MatthiasOPage/Wavemaker/Media/Manual Media/20201031_114511.jpg

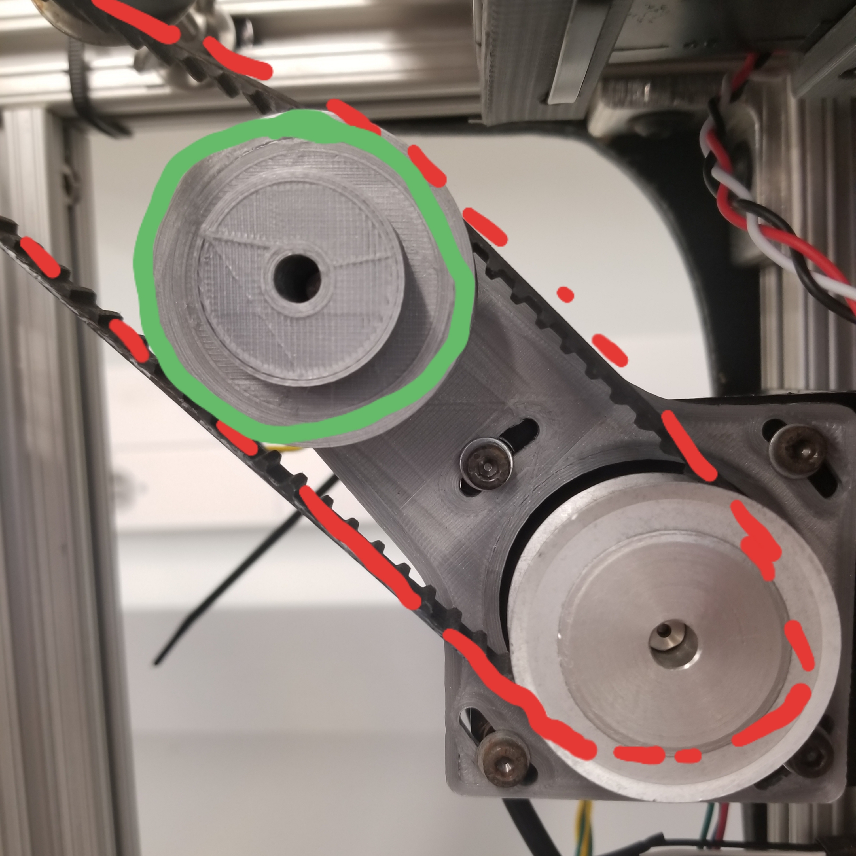
Media/Manual Media/20201031_114511.jpg
