MatthiasOPage/Wavemaker/Media/Manual Media/20201031_110601.jpg

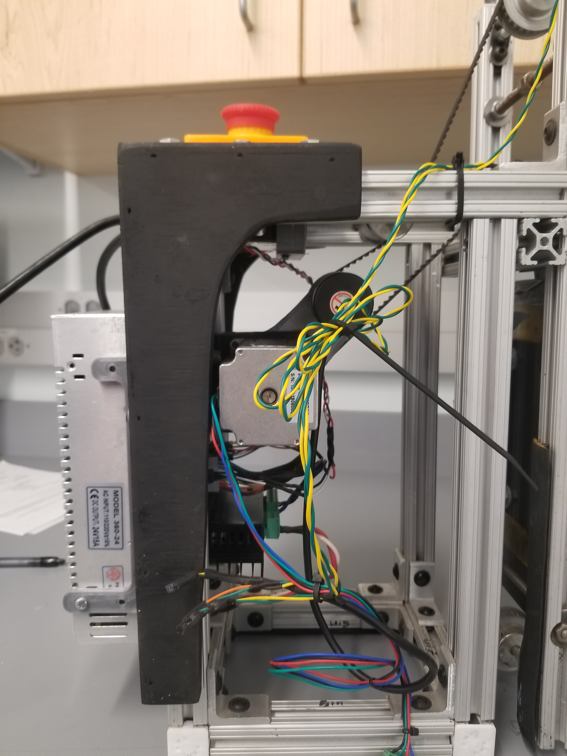
Media/Manual Media/20201031_110601.jpg
