MatthiasOPage/Wavemaker/README.txt

Folder home to all files used within the Wavemaker project.

Please direct questions and comments to: MatthiasOPage@gmail.com
