MatthiasOPage/Wavemaker/Media/Camera Gantry with Squash.png

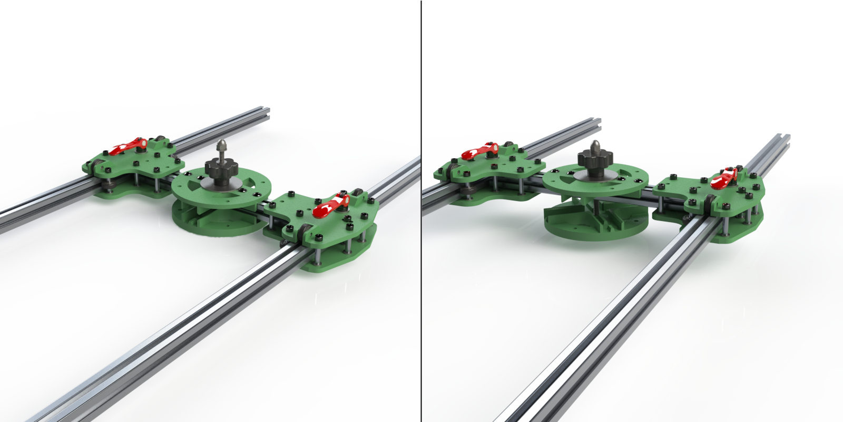
Media/Camera Gantry with Squash.png
