MatthiasOPage/Wavemaker/Media/Camera Gimbal/Camera_Gimbal_On_Frame.png

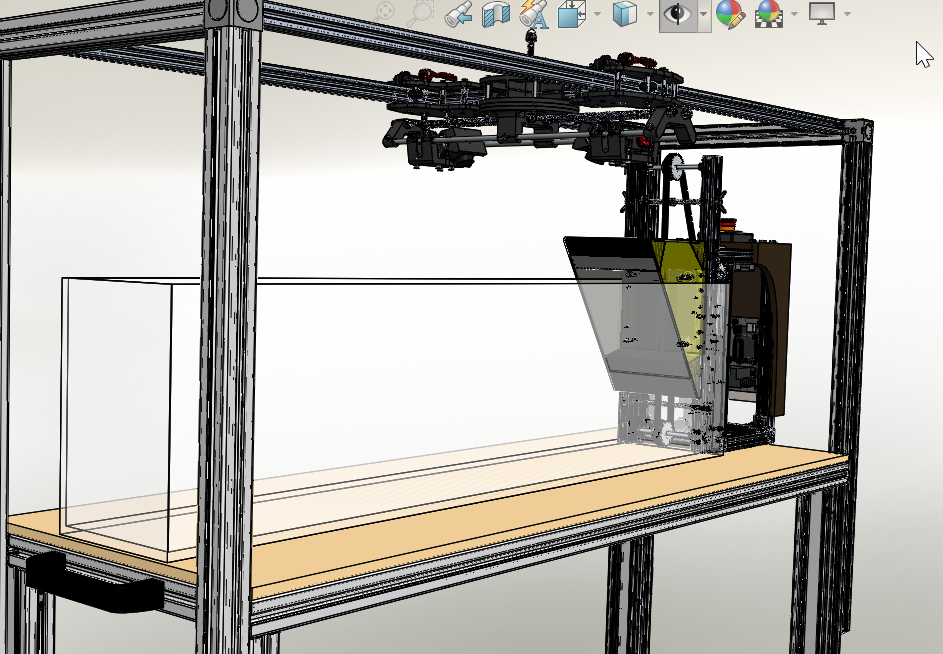
Media/Camera Gimbal/Camera_Gimbal_On_Frame.png
