MatthiasOPage/Wavemaker/Media/Camera Gimbal/Gimbal_Plain_M5.png

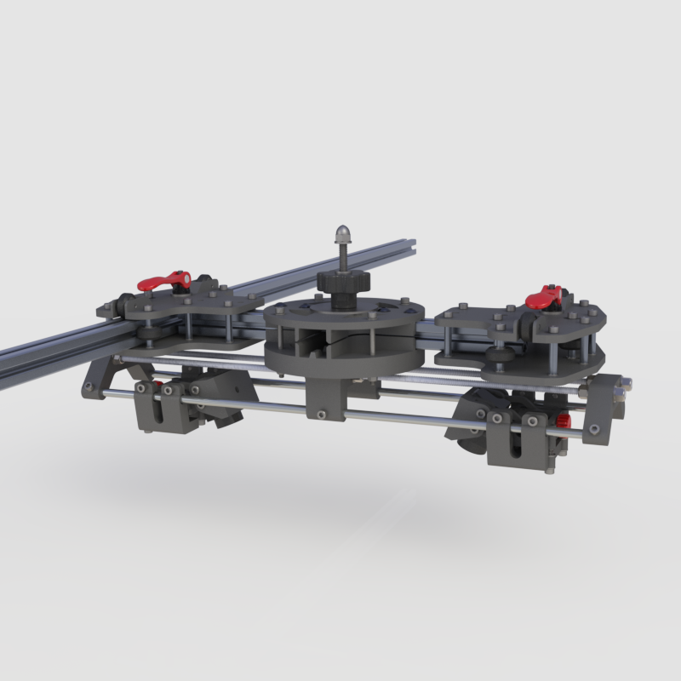
Media/Camera Gimbal/Gimbal_Plain_M5.png
