MatthiasOPage/Wavemaker/Media/Camera Gimbal/Z-Carriage_Preview1.png

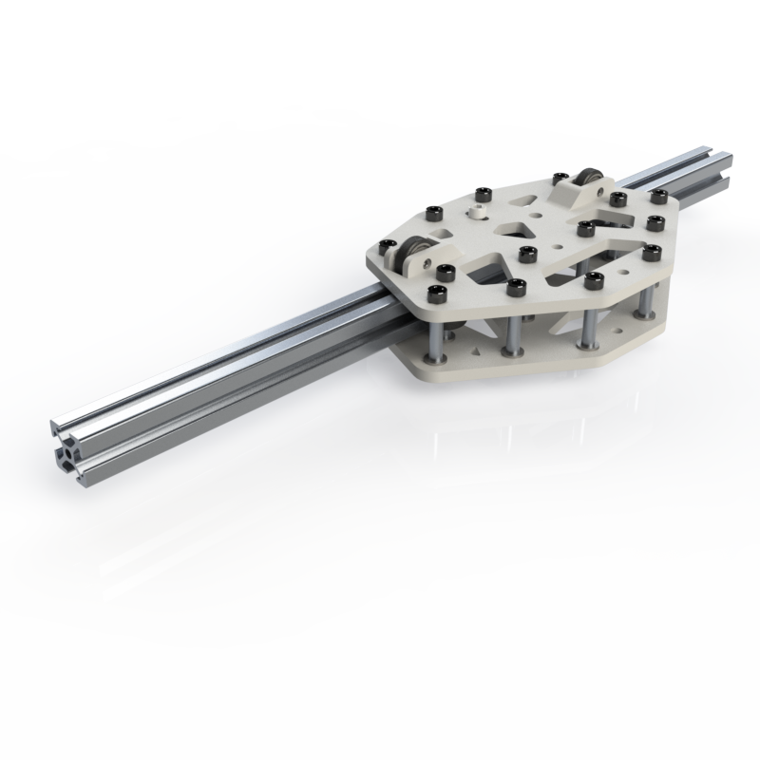
Media/Camera Gimbal/Z-Carriage_Preview1.png
