MatthiasOPage/Wavemaker/Media/Camera Gimbal/Z-Carriage_Preview3.png

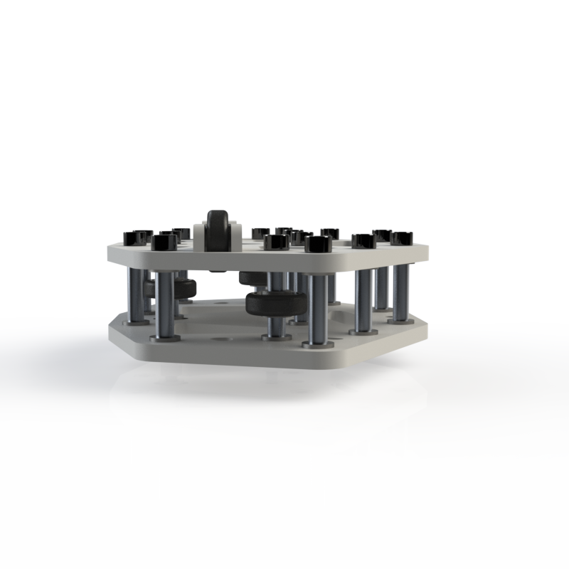
Media/Camera Gimbal/Z-Carriage_Preview3.png
