MatthiasOPage/Wavemaker/Media/Camera Gimbal/Z-Carriage_Preview4.png

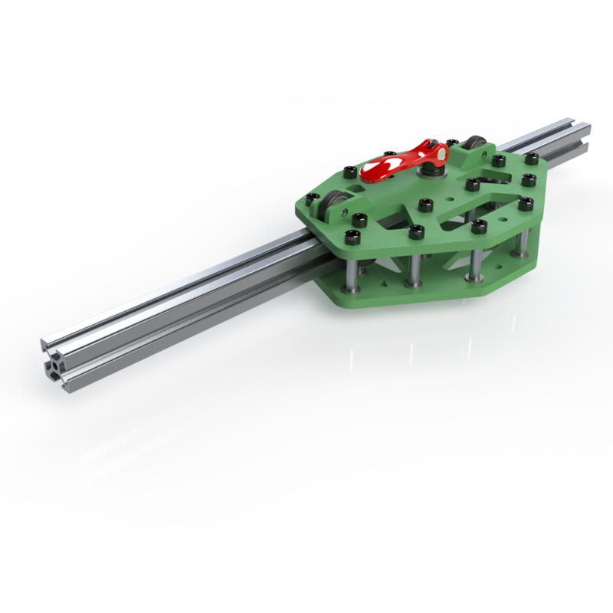
Media/Camera Gimbal/Z-Carriage_Preview4.png
