MatthiasOPage/Wavemaker/Media/Camera Gimbal/Z-Carriage_Preview5.png

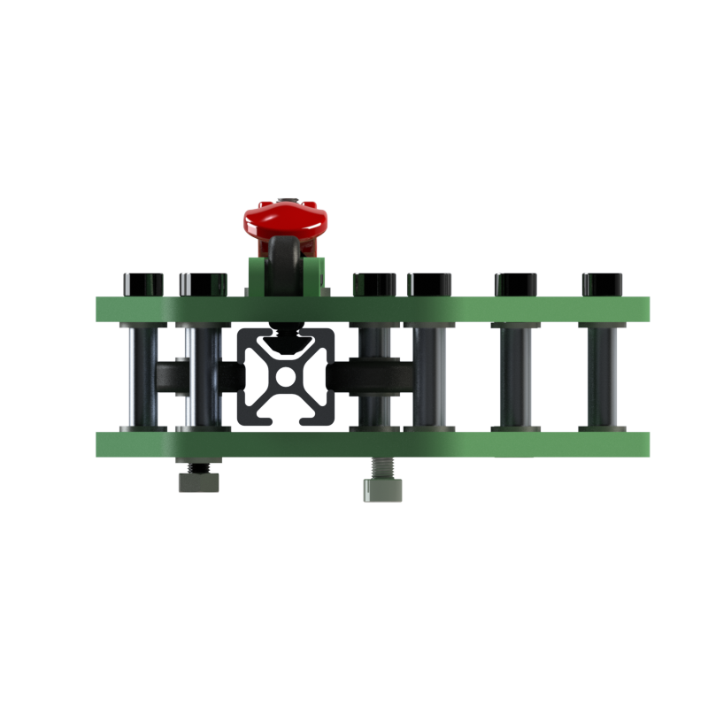
Media/Camera Gimbal/Z-Carriage_Preview5.png
