MatthiasOPage/Wavemaker/Media/Camera Gimbal/Z-Carriage_Preview6.png

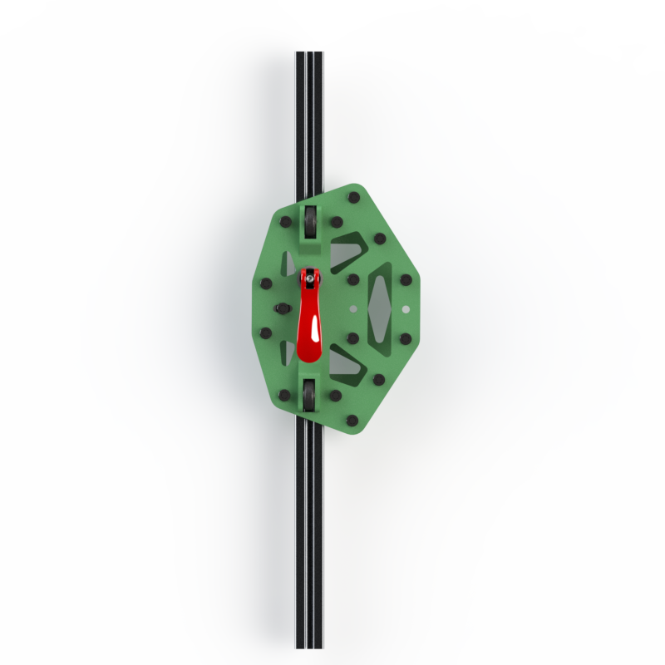
Media/Camera Gimbal/Z-Carriage_Preview6.png
