MatthiasOPage/Wavemaker/Media/Camera Gimbal/Z-Carriage_Preview7.png

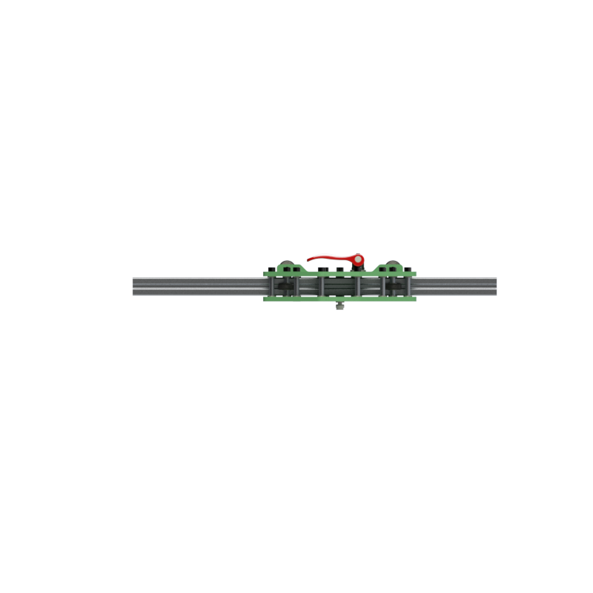
Media/Camera Gimbal/Z-Carriage_Preview7.png
