MatthiasOPage/Wavemaker/Media/Camera Gimbal/Z-Carriage_Preview_B.png

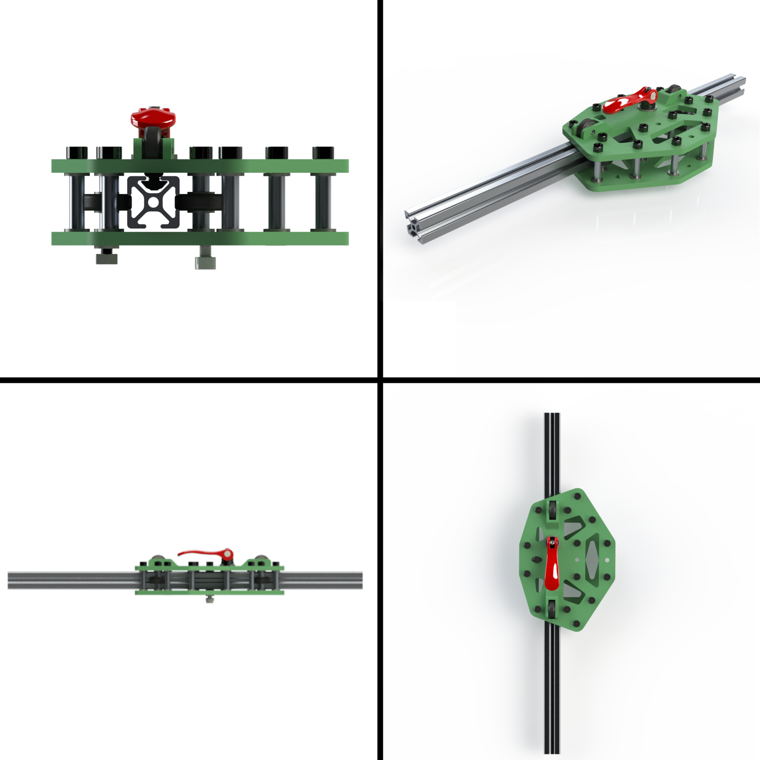
Media/Camera Gimbal/Z-Carriage_Preview_B.png
