MatthiasOPage/Wavemaker/Media/Camera Gimbal/Z-Carriage_PreviewA.png

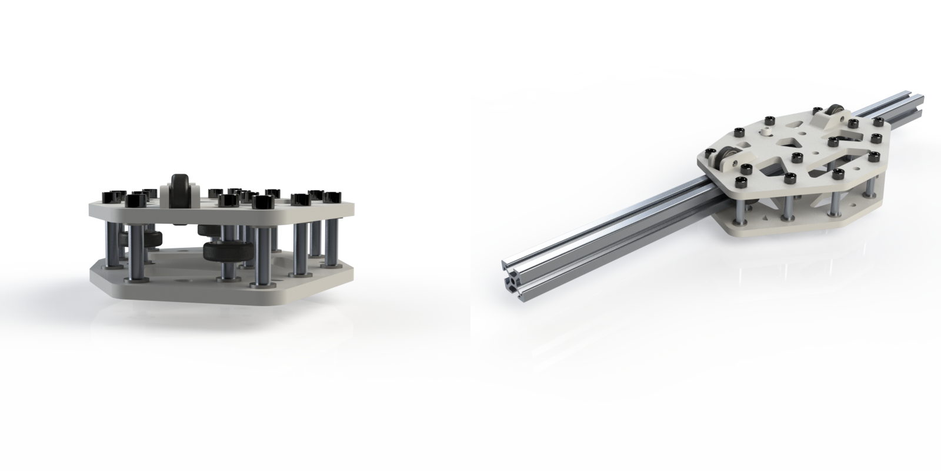
Media/Camera Gimbal/Z-Carriage_PreviewA.png
