MatthiasOPage/Wavemaker/Media/Camera_Bracket/Camera_Bracket_Back.png

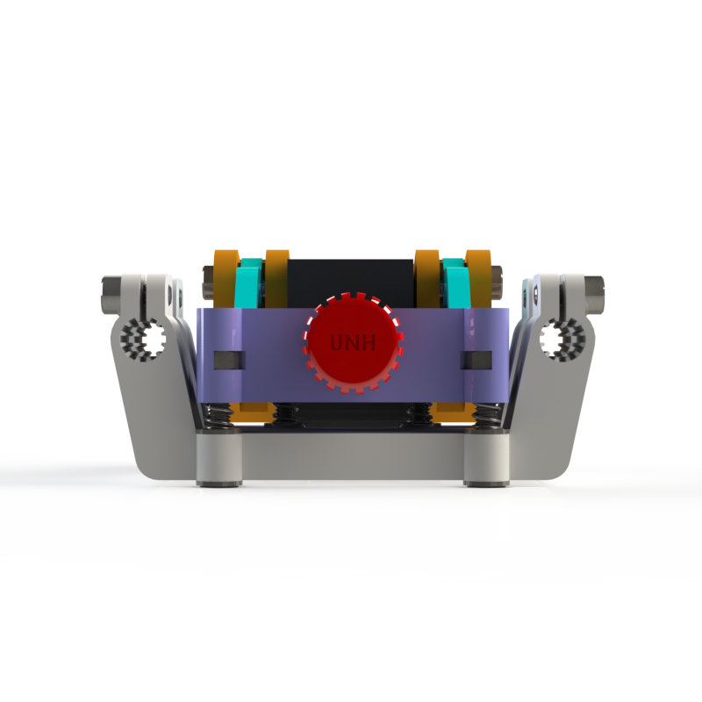
Media/Camera_Bracket/Camera_Bracket_Back.png
