MatthiasOPage/Wavemaker/Media/Camera_Bracket/Camera_Bracket_Back_Iso.png

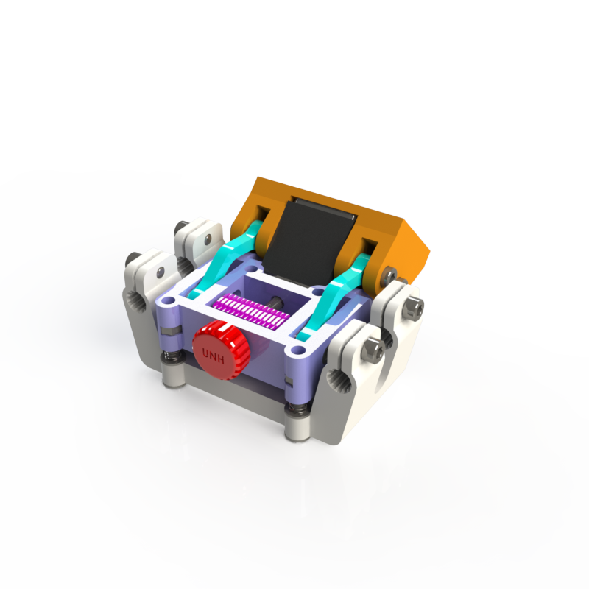
Media/Camera_Bracket/Camera_Bracket_Back_Iso.png
