MatthiasOPage/Wavemaker/Media/Camera_Bracket/Camera_Bracket_Front_Iso.png

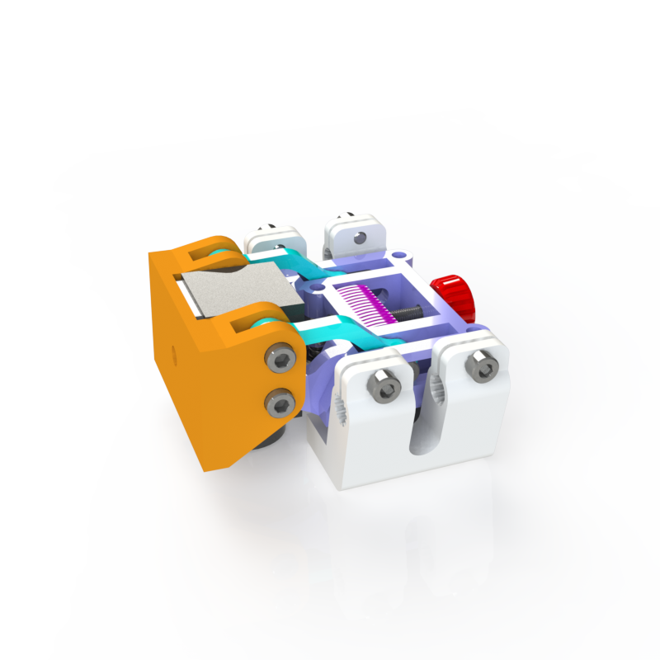
Media/Camera_Bracket/Camera_Bracket_Front_Iso.png
