MatthiasOPage/Wavemaker/Media/Camera_Bracket/Camera_Bracket_Side_A.png

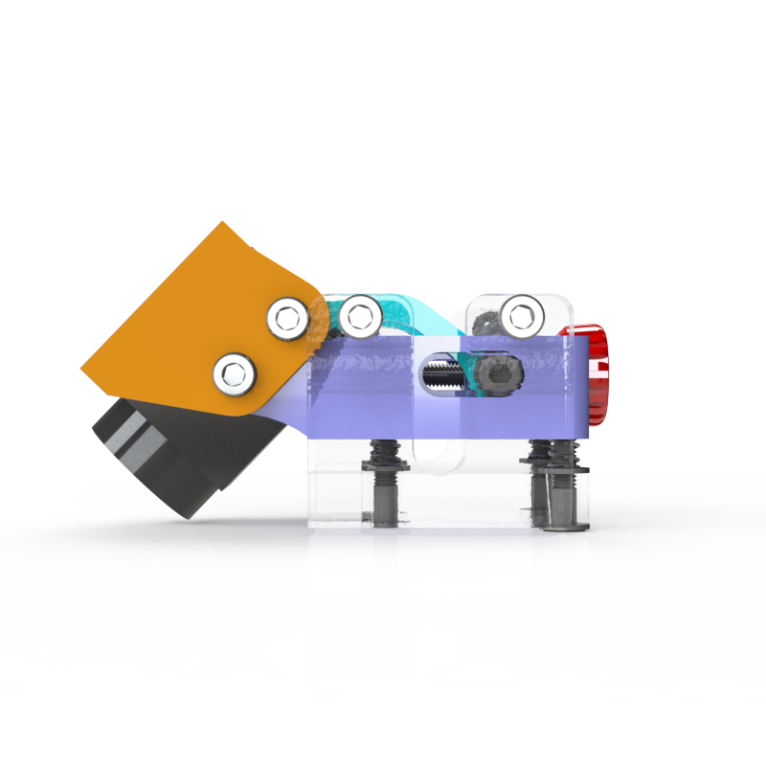
Media/Camera_Bracket/Camera_Bracket_Side_A.png
