MatthiasOPage/Wavemaker/Media/Camera_Bracket/Camera_Bracket_Side_B.png

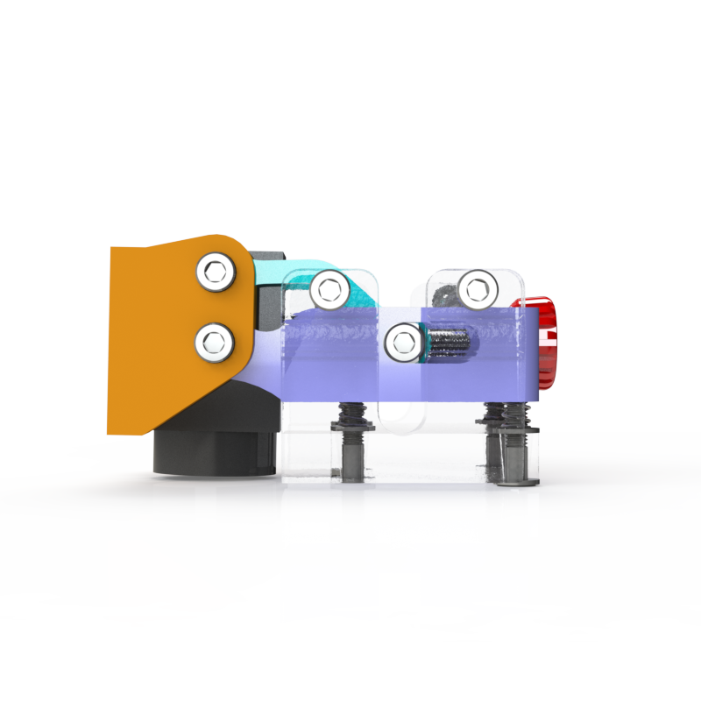
Media/Camera_Bracket/Camera_Bracket_Side_B.png
