MatthiasOPage/Wavemaker/Media/Camera_Bracket/Camera_Bracket_Top.png

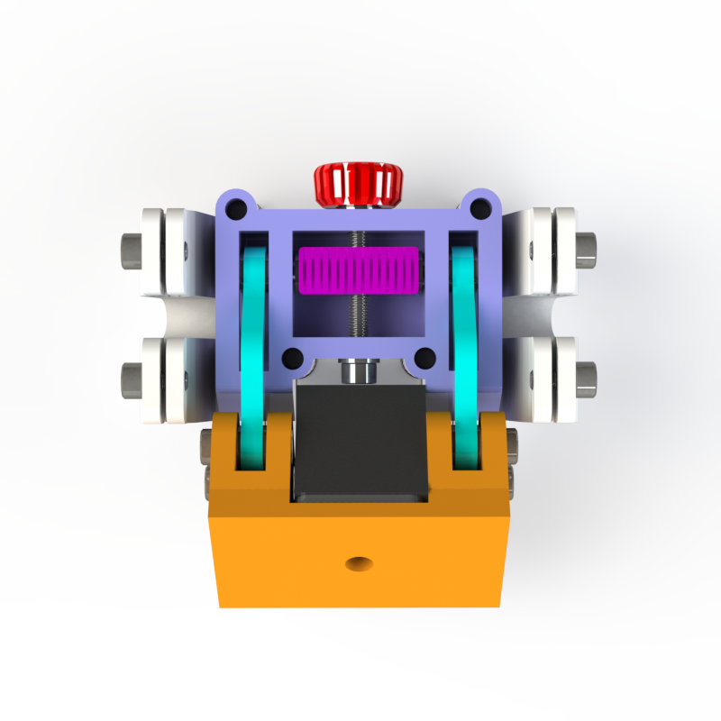
Media/Camera_Bracket/Camera_Bracket_Top.png
