MatthiasOPage/Wavemaker/Media/Development/20200703_145715.jpg

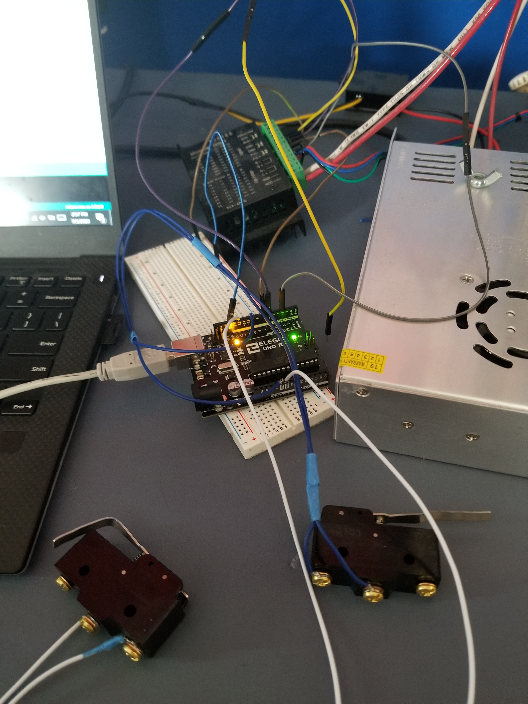
Media/Development/20200703_145715.jpg
