MatthiasOPage/Wavemaker/Media/Development/20200703_145717.jpg

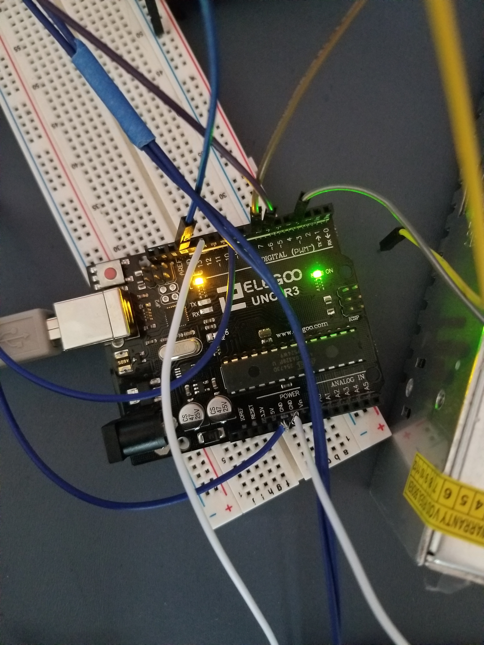
Media/Development/20200703_145717.jpg
