MatthiasOPage/Wavemaker/Media/Development/20200807_121605.jpg

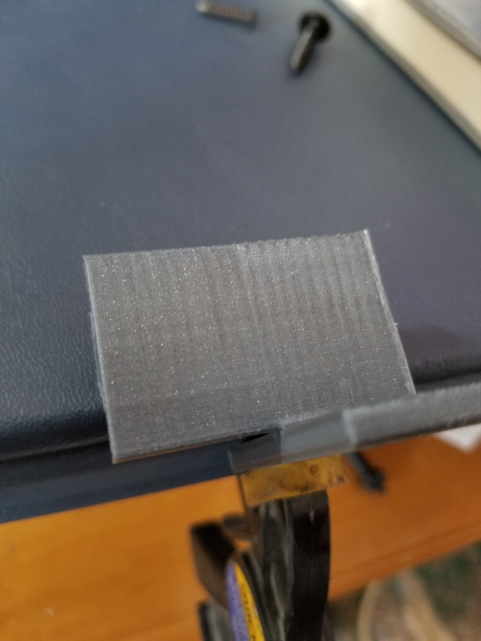
Media/Development/20200807_121605.jpg
