MatthiasOPage/Wavemaker/Media/Development/20200807_125614.jpg

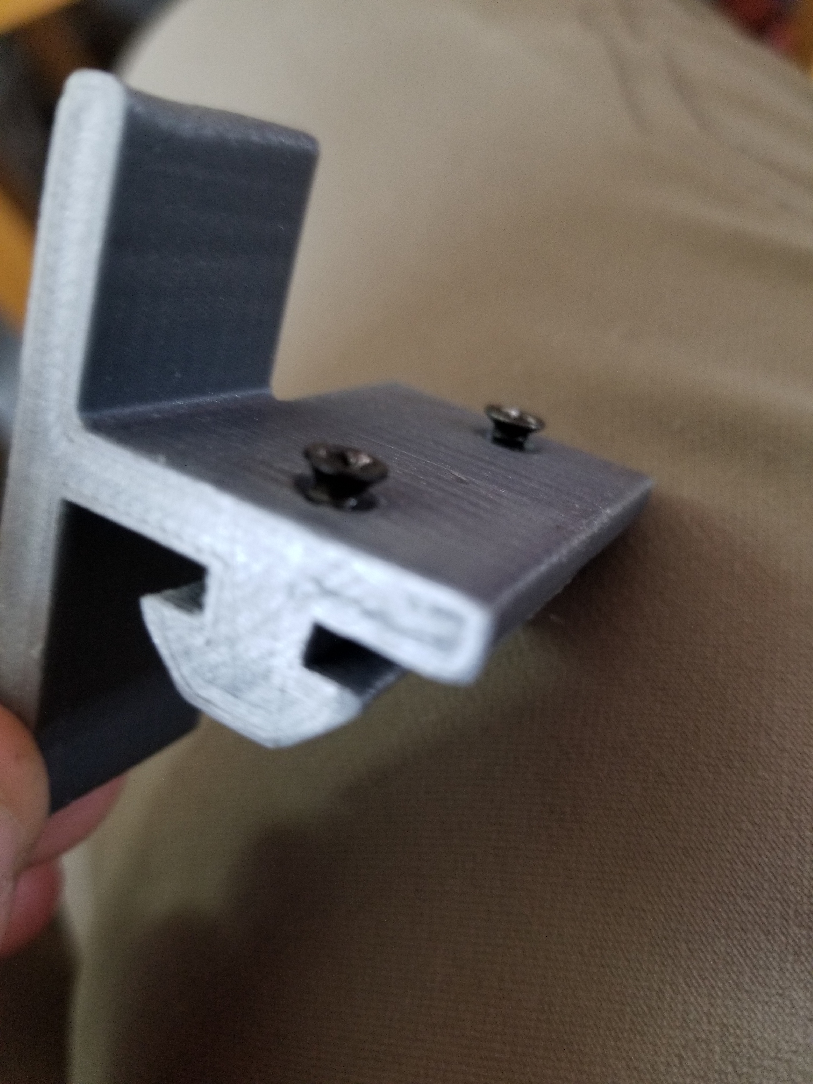
Media/Development/20200807_125614.jpg
