MatthiasOPage/Wavemaker/Media/Development/20200807_125619.jpg

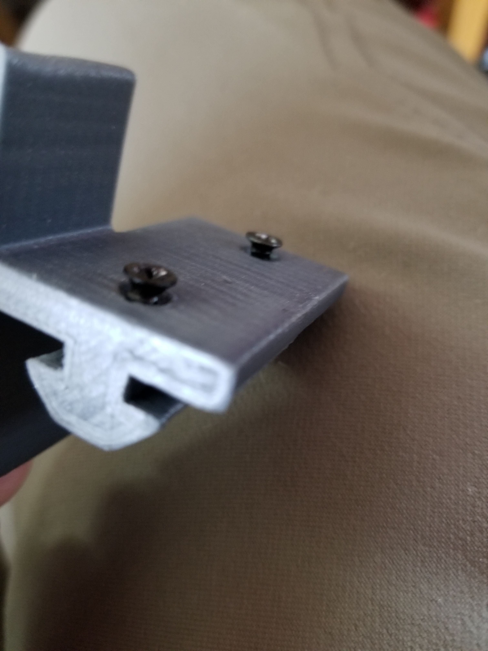
Media/Development/20200807_125619.jpg
