MatthiasOPage/Wavemaker/Media/Development/20200807_130931.jpg

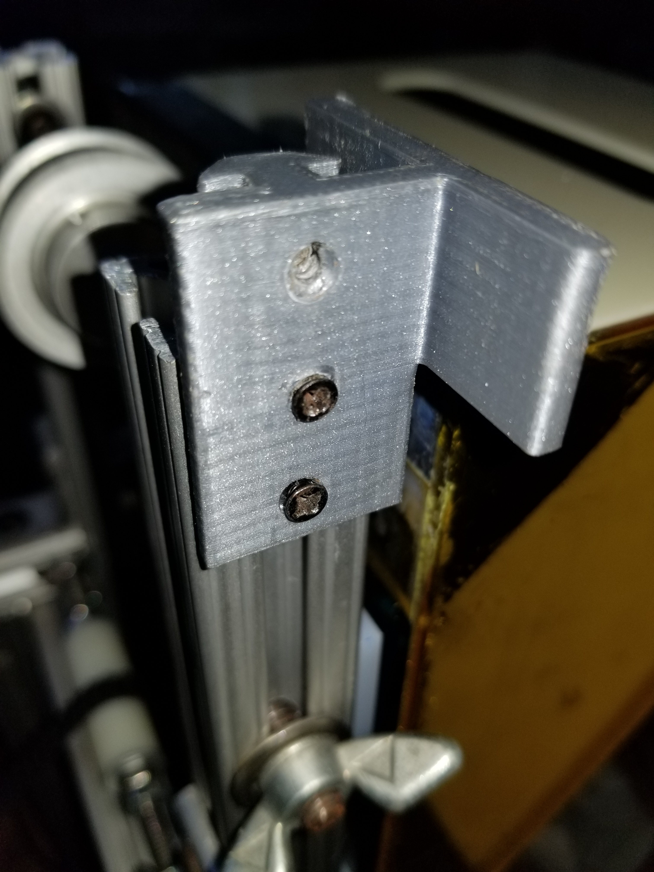
Media/Development/20200807_130931.jpg
