MatthiasOPage/Wavemaker/Media/Development/20200905_172817.jpg

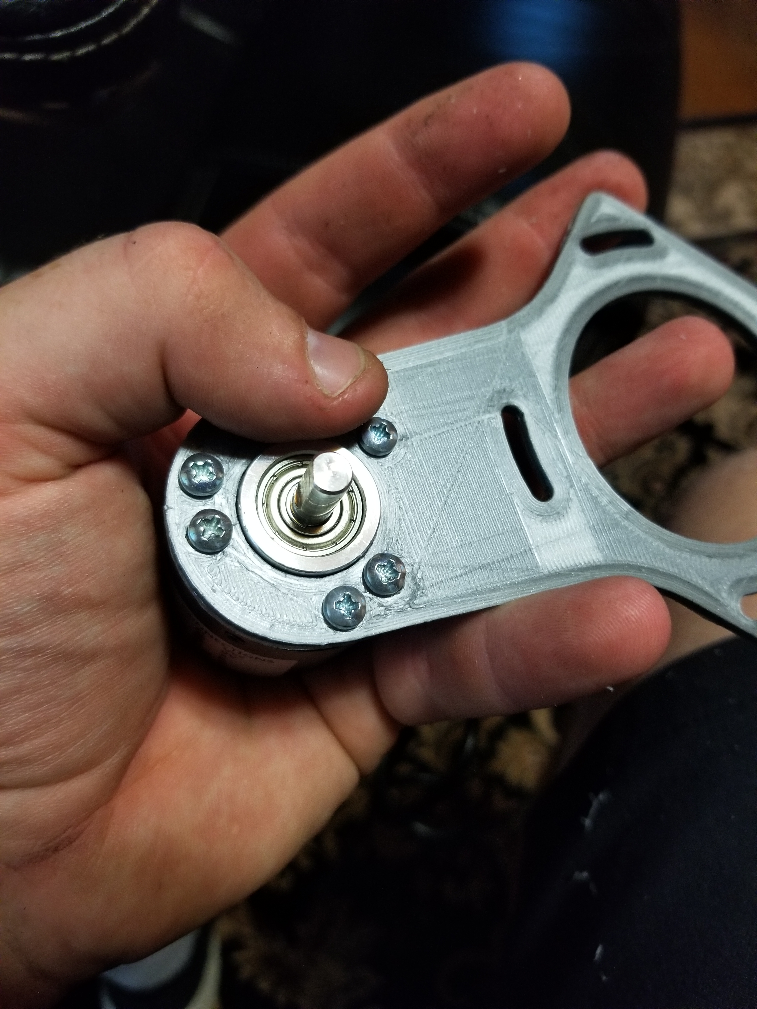
Media/Development/20200905_172817.jpg
