MatthiasOPage/Wavemaker/Media/Development/20200905_180055.jpg

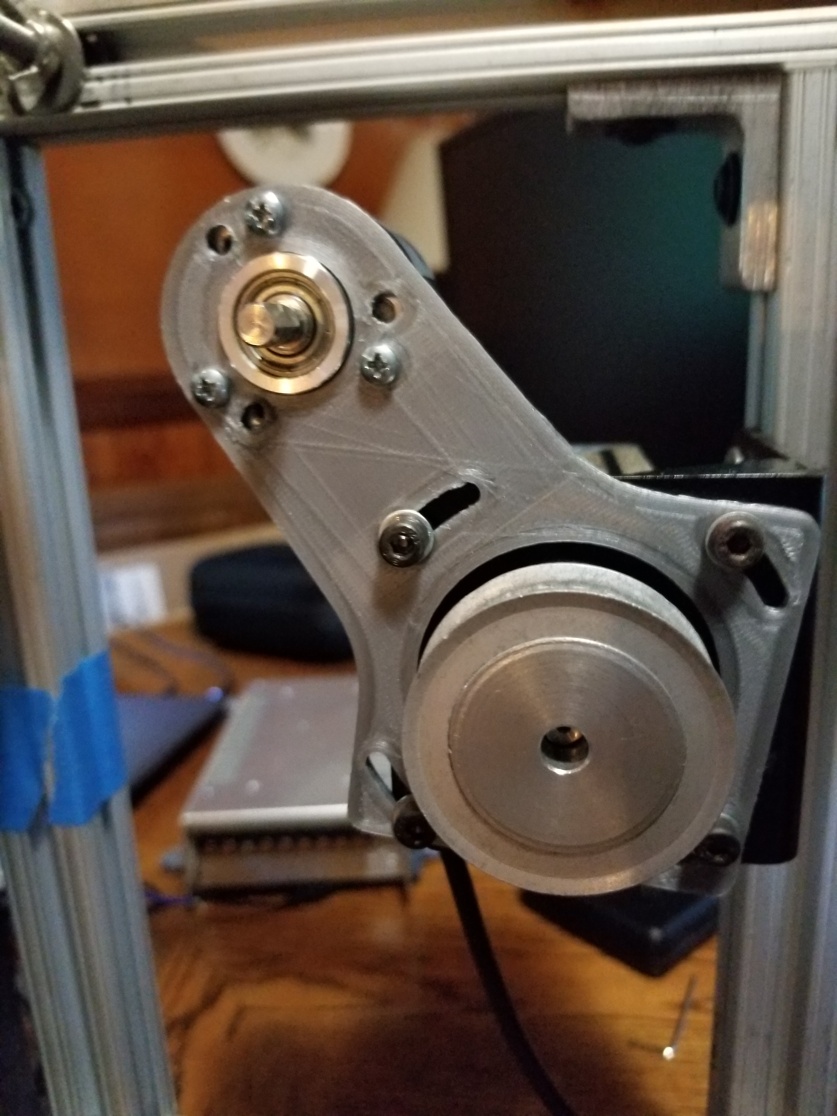
Media/Development/20200905_180055.jpg
