MatthiasOPage/Wavemaker/Media/Development/20200905_182638.jpg

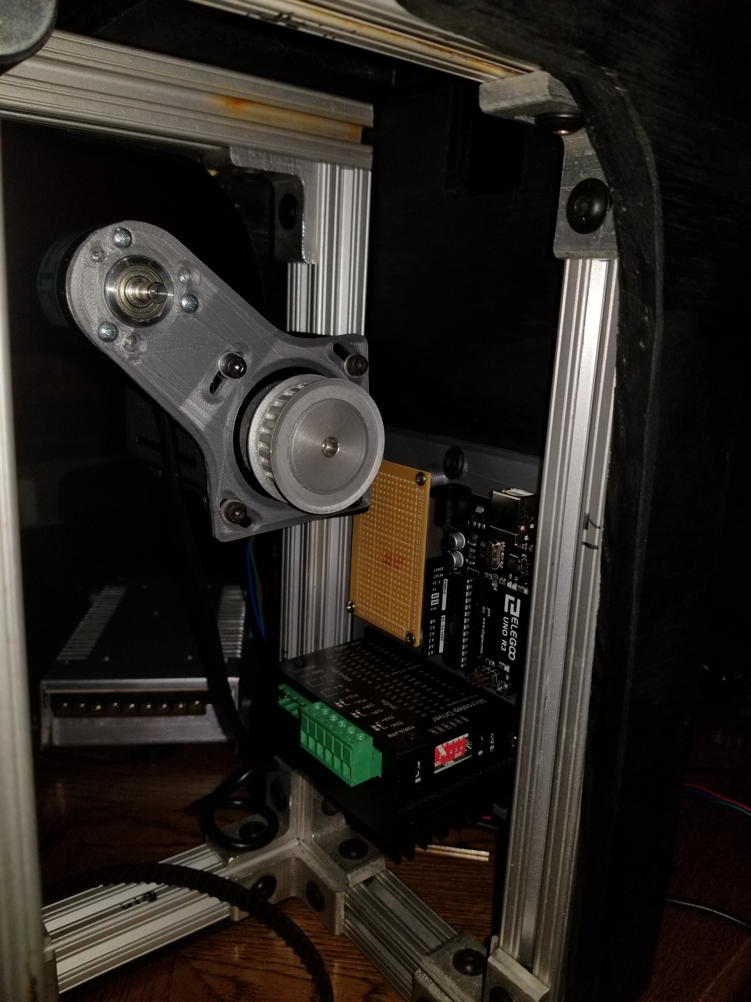
Media/Development/20200905_182638.jpg
