MatthiasOPage/Wavemaker/Media/Development/20200909_110924.jpg

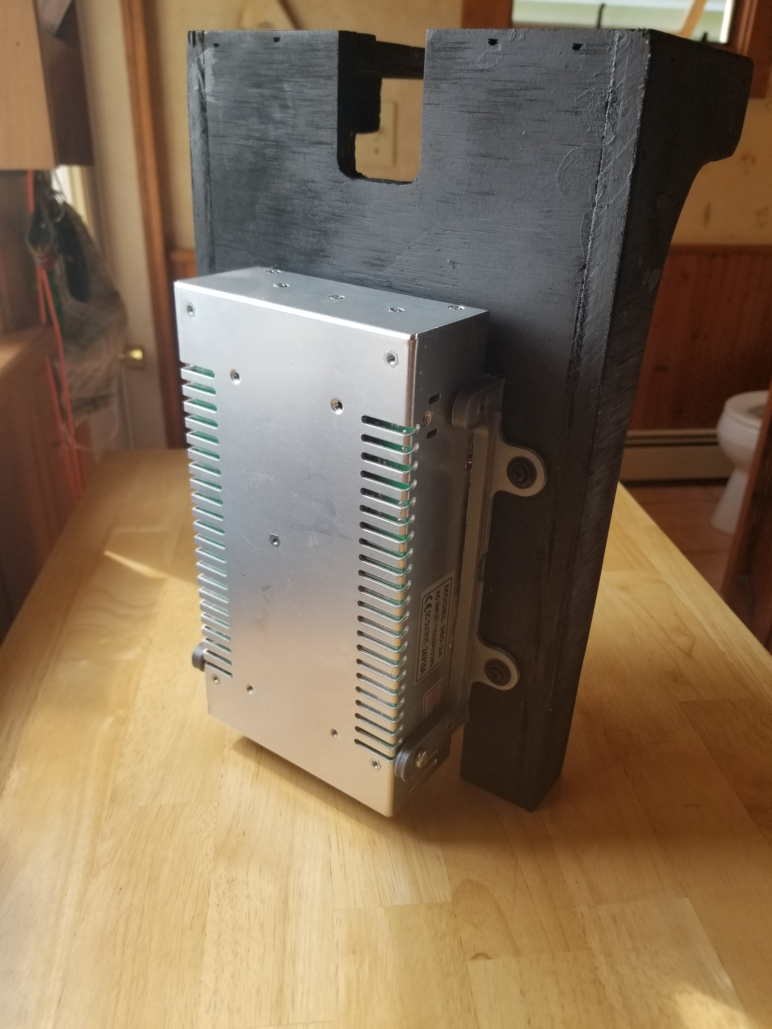
Media/Development/20200909_110924.jpg
