MatthiasOPage/Wavemaker/Media/Development/20200909_110945.jpg

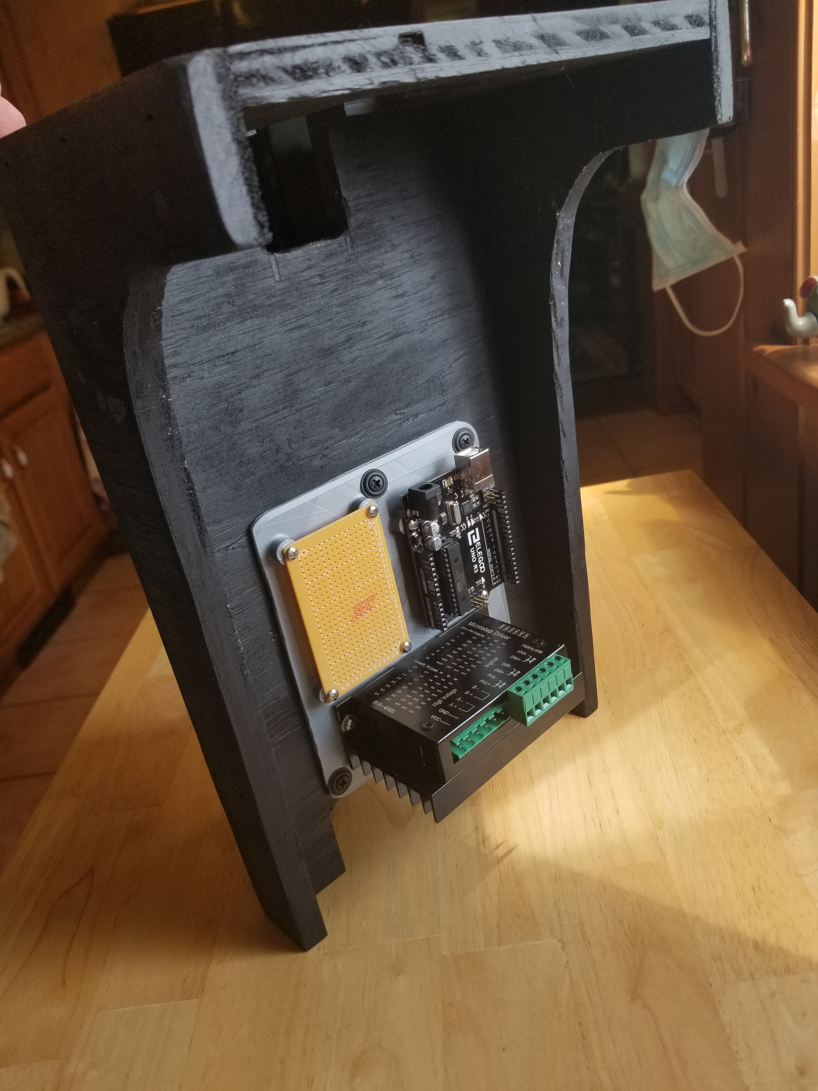
Media/Development/20200909_110945.jpg
