MatthiasOPage/Wavemaker/Media/Development/20200909_111014.jpg

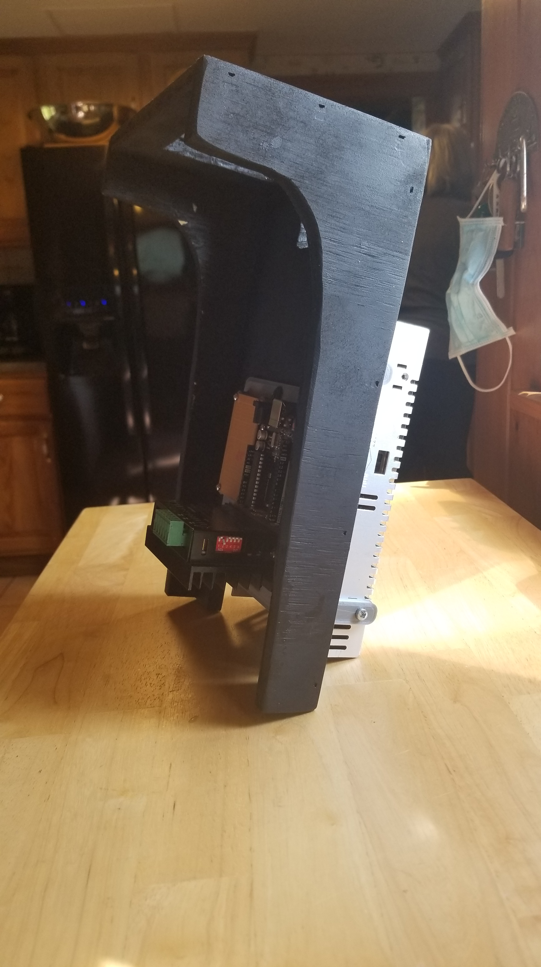
Media/Development/20200909_111014.jpg
