MatthiasOPage/Wavemaker/Media/Development/20200918_115831.jpg

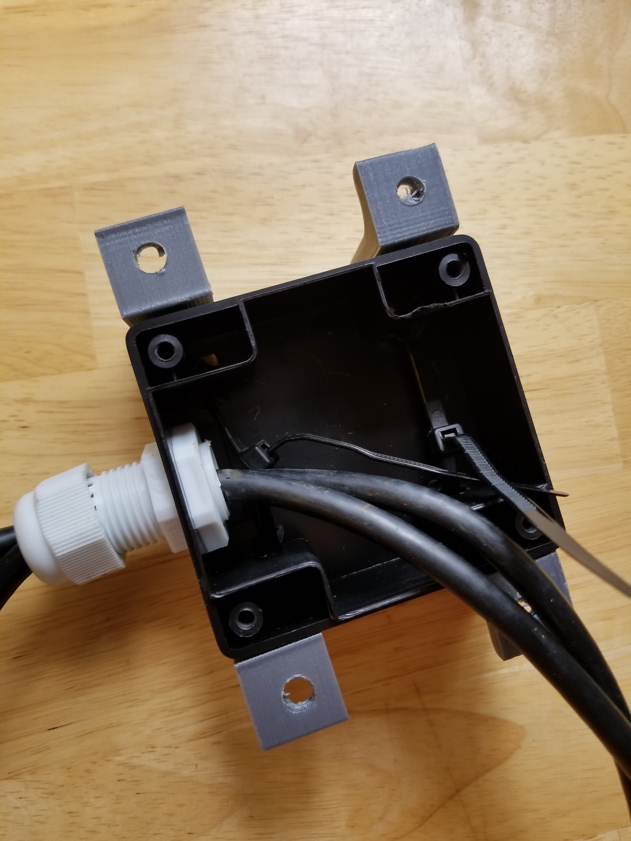
Media/Development/20200918_115831.jpg
