MatthiasOPage/Wavemaker/Media/Development/20200918_115837.jpg

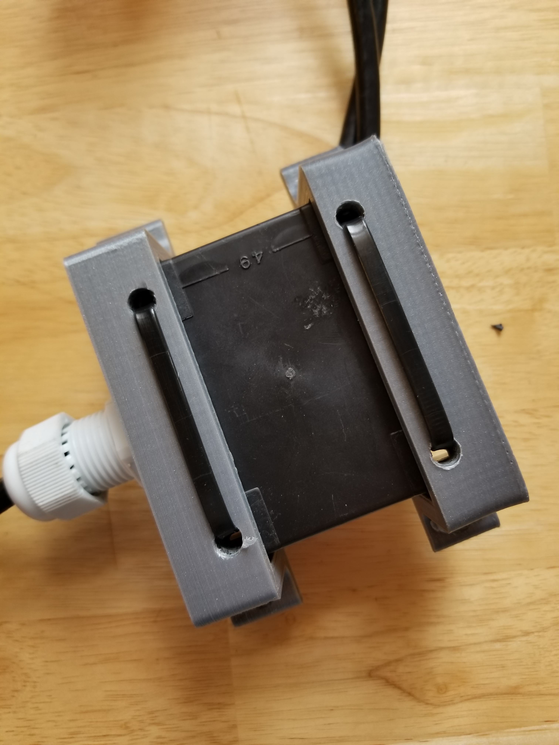
Media/Development/20200918_115837.jpg
