MatthiasOPage/Wavemaker/Media/Development/20200918_115838(0).jpg

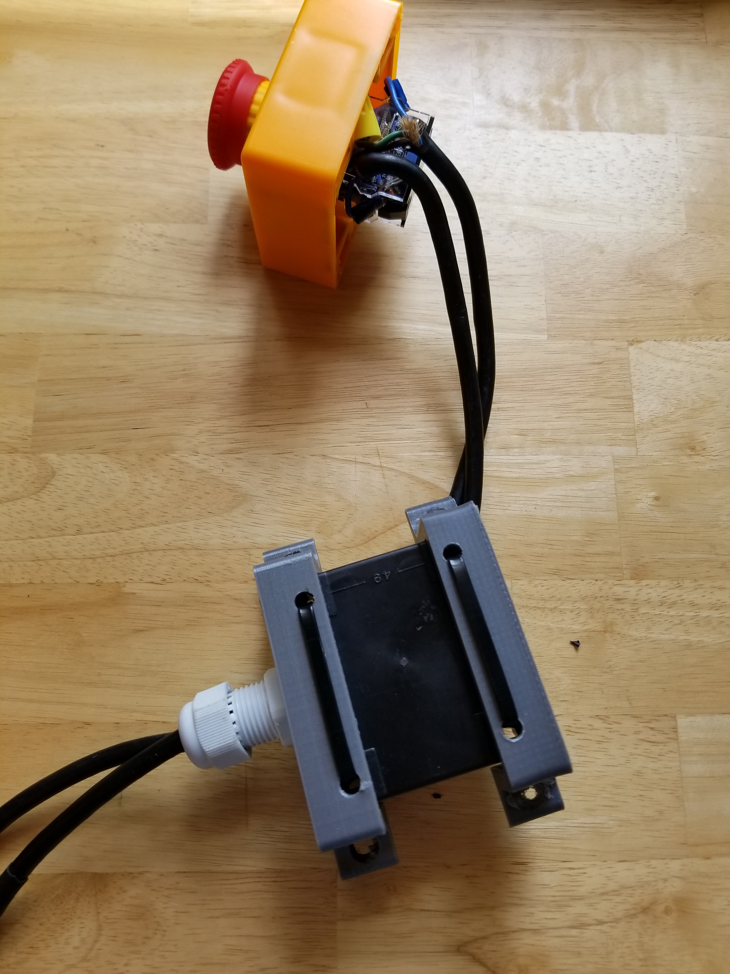
Media/Development/20200918_115838(0).jpg
