MatthiasOPage/Wavemaker/Media/Development/20200918_115840.jpg

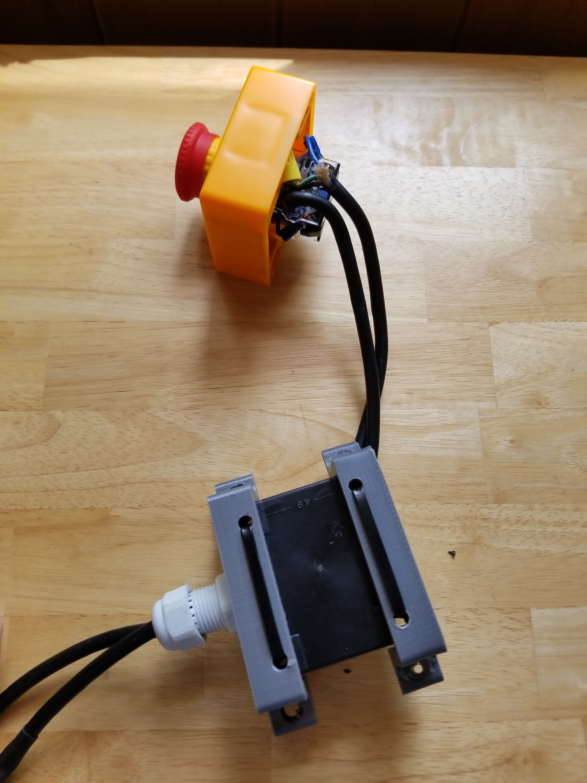
Media/Development/20200918_115840.jpg
