MatthiasOPage/Wavemaker/Media/Development/20200918_161601.jpg

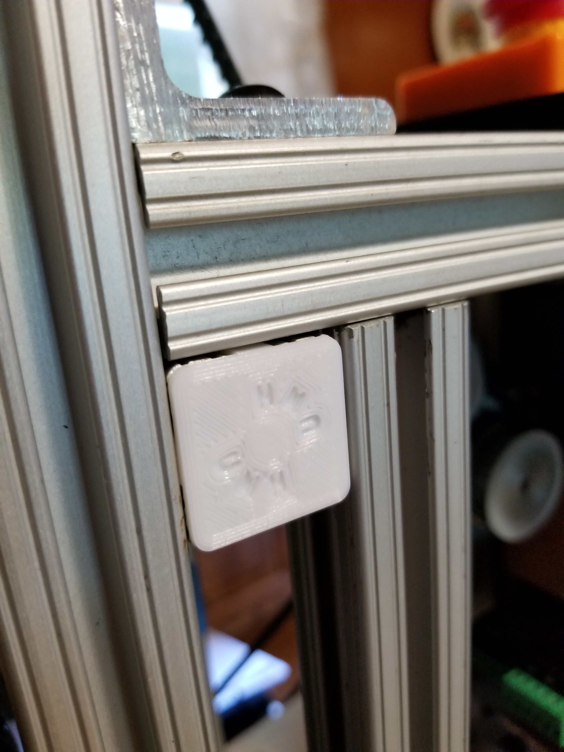
Media/Development/20200918_161601.jpg
