MatthiasOPage/Wavemaker/Media/Development/20200918_204128.jpg

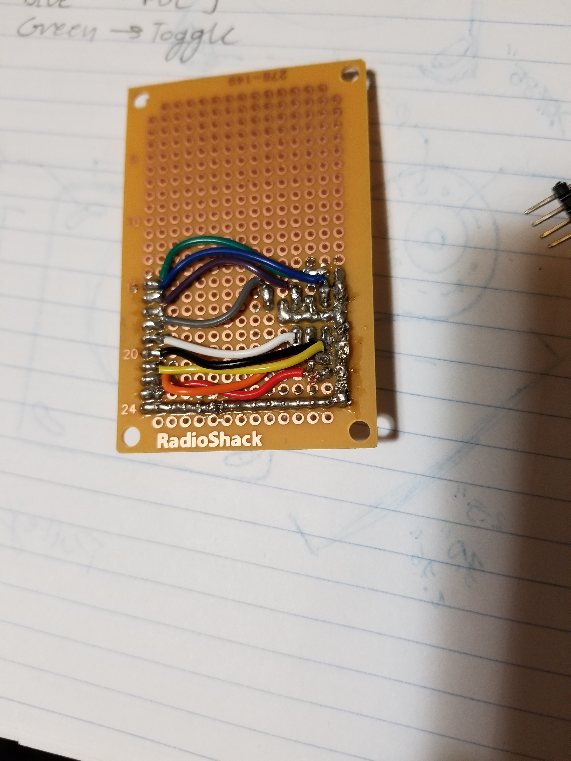
Media/Development/20200918_204128.jpg
