MatthiasOPage/Wavemaker/Media/Development/20200918_204133.jpg

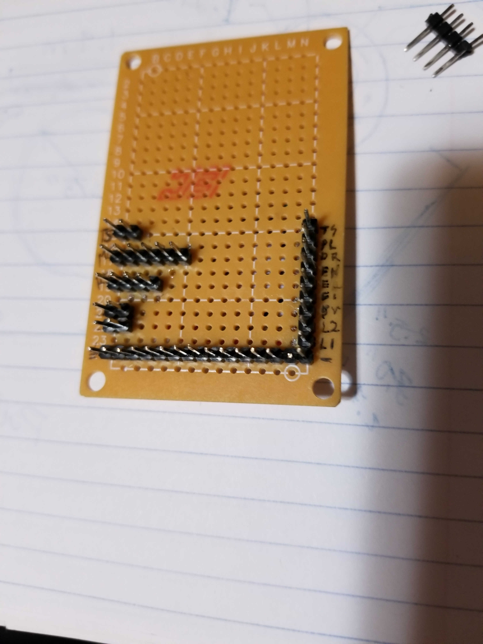
Media/Development/20200918_204133.jpg
