MatthiasOPage/Wavemaker/Media/Development/20200919_113521.jpg

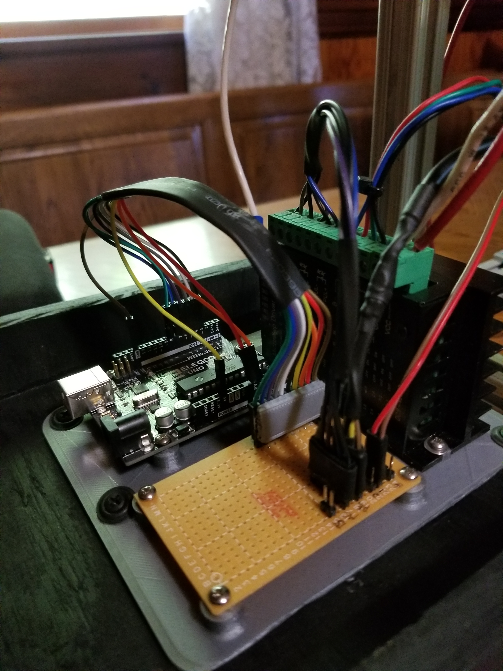
Media/Development/20200919_113521.jpg
