MatthiasOPage/Wavemaker/Media/Development/20200919_120030.jpg

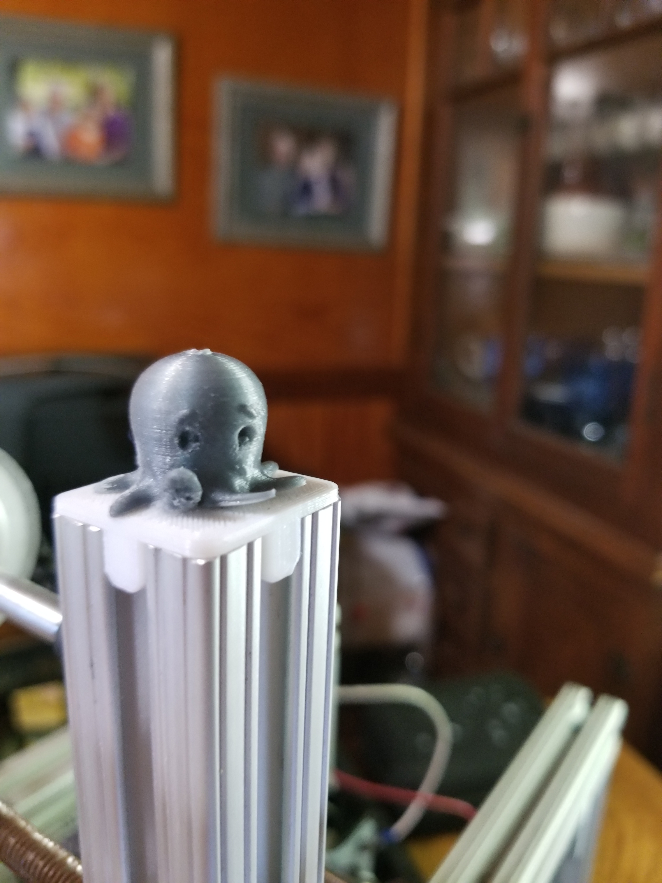
Media/Development/20200919_120030.jpg
