MatthiasOPage/Wavemaker/Media/Development/20200923_112845.jpg

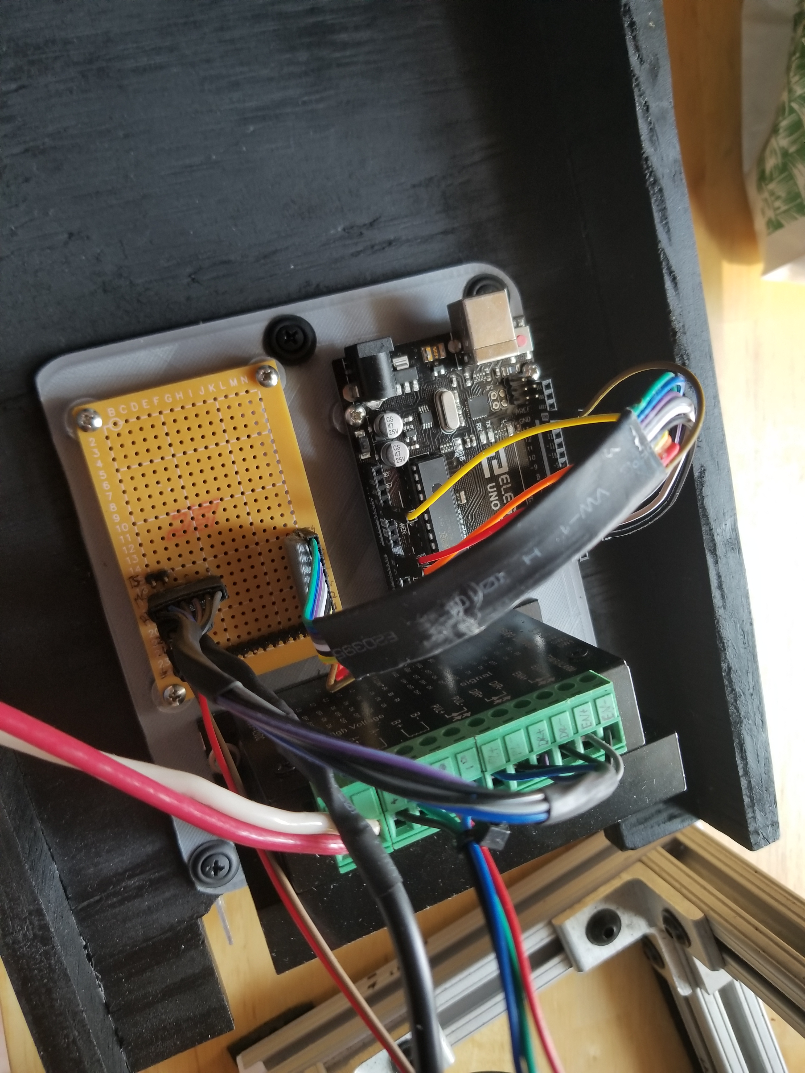
Media/Development/20200923_112845.jpg
