MatthiasOPage/Wavemaker/Media/Development/20200923_112853.jpg

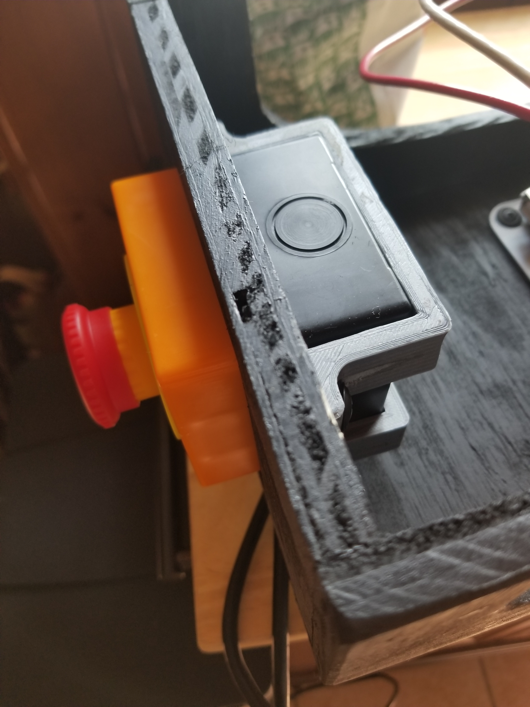
Media/Development/20200923_112853.jpg
