MatthiasOPage/Wavemaker/Media/Development/20200923_112856.jpg

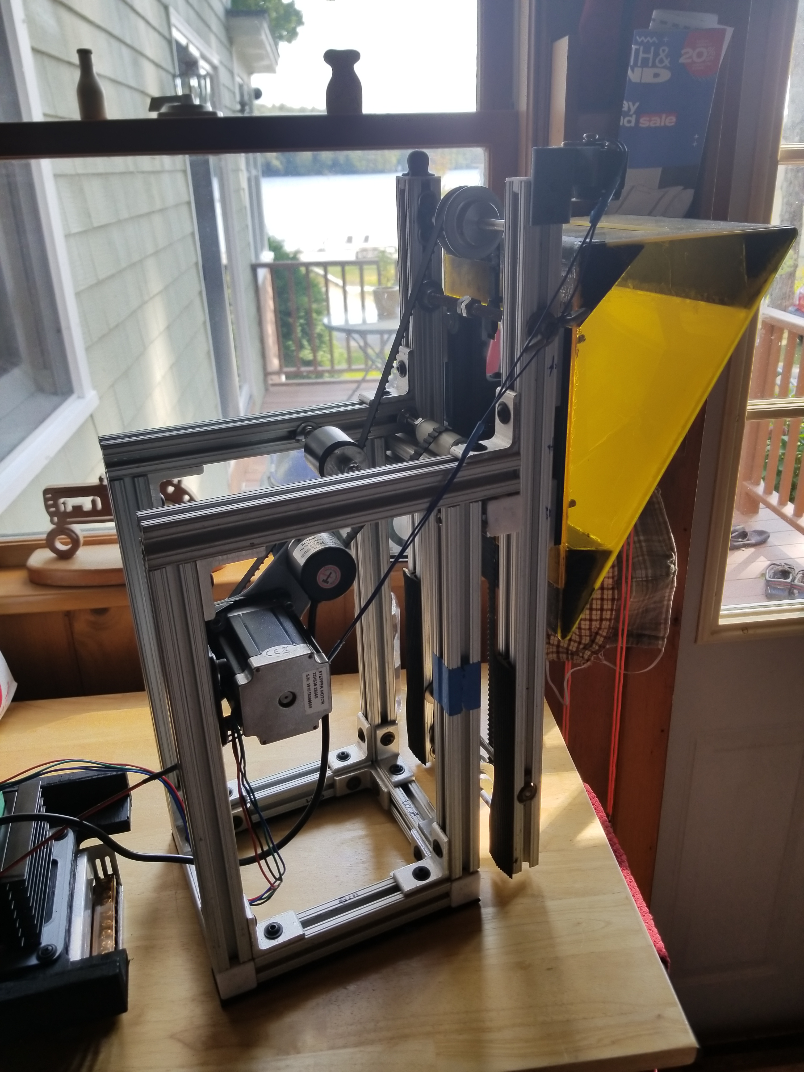
Media/Development/20200923_112856.jpg
