MatthiasOPage/Wavemaker/Media/Development/20200923_112901.jpg

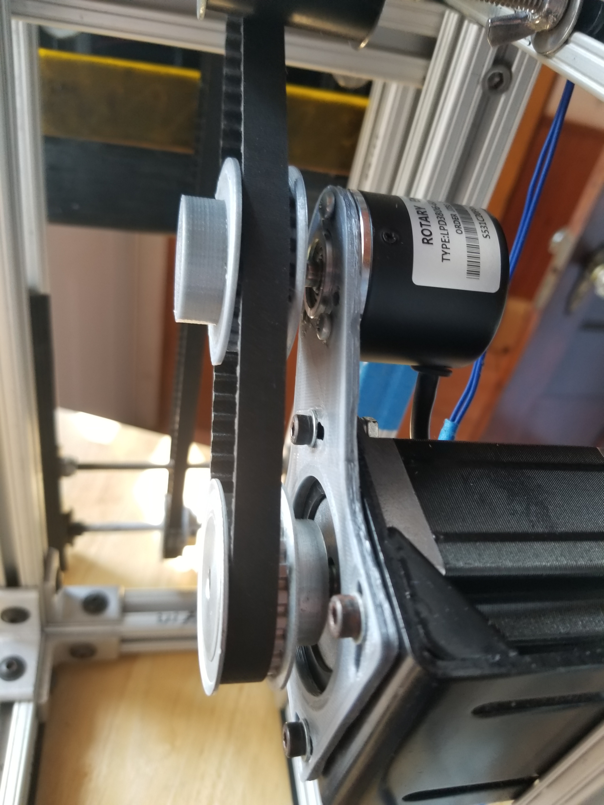
Media/Development/20200923_112901.jpg
