MatthiasOPage/Wavemaker/Media/Development/20200923_112918.jpg

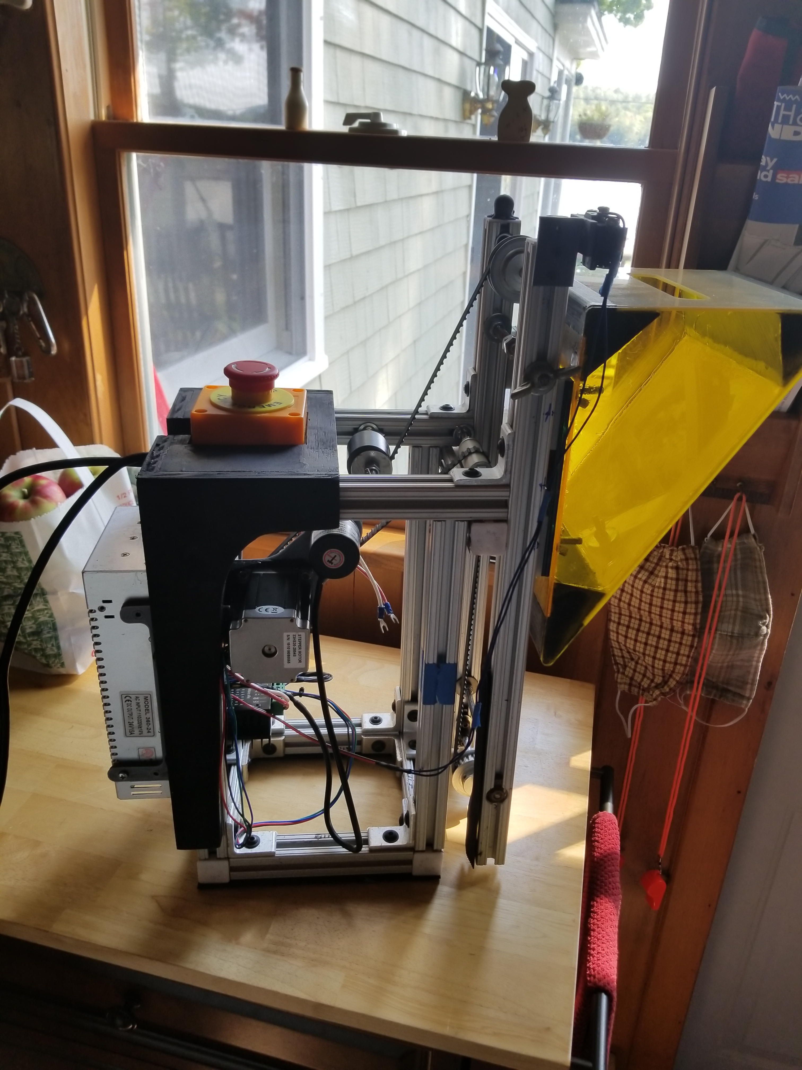
Media/Development/20200923_112918.jpg
