MatthiasOPage/Wavemaker/Media/Development/20200923_112924.jpg

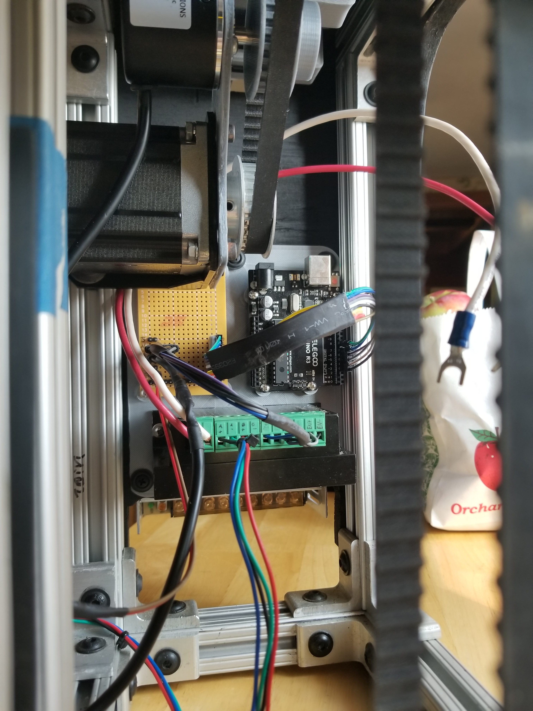
Media/Development/20200923_112924.jpg
