MatthiasOPage/Wavemaker/Media/Development/20201006_203101.jpg

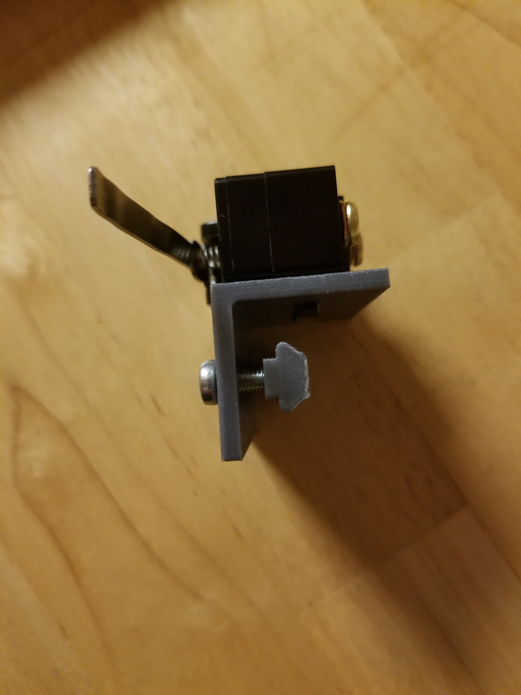
Media/Development/20201006_203101.jpg
