MatthiasOPage/Wavemaker/Media/Development/20201006_203108.jpg

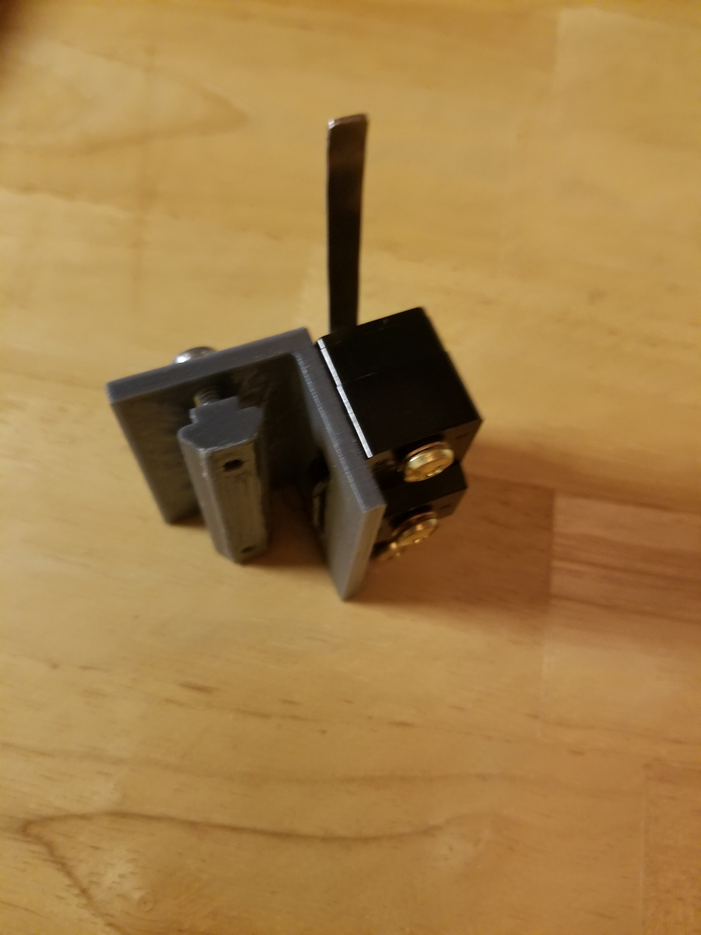
Media/Development/20201006_203108.jpg
