MatthiasOPage/Wavemaker/Media/Development/20201007_132911.jpg

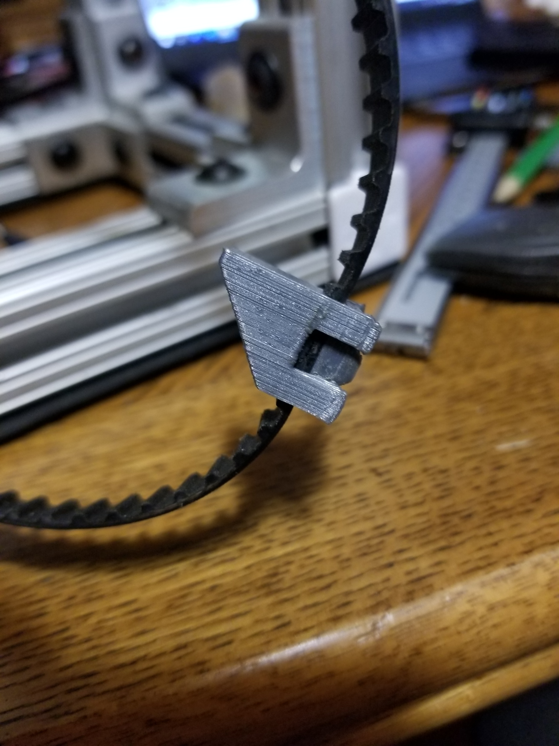
Media/Development/20201007_132911.jpg
