MatthiasOPage/Wavemaker/Media/Development/20201007_132921.jpg

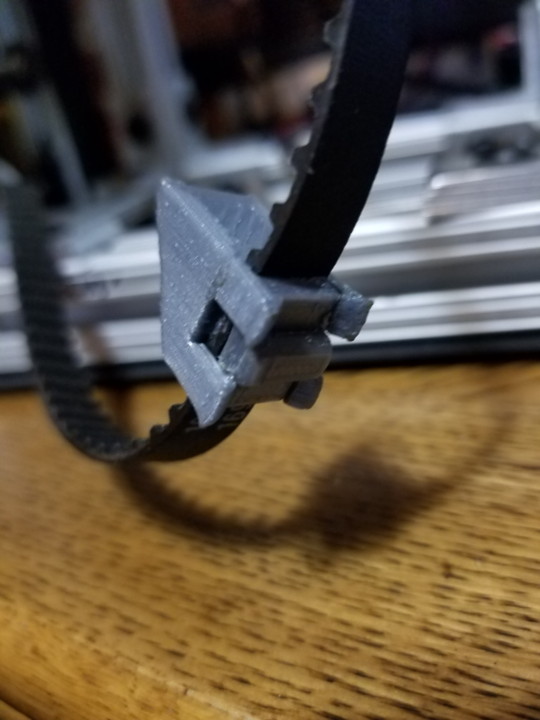
Media/Development/20201007_132921.jpg
