MatthiasOPage/Wavemaker/Media/Development/20201007_133751.jpg

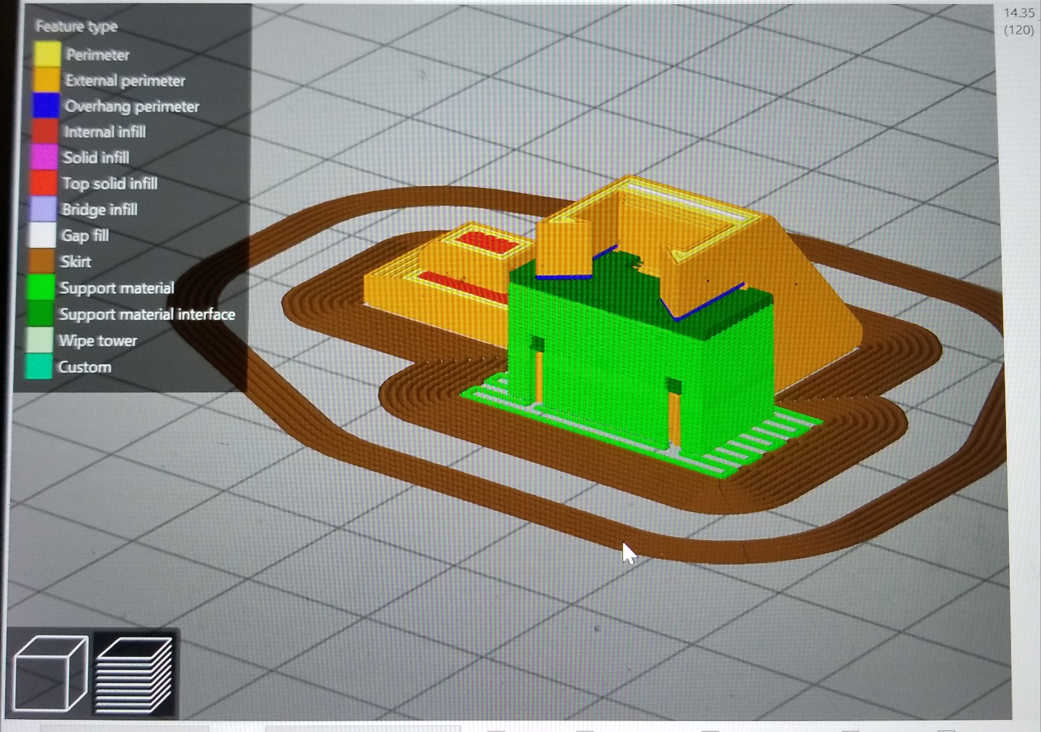
Media/Development/20201007_133751.jpg
