MatthiasOPage/Wavemaker/Media/Development/20201007_144818.jpg

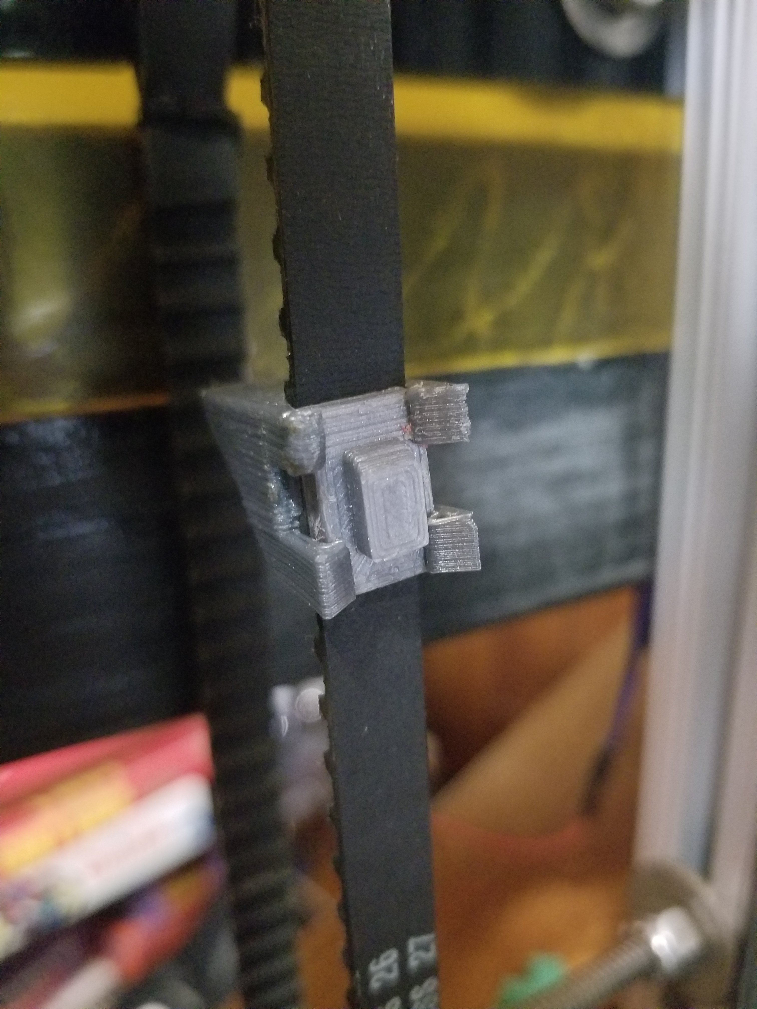
Media/Development/20201007_144818.jpg
