MatthiasOPage/Wavemaker/Media/Development/20201007_144825.jpg

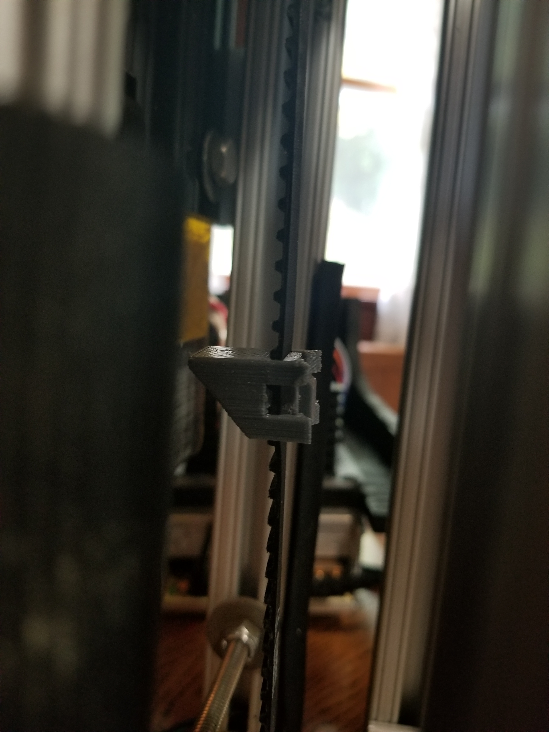
Media/Development/20201007_144825.jpg
