MatthiasOPage/Wavemaker/Media/Development/20201007_144840.jpg

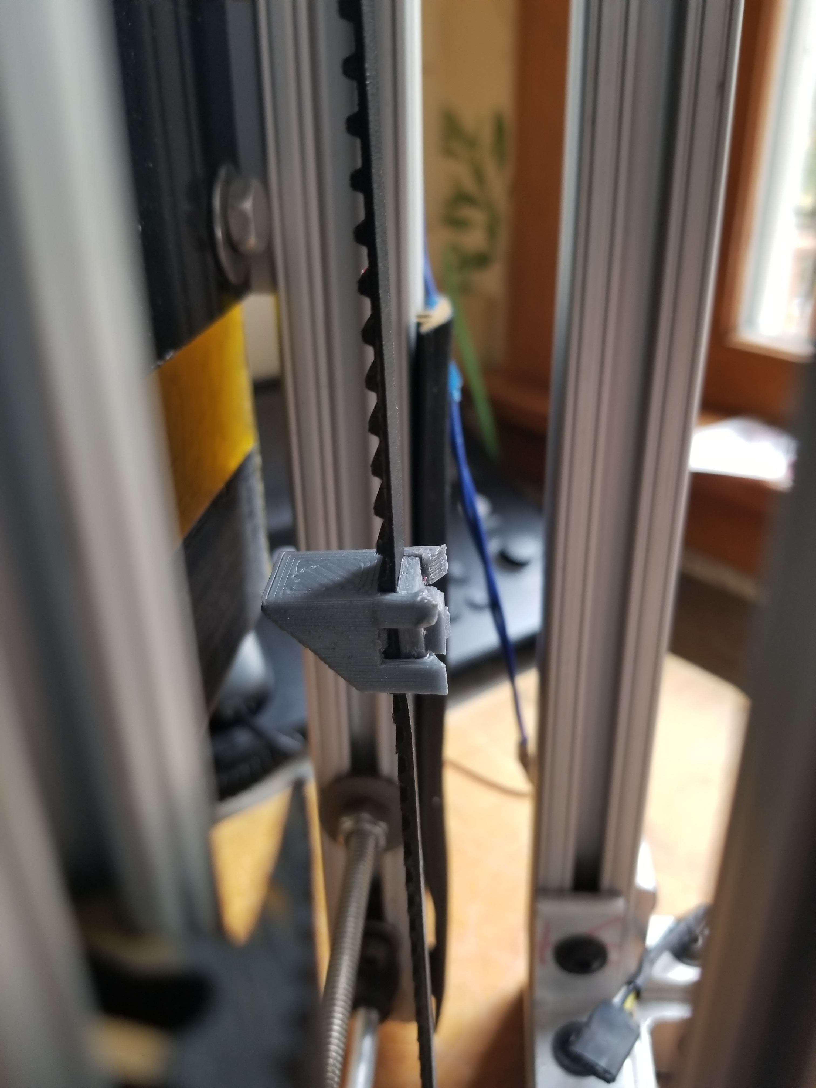
Media/Development/20201007_144840.jpg
