MatthiasOPage/Wavemaker/Media/Development/20201007_144859.jpg

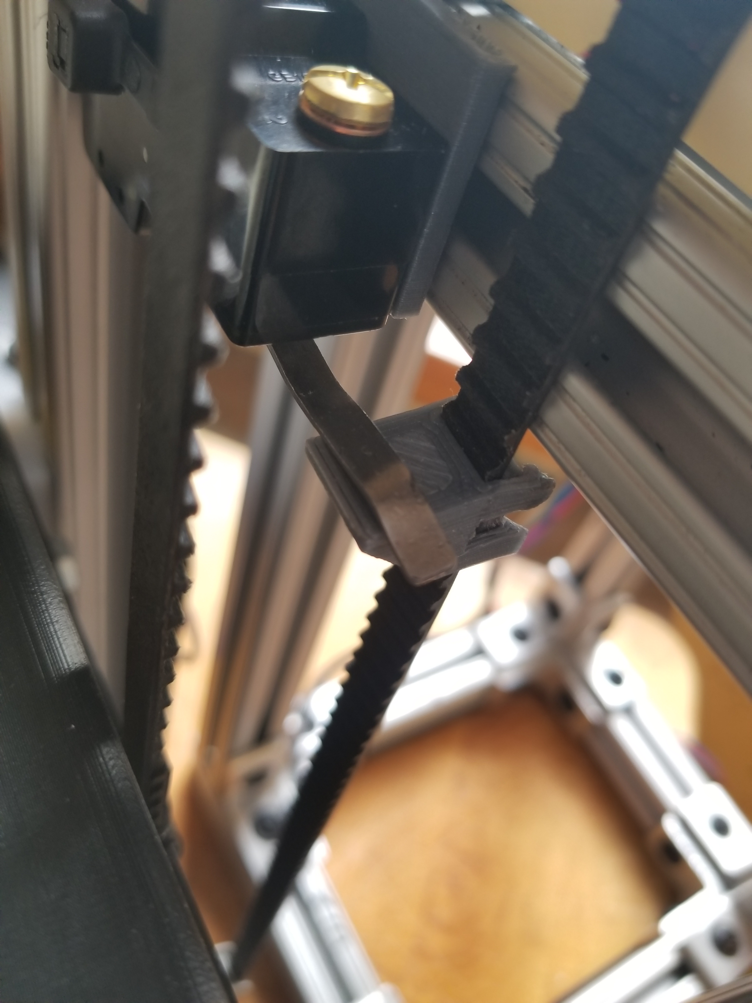
Media/Development/20201007_144859.jpg
