MatthiasOPage/Wavemaker/Media/Development/20201016_115341.jpg

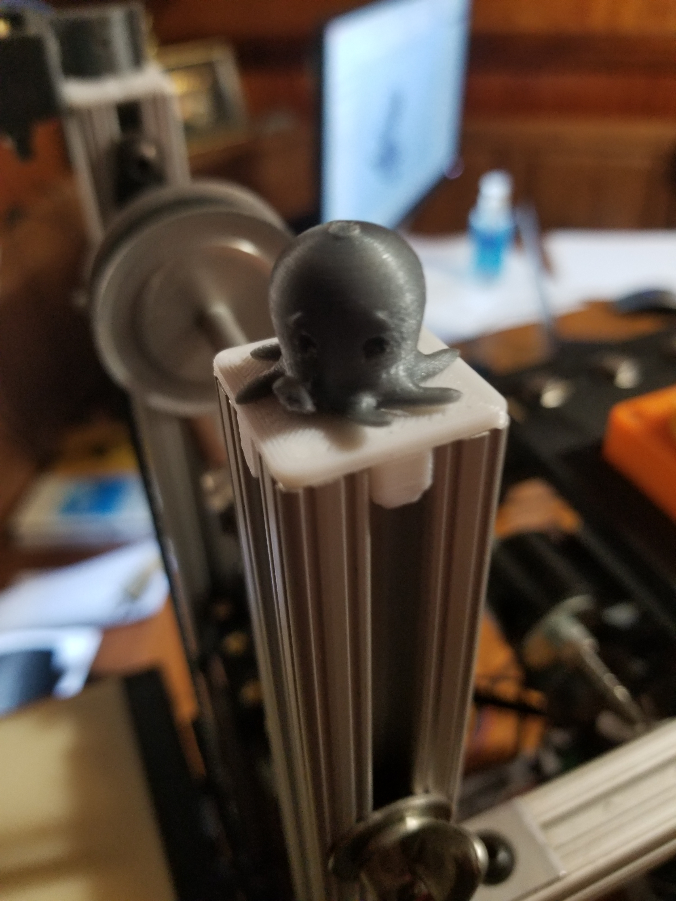
Media/Development/20201016_115341.jpg
