MatthiasOPage/Wavemaker/Media/Development/20201017_135746.jpg

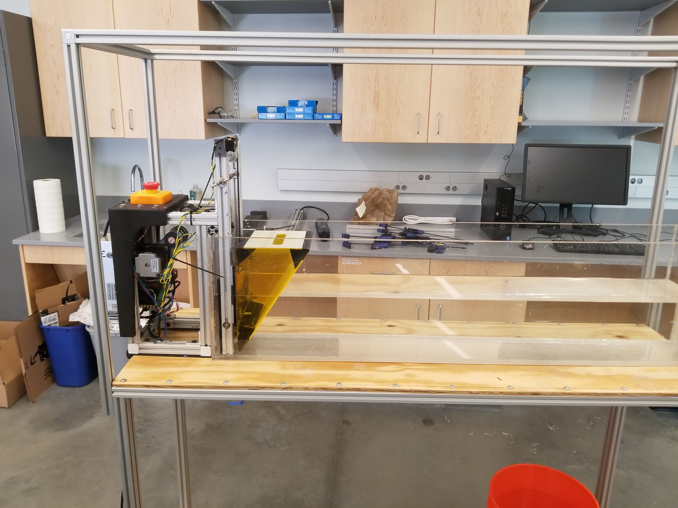
Media/Development/20201017_135746.jpg
