MatthiasOPage/Wavemaker/Media/Development/20201017_135751.jpg

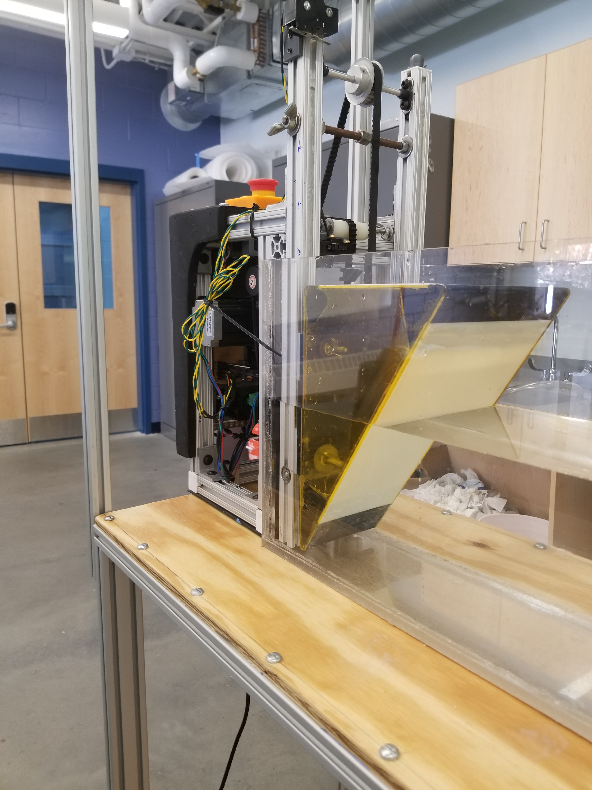
Media/Development/20201017_135751.jpg
