MatthiasOPage/Wavemaker/Media/Development/20201017_135754.jpg

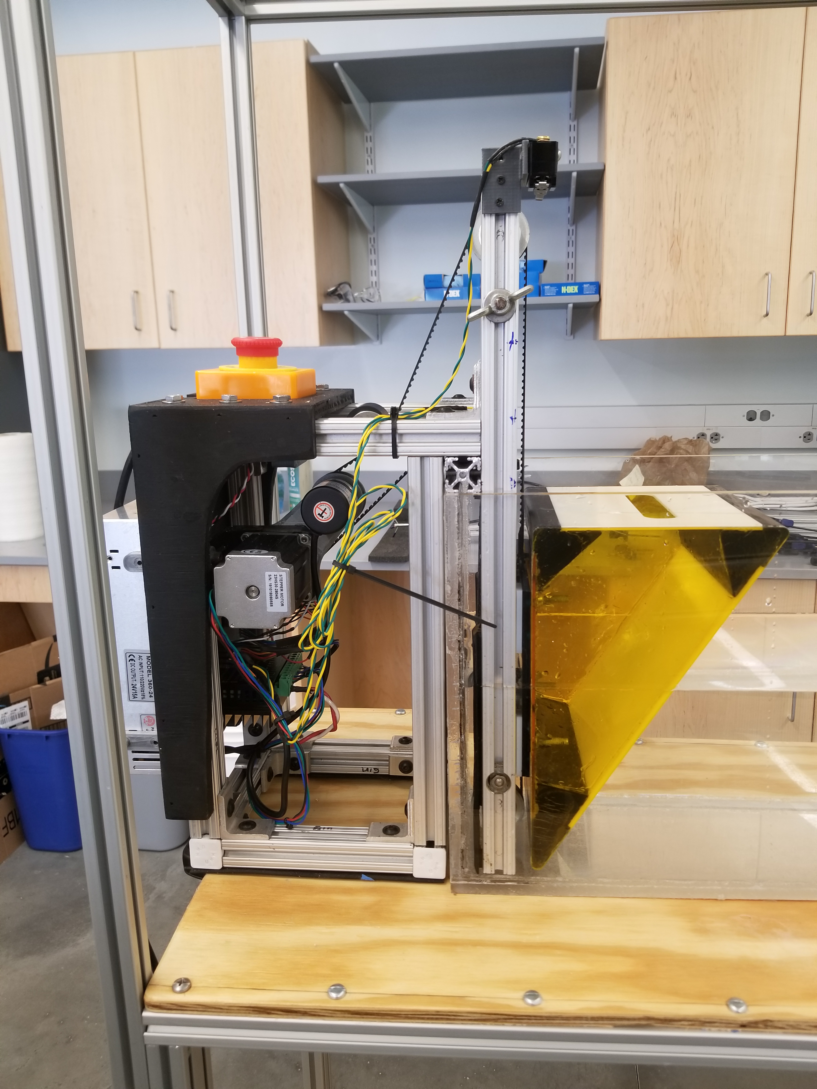
Media/Development/20201017_135754.jpg
