MatthiasOPage/Wavemaker/Media/Development/20201017_135758.jpg

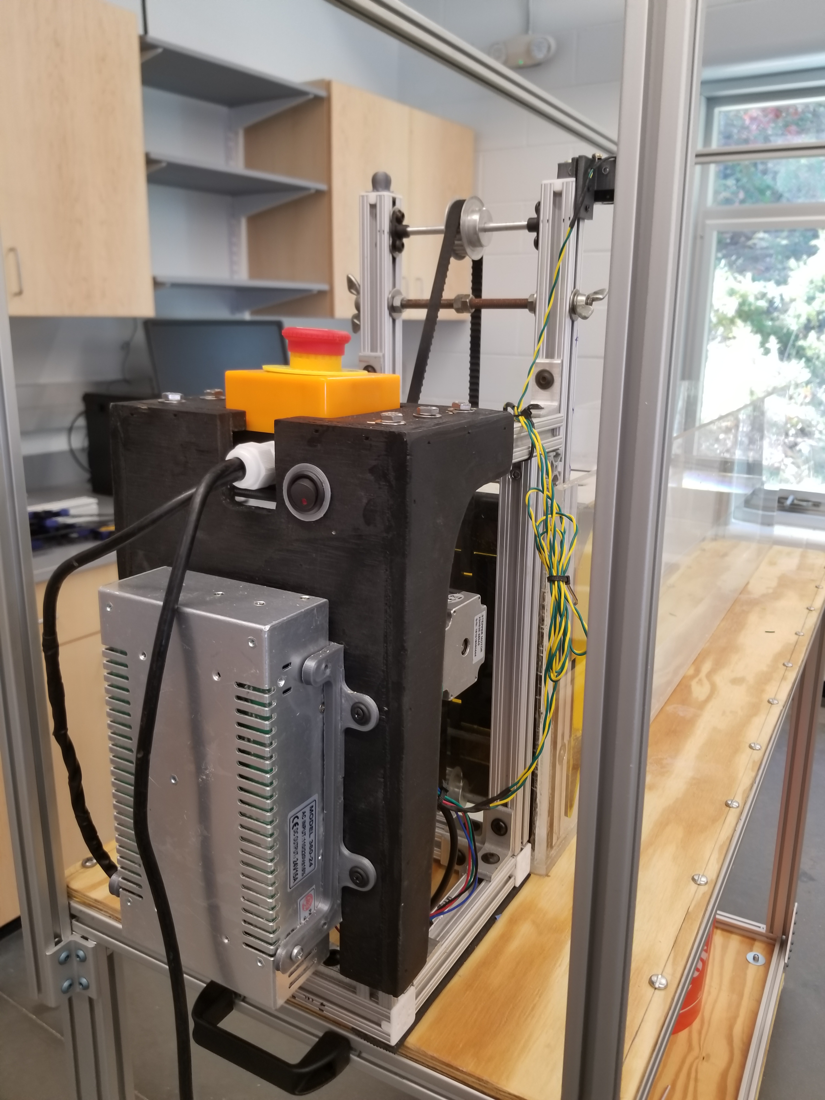
Media/Development/20201017_135758.jpg
