MatthiasOPage/Wavemaker/Media/Development/20201017_135759.jpg

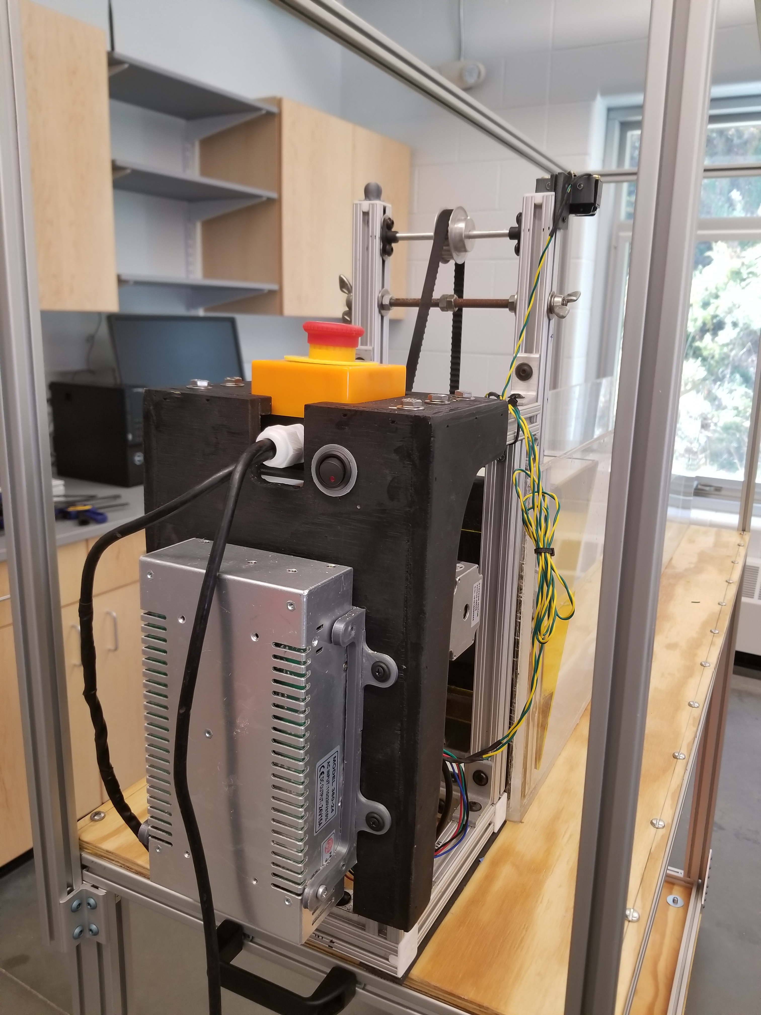
Media/Development/20201017_135759.jpg
