MatthiasOPage/Wavemaker/Media/Development/20201017_135801.jpg

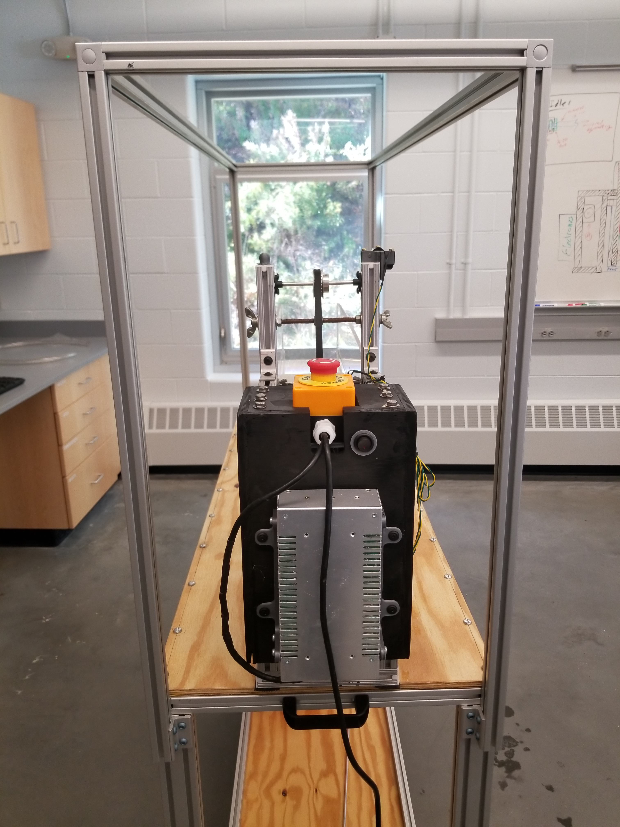
Media/Development/20201017_135801.jpg
