MatthiasOPage/Wavemaker/Media/Development/20201017_135806.jpg

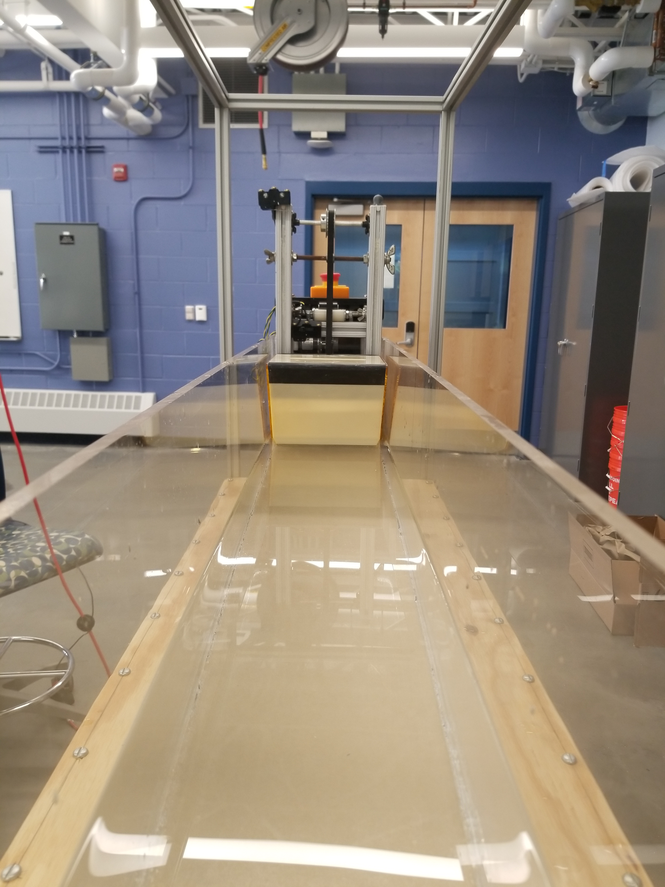
Media/Development/20201017_135806.jpg
