MatthiasOPage/Wavemaker/Media/Development/20201017_135812.jpg

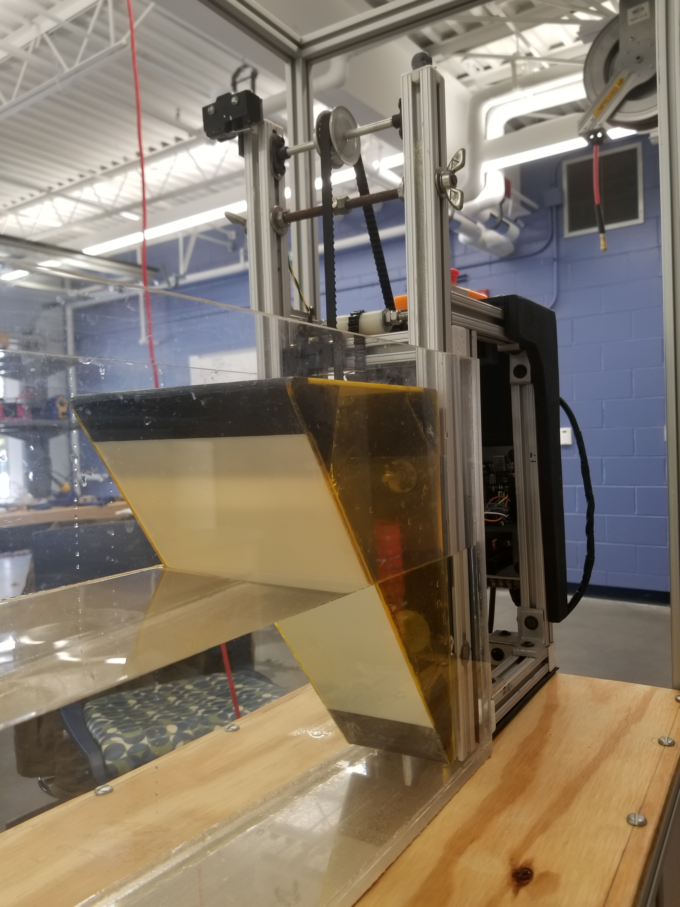
Media/Development/20201017_135812.jpg
