MatthiasOPage/Wavemaker/Media/Development/20201017_144446.jpg

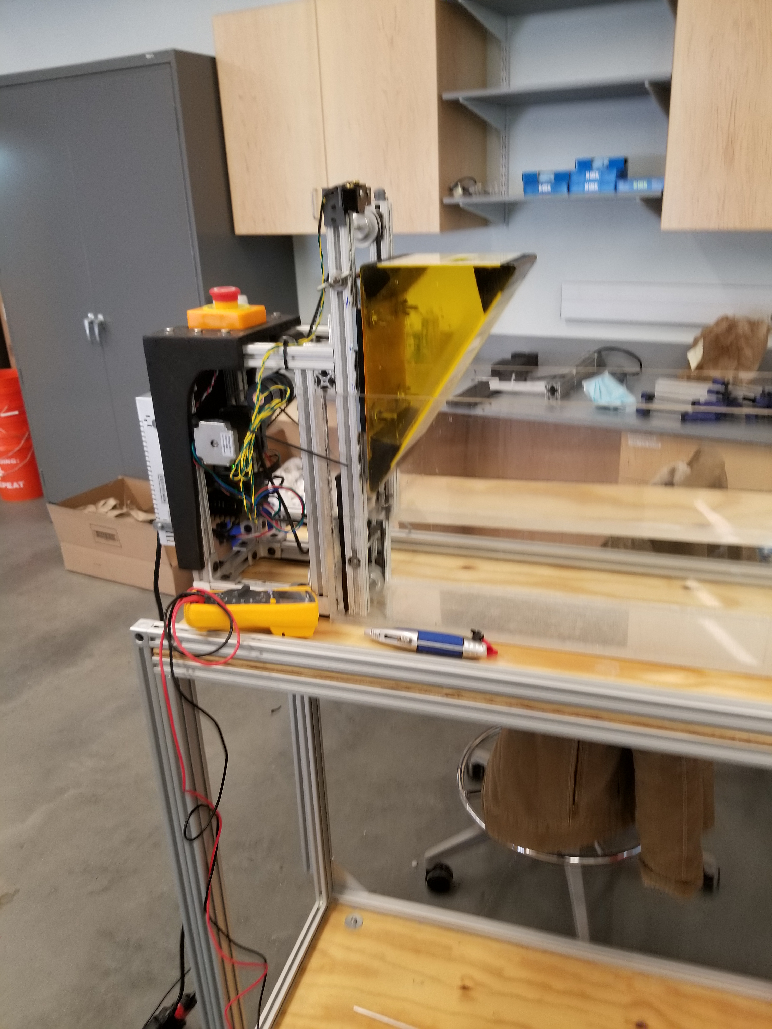
Media/Development/20201017_144446.jpg
