MatthiasOPage/Wavemaker/Media/Development/received_217639759285470.jpeg

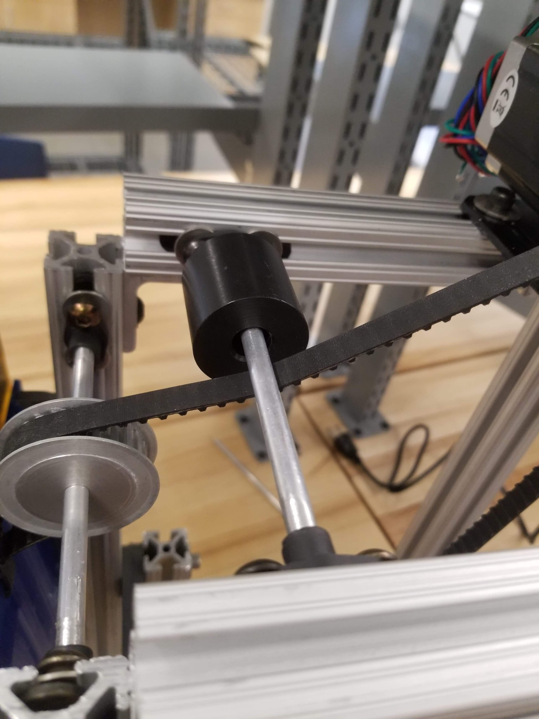
Media/Development/received_217639759285470.jpeg
