MatthiasOPage/Wavemaker/Media/Development/received_294011008490880.jpeg

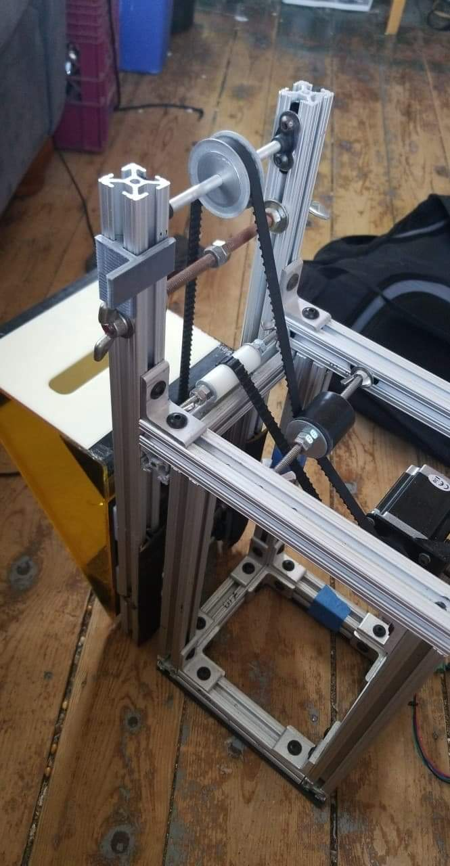
Media/Development/received_294011008490880.jpeg
