MatthiasOPage/Wavemaker/Media/Development/received_484540782494801.jpeg

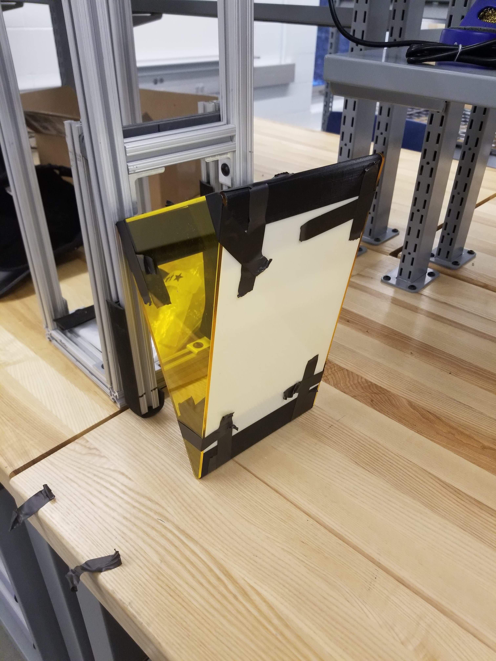
Media/Development/received_484540782494801.jpeg
