MatthiasOPage/Wavemaker/Media/Development/received_588617365197829.jpeg

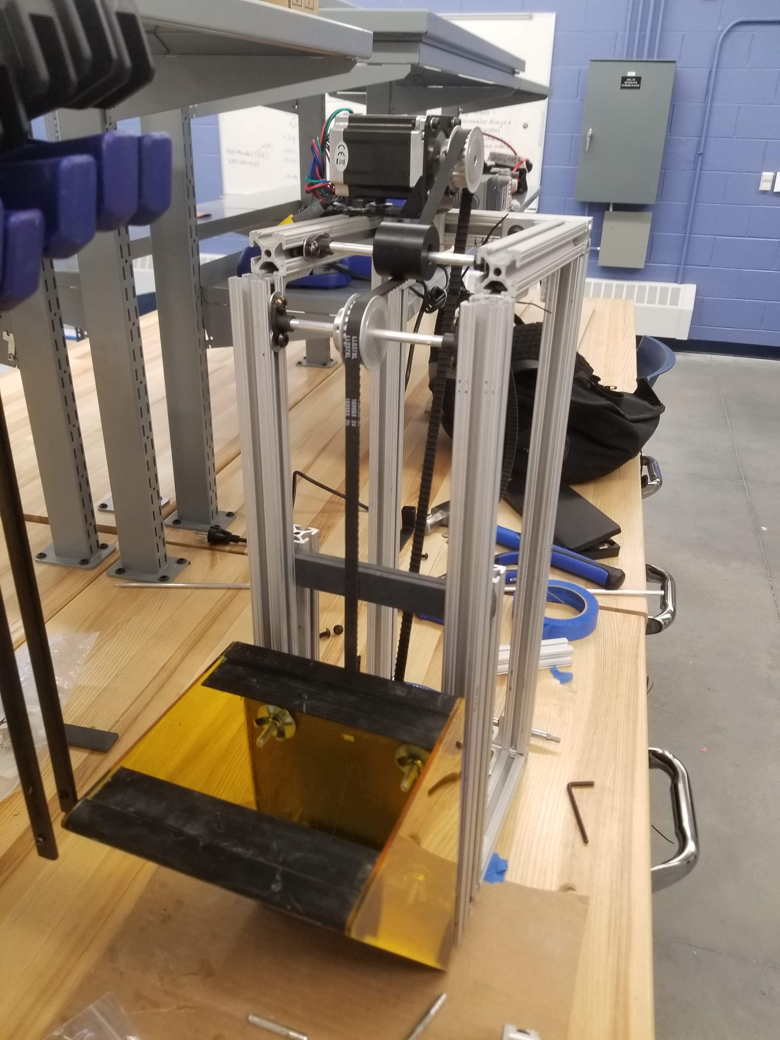
Media/Development/received_588617365197829.jpeg
