MatthiasOPage/Wavemaker/Media/Development/received_662215964584493.jpeg

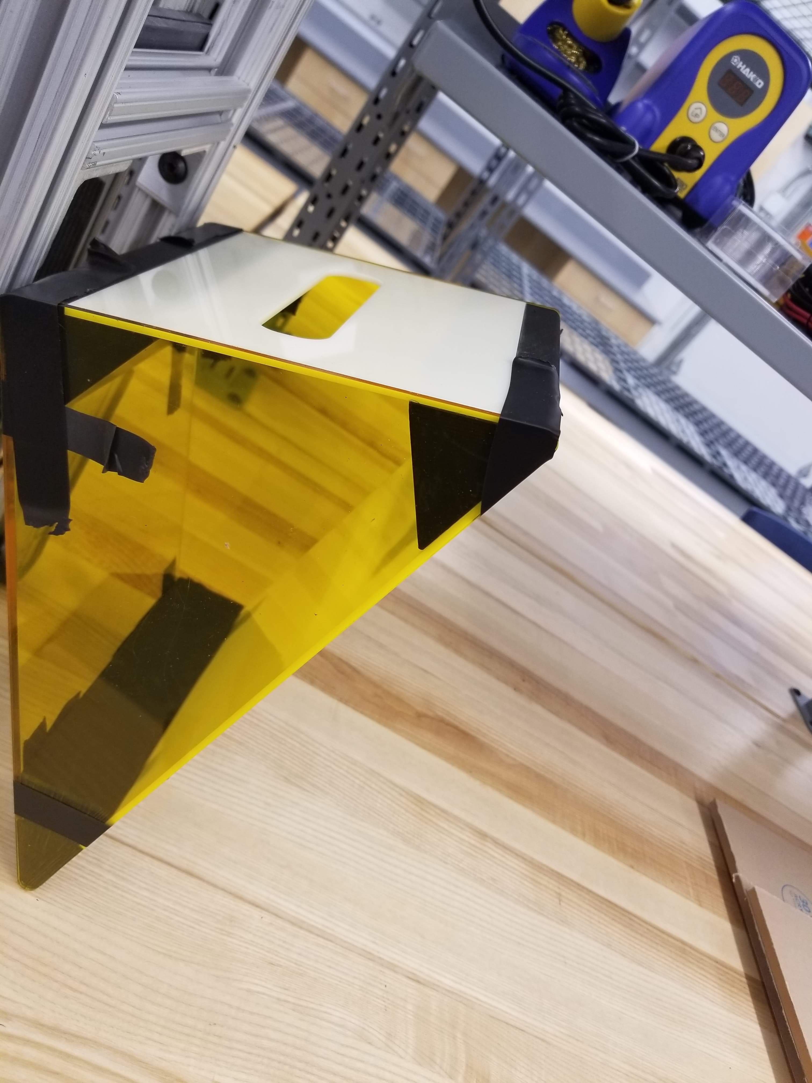
Media/Development/received_662215964584493.jpeg
