MatthiasOPage/Wavemaker/Media/Development/received_776219526270396.jpeg

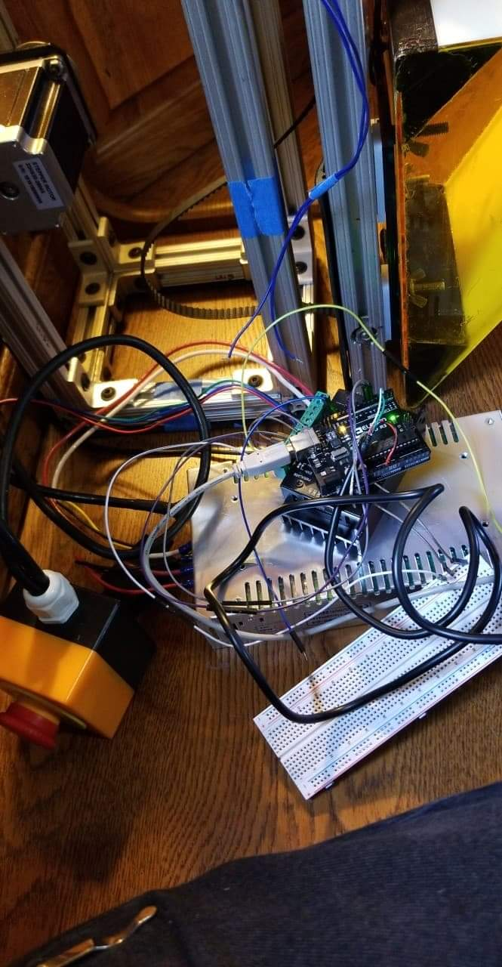
Media/Development/received_776219526270396.jpeg
