MatthiasOPage/Wavemaker/Media/Development/received_842277496269335.jpeg

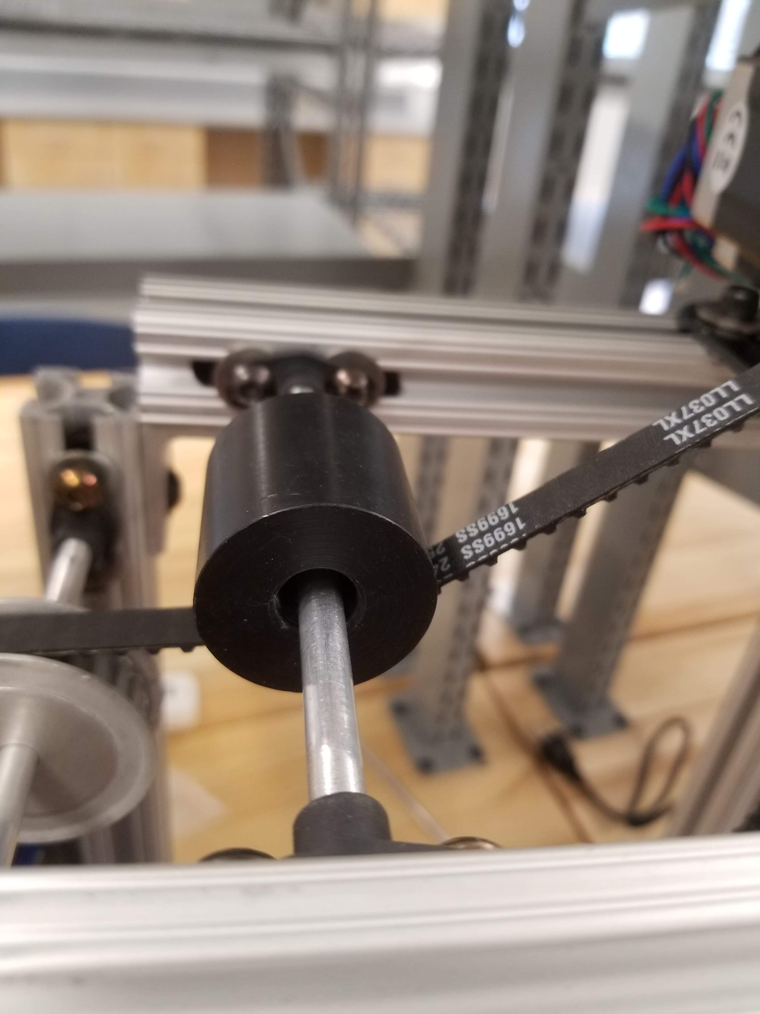
Media/Development/received_842277496269335.jpeg
