MatthiasOPage/Wavemaker/Media/Development/received_1140525292800417.jpeg

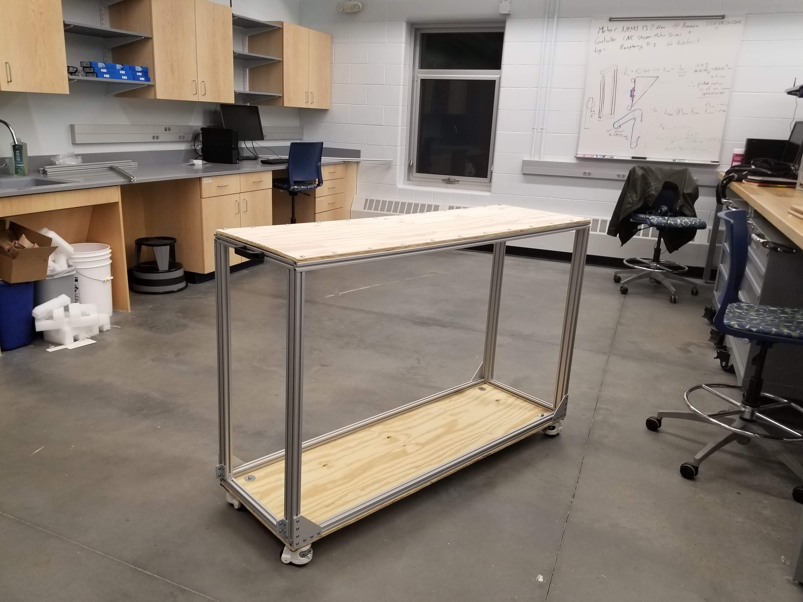
Media/Development/received_1140525292800417.jpeg
