MatthiasOPage/Wavemaker/Media/Development/received_1264698127060614.jpeg

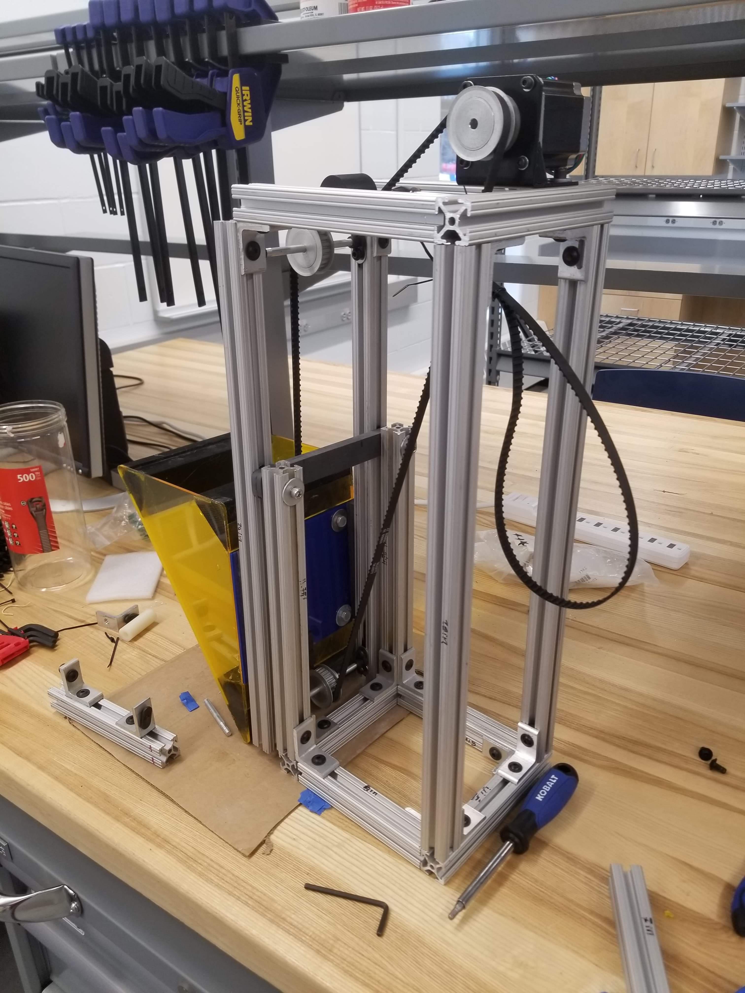
Media/Development/received_1264698127060614.jpeg
