MatthiasOPage/Wavemaker/Media/Development/received_2008963689250507.jpeg

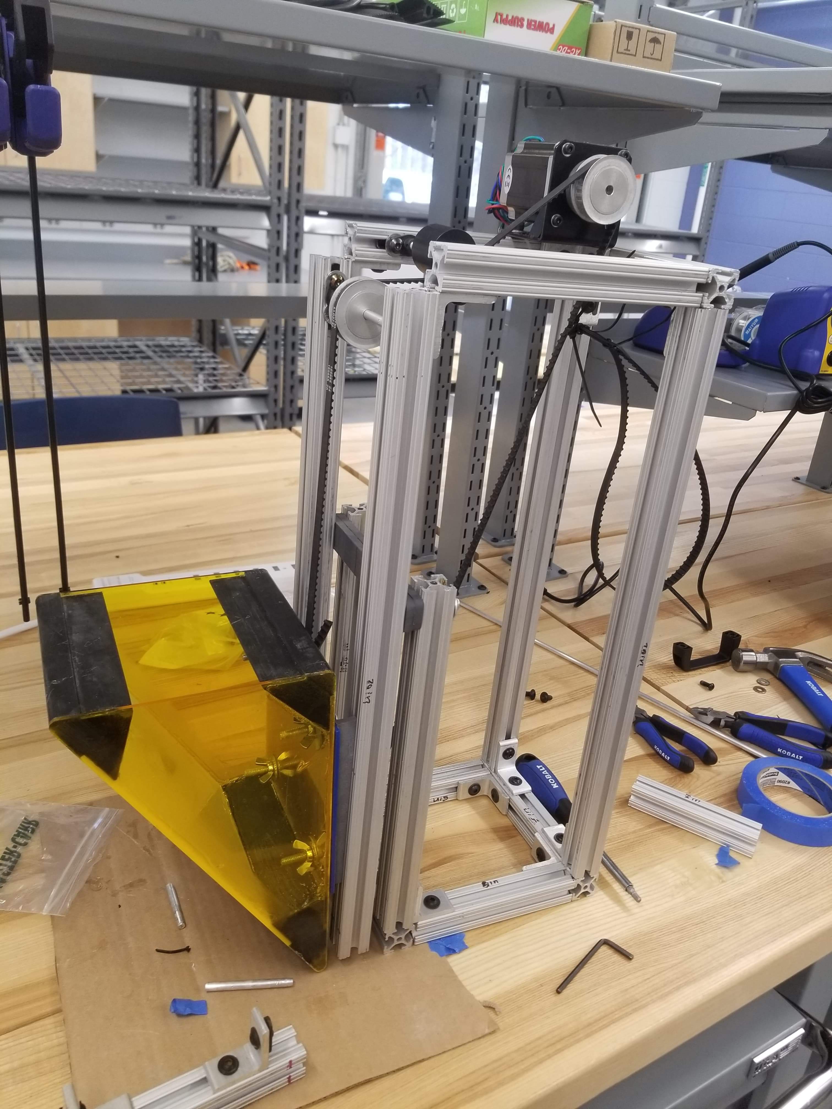
Media/Development/received_2008963689250507.jpeg
