MatthiasOPage/Wavemaker/Media/Development/received_2722095444551968.jpeg

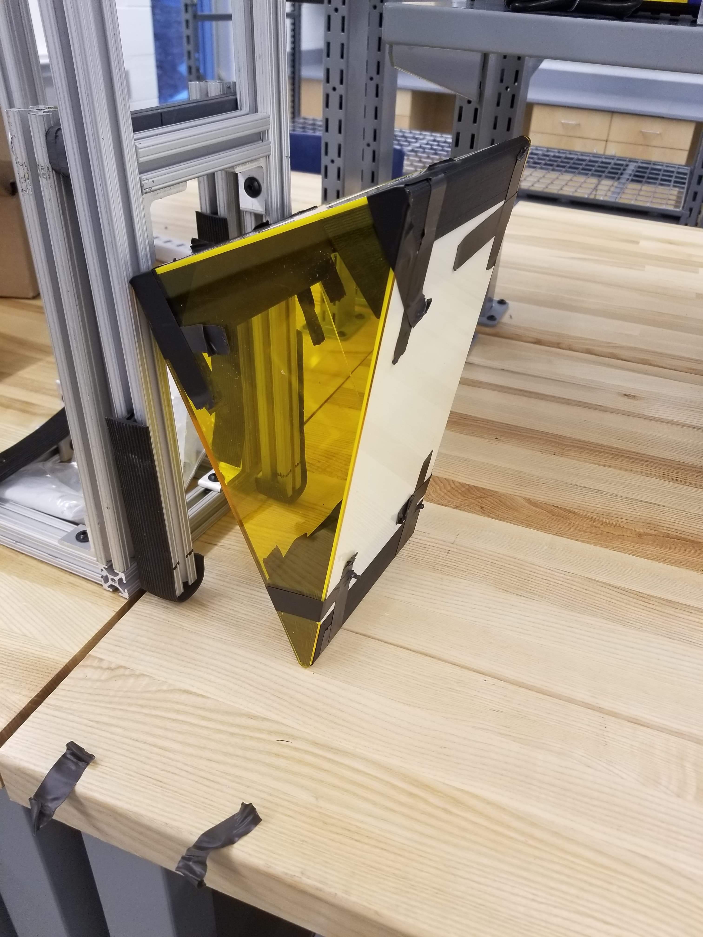
Media/Development/received_2722095444551968.jpeg
