MatthiasOPage/Wavemaker/Media/Development/received_2726672107409839.jpeg

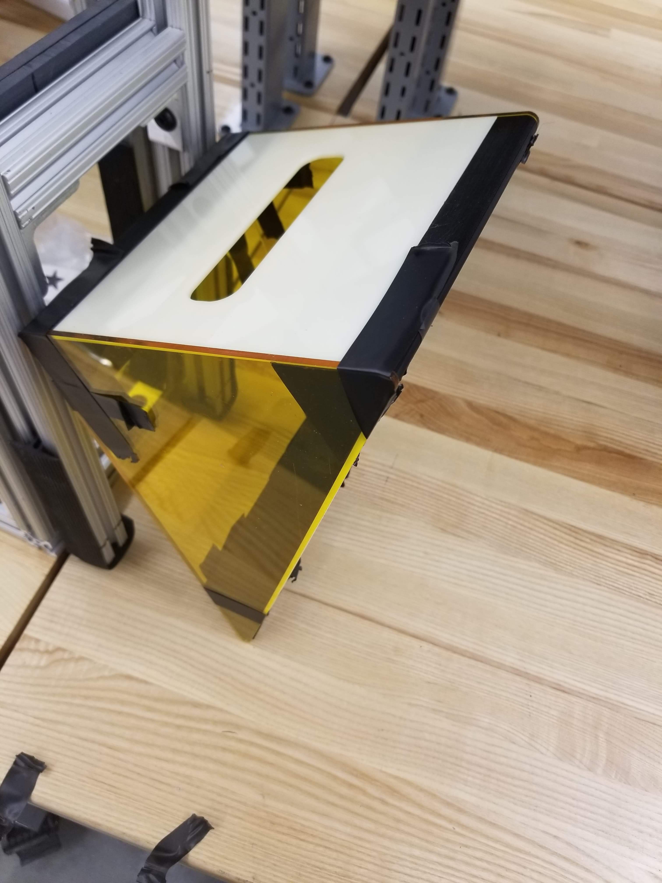
Media/Development/received_2726672107409839.jpeg
