MatthiasOPage/Wavemaker/Media/Development/SolidWorks_Wavemaker_WIP_11-11-2020.png

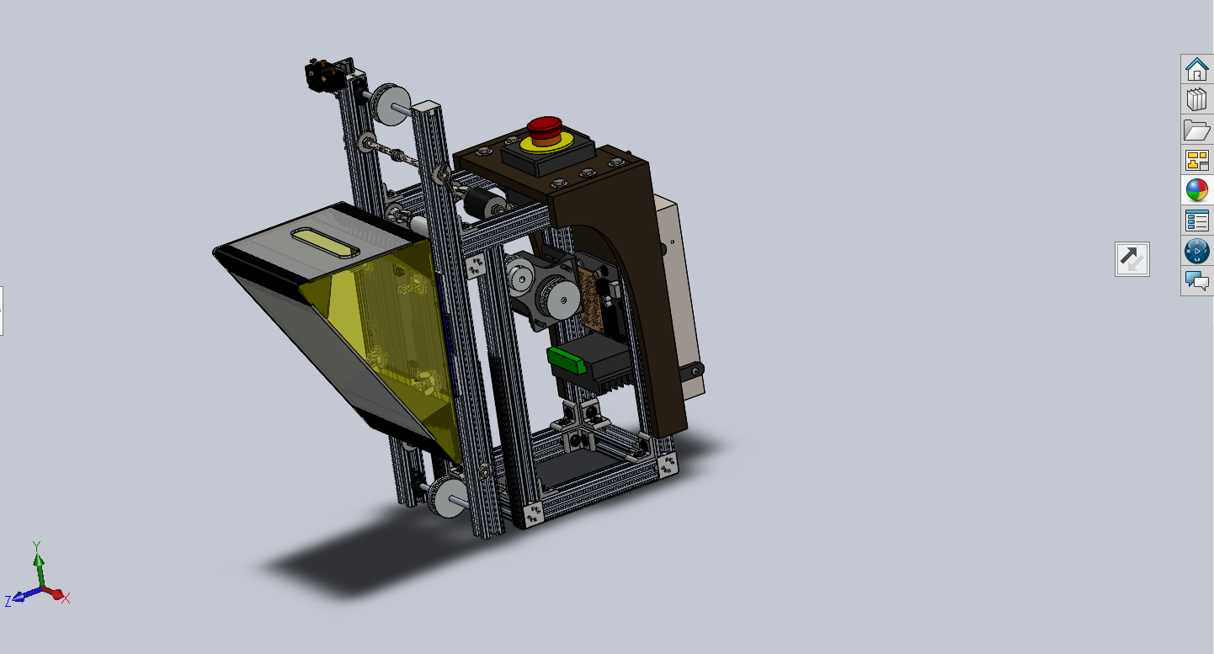
Media/Development/SolidWorks_Wavemaker_WIP_11-11-2020.png
