MatthiasOPage/Wavemaker/Media/Development/WedgePic.png

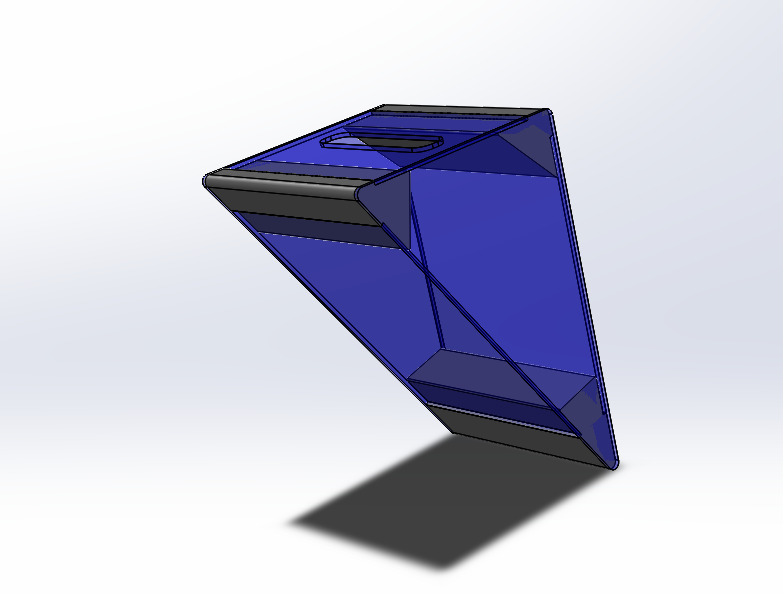
Media/Development/WedgePic.png
