MatthiasOPage/Wavemaker/Media/Gimbal_With_Squash2.png

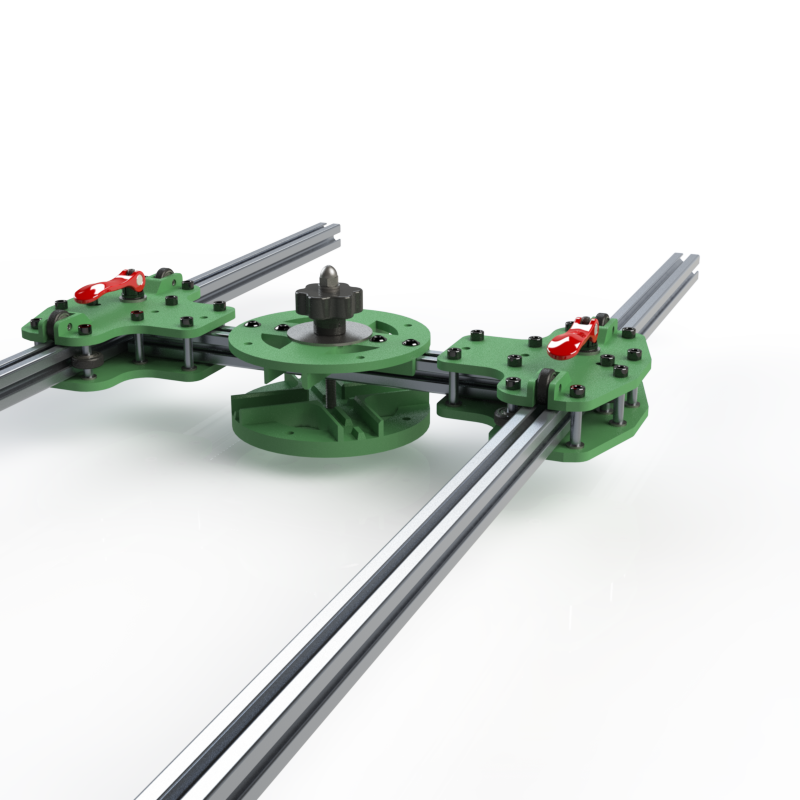
Media/Gimbal_With_Squash2.png
