MatthiasOPage/Wavemaker/Media/Gimbal_With_Squash.png

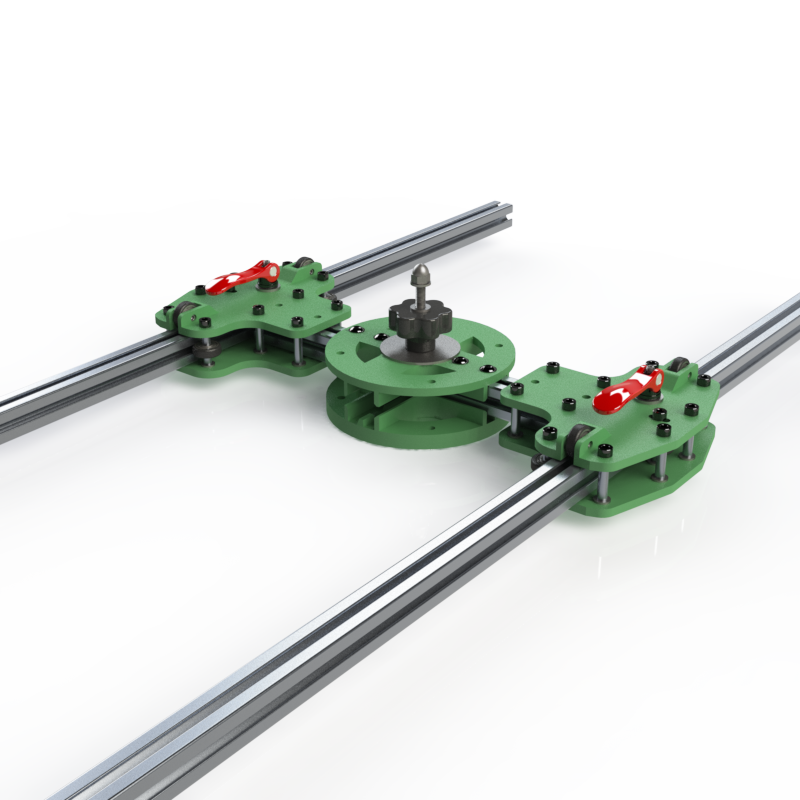
Media/Gimbal_With_Squash.png
