MatthiasOPage/Wavemaker/Media/Wavemaker_and_Cart_11-25-2020-A.png

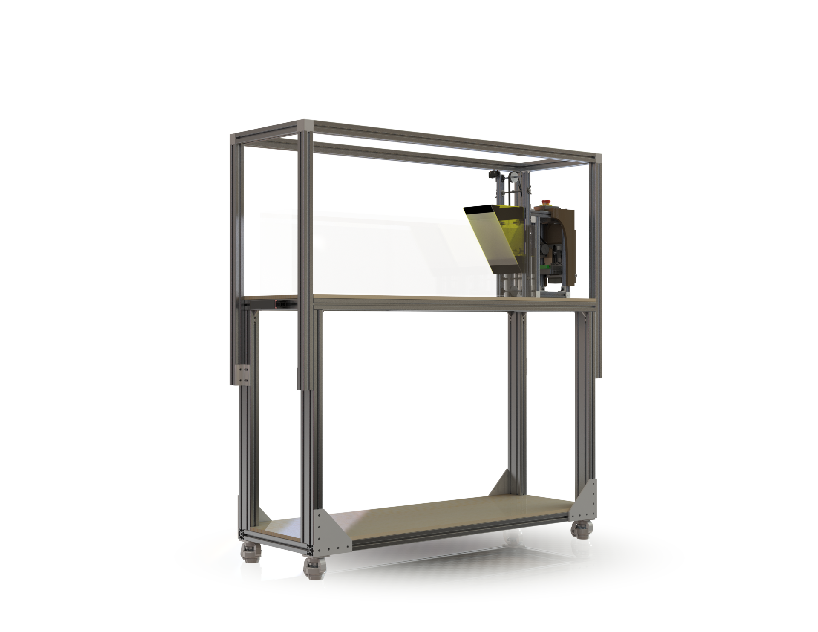
Media/Wavemaker_and_Cart_11-25-2020-A.png
