MatthiasOPage/Wavemaker/Media/Wavemaker_and_Cart_11-25-2020-B.png

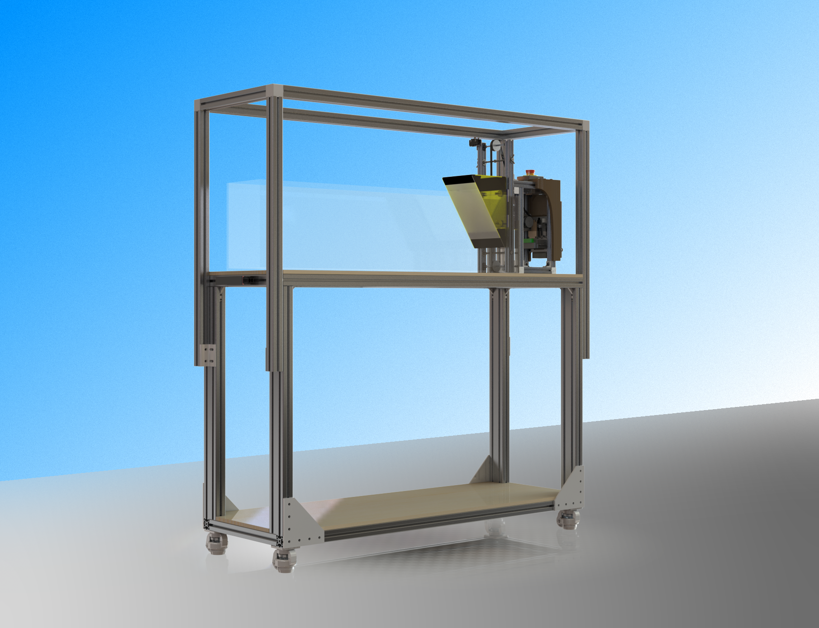
Media/Wavemaker_and_Cart_11-25-2020-B.png
