MatthiasOPage/Wavemaker/Media/Wavemaker_Render_11-25-2020-A.png

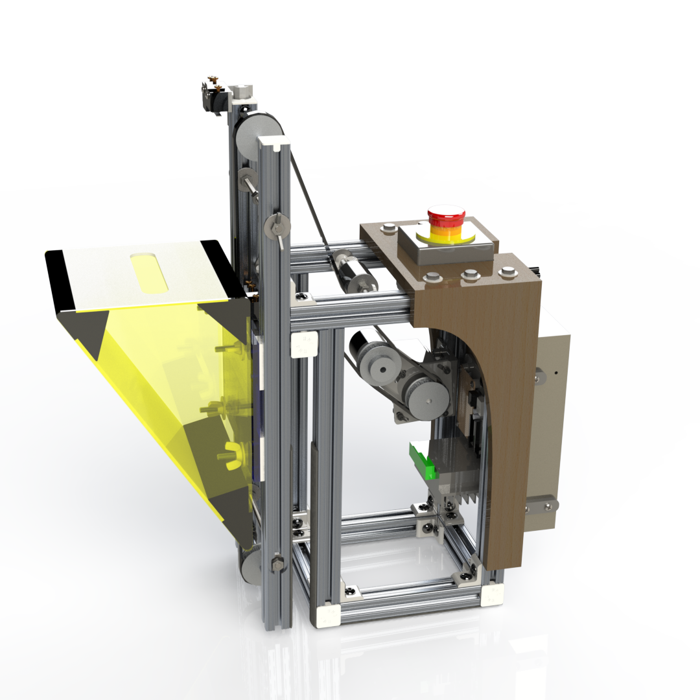
Media/Wavemaker_Render_11-25-2020-A.png
