MatthiasOPage/Wavemaker/Wavemaker 3D Models/Camera Gimbal/GimbalBOMV1.xlsx

Part: | Quantity: | $/pc.: | Total: | Link:
M5x0.8 Bolts
10mm | 16
16mm | 8
20mm | 4
30mm | 8
40mm | 20
45mm [Fully Threaded] | 2
50mm | 2
60mm | 4
M5x0.8 Set Bolts
5mm | 2
10mm | 2
18mm | 4
40mm | 2
M5 Washers
10mm | 106
22mm | 2
M5 Nuts
8x5mm | 48
8x5mm Nylock | 4
M8x1.25 Hardware
110mm Bolt | 1
Washers | 2
Cap Nut | 1
2in Washer | 1
24mm Washer | 1
Knob | 1
Bushings [594mm/24in]
4mm | 4
5mm | 12
6mm | 4
6.5mm | 12
26mm | 16
1/4-20 Hardware
530mm Threaded Rod | 2
14.27OD Washers | 12
Nylocks | 12
Hardware
Roller Bearings | 10
Lever Lock | 2
Spring | 8
500x8mm Linear Rods | 2
3D Printed Parts
Z-Carriage Top Plates | 2
Z-Carriage Bottom Plates | 2
Lever Lock Nuts | 2
Squash Plate Top | 1
Squash Plate Mid | 1
Squash Plate Bottom | 1
X-Rail Endcaps | 2
X-Rail Center Support | 1
Camera Adapter Swing | 2
Bent Linkage Arms | 4
Camera Angle Base | 2
Slider Block | 2
Camera Rail Mount | 2
Adjuster Knob | 2
