MatthiasOPage/Wavemaker/Wavemaker 3D Models/Camera Gimbal/GimbalBOMV1_Fastenal.xlsx

Part: | Quantity: | Extra: | $/pc.: | Total: | Link:
M5x0.8 Bolts
10mm | 16 | 4 | 0.1861 | $3.72 | https://www.fastenal.com/product/fasteners/sockets/socket-cap-screws/600040?categoryId=600040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
16mm | 8 | 2 | 0.2306 | $2.31 | https://www.fastenal.com/product/fasteners/sockets/socket-cap-screws/600040?categoryId=600040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
20mm | 4 | 2 | 0.1894 | $1.14 | https://www.fastenal.com/product/fasteners/sockets/socket-cap-screws/600040?categoryId=600040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
30mm | 8 | 2 | 0.214 | $2.14 | https://www.fastenal.com/product/fasteners/sockets/socket-cap-screws/600040?categoryId=600040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
40mm | 20 | 8 | 0.1784 | $5.00 | https://www.fastenal.com/product/fasteners/sockets/socket-cap-screws/600040?categoryId=600040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
45mm [Fully Threaded] | 2 | 2 | 1.15 | $4.60 | https://www.fastenal.com/product/fasteners/sockets/button-socket-cap-screws/600043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
50mm | 2 | 2 | 0.2048 | $0.82 | https://www.fastenal.com/product/fasteners/sockets/socket-cap-screws/600040?categoryId=600040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
60mm | 4 | 2 | 0.4399 | $2.64 | https://www.fastenal.com/product/fasteners/sockets/socket-cap-screws/600040?categoryId=600040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
M5x0.8 Set Bolts
5mm | 2 | 2 | 0.1278 | $0.51 | https://www.fastenal.com/product/fasteners/set-screws/socket-set-screws/600049?query=set%2520screws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
10mm | 2 | 2 | 0.0726 | $0.29 | https://www.fastenal.com/product/fasteners/set-screws/socket-set-screws/600049?query=set%2520screws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
20mm | 4 | 2 | 0.77 | $4.62 | https://www.fastenal.com/product/fasteners/set-screws/socket-set-screws/600049?query=set%2520screws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
40mm | 2 | 2 | 1.02 | $4.08 | https://www.fastenal.com/product/fasteners/set-screws/socket-set-screws/600049?query=set%2520screws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
M5 Washers
10mm | 106 | 94 | 0.0165 | $3.30 | https://www.fastenal.com/product/fasteners/washers/flat-washers/600097?categoryId=600097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
22mm | 2 | 2 | 0.1099 | $0.44 | https://www.fastenal.com/product/fasteners/washers/flat-washers/600097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
M5 Nuts
8x5mm | 48 | 52 | 0.0523 | $5.23 | https://www.fastenal.com/product/fasteners/nuts/hex-nuts/608621?categoryId=608621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
8x5mm Nylock | 4 | 4 | 0.166 | $1.33 | https://www.fastenal.com/product/fasteners/nuts/lock-nuts/600081?categoryId=600081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
M8x1.25 Hardware
110mm Bolt | 1 | 1 | 1.09 | $2.18 | https://www.fastenal.com/product/fasteners/bolts/hex-cap-screws-and-hex-bolts/600003?categoryId=600003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
Washers | 2 | 2 | 0.085 | $0.34 | https://www.fastenal.com/product/fasteners/washers/flat-washers/600097?categoryId=600097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
Fender Washer | 3 | 1 | 0.2333 | $0.93 | https://www.fastenal.com/product/fasteners/washers/flat-washers/600097?categoryId=600097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
Cap Nut | 1 | 1 | 0.812 | $1.62 | https://www.fastenal.com/product/fasteners/nuts/acorn-nuts/602448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
Knob | 1 | 0 | 6.25 | $6.25 | https://www.mcmaster.com/4273T84/?SrchEntryWebPart_InpBox=bearing
Bushings [594mm/24in]
4mm | 4 |  |  | $0.00
5mm | 12 |  |  | $0.00
6mm | 4 |  |  | $0.00
6.5mm | 12 |  |  | $0.00
26mm | 16 |  |  | $0.00
3ft Stock | 1 | 0 | 16.23 | $16.23 | https://www.mcmaster.com/89965K341/
1/4-20 Hardware
530mm Threaded Rod | 2 | 0 | 2.405 | $4.81 | https://www.fastenal.com/product/fasteners/rods-and-studs/threaded-rods/600173?query=threaded%2520rod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
Washers | 12 | 3 | 0.0587 | $0.88 | https://www.fastenal.com/product/fasteners/washers/flat-washers/600097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
Nylocks | 12 | 3 | 0.0484 | $0.73 | https://www.fastenal.com/product/fasteners/nuts/lock-nuts/600081?categoryId=600081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
Hardware
Roller Bearings | 10 |  |  | $0.00 | On hand
Lever Lock | 2 | 0 | 10.92 | $21.84 | https://www.mcmaster.com/2030N19/
Spring | 8 | 4 |  | $11.16 | https://www.mcmaster.com/9657K272/
500x8mm Linear Rods | 2 |  |  | $19.89 | https://nam12.safelinks.protection.outlook.com/?reserved=0
3D Printed Parts
Z-Carriage Top Plates | 2 |  |  | $0.00 | On hand
Z-Carriage Bottom Plates | 2 |  |  | $0.00 | On hand
Lever Lock Nuts | 2 |  |  | $0.00 | On hand
Squash Plate Top | 1 |  |  | $0.00 | On hand
Squash Plate Mid | 1 |  |  | $0.00 | On hand
Squash Plate Bottom | 1 |  |  | $0.00 | On hand
X-Rail Endcaps | 2 |  |  | $0.00 | On hand
X-Rail Center Support | 1 |  |  | $0.00 | On hand
Camera Adapter Swing | 2 |  |  | $0.00 | On hand
Bent Linkage Arms | 4 |  |  | $0.00 | On hand
Camera Angle Base | 2 |  |  | $0.00 | On hand
Slider Block | 2 |  |  | $0.00 | On hand
Camera Rail Mount | 2 |  |  | $0.00 | On hand
Adjuster Knob | 2 |  |  | $0.00 | On hand
Filament | 1 |  |  | $22.99 | https://nam12.safelinks.protection.outlook.com/?reserved=0
80/20
350mm 2525 Tslot | 1 | 0 |  | $5.53 | https://8020.net/25-2525-black.html
Nuts | 12 | 3 | 0.21 | $3.15 | https://8020.net/25-3382.html
Bolts | 12 | 3 | 0.3 | $4.50 | https://8020.net/3342.html
General
WD-40 | 1 |  |  | $0.00
Pipe Cutter | 1 |  |  | $12.67 | https://www.amazon.com/RIDGID-32975-Quarters-Tubing-Cutter/dp/B000LDGNCU
Total: |  |  |  | $152.01
