MatthiasOPage/Wavemaker/Wavemaker 3D Models/Cart_Tank_Frame_Assembly.SLDASM

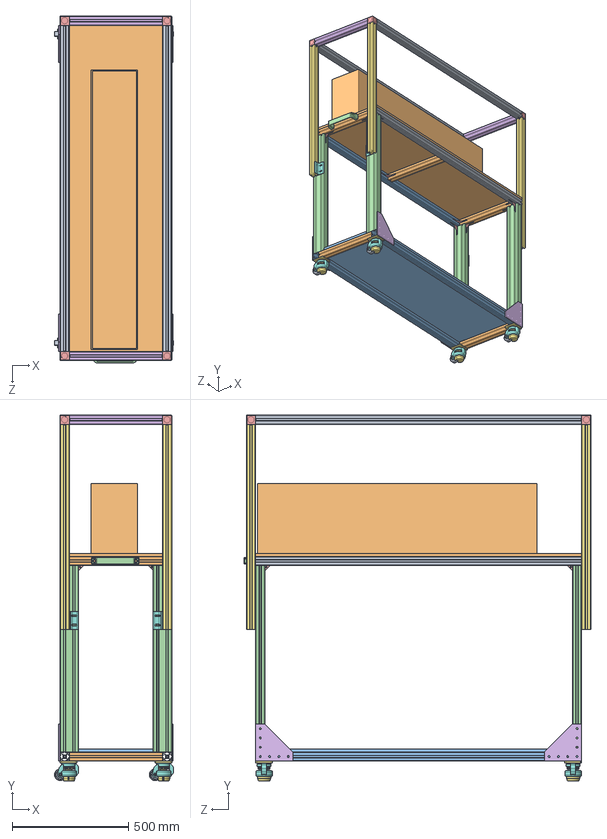
[picture p104: CAD file, 2020-11-25]
Wavemaker 3D Models/Cart_Tank_Frame_Assembly.SLDASM
511.0 x 1571.4 x 1490.0 mm
40S-120cm
40S-40cm x 5
40S-140cm x 3
4080S-80cm x 4
_65_2714_plate_2 x 4
_65_2714_body_4 x 4
_65_2714_wheel_6 x 4
CartTop
CartBase
40S-48cm x 2
40S-88cm x 4
40S-140cmSuper x 2
TestTank
