MatthiasOPage/Wavemaker/Wavemaker 3D Models/Electronics Shelf/Electronics_Frame_Assembly.SLDASM

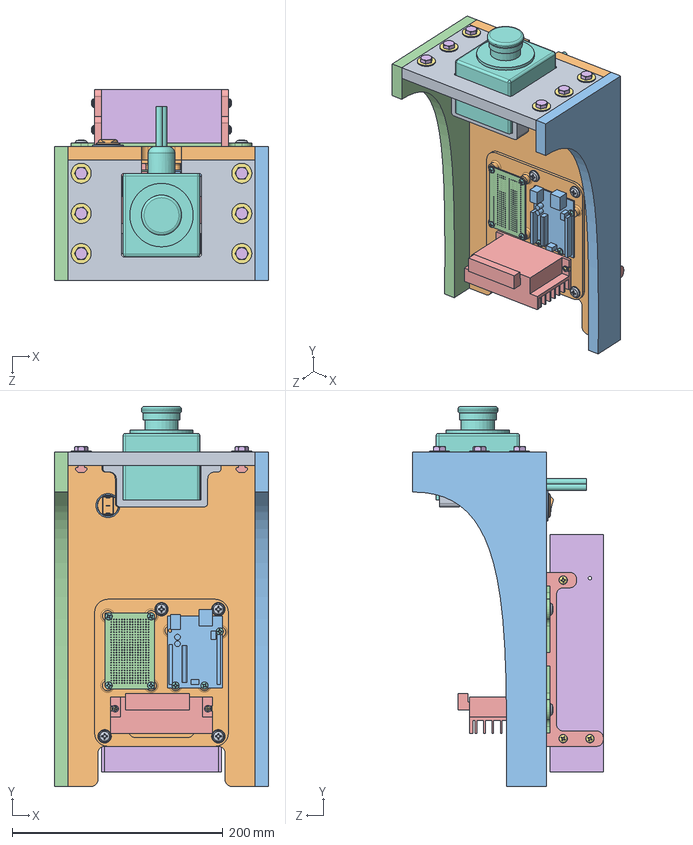
[picture p105: CAD file, 2020-11-25]
Wavemaker 3D Models/Electronics Shelf/Electronics_Frame_Assembly.SLDASM
203.2 x 360.7 x 181.0 mm
Electronics_Bracket_Top_Plate
Electronics_Bracket_Front_Plate
Electronics_Bracket_Side_Brackets_Left
Electronics_Bracket_Side_Brackets_Right
Backpack_Rail_Nuts x 2
Shelf_Bolt x 6
Shelf_Washer_0.75 x 6
Button_Basic_Model
Button_Bracket_Narrow x 2
Electronics_Mounting_Bracket
Arduino_Basic_Model
PCB_Basic
Controller_Basic_Model
MC_Washer x 2
MC_Screw x 2
Board_Screw x 7
Bracket_to_Wood_Screws x 8
Toggle
Button_Spacer
PSU_Mounting_Plate_Revised
PSU_Bracket_Sides x 2
PSU_Basic_Model
PSU_Bolt x 6
