MatthiasOPage/Wavemaker/Wavemaker 3D Models/Electronics Shelf/Shelf Hardware/Rail_Assembly.SLDASM

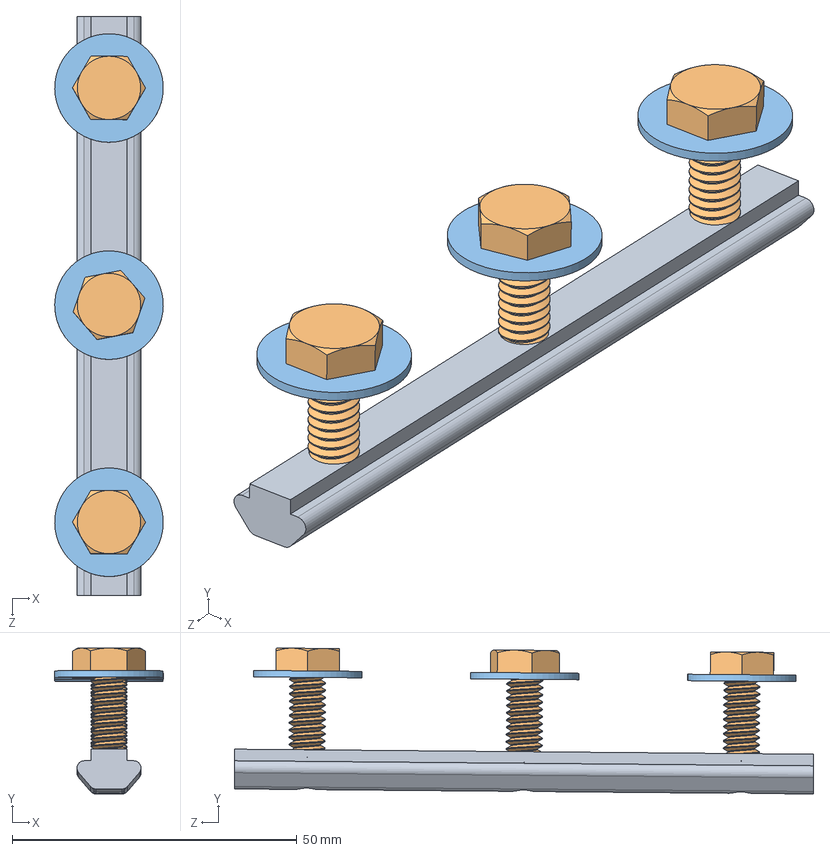
[picture p106: CAD file, 2020-11-25]
Wavemaker 3D Models/Electronics Shelf/Shelf Hardware/Rail_Assembly.SLDASM
19.0 x 25.6 x 101.7 mm
Backpack_Rail_Nuts
Shelf_Bolt x 3
Shelf_Washer_0.75 x 3
