MatthiasOPage/Wavemaker/Wavemaker 3D Models/Electronics/Limits/Top_Limit_Assembly.SLDASM

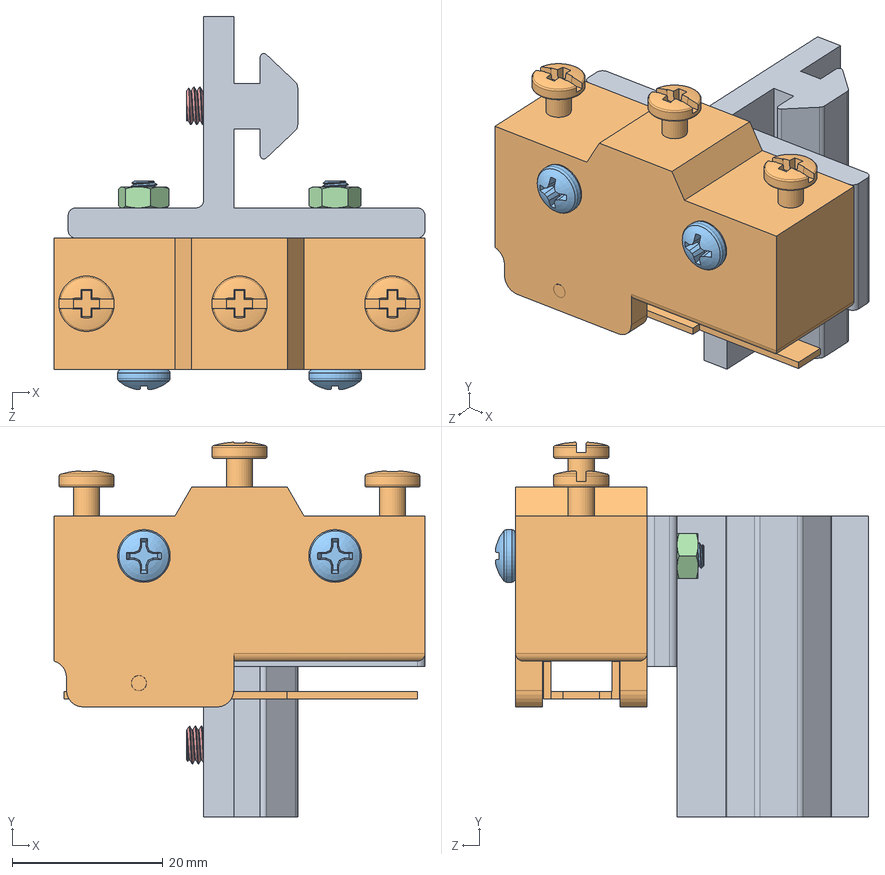
[picture p107: CAD file, 2020-11-25]
Wavemaker 3D Models/Electronics/Limits/Top_Limit_Assembly.SLDASM
49.3 x 49.8 x 49.6 mm
Limit_Bracket_Basic
Limit_Switch_Top
Top_Limit_Bolt x 2
Top_Limit_Nut x 2
Top_Grub_Screw x 2
