MatthiasOPage/Wavemaker/Wavemaker 3D Models/Electronics/PSU/PSU_Assembly.SLDASM

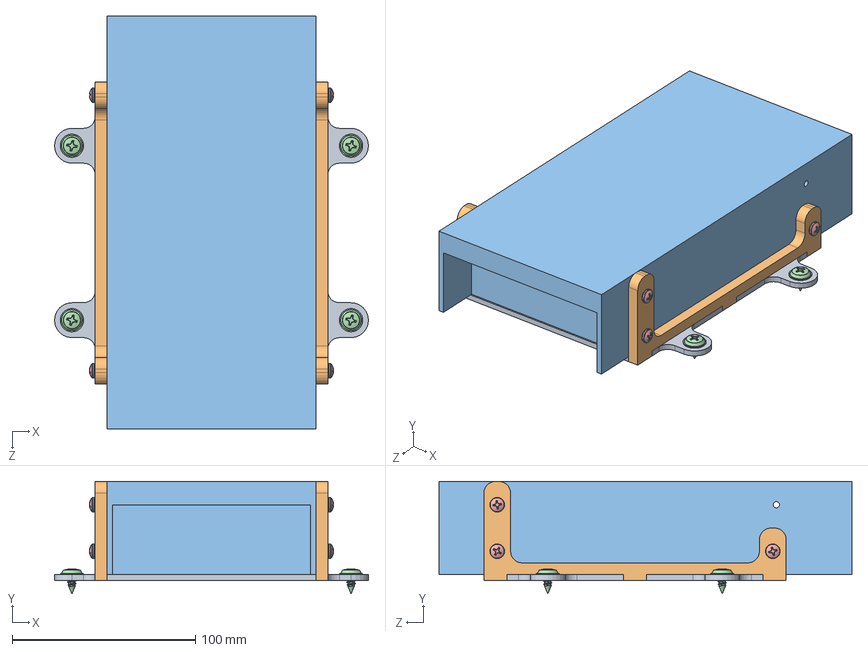
[picture p108: CAD file, 2020-11-25]
Wavemaker 3D Models/Electronics/PSU/PSU_Assembly.SLDASM
171.4 x 61.2 x 225.4 mm
PSU_Mounting_Plate_Revised
PSU_Bracket_Sides x 2
PSU_Basic_Model
Bracket_to_Wood_Screws x 4
PSU_Bolt x 6
