MatthiasOPage/Wavemaker/Wavemaker 3D Models/Electronics/Shelf Brackets/Button_Assembly.SLDASM

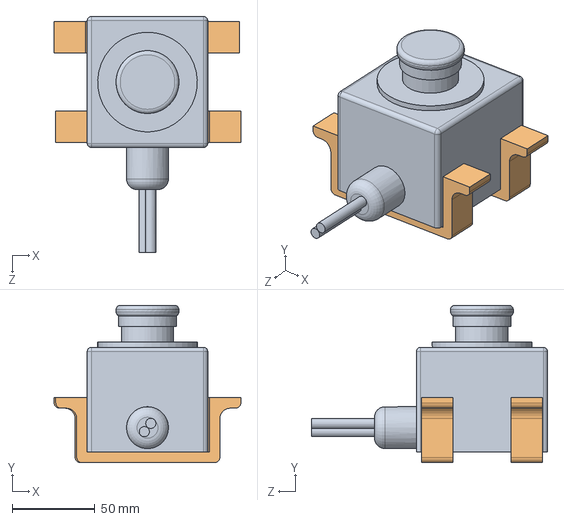
[picture p109: CAD file, 2020-11-25]
Wavemaker 3D Models/Electronics/Shelf Brackets/Button_Assembly.SLDASM
113.1 x 95.2 x 142.9 mm
Button_Basic_Model
Button_Bracket_Narrow x 2
