MatthiasOPage/Wavemaker/Wavemaker 3D Models/Electronics/Toggle/Button_and_Sleeve.SLDASM

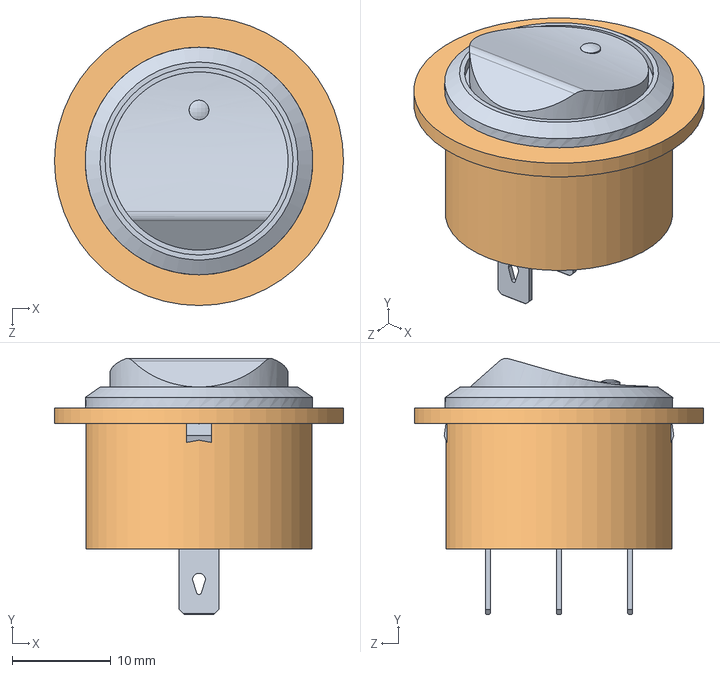
[picture p110: CAD file, 2020-11-25]
Wavemaker 3D Models/Electronics/Toggle/Button_and_Sleeve.SLDASM
29.2 x 25.9 x 29.2 mm
Toggle
Button_Spacer
