MatthiasOPage/Wavemaker/Wavemaker 3D Models/Frame Extrusions/Frame_Extrusions_Assembly.SLDASM

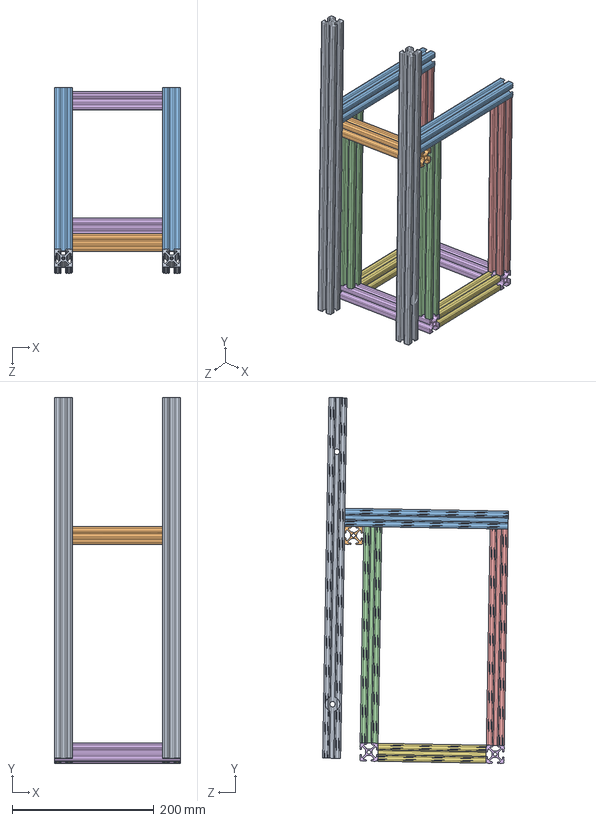
[picture p111: CAD file, 2020-11-25]
Wavemaker 3D Models/Frame Extrusions/Frame_Extrusions_Assembly.SLDASM
177.8 x 515.5 x 261.7 mm
20in x 2
7in_Drilled
9.0625in x 2
12in_Drilled x 2
12in x 2
7in x 2
6in x 2
