MatthiasOPage/Wavemaker/Wavemaker 3D Models/Frame Hardware/Idlers/Front_Idler_Assembly.SLDASM

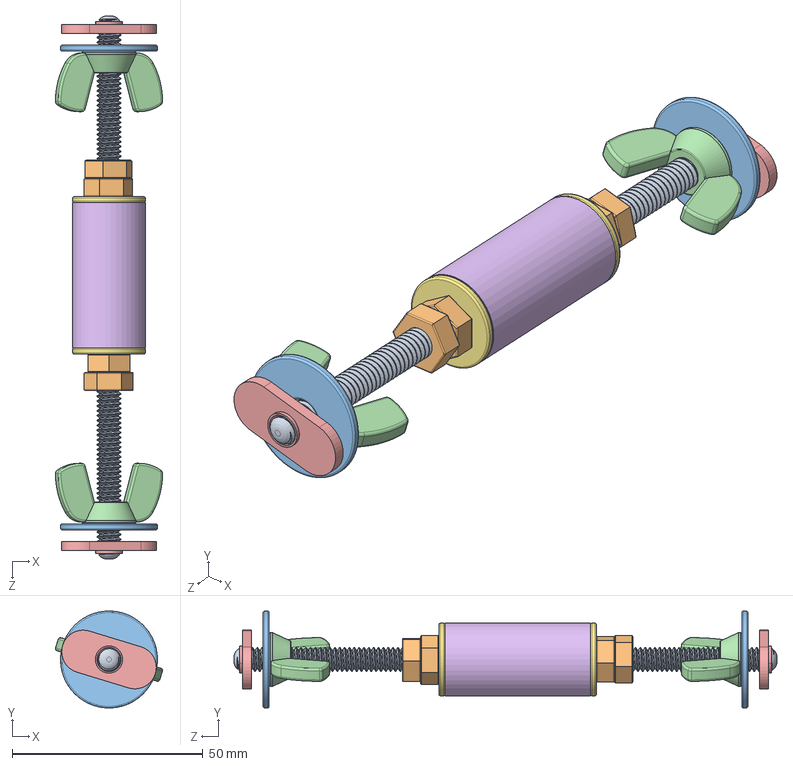
[picture p112: CAD file, 2020-11-25]
Wavemaker 3D Models/Frame Hardware/Idlers/Front_Idler_Assembly.SLDASM
28.1 x 25.4 x 142.2 mm
Idler_Threaded_Rod
7_16-1_4-20_Nut x 4
1in_Washer x 2
Plate_Wingnut x 2
1_4-20T_Nut x 2
Front_Idler_Delrin
.75in_Washer x 2
