MatthiasOPage/Wavemaker/Wavemaker 3D Models/Frame Hardware/Pulley Assmebly/Pulley_Assembly.SLDASM

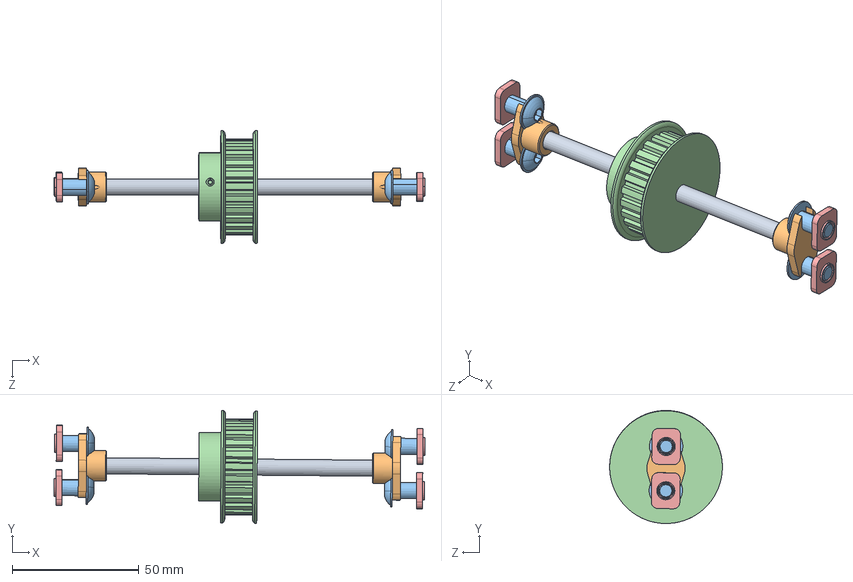
[picture p113: CAD file, 2020-11-25]
Wavemaker 3D Models/Frame Hardware/Pulley Assmebly/Pulley_Assembly.SLDASM
146.3 x 44.6 x 44.4 mm
Pulley_Shaft
Babbit_Bearing x 2
1_4-20x.5_Flange x 4
Timing_Pulley
1_4-20T_Nut_Truncated x 4
