MatthiasOPage/Wavemaker/Wavemaker 3D Models/Mounting Plate/Mounting_Plate_Assembly.SLDASM

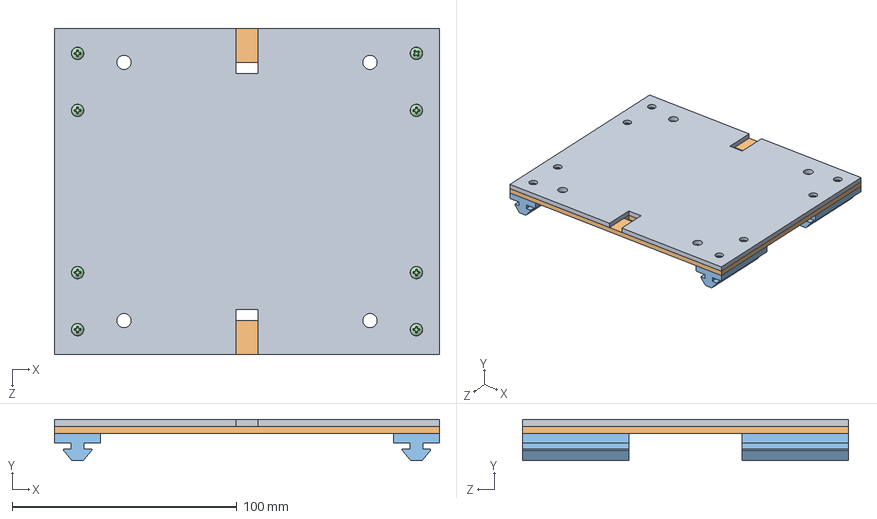
[picture p114: CAD file, 2020-11-25]
Wavemaker 3D Models/Mounting Plate/Mounting_Plate_Assembly.SLDASM
171.4 x 18.3 x 145.0 mm
Mounting_Plate_Front
Mounting_Plate_Back_V2
Plate_Slide_Bearing x 4
Slide_Bolts x 8
