MatthiasOPage/Wavemaker/Wavemaker 3D Models/Wedge/Wedge.SLDASM

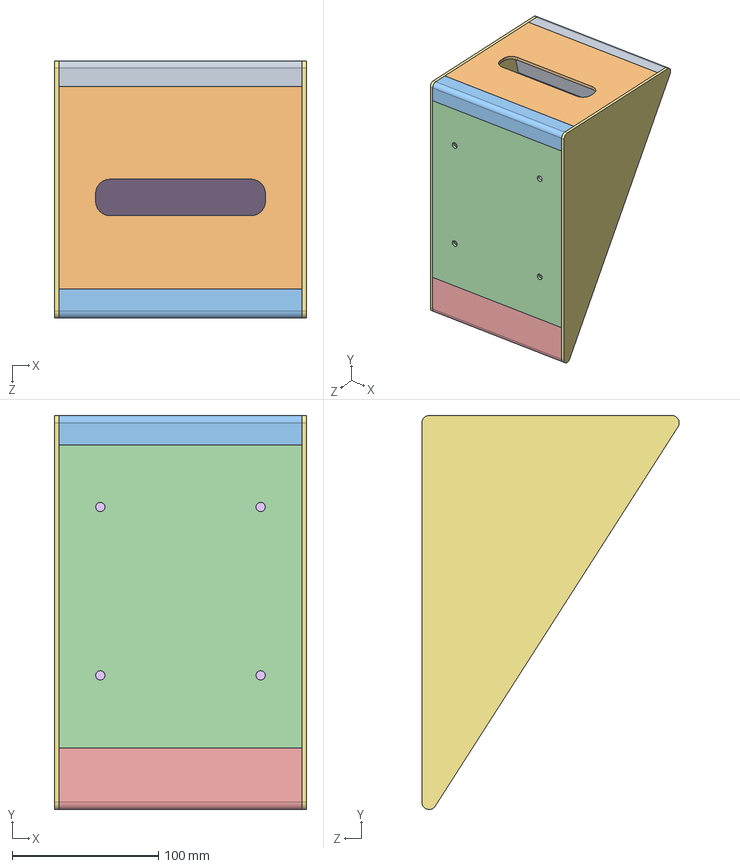
[picture p115: CAD file, 2020-11-19]
Wavemaker 3D Models/Wedge/Wedge.SLDASM
172.5 x 269.2 x 175.8 mm
Wedge_Top_Angle
Wedge_Top
Wedge_Top_90
Wedge_Back
Wedge_Bottom_Angle
Wedge_Front
Wedge_Side x 2
