MatthiasOPage/Wavemaker/Wavemaker 3D Models/Electronics/Boards/Mounted_Electronics_Assembly.SLDASM

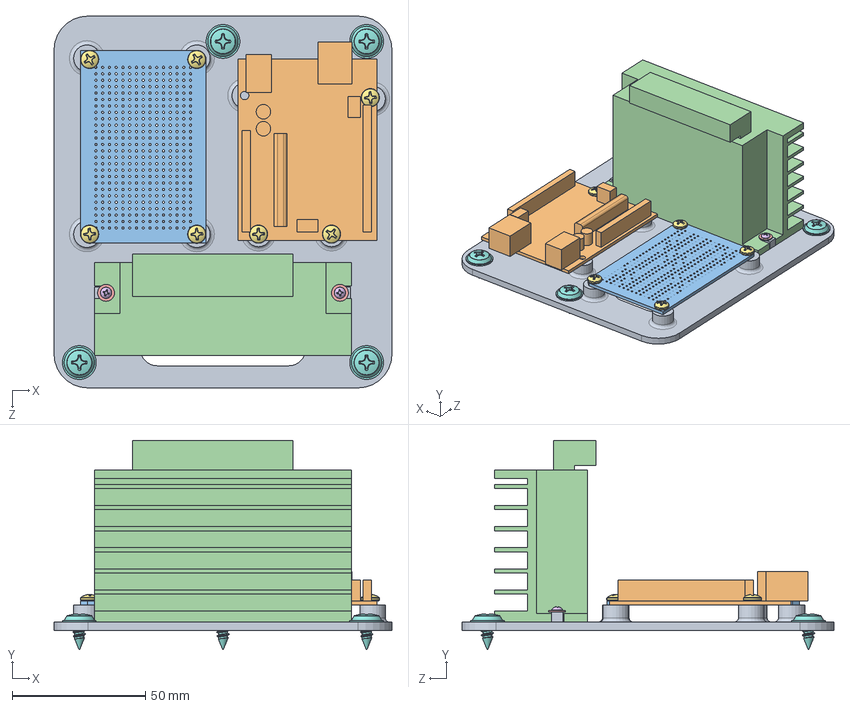
[picture p116: CAD file, 2020-11-25]
Wavemaker 3D Models/Electronics/Boards/Mounted_Electronics_Assembly.SLDASM
127.0 x 78.6 x 139.7 mm
Electronics_Mounting_Bracket
Arduino_Basic_Model
PCB_Basic
Controller_Basic_Model
MC_Washer x 2
MC_Screw x 2
Board_Screw x 7
Bracket_to_Wood_Screws x 4
