MatthiasOPage/Wavemaker/Wavemaker 3D Models/Electronics/Limits/Bottom_Limit_Assembly.SLDASM

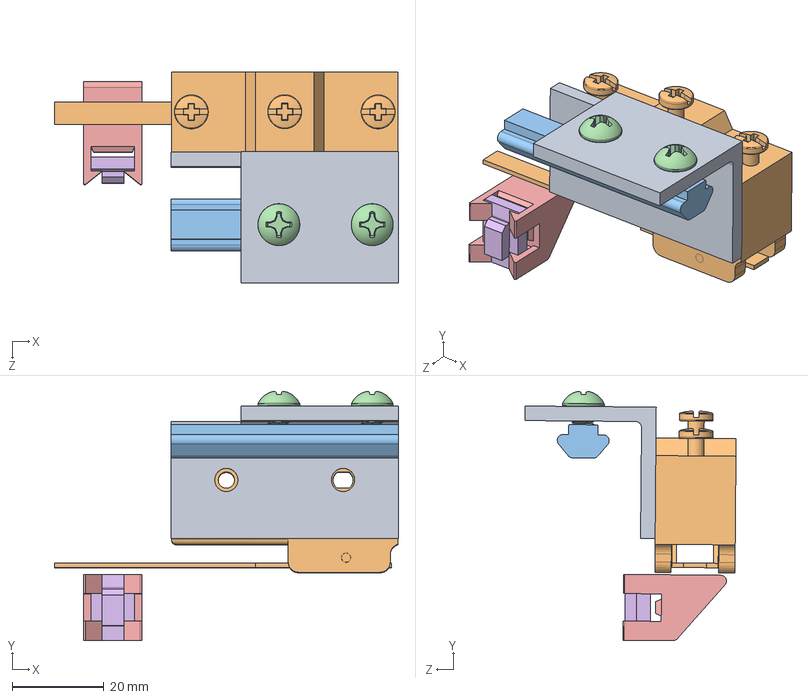
[picture p117: CAD file, 2020-11-25]
Wavemaker 3D Models/Electronics/Limits/Bottom_Limit_Assembly.SLDASM
74.9 x 54.3 x 46.0 mm
Bottom_Limit_Bracket
Limit_Switch_Bottom
Bottom_Limit_8020_Nut
Bottom_Limit_Bolt x 2
Limit_Clip_Outer
Limit_Clip_Inner
