MatthiasOPage/Wavemaker/Wavemaker 3D Models/Electronics/Shelf Brackets/PSU_Bracket_Assembly.SLDASM

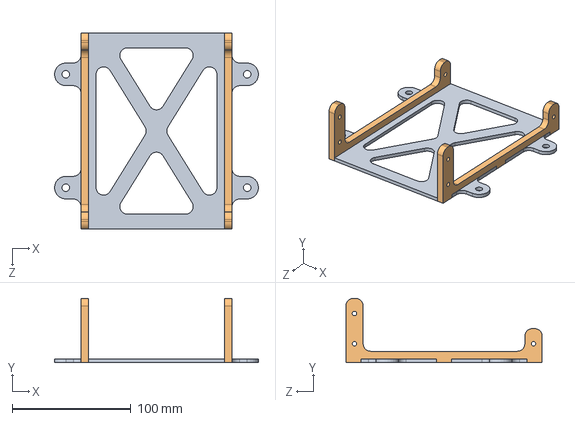
[picture p118: CAD file, 2020-11-25]
Wavemaker 3D Models/Electronics/Shelf Brackets/PSU_Bracket_Assembly.SLDASM
171.4 x 54.0 x 165.1 mm
PSU_Mounting_Plate_Revised
PSU_Bracket_Sides x 2
