MatthiasOPage/Wavemaker/Wavemaker 3D Models/Frame Hardware/Idlers/Back_Idler_Assembly.SLDASM

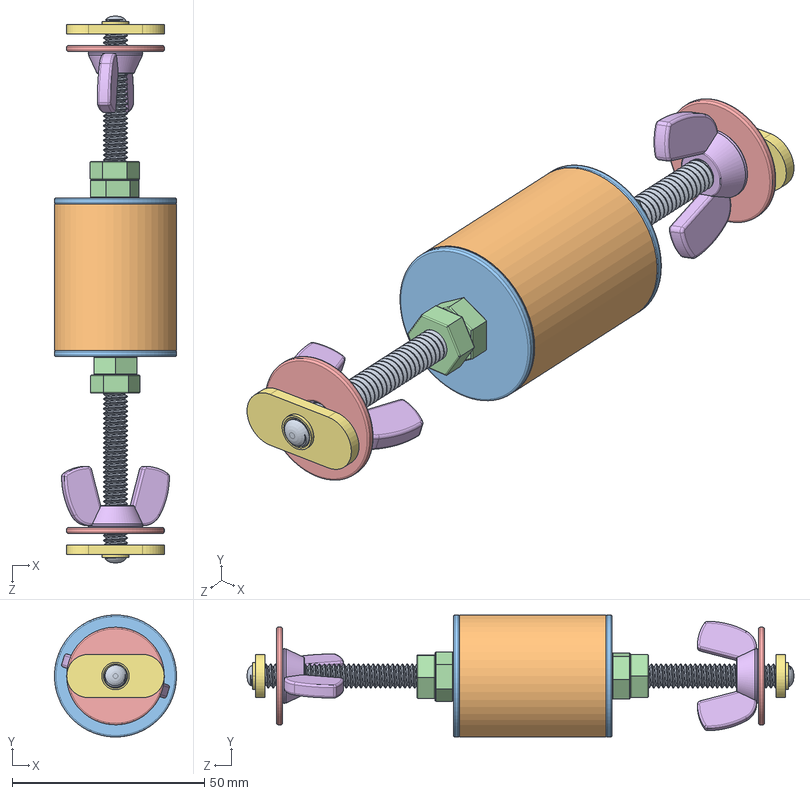
[picture p119: CAD file, 2020-11-25]
Wavemaker 3D Models/Frame Hardware/Idlers/Back_Idler_Assembly.SLDASM
31.7 x 31.7 x 142.2 mm
Idler_Threaded_Rod
Back_Idler_Delrin
1.25in_Washer x 2
7_16-1_4-20_Nut x 4
1in_Washer x 2
Plate_Wingnut x 2
1_4-20T_Nut x 2
