MatthiasOPage/Wavemaker/Wavemaker 3D Models/Frame Hardware/Top_Brace_Assembly.SLDASM

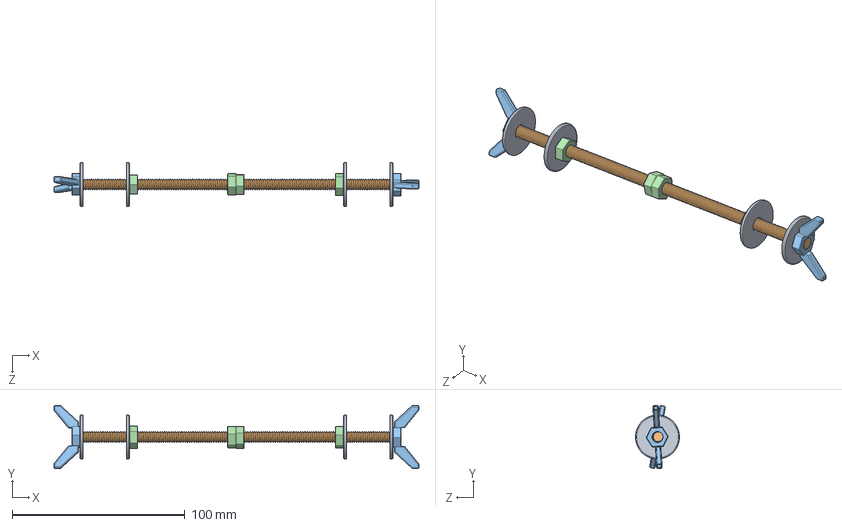
[picture p120: CAD file, 2020-11-25]
Wavemaker 3D Models/Frame Hardware/Top_Brace_Assembly.SLDASM
211.1 x 36.6 x 25.4 mm
1in_0.25_FenderWasher x 4
Top_Brace_Rod
7_16-1_4-20_WingNut x 2
7_16-1_4-20_Nut x 4
