MatthiasOPage/Wavemaker/Wavemaker 3D Models/Camera Gimbal/Z-Carriage/Z-Carriage_Left.SLDASM

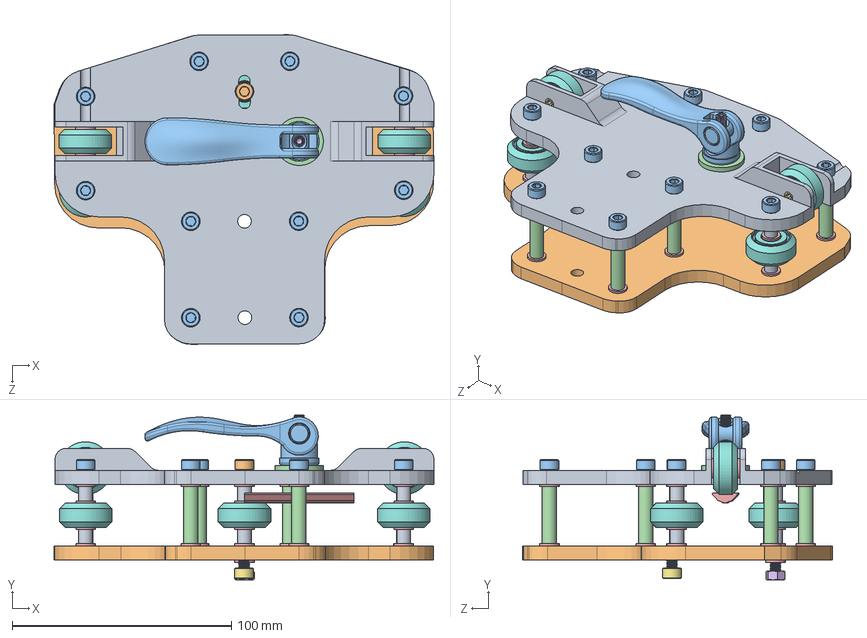
[picture p121: CAD file, 2021-02-03]
Wavemaker 3D Models/Camera Gimbal/Z-Carriage/Z-Carriage_Left.SLDASM
173.4 x 75.2 x 141.3 mm
Z_Carriage_Roller_Plate_Top_5mmHoles
Z_Carriage_Roller_Plate_Bottom_5mm
40mm_M5x0-8_Bolt x 10
Z-Carriage_Standoff x 8
M5_1mm_Washer x 33
8mm_M5x0-8_Nut x 12
18mm_M5x0-8_Setscrew x 2
Roller_Bearing_Actual x 5
Z-Carriage_Standoff_Bearing x 6
50mm_M5x0-8_Bolt
Cam_Lock_M5
M6_Fender_Washer
Cam_Lock_Nut
40mm_M5x0-8_Cam_Lock_Bolt
10mm_M5x0-8_Bolt
