MatthiasOPage/Wavemaker/Wavemaker 3D Models/Frame Hardware/Bottom_Brace_Assembly.SLDASM

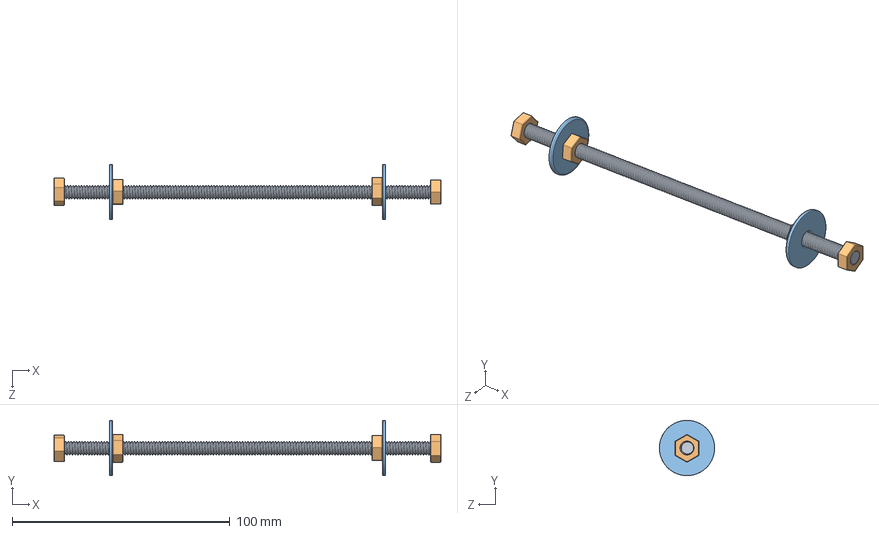
[picture p122: CAD file, 2020-11-25]
Wavemaker 3D Models/Frame Hardware/Bottom_Brace_Assembly.SLDASM
177.8 x 25.4 x 25.4 mm
Bottom_Brace_Rod
7_16-1_4-20_Nut x 4
1in_0.25_FenderWasher x 2
