MatthiasOPage/Wavemaker/Wavemaker 3D Models/Basic Models/Electronics_Shelf_Assembly.SLDASM

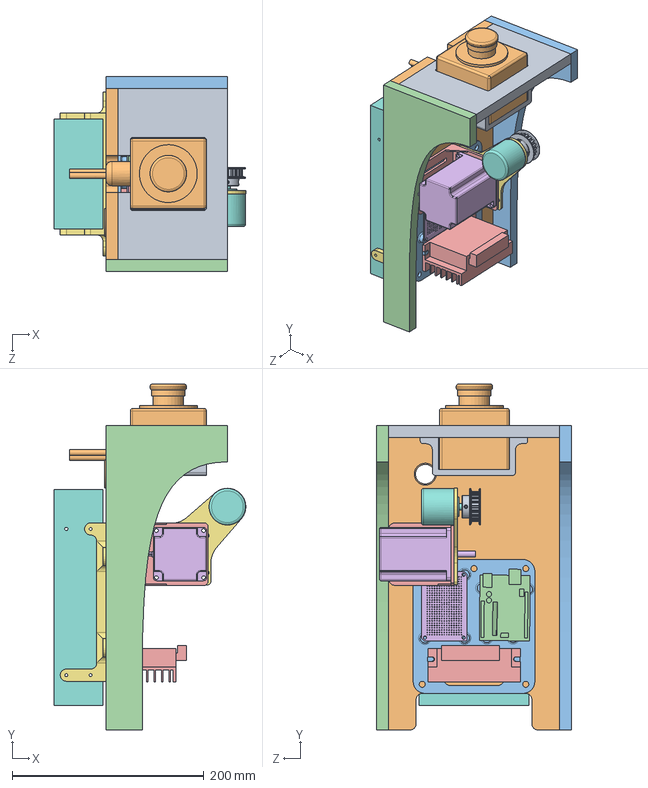
[picture p123: CAD file, 2020-11-19]
Wavemaker 3D Models/Basic Models/Electronics_Shelf_Assembly.SLDASM
199.9 x 360.7 x 203.2 mm
Electronics_Bracket_Top_Plate
Electronics_Bracket_Front_Plate
Electronics_Bracket_Side_Brackets_Left
Electronics_Bracket_Side_Brackets_Right
Motor_Bracket_Basic
Motor_Basic
PSU_Mounting_Plate
PSU_Basic_Model
Button_Bracket
Button_Basic_Model
Electronics_Mounting_Bracket
Arduino_Basic_Model
Controller_Basic_Model
PCB_Basic
Rotary_Encoder_Bracket
Rotary_Encoder_Basic
Rotary_Encoder_Timing_Pulley
Button_Spacer
