MatthiasOPage/Wavemaker/Wavemaker 3D Models/Camera Gimbal/Z-Carriage/Side_Bearing_Assembly.SLDASM

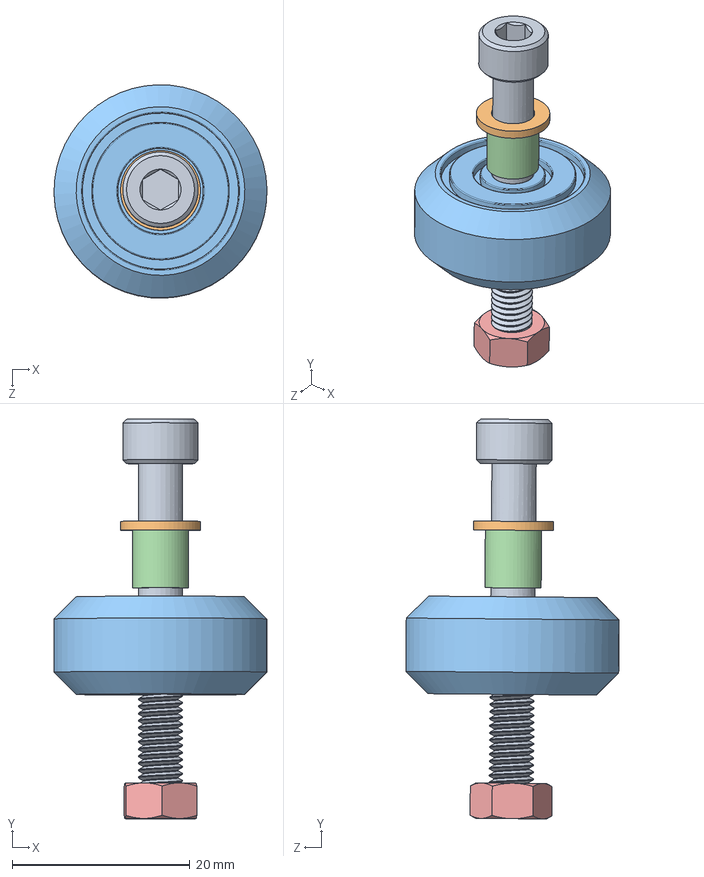
[picture p124: CAD file, 2021-02-03]
Wavemaker 3D Models/Camera Gimbal/Z-Carriage/Side_Bearing_Assembly.SLDASM
24.0 x 45.1 x 24.0 mm
40mm_M5x0-8_Bolt
M5_1mm_Washer
Roller_Bearing_Actual
Z-Carriage_Standoff_Bearing
8mm_M5x0-8_Nut
