MatthiasOPage/Wavemaker/Wavemaker 3D Models/Camera Gimbal/Y-Rotation/Squash_Plate_Assembly.SLDASM

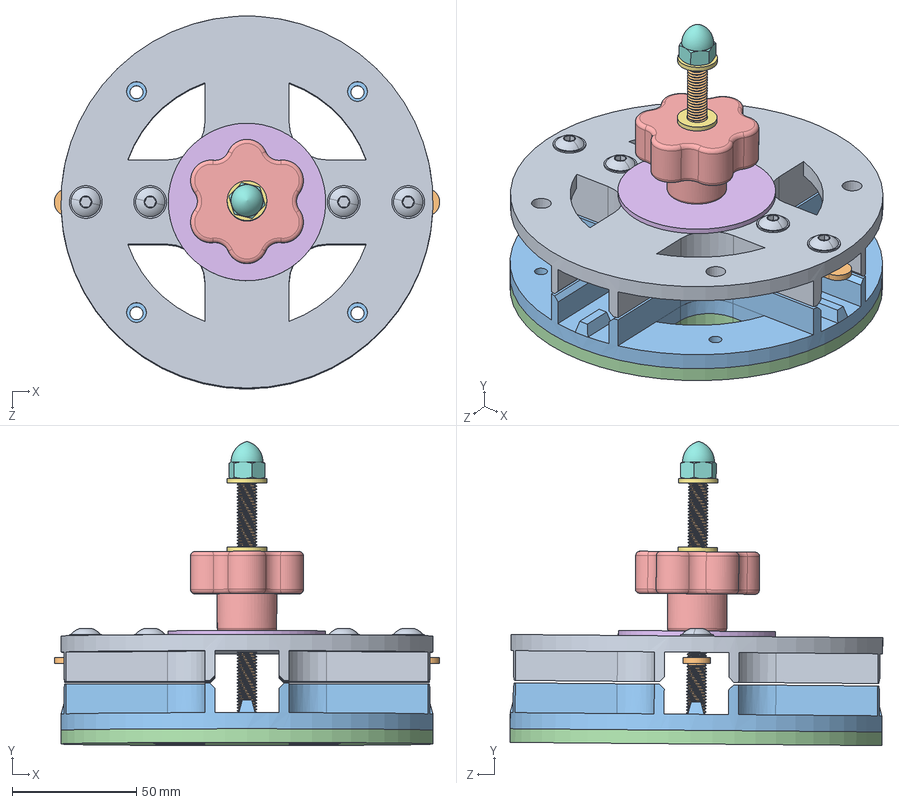
[picture p125: CAD file, 2021-02-03]
Wavemaker 3D Models/Camera Gimbal/Y-Rotation/Squash_Plate_Assembly.SLDASM
155.4 x 122.6 x 150.4 mm
Top_Disk
M8_Pivot_Bolt
Bottom_Disk
Bottom_Disk_Bolt_Sink
M8_Knob
2in_Washer
M8_Washer x 2
M8_Cap_Nut
1_4-20x.5_Flange x 4
1_4-20T_Nut x 4
M8_Fender_Washer-24mmOD
