MatthiasOPage/Wavemaker/Wavemaker 3D Models/Tank Cart/CartSuperAssembly.SLDASM

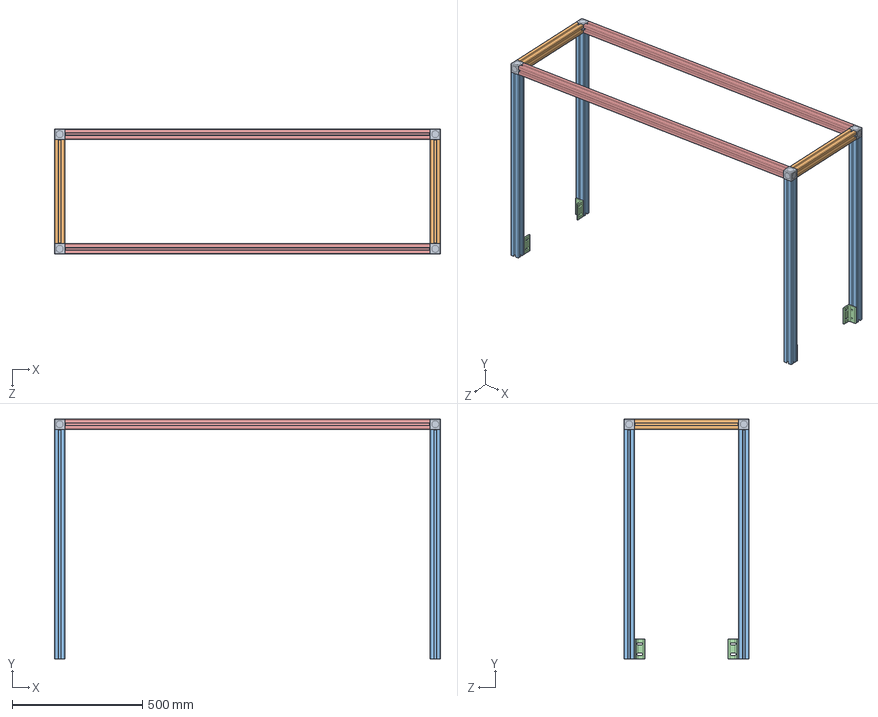
[picture p126: CAD file, 2020-11-25]
Wavemaker 3D Models/Tank Cart/CartSuperAssembly.SLDASM
1480.0 x 920.0 x 480.0 mm
40S-48cm x 2
40S-88cm x 4
40S-140cmSuper x 2
