MatthiasOPage/Wavemaker/Wavemaker 3D Models/Mounting Plate/Plate Hardware/Plate_Hardware_Assembly.SLDASM

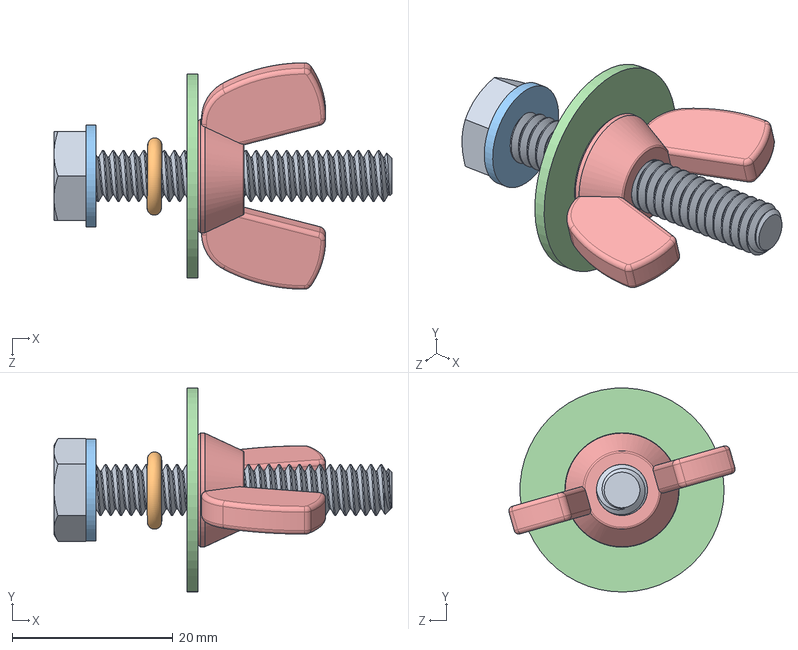
[picture p127: CAD file, 2020-11-19]
Wavemaker 3D Models/Mounting Plate/Plate Hardware/Plate_Hardware_Assembly.SLDASM
42.1 x 25.4 x 28.2 mm
Plate_Bolt
O-ring
Plate_Side_Washer
Wedge_Side_Washer
Plate_Wingnut
