MatthiasOPage/Wavemaker/Wavemaker 3D Models/Basic Models/Electronics_Assembly.SLDASM

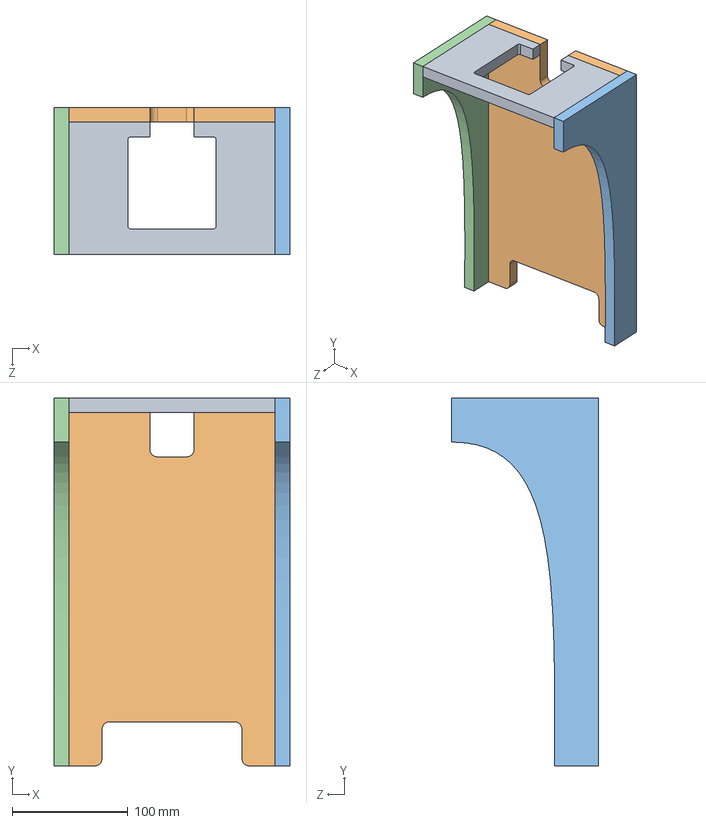
[picture p128: CAD file, 2020-11-19]
Wavemaker 3D Models/Basic Models/Electronics_Assembly.SLDASM
203.2 x 317.5 x 127.0 mm
Electronics_Bracket_Top_Plate
Electronics_Bracket_Front_Plate
Electronics_Bracket_Side_Brackets_Left
Electronics_Bracket_Side_Brackets_Right
