MatthiasOPage/Wavemaker/Wavemaker 3D Models/Camera Gimbal/Z-Rotation/Hardware_M5/Pivot_Joints.SLDASM

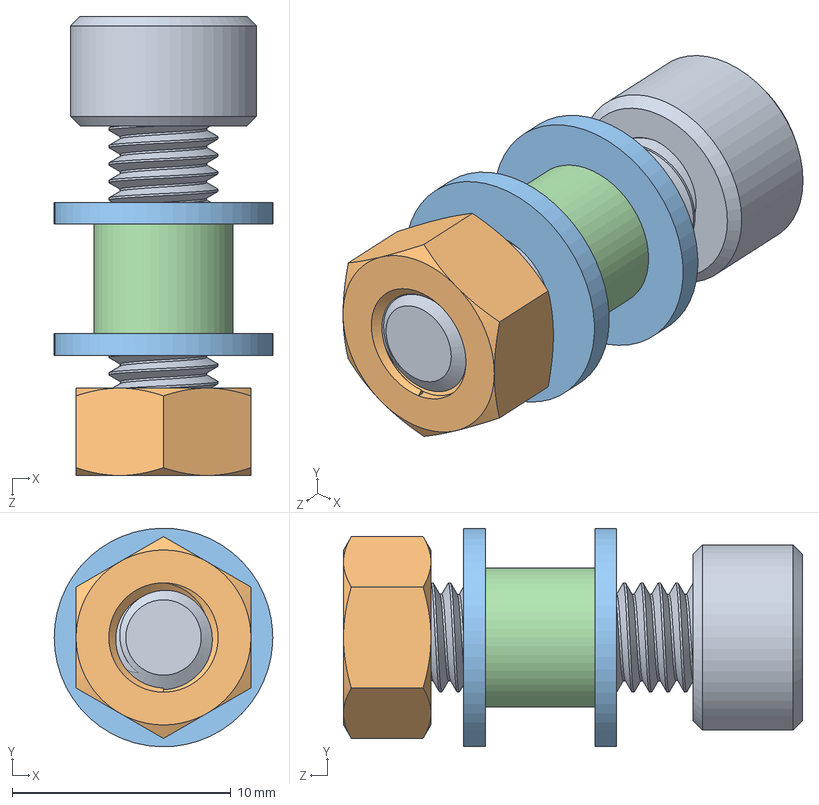
[picture p129: CAD file, 2021-02-03]
Wavemaker 3D Models/Camera Gimbal/Z-Rotation/Hardware_M5/Pivot_Joints.SLDASM
10.0 x 10.00 x 21.0 mm
16mm_M5x0-8
8mm_M5x0-8_Nut
5-3_IDx10mm_OD_Washer x 2
5mm_Bushing
