MatthiasOPage/Wavemaker/Wavemaker 3D Models/Motor/Motor_Assembly.SLDASM

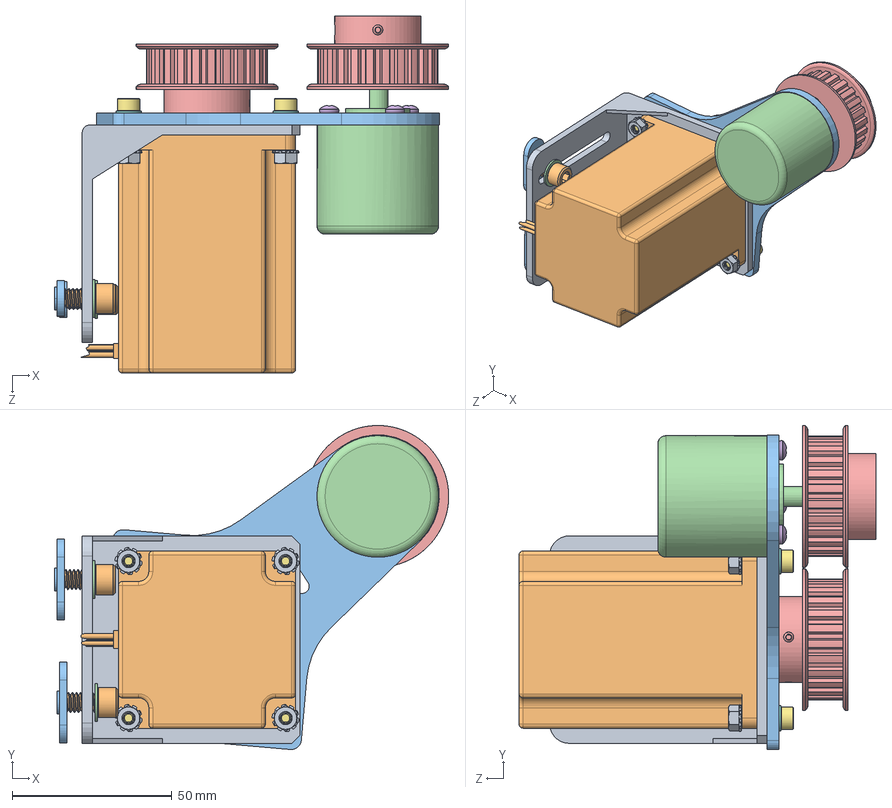
[picture p130: CAD file, 2020-11-25]
Wavemaker 3D Models/Motor/Motor_Assembly.SLDASM
123.6 x 101.6 x 111.9 mm
Motor_Bracket_Basic
Motor_Basic
Rotary_Encoder_Bracket
Rotary_Encoder_Basic
Timing_Pulley x 2
Rotary_Encoder_Bolts_M3x8 x 3
Plate_Bolts_M4x15mm x 4
Plate_Washers_8x4.3mm x 4
Plate_Nut_M4x0.7 x 4
Frame_Bolt_0.25-20x0.5 x 2
1_4-20T_Nut x 2
Frame_Washer_0.255x0.468 x 2
