MatthiasOPage/Wavemaker/Wavemaker 3D Models/Camera Gimbal/Z-Carriage/Cam_Lock_Assembly.SLDASM

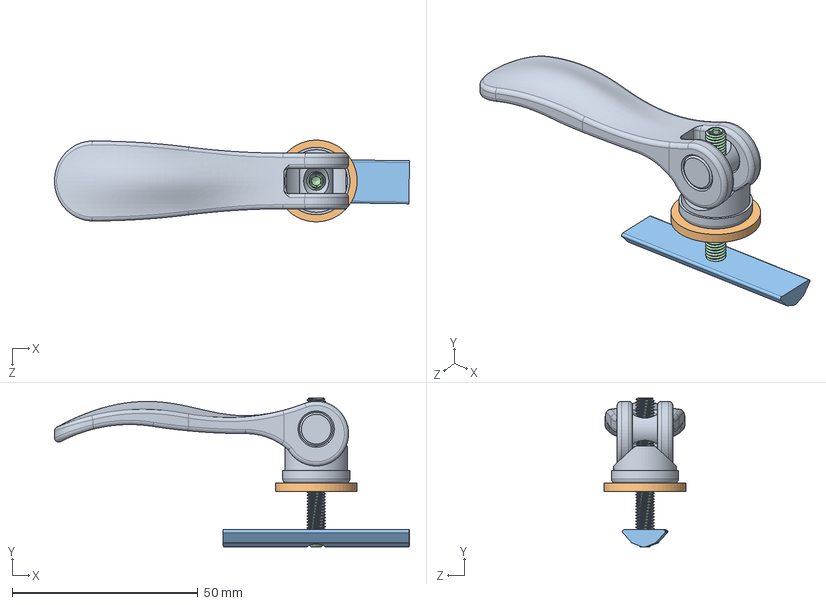
[picture p131: CAD file, 2021-02-03]
Wavemaker 3D Models/Camera Gimbal/Z-Carriage/Cam_Lock_Assembly.SLDASM
95.5 x 40.1 x 22.0 mm
Cam_Lock_M5
M6_Fender_Washer
Cam_Lock_Nut
40mm_M5x0-8_Cam_Lock_Bolt
