MatthiasOPage/Wavemaker/Wavemaker 3D Models/Basic Models/Frame_Assembly.SLDASM

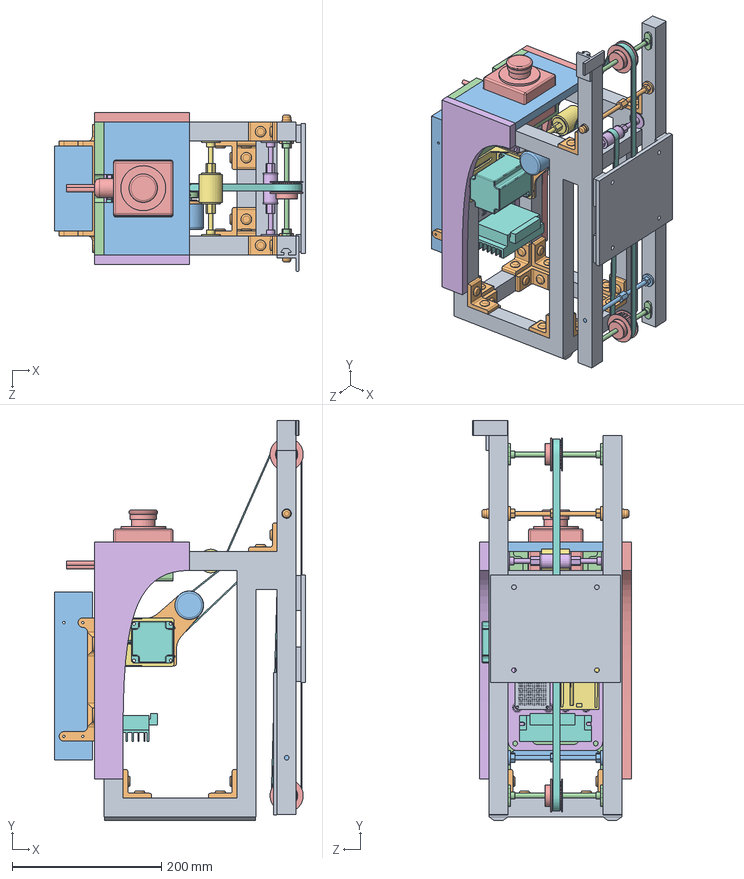
[picture p132: CAD file, 2020-11-19]
Wavemaker 3D Models/Basic Models/Frame_Assembly.SLDASM
336.5 x 535.9 x 212.5 mm
Frame_Basic_Model
Frame_Brackets_Basic x 16
Electronics_Bracket_Top_Plate
Electronics_Bracket_Front_Plate
Electronics_Bracket_Side_Brackets_Left
Electronics_Bracket_Side_Brackets_Right
Motor_Bracket_Basic
Motor_Basic
Limit_Bracket_Basic
Frame_Brace_Top
Frame_Brace_Bottom
Idler_Shafts_Basic x 2
Belt_Pulley_Basic x 3
Idler_Basic
Front_Idler_Basic
Belt_Basic
PSU_Mounting_Plate
PSU_Basic_Model
Button_Bracket
Button_Basic_Model
Electronics_Mounting_Bracket
Arduino_Basic_Model
Controller_Basic_Model
PCB_Basic
Rotary_Encoder_Bracket
Rotary_Encoder_Basic
Rotary_Encoder_Timing_Pulley
