MatthiasOPage/Wavemaker/Wavemaker 3D Models/Camera Gimbal/Z-Rotation/Pre-M5/Joint_Fastner_Assem.SLDASM

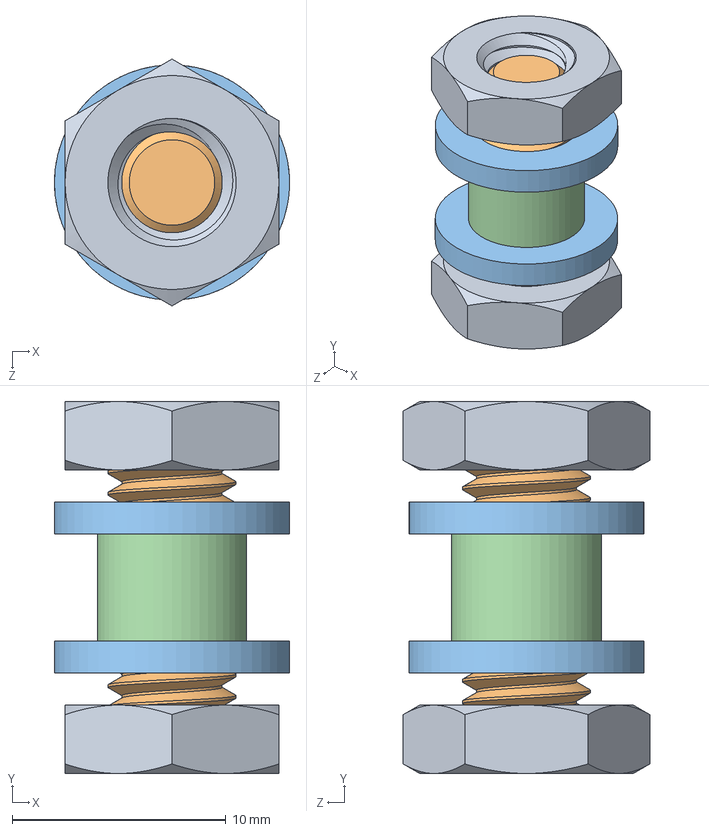
[picture p133: CAD file, 2021-02-03]
Wavemaker 3D Models/Camera Gimbal/Z-Rotation/Pre-M5/Joint_Fastner_Assem.SLDASM
11.0 x 17.4 x 11.5 mm
M6_Shallow_Nuts x 2
Pivot_Bolts
Pivot_Washers x 2
Joint_Bushing
