MatthiasOPage/Wavemaker/Wavemaker 3D Models/Tank Cart/CartSubAssemblySupported.SLDASM

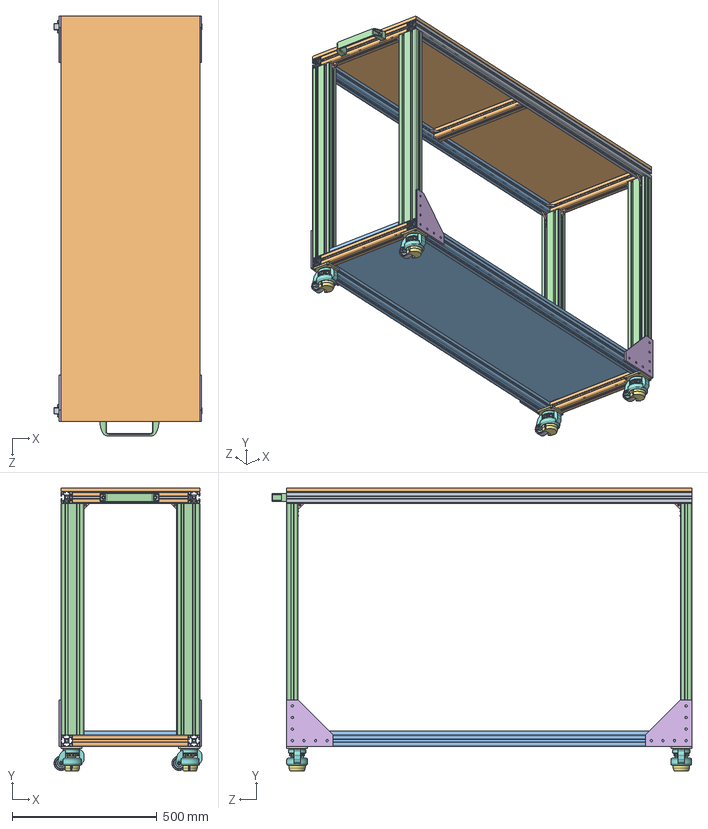
[picture p134: CAD file, 2020-11-25]
Wavemaker 3D Models/Tank Cart/CartSubAssemblySupported.SLDASM
511.0 x 977.5 x 1450.0 mm
40S-120cm
40S-40cm x 5
40S-140cm x 3
4080S-80cm x 4
_65_2714_plate_2 x 4
_65_2714_body_4 x 4
_65_2714_wheel_6 x 4
CartTop
CartBase
