MatthiasOPage/Wavemaker/Wavemaker 3D Models/Tank Cart/CartSubAssembly.SLDASM

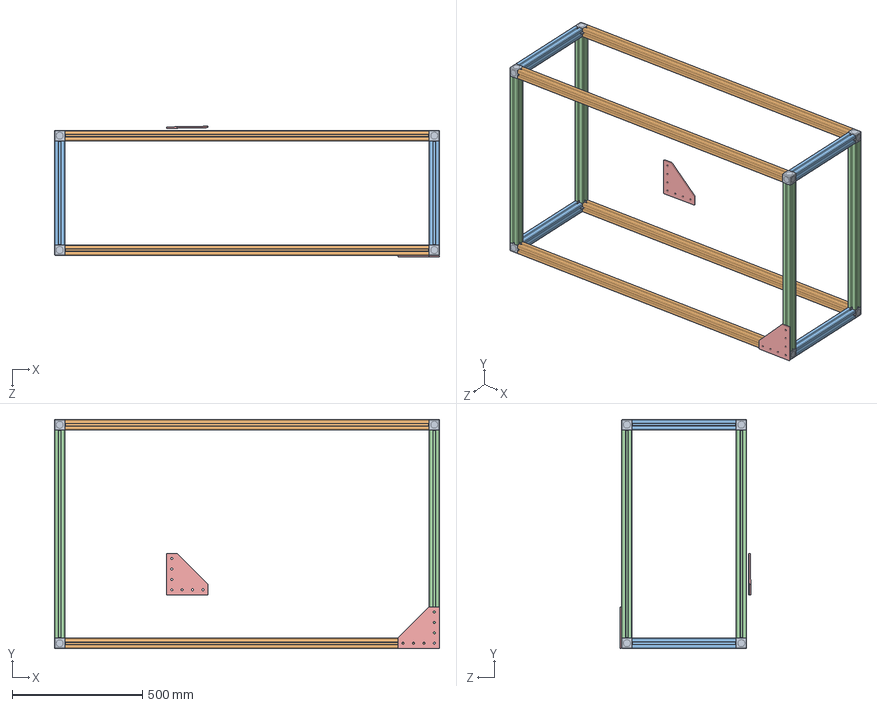
[picture p135: CAD file, 2020-11-25]
Wavemaker 3D Models/Tank Cart/CartSubAssembly.SLDASM
1480.0 x 880.4 x 502.3 mm
40S-140cm x 4
40S-40cm x 4
40S-80cm x 4
