MatthiasOPage/Wavemaker/Wavemaker 3D Models/Frame Hardware/Corner_Brackets_Assembly.SLDASM

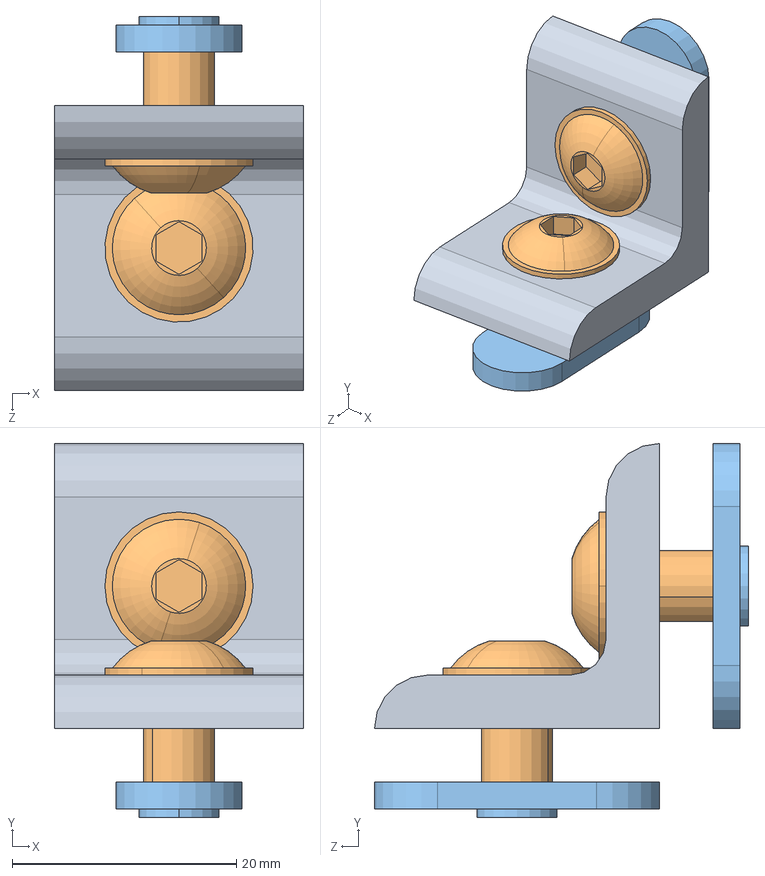
[picture p136: CAD file, 2020-11-19]
Wavemaker 3D Models/Frame Hardware/Corner_Brackets_Assembly.SLDASM
22.2 x 33.3 x 33.3 mm
2_Hole_Corner_Bracket
1_4-20x.5_Flange x 2
1_4-20T_Nut x 2
