MatthiasOPage/Wavemaker/Wavemaker 3D Models/Camera Gimbal/Z-Carriage/Top_Bearing_Assembly.SLDASM

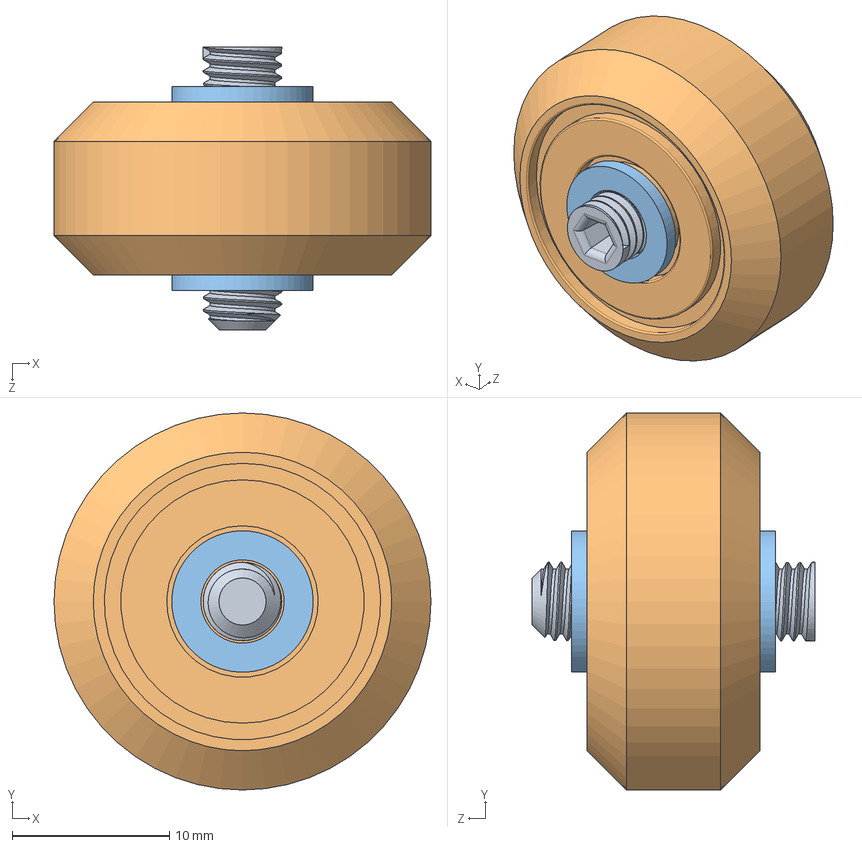
[picture p137: CAD file, 2021-02-03]
Wavemaker 3D Models/Camera Gimbal/Z-Carriage/Top_Bearing_Assembly.SLDASM
24.0 x 24.0 x 18.0 mm
18mm_M5x0-8_Setscrew
Roller_Bearing_Actual
M5_1mm_Washer x 2
