MatthiasOPage/Wavemaker/Wavemaker 3D Models/Camera Gimbal/Z-Carriage/Idler_Bearing_Assembly.SLDASM

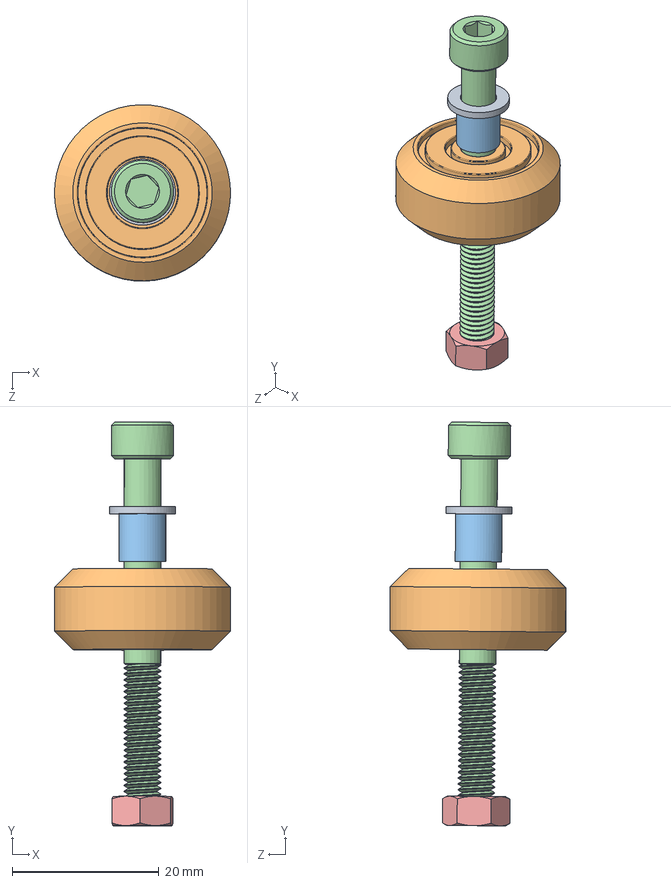
[picture p138: CAD file, 2021-02-03]
Wavemaker 3D Models/Camera Gimbal/Z-Carriage/Idler_Bearing_Assembly.SLDASM
24.0 x 55.1 x 24.0 mm
M5_1mm_Washer
Roller_Bearing_Actual
Z-Carriage_Standoff_Bearing
50mm_M5x0-8_Bolt
8mm_M5x0-8_Nut
