MatthiasOPage/Wavemaker/Wavemaker 3D Models/3D Printer Files/Electronics_Mounting_Bracket.STL

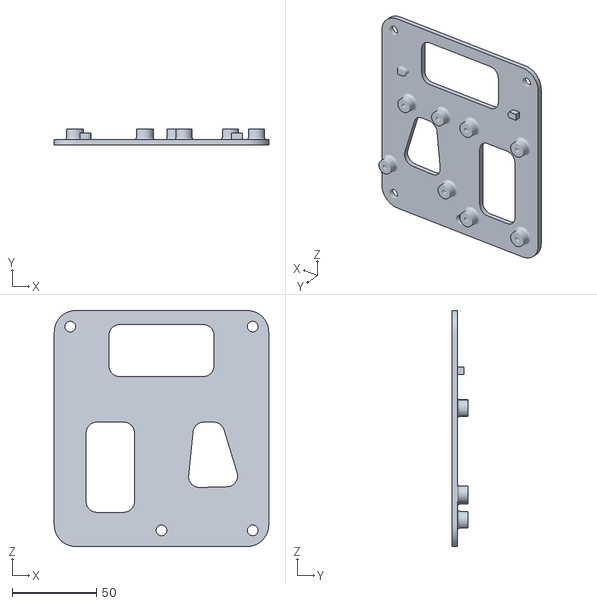
[picture p139: CAD file, 2020-11-19]
Wavemaker 3D Models/3D Printer Files/Electronics_Mounting_Bracket.STL
127.0 x 9.53 x 139.7
