MatthiasOPage/Wavemaker/Wavemaker 3D Models/3D_Printer_Files/Wedge_Top_Angle.STL

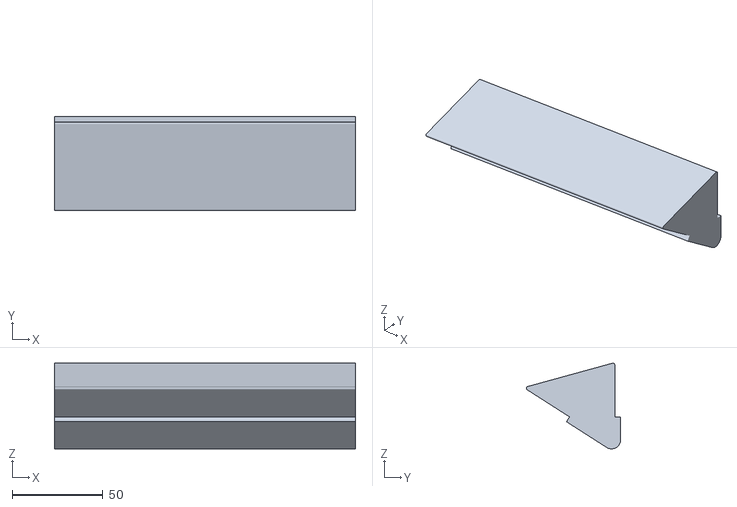
[picture p140: CAD file, 2020-11-19]
Wavemaker 3D Models/3D_Printer_Files/Wedge_Top_Angle.STL
166.1 x 52.0 x 47.3
