MatthiasOPage/Wavemaker/Wavemaker 3D Models/Basic Models/Frame_Basic_Model.SLDPRT

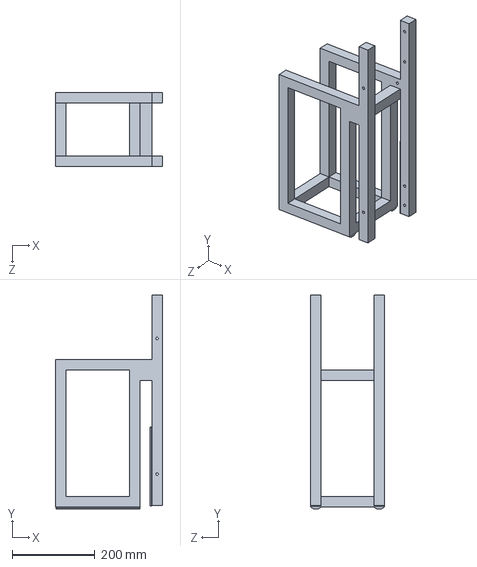
[picture p141: CAD file, 2020-11-19]
Wavemaker 3D Models/Basic Models/Frame_Basic_Model.SLDPRT
257.2 x 515.9 x 177.8 mm
