MatthiasOPage/Wavemaker/Wavemaker 3D Models/Camera Gimbal/3D Printer Files/Z_Carriage_Roller_Plate_Bottom_5mm.STL

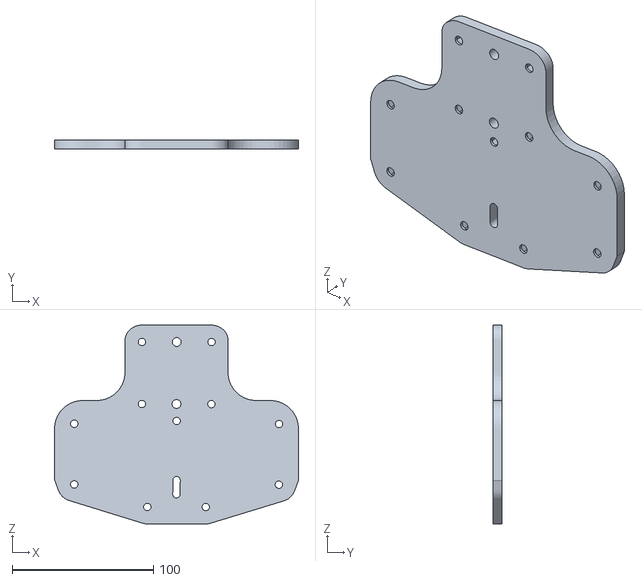
[picture p142: CAD file, 2021-02-03]
Wavemaker 3D Models/Camera Gimbal/3D Printer Files/Z_Carriage_Roller_Plate_Bottom_5mm.STL
173.0 x 6.50 x 141.1
