MatthiasOPage/Wavemaker/Wavemaker 3D Models/Camera Gimbal/X-Translation/Center_Brace_Mount.SLDPRT

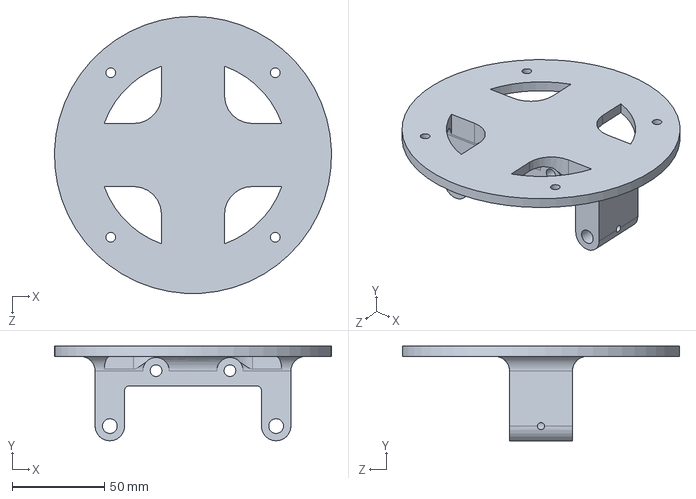
[picture p143: CAD file, 2021-02-03]
Wavemaker 3D Models/Camera Gimbal/X-Translation/Center_Brace_Mount.SLDPRT
149.9 x 51.3 x 150.0 mm
