MatthiasOPage/Wavemaker/Wavemaker 3D Models/Camera Gimbal/Z-Rotation/Hardware_M5/Spring.SLDPRT

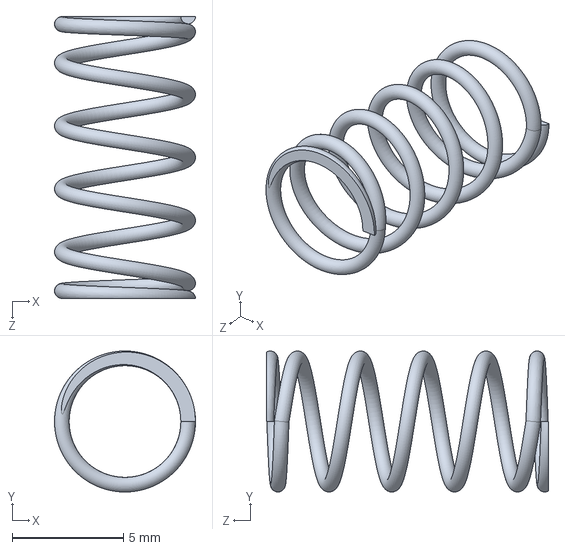
[picture p144: CAD file, 2021-02-03]
Wavemaker 3D Models/Camera Gimbal/Z-Rotation/Hardware_M5/Spring.SLDPRT
6.35 x 6.35 x 12.7 mm
