MatthiasOPage/Wavemaker/Wavemaker 3D Models/Electronics Shelf/Shelf Frame/Electronics_Bracket_Side_Brackets_Right.SLDPRT

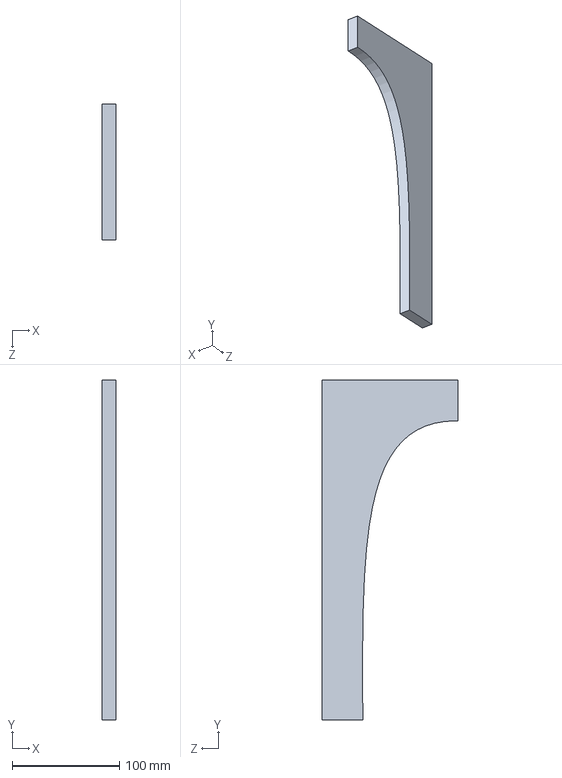
[picture p145: CAD file, 2020-11-19]
Wavemaker 3D Models/Electronics Shelf/Shelf Frame/Electronics_Bracket_Side_Brackets_Right.SLDPRT
12.7 x 317.5 x 127.0 mm
