MatthiasOPage/Wavemaker/Wavemaker 3D Models/Electronics/Boards/Controller_Basic_Model.SLDPRT

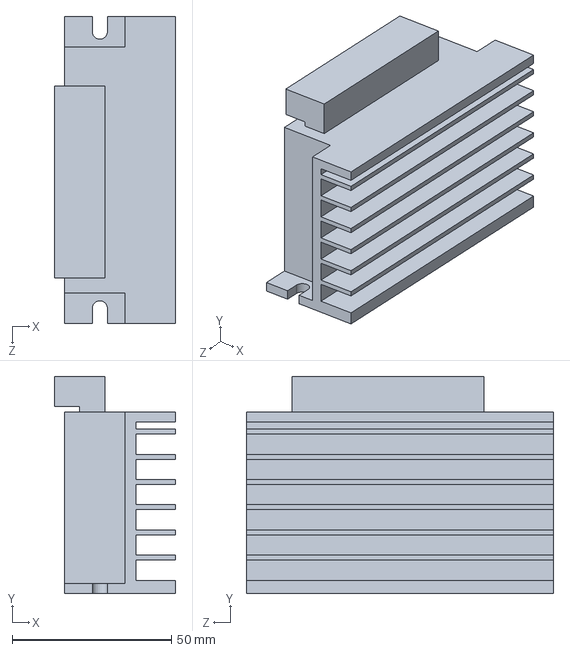
[picture p146: CAD file, 2020-11-25]
Wavemaker 3D Models/Electronics/Boards/Controller_Basic_Model.SLDPRT
38.1 x 68.3 x 96.5 mm
