MatthiasOPage/Wavemaker/Wavemaker 3D Models/Electronics/Button/Button_Basic_Model.SLDPRT

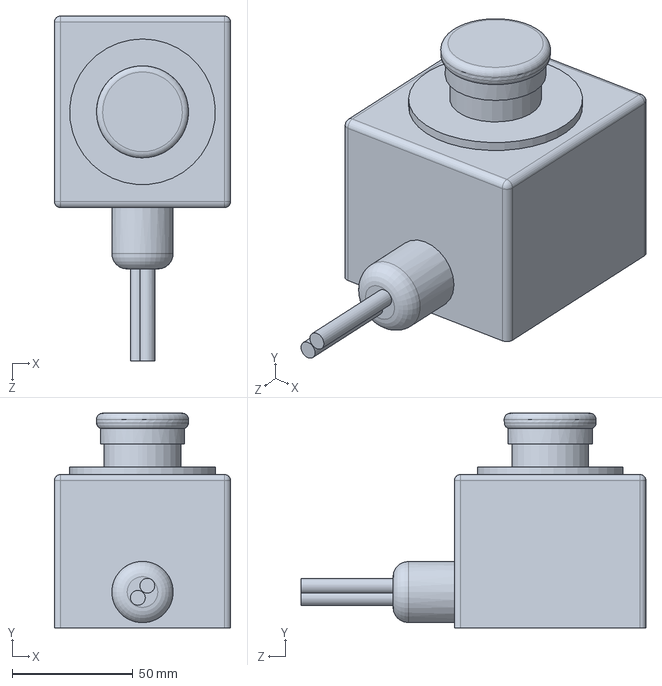
[picture p147: CAD file, 2020-11-19]
Wavemaker 3D Models/Electronics/Button/Button_Basic_Model.SLDPRT
73.0 x 88.9 x 142.9 mm
