MatthiasOPage/Wavemaker/Wavemaker 3D Models/Frame Hardware/Pulley_Belt_Basic.SLDPRT

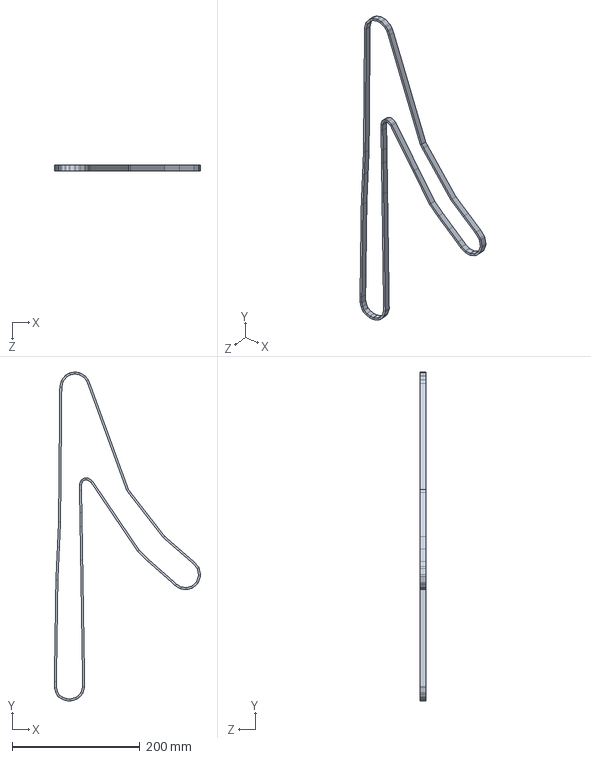
[picture p148: CAD file, 2020-11-25]
Wavemaker 3D Models/Frame Hardware/Pulley_Belt_Basic.SLDPRT
228.9 x 514.9 x 9.52 mm
