MatthiasOPage/Wavemaker/Wavemaker 3D Models/Laser_Cutter_Templates/Wedge_Template_2.DXF

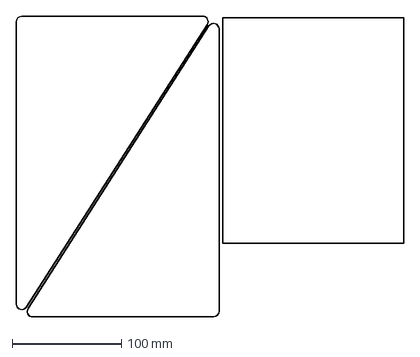
[picture p149: CAD file, 2020-11-19]
Wavemaker 3D Models/Laser_Cutter_Templates/Wedge_Template_2.DXF
355.3 x 275.7 mm
