MatthiasOPage/Wavemaker/Wavemaker 3D Models/Mounting Plate/Plate Hardware/Plate_Wingnut.SLDPRT

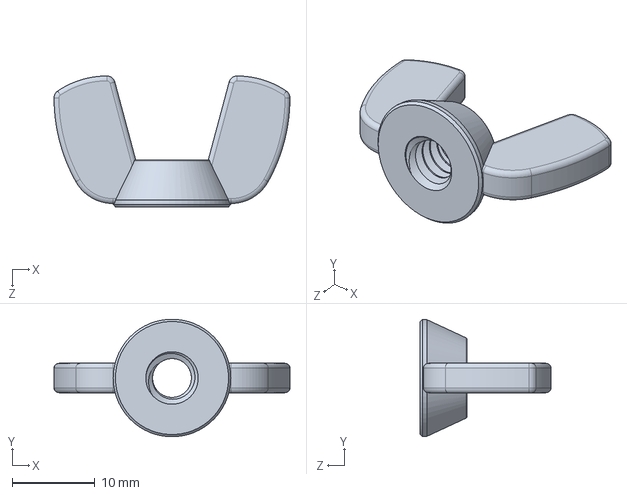
[picture p150: CAD file, 2020-11-19]
Wavemaker 3D Models/Mounting Plate/Plate Hardware/Plate_Wingnut.SLDPRT
28.6 x 14.2 x 15.9 mm
