MatthiasOPage/Wavemaker/Wavemaker 3D Models/Tank Cart/40S-80cm.SLDPRT

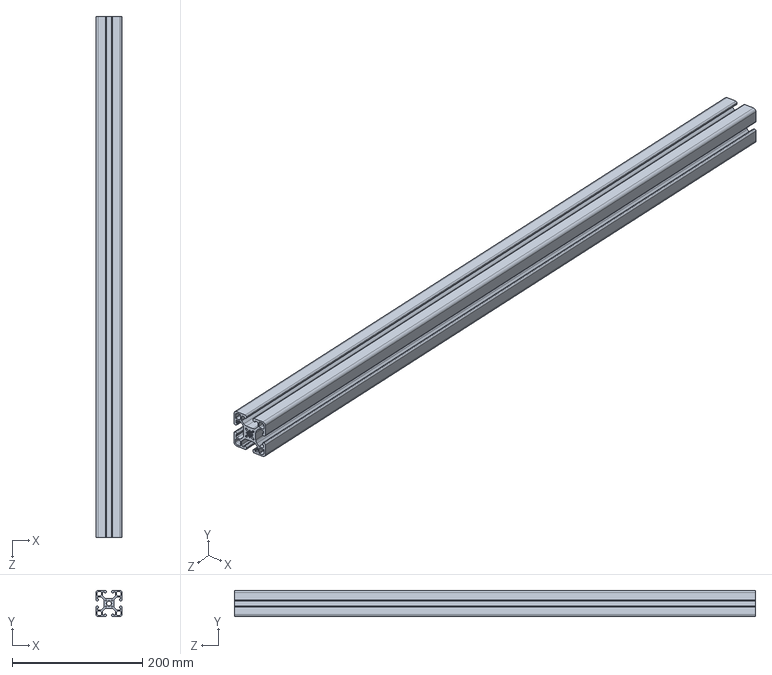
[picture p151: CAD file, 2020-11-25]
Wavemaker 3D Models/Tank Cart/40S-80cm.SLDPRT
40.0 x 40.0 x 800.0 mm
