MatthiasOPage/Wavemaker/Wavemaker 3D Models/Tank Cart/SLDPRT_40_Series/40_Series/40-4003-BLACK-FB.sldprt

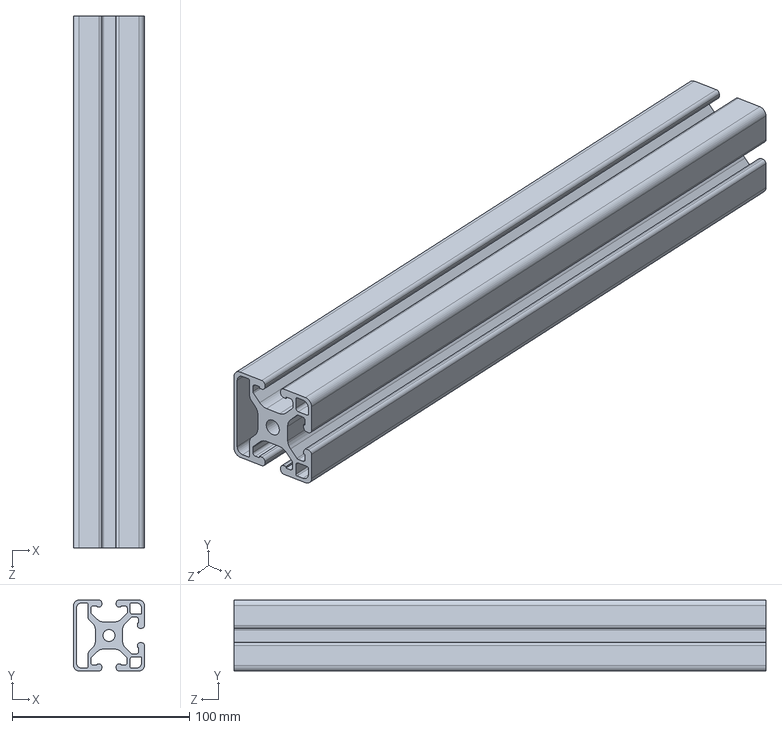
[picture p152: CAD file, 2020-11-25]
Wavemaker 3D Models/Tank Cart/SLDPRT_40_Series/40_Series/40-4003-BLACK-FB.sldprt
40.0 x 40.0 x 300.0 mm
