MatthiasOPage/Wavemaker/Wavemaker 3D Models/3D Printer Files/Rotary_Encoder_Bracket.STL

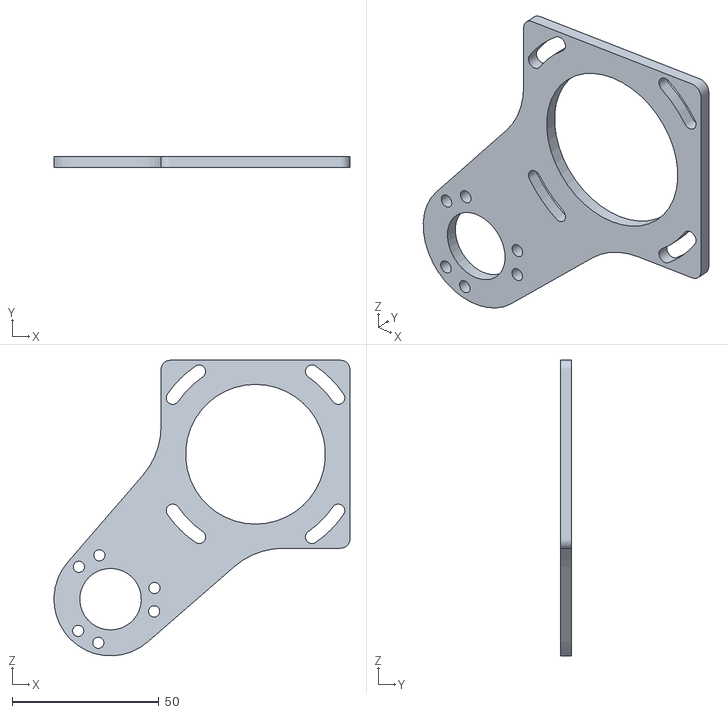
[picture p153: CAD file, 2020-11-19]
Wavemaker 3D Models/3D Printer Files/Rotary_Encoder_Bracket.STL
100.9 x 3.68 x 100.7
