MatthiasOPage/Wavemaker/Wavemaker 3D Models/3D_Printer_Files/Wedge_Bottom_Angle.STL

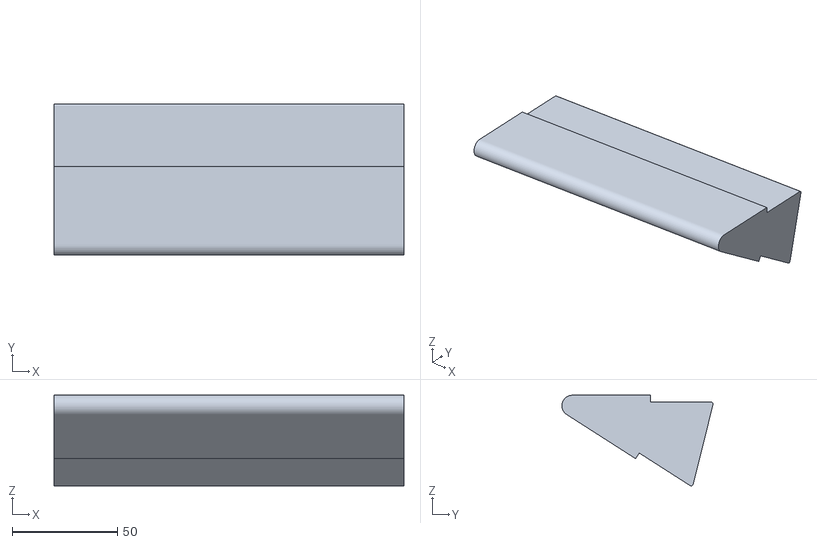
[picture p154: CAD file, 2020-11-19]
Wavemaker 3D Models/3D_Printer_Files/Wedge_Bottom_Angle.STL
166.1 x 71.8 x 43.0
