MatthiasOPage/Wavemaker/Wavemaker 3D Models/Basic Models/Frame_Brace_Bottom.SLDPRT

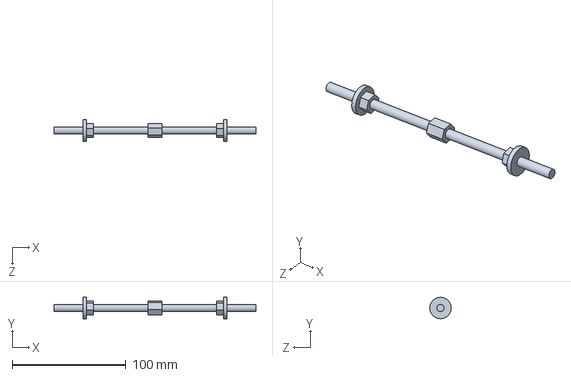
[picture p155: CAD file, 2020-11-19]
Wavemaker 3D Models/Basic Models/Frame_Brace_Bottom.SLDPRT
177.8 x 19.1 x 19.1 mm
