MatthiasOPage/Wavemaker/Wavemaker 3D Models/Camera Gimbal/3D Printer Files/Z_Carriage_Roller_Plate_Top_5mmHoles.STL

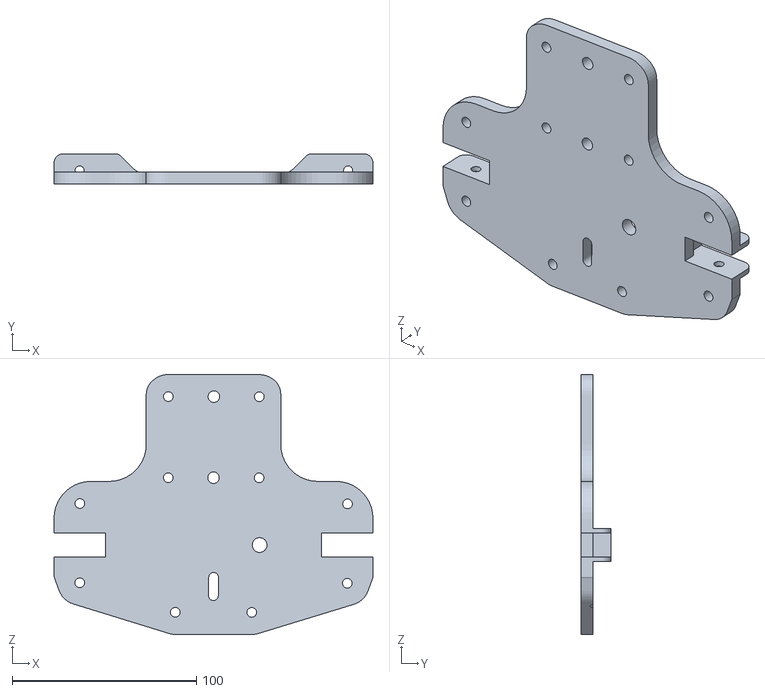
[picture p156: CAD file, 2021-02-03]
Wavemaker 3D Models/Camera Gimbal/3D Printer Files/Z_Carriage_Roller_Plate_Top_5mmHoles.STL
173.0 x 16.5 x 141.1
