MatthiasOPage/Wavemaker/Wavemaker 3D Models/Camera Gimbal/X-Translation/Rod_Endcaps.SLDPRT

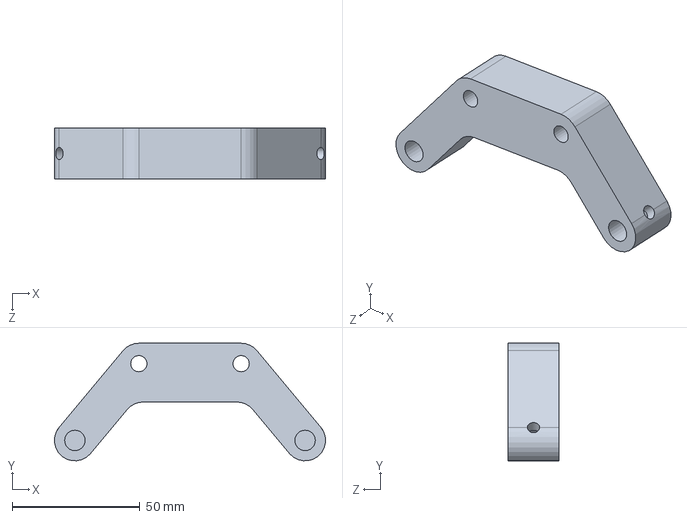
[picture p157: CAD file, 2021-02-03]
Wavemaker 3D Models/Camera Gimbal/X-Translation/Rod_Endcaps.SLDPRT
105.9 x 46.0 x 20.0 mm
