MatthiasOPage/Wavemaker/Wavemaker 3D Models/Camera Gimbal/Z-Rotation/Camera_Appr.SLDPRT

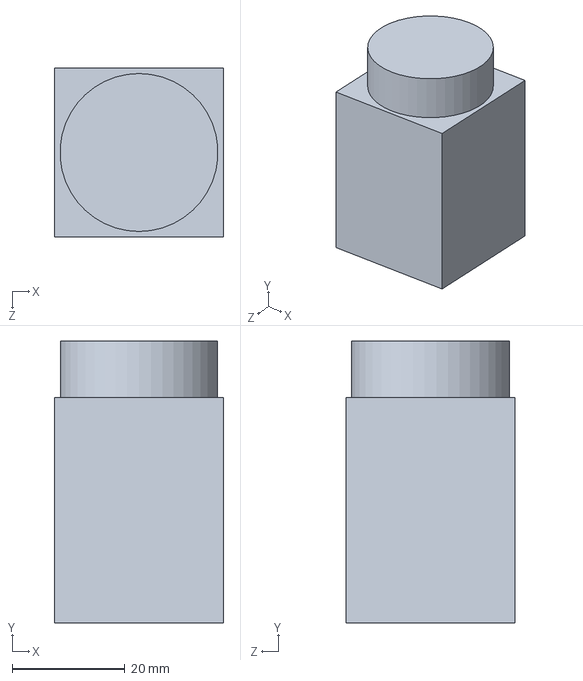
[picture p158: CAD file, 2021-02-03]
Wavemaker 3D Models/Camera Gimbal/Z-Rotation/Camera_Appr.SLDPRT
30.0 x 50.0 x 30.0 mm
