MatthiasOPage/Wavemaker/Wavemaker 3D Models/Electronics Shelf/Shelf Hardware/Electronics_Bracket_Side_Brackets.SLDPRT

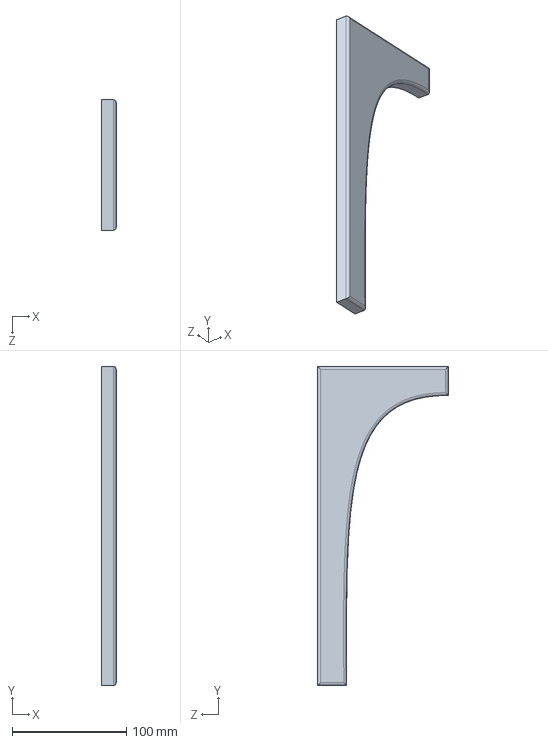
[picture p160: CAD file, 2020-11-19]
Wavemaker 3D Models/Electronics Shelf/Shelf Hardware/Electronics_Bracket_Side_Brackets.SLDPRT
12.7 x 279.4 x 114.3 mm
