MatthiasOPage/Wavemaker/Wavemaker 3D Models/Electronics/Button/Button_Bracket.SLDPRT

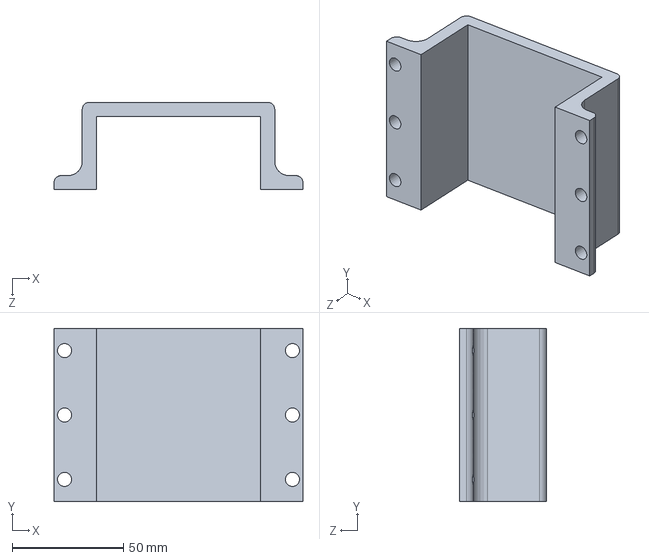
[picture p161: CAD file, 2020-11-19]
Wavemaker 3D Models/Electronics/Button/Button_Bracket.SLDPRT
112.1 x 78.0 x 39.4 mm
