MatthiasOPage/Wavemaker/Wavemaker 3D Models/Electronics/PSU/PSU_Basic_Model.SLDPRT

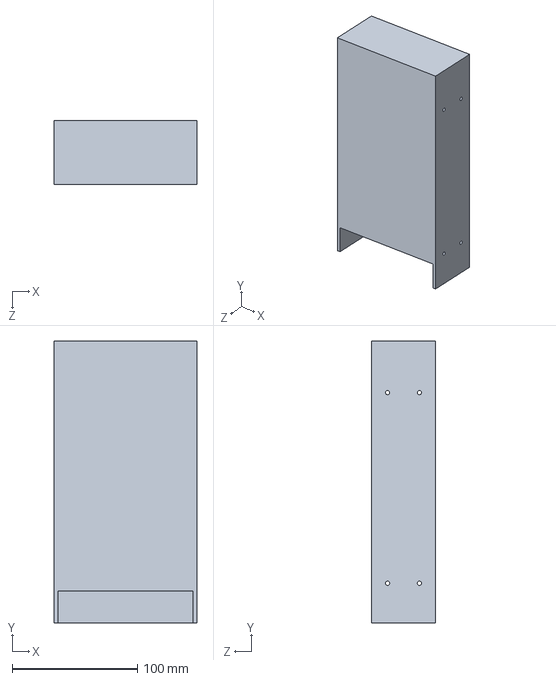
[picture p162: CAD file, 2020-11-19]
Wavemaker 3D Models/Electronics/PSU/PSU_Basic_Model.SLDPRT
114.3 x 225.4 x 50.8 mm
