MatthiasOPage/Wavemaker/Wavemaker 3D Models/Electronics/Toggle/Toggle.SLDPRT

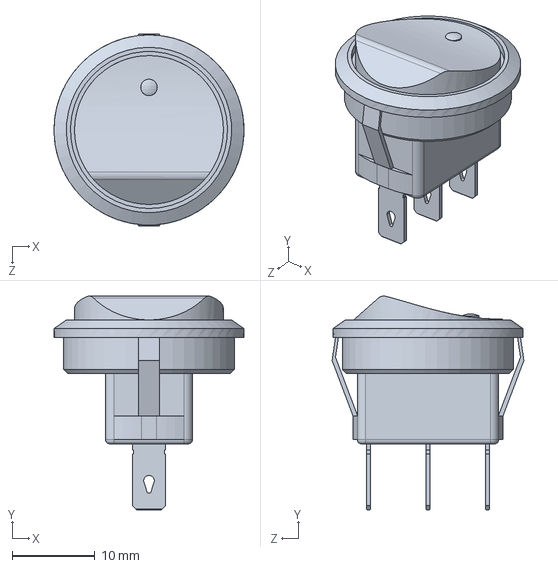
[picture p163: CAD file, 2020-11-19]
Wavemaker 3D Models/Electronics/Toggle/Toggle.SLDPRT
23.0 x 25.9 x 23.2 mm
