MatthiasOPage/Wavemaker/Wavemaker 3D Models/Frame Extrusions/12in.SLDPRT

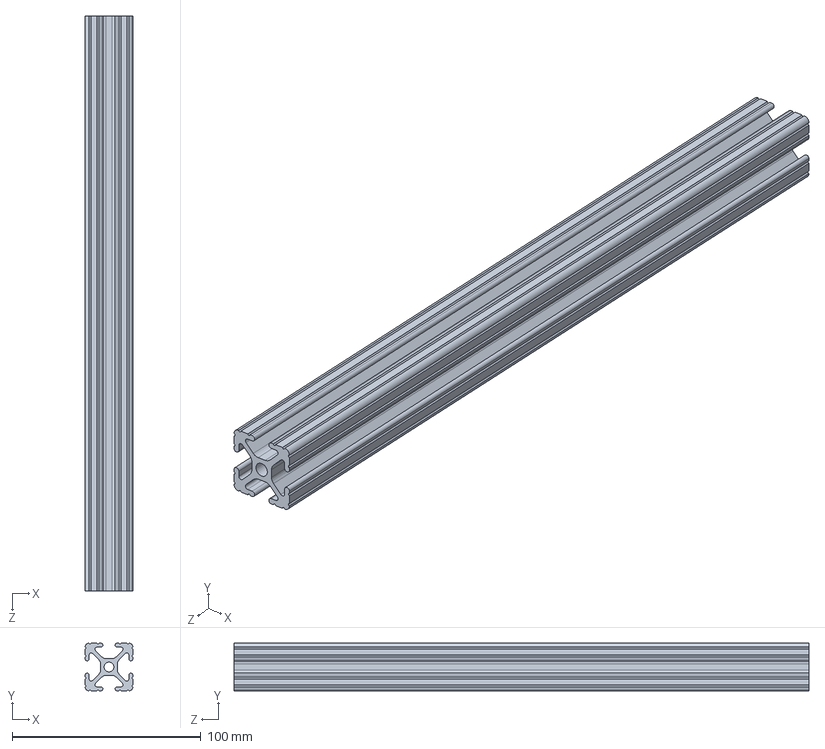
[picture p164: CAD file, 2020-11-19]
Wavemaker 3D Models/Frame Extrusions/12in.SLDPRT
25.4 x 25.4 x 304.8 mm
