MatthiasOPage/Wavemaker/Wavemaker 3D Models/Frame Hardware/Pulley Assmebly/Babbit_Bearing.SLDPRT

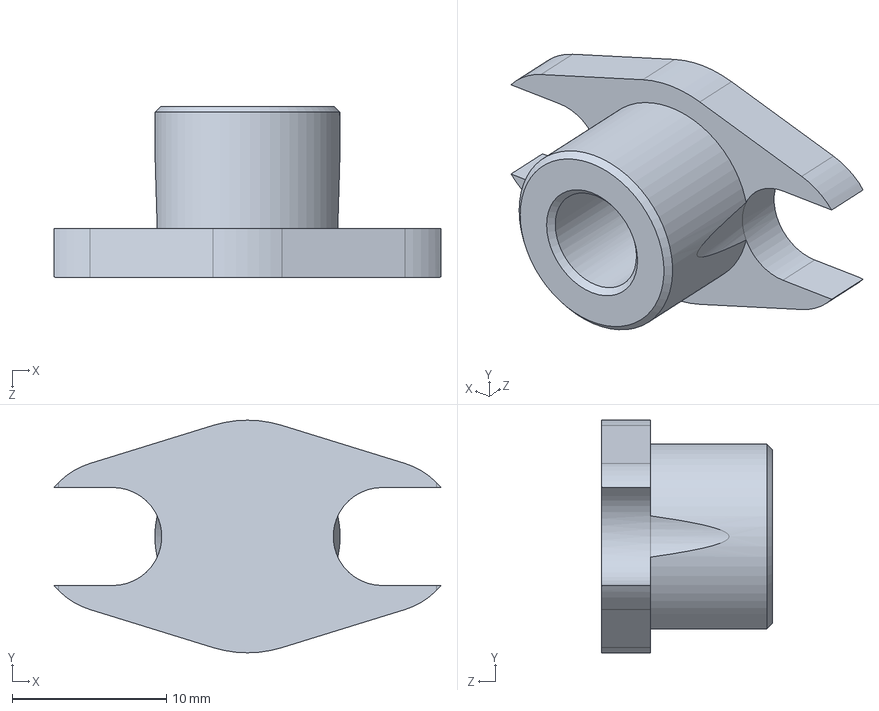
[picture p165: CAD file, 2020-11-19]
Wavemaker 3D Models/Frame Hardware/Pulley Assmebly/Babbit_Bearing.SLDPRT
25.1 x 15.1 x 11.1 mm
