MatthiasOPage/Wavemaker/Wavemaker 3D Models/Laser_Cutter_Templates/Wedge_Template_1.DXF

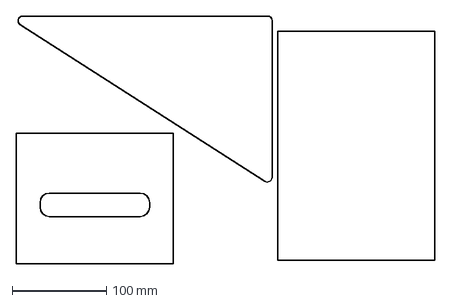
[picture p166: CAD file, 2020-11-19]
Wavemaker 3D Models/Laser_Cutter_Templates/Wedge_Template_1.DXF
443.1 x 262.6 mm
