MatthiasOPage/Wavemaker/Wavemaker 3D Models/Tank Cart/40S-120cm.SLDPRT

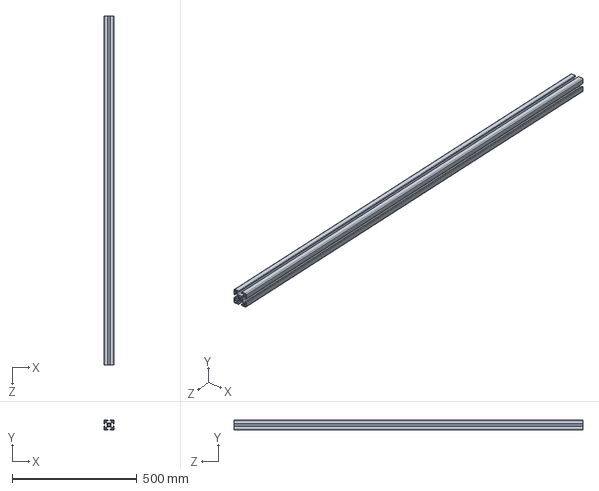
[picture p168: CAD file, 2020-11-25]
Wavemaker 3D Models/Tank Cart/40S-120cm.SLDPRT
40.0 x 40.0 x 1400.0 mm
