MatthiasOPage/Wavemaker/Wavemaker 3D Models/Tank Cart/SLDPRT_40_Series/40_Series/40-8016.sldprt

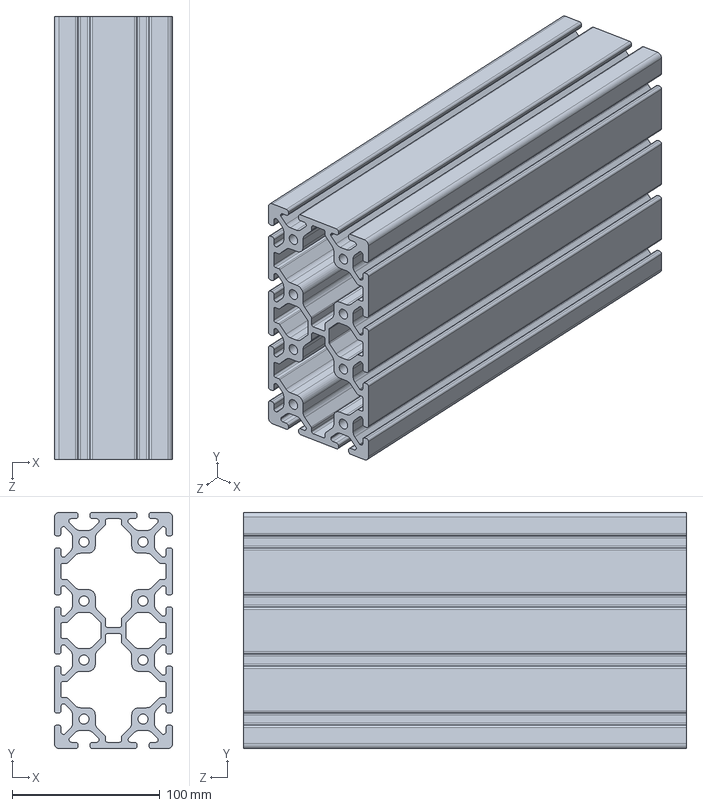
[picture p169: CAD file, 2020-11-25]
Wavemaker 3D Models/Tank Cart/SLDPRT_40_Series/40_Series/40-8016.sldprt
80.0 x 160.0 x 300.0 mm
