MatthiasOPage/Wavemaker/Wavemaker 3D Models/Wedge/Wedge_Side.SLDPRT

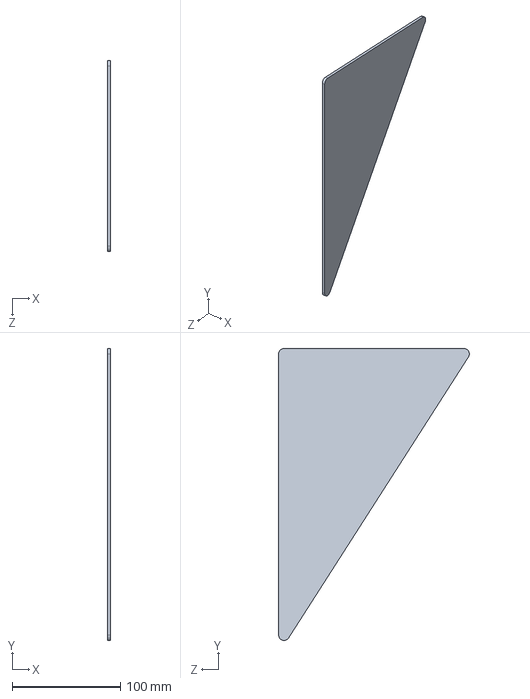
[picture p170: CAD file, 2020-11-19]
Wavemaker 3D Models/Wedge/Wedge_Side.SLDPRT
3.17 x 269.2 x 175.8 mm
