MatthiasOPage/Wavemaker/Wavemaker 3D Models/3D Printer Files/Pulley_Guide.STL

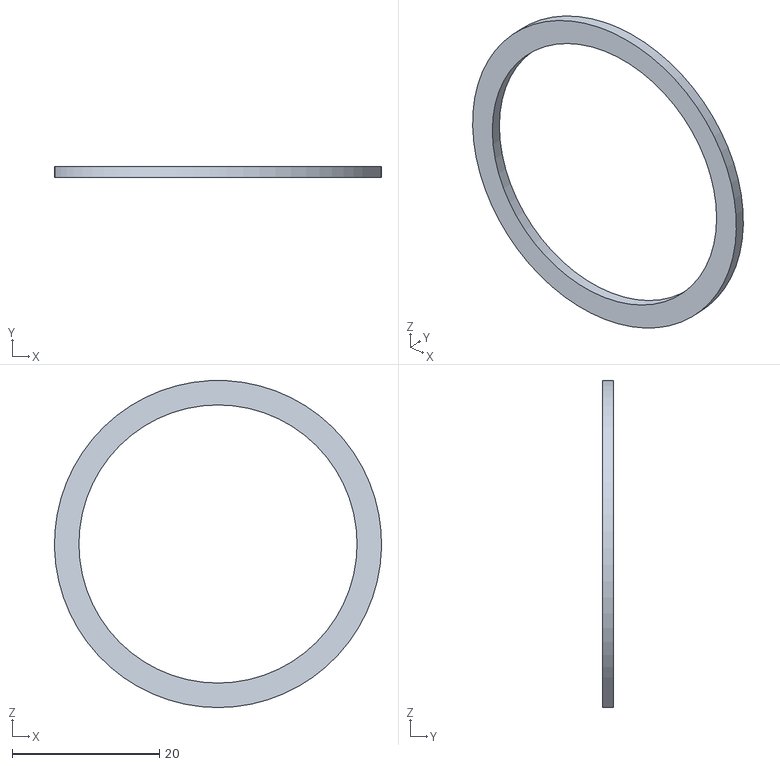
[picture p171: CAD file, 2020-11-19]
Wavemaker 3D Models/3D Printer Files/Pulley_Guide.STL
44.4 x 1.52 x 44.5
