MatthiasOPage/Wavemaker/Wavemaker 3D Models/3D_Printer_Files/Wedge_Top_90.STL

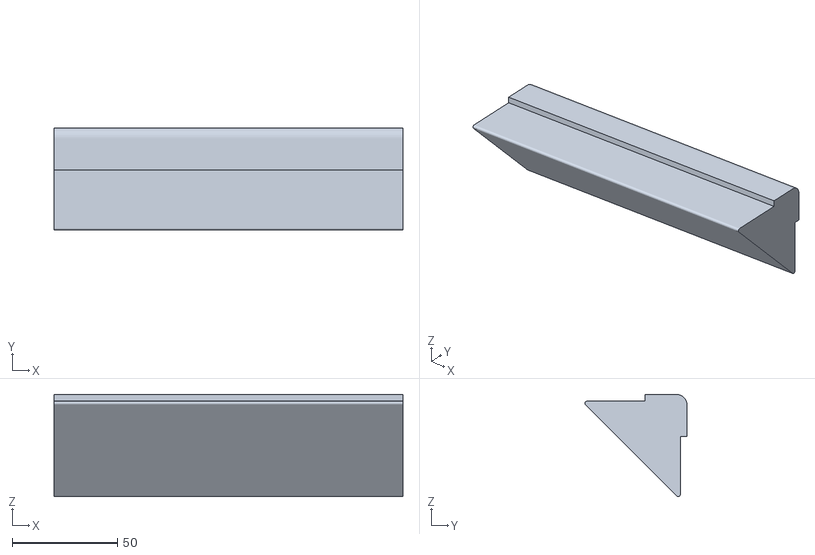
[picture p172: CAD file, 2020-11-19]
Wavemaker 3D Models/3D_Printer_Files/Wedge_Top_90.STL
166.1 x 48.6 x 48.6
