MatthiasOPage/Wavemaker/Wavemaker 3D Models/Basic Models/Front_Idler_Basic.SLDPRT

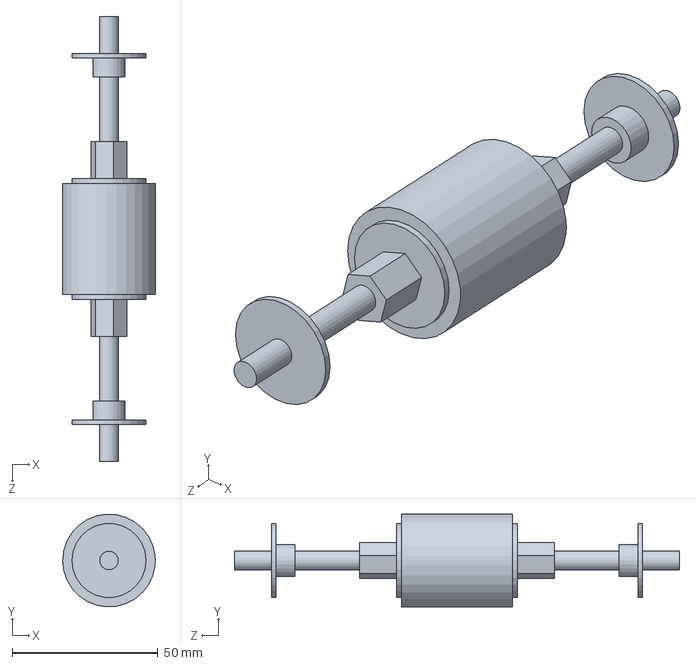
[picture p173: CAD file, 2020-11-19]
Wavemaker 3D Models/Basic Models/Front_Idler_Basic.SLDPRT
31.8 x 31.7 x 152.4 mm
