MatthiasOPage/Wavemaker/Wavemaker 3D Models/Camera Gimbal/Full Assembly Hardware/M5_Nylock.SLDPRT

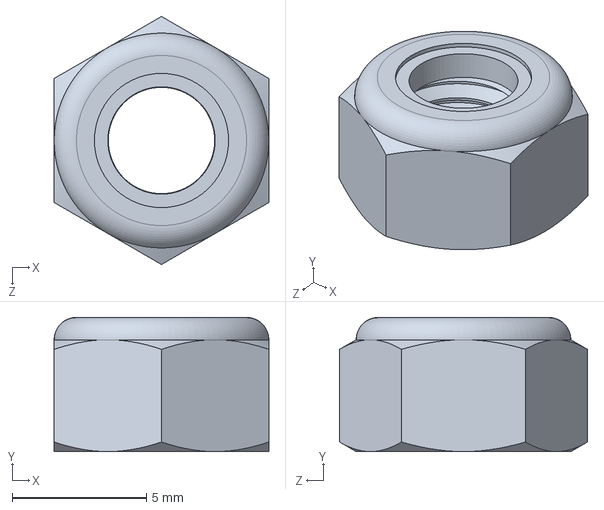
[picture p174: CAD file, 2021-02-03]
Wavemaker 3D Models/Camera Gimbal/Full Assembly Hardware/M5_Nylock.SLDPRT
8.00 x 5.00 x 9.24 mm
