MatthiasOPage/Wavemaker/Wavemaker 3D Models/Camera Gimbal/Y-Rotation/Bottom_Disk.SLDPRT

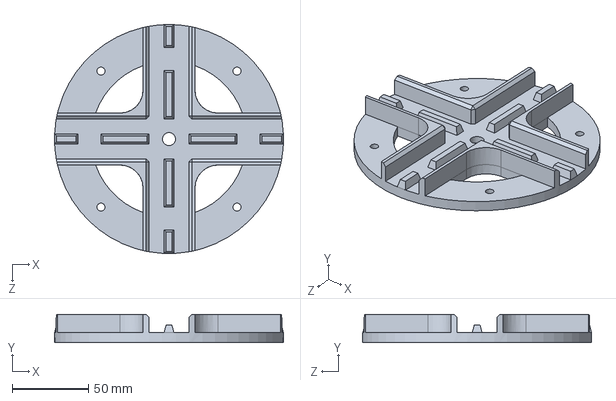
[picture p175: CAD file, 2021-02-03]
Wavemaker 3D Models/Camera Gimbal/Y-Rotation/Bottom_Disk.SLDPRT
150.0 x 18.5 x 150.1 mm
