MatthiasOPage/Wavemaker/Wavemaker 3D Models/Camera Gimbal/Z-Rotation/Body_Bracket_M5.SLDPRT

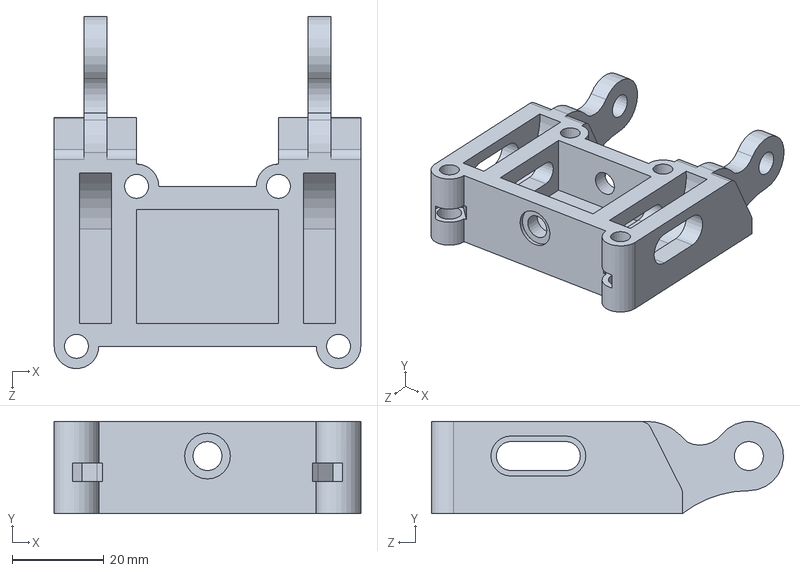
[picture p176: CAD file, 2021-02-03]
Wavemaker 3D Models/Camera Gimbal/Z-Rotation/Body_Bracket_M5.SLDPRT
67.0 x 20.1 x 76.9 mm
