MatthiasOPage/Wavemaker/Wavemaker 3D Models/Camera Gimbal/Z-Rotation/Pre-M5/M6_Shallow_Nuts.SLDPRT

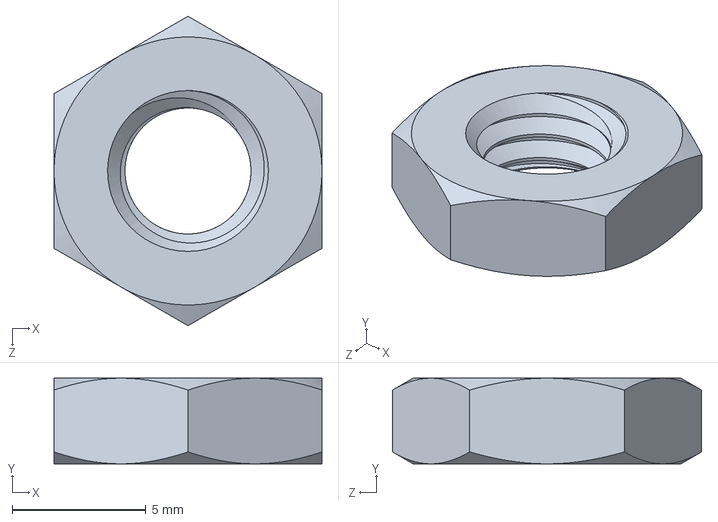
[picture p177: CAD file, 2021-02-03]
Wavemaker 3D Models/Camera Gimbal/Z-Rotation/Pre-M5/M6_Shallow_Nuts.SLDPRT
10.0 x 3.20 x 11.5 mm
