MatthiasOPage/Wavemaker/Wavemaker 3D Models/Electronics Shelf/Shelf Frame/Electronics_Bracket_Top_Plate.SLDPRT

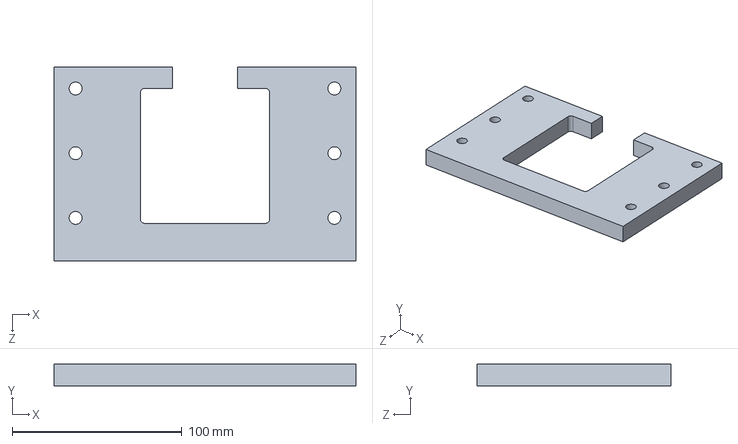
[picture p178: CAD file, 2020-11-19]
Wavemaker 3D Models/Electronics Shelf/Shelf Frame/Electronics_Bracket_Top_Plate.SLDPRT
177.8 x 12.7 x 114.3 mm
