MatthiasOPage/Wavemaker/Wavemaker 3D Models/Electronics/Boards/Electronics mounting bracket.SLDPRT

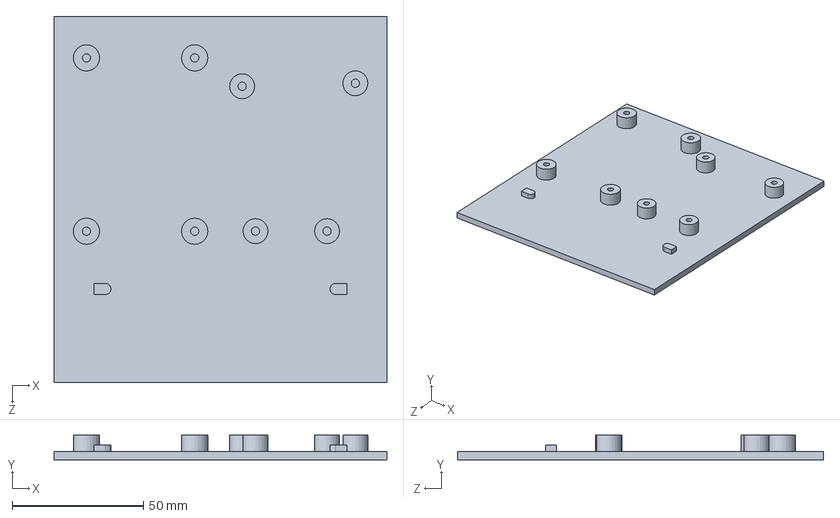
[picture p179: CAD file, 2020-11-19]
Wavemaker 3D Models/Electronics/Boards/Electronics mounting bracket.SLDPRT
127.0 x 9.53 x 139.7 mm
