MatthiasOPage/Wavemaker/Wavemaker 3D Models/Electronics/Limits/Bottom_Limit_Bracket.SLDPRT

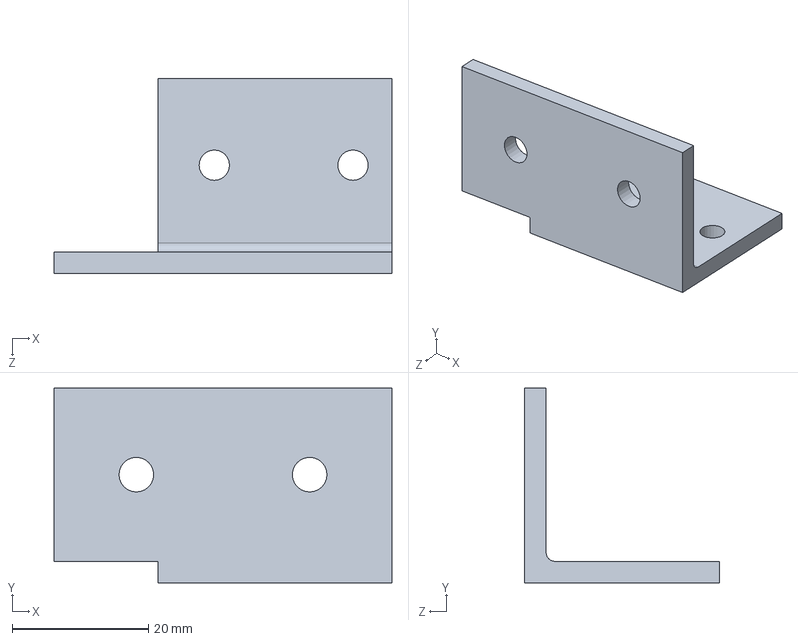
[picture p180: CAD file, 2020-11-19]
Wavemaker 3D Models/Electronics/Limits/Bottom_Limit_Bracket.SLDPRT
49.5 x 28.6 x 28.6 mm
