MatthiasOPage/Wavemaker/Wavemaker 3D Models/Electronics/Shelf Brackets/Button_Bracket_Narrow.SLDPRT

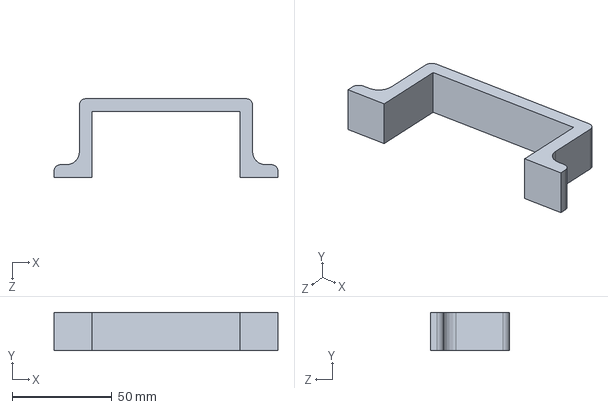
[picture p181: CAD file, 2020-11-19]
Wavemaker 3D Models/Electronics/Shelf Brackets/Button_Bracket_Narrow.SLDPRT
112.1 x 19.1 x 39.4 mm
