MatthiasOPage/Wavemaker/Wavemaker 3D Models/Electronics/Toggle/Button_Spacer.SLDPRT

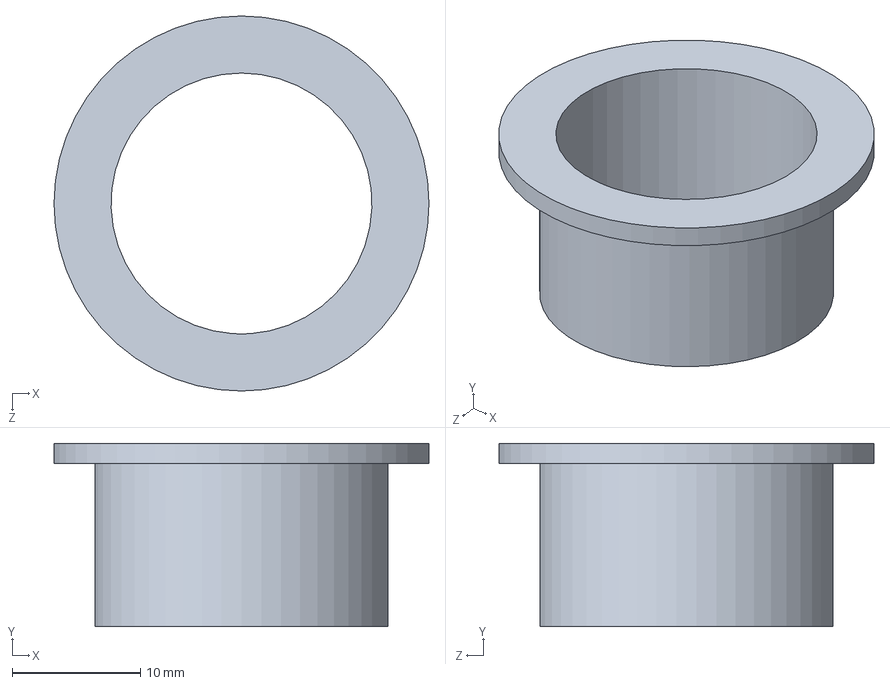
[picture p182: CAD file, 2020-11-19]
Wavemaker 3D Models/Electronics/Toggle/Button_Spacer.SLDPRT
29.2 x 14.3 x 29.2 mm
