MatthiasOPage/Wavemaker/Wavemaker 3D Models/Frame Extrusions/7in_Drilled.SLDPRT

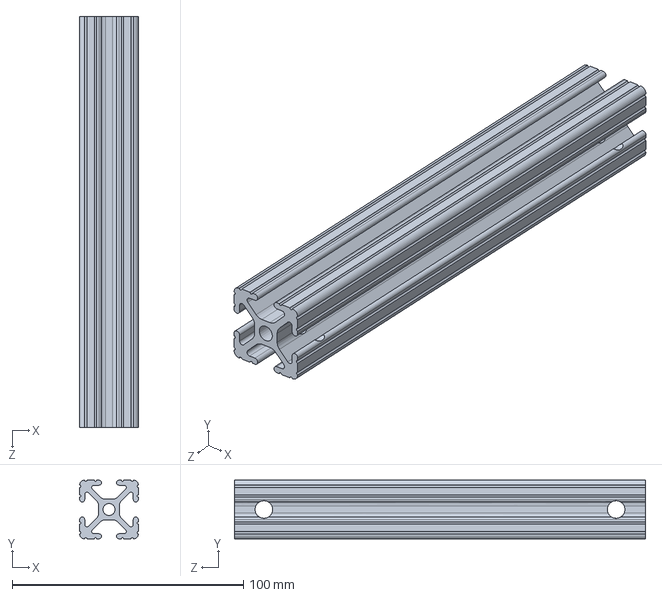
[picture p183: CAD file, 2020-11-19]
Wavemaker 3D Models/Frame Extrusions/7in_Drilled.SLDPRT
25.4 x 25.4 x 177.8 mm
