MatthiasOPage/Wavemaker/Wavemaker 3D Models/Frame Hardware/Idlers/Front_Idler_Delrin.SLDPRT

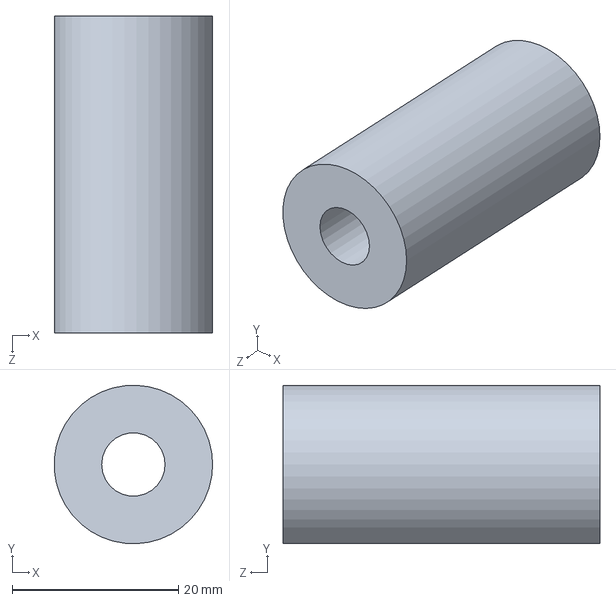
[picture p184: CAD file, 2020-11-19]
Wavemaker 3D Models/Frame Hardware/Idlers/Front_Idler_Delrin.SLDPRT
19.0 x 19.0 x 38.1 mm
