MatthiasOPage/Wavemaker/Wavemaker 3D Models/Frame Hardware/Pulley Assmebly/Pulley_Shaft.SLDPRT

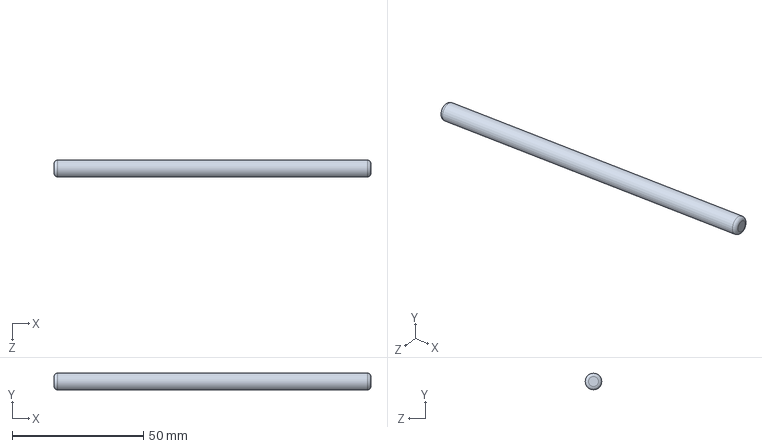
[picture p185: CAD file, 2020-11-19]
Wavemaker 3D Models/Frame Hardware/Pulley Assmebly/Pulley_Shaft.SLDPRT
120.7 x 6.35 x 6.35 mm
