MatthiasOPage/Wavemaker/Wavemaker 3D Models/Mounting Plate/Plate_Slide_Bearing.sldprt

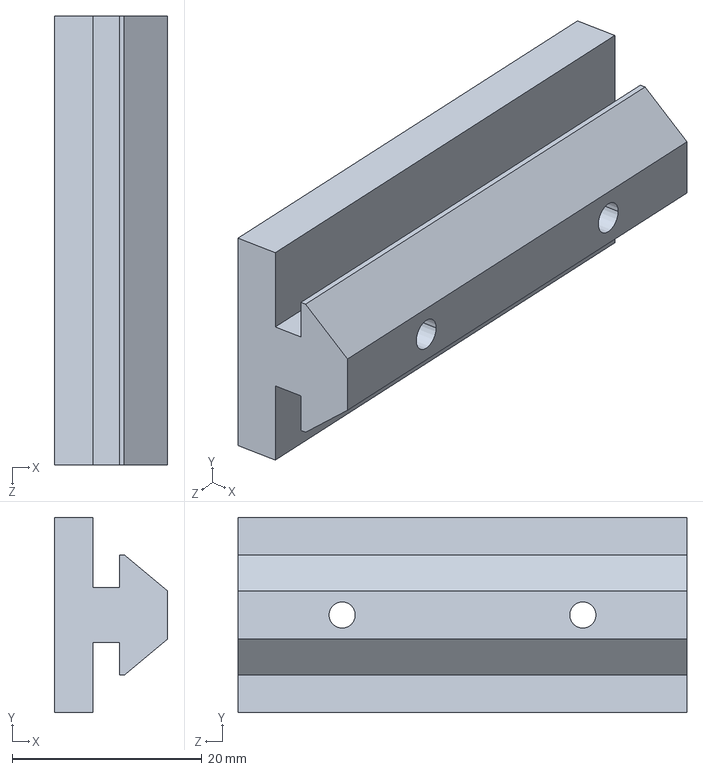
[picture p186: CAD file, 2020-11-19]
Wavemaker 3D Models/Mounting Plate/Plate_Slide_Bearing.sldprt
11.9 x 20.6 x 47.4 mm
