MatthiasOPage/Wavemaker/Wavemaker 3D Models/Tank Cart/40S-40cm.SLDPRT

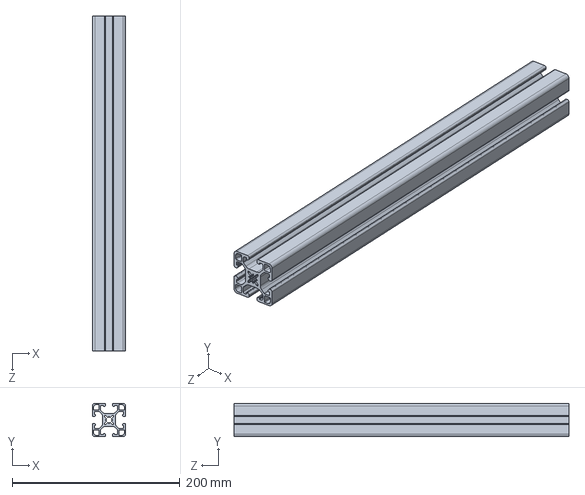
[picture p187: CAD file, 2020-11-25]
Wavemaker 3D Models/Tank Cart/40S-40cm.SLDPRT
40.0 x 40.0 x 400.0 mm
