MatthiasOPage/Wavemaker/Wavemaker 3D Models/Tank Cart/SLDPRT_40_Series/40_Series/40-4083-LITE.sldprt

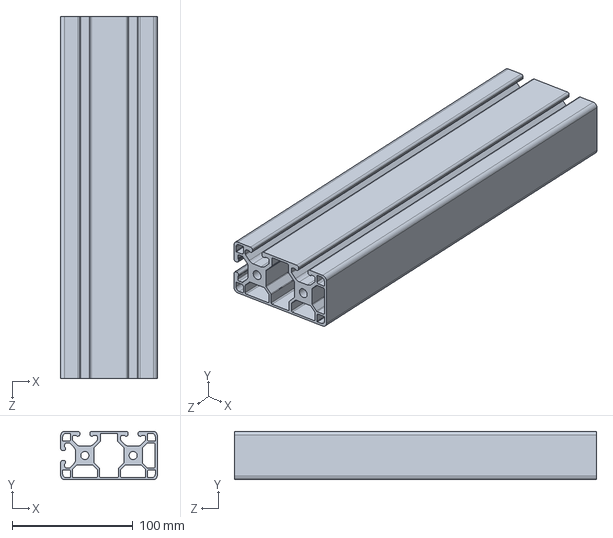
[picture p188: CAD file, 2020-11-25]
Wavemaker 3D Models/Tank Cart/SLDPRT_40_Series/40_Series/40-4083-LITE.sldprt
80.0 x 40.0 x 300.0 mm
