MatthiasOPage/Wavemaker/Wavemaker 3D Models/Wedge/Test_Tank_Actual.SLDPRT

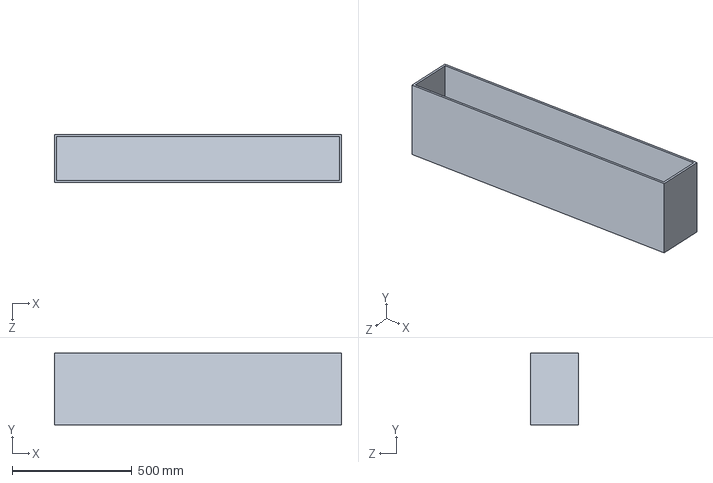
[picture p189: CAD file, 2020-11-19]
Wavemaker 3D Models/Wedge/Test_Tank_Actual.SLDPRT
1200.0 x 300.0 x 200.0 mm
