MatthiasOPage/Wavemaker/Wavemaker 3D Models/3D Printer Files/Backpack_Rail_Nuts.STL

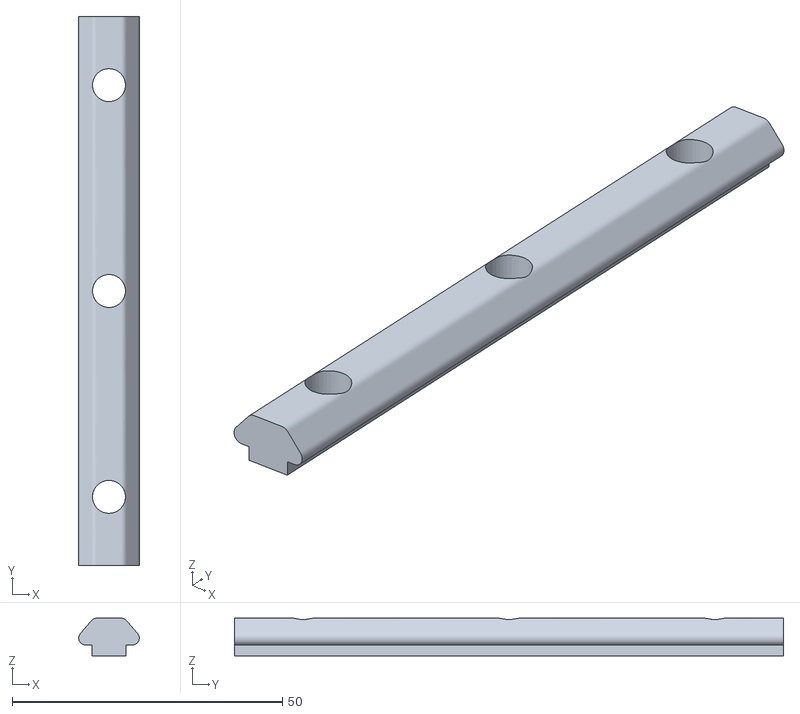
[picture p190: CAD file, 2020-11-19]
Wavemaker 3D Models/3D Printer Files/Backpack_Rail_Nuts.STL
11.2 x 101.6 x 6.98
