MatthiasOPage/Wavemaker/Wavemaker 3D Models/Camera Gimbal/X-Translation/X_Rails.SLDPRT

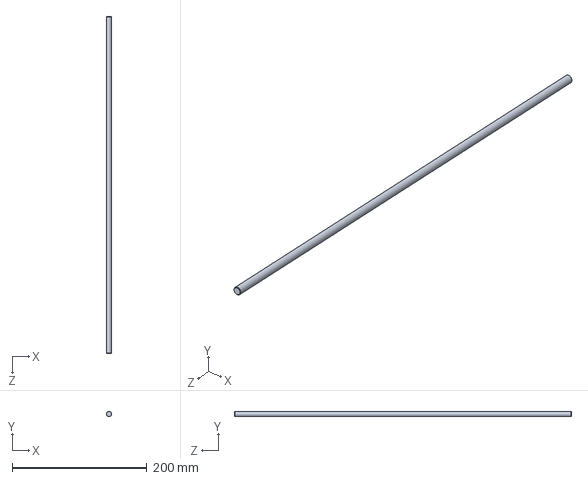
[picture p191: CAD file, 2021-02-03]
Wavemaker 3D Models/Camera Gimbal/X-Translation/X_Rails.SLDPRT
8.00 x 8.00 x 500.0 mm
