MatthiasOPage/Wavemaker/Wavemaker 3D Models/Camera Gimbal/Z-Rotation/Camera_Swing_Bracket_M5.SLDPRT

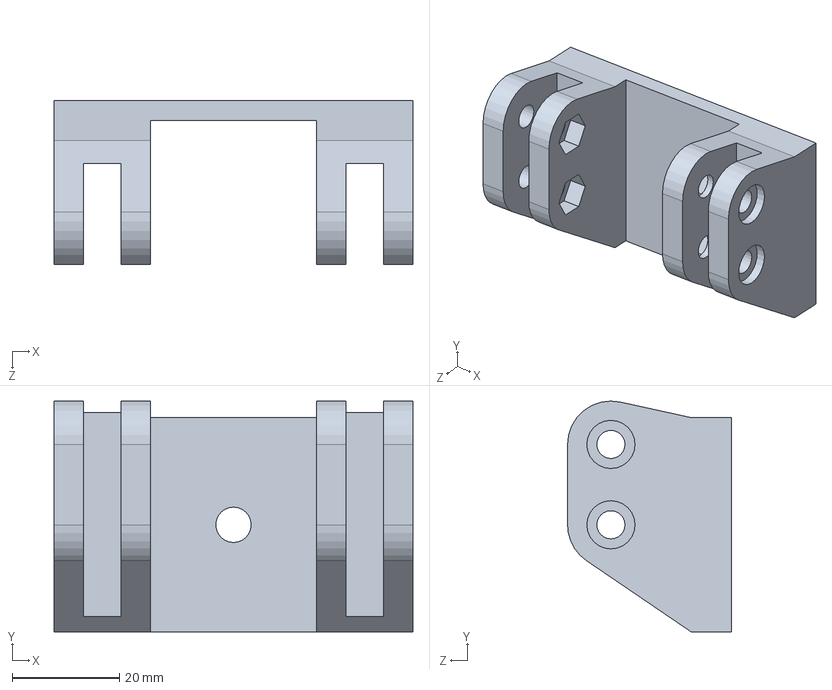
[picture p192: CAD file, 2021-02-03]
Wavemaker 3D Models/Camera Gimbal/Z-Rotation/Camera_Swing_Bracket_M5.SLDPRT
67.0 x 43.1 x 30.6 mm
