MatthiasOPage/Wavemaker/Wavemaker 3D Models/Electronics Shelf/Shelf Frame/Electronics_Bracket_Front_Plate.SLDPRT

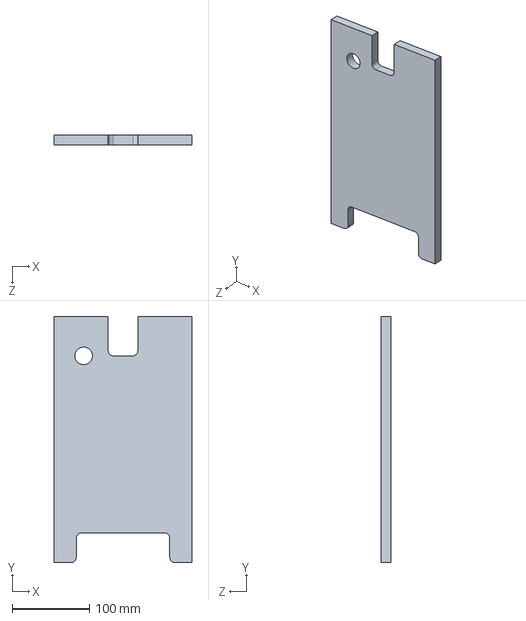
[picture p193: CAD file, 2020-11-19]
Wavemaker 3D Models/Electronics Shelf/Shelf Frame/Electronics_Bracket_Front_Plate.SLDPRT
177.8 x 317.5 x 12.7 mm
