MatthiasOPage/Wavemaker/Wavemaker 3D Models/Electronics/Boards/Arduino_Basic_Model.SLDPRT

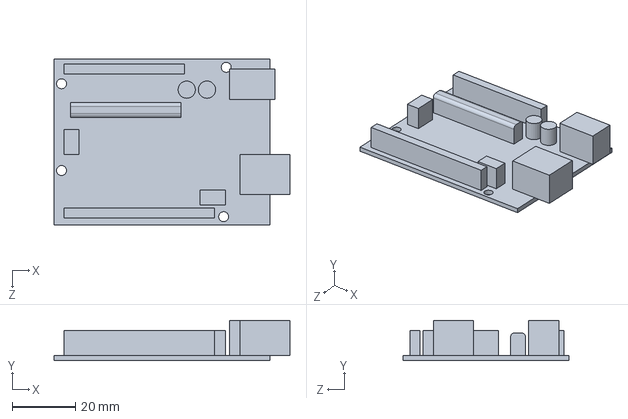
[picture p194: CAD file, 2020-11-19]
Wavemaker 3D Models/Electronics/Boards/Arduino_Basic_Model.SLDPRT
74.6 x 12.7 x 52.4 mm
