MatthiasOPage/Wavemaker/Wavemaker 3D Models/Electronics/Shelf Brackets/PSU_Bracket_Sides.SLDPRT

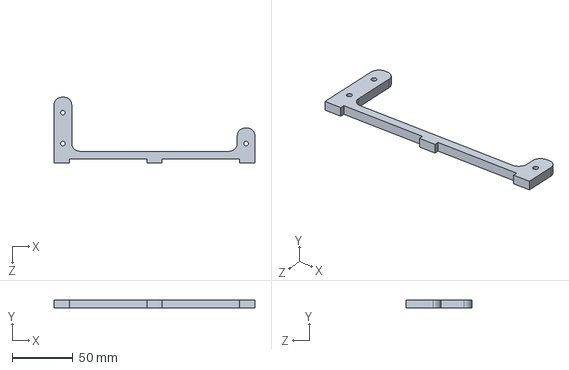
[picture p195: CAD file, 2020-11-19]
Wavemaker 3D Models/Electronics/Shelf Brackets/PSU_Bracket_Sides.SLDPRT
165.1 x 6.35 x 54.0 mm
