MatthiasOPage/Wavemaker/Wavemaker 3D Models/Frame Extrusions/6in.SLDPRT

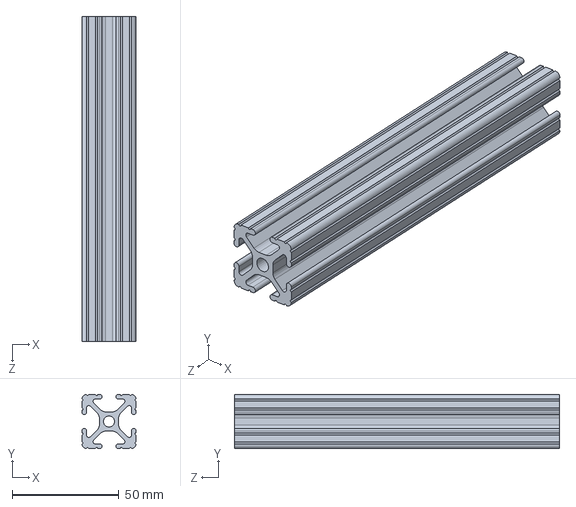
[picture p196: CAD file, 2020-11-19]
Wavemaker 3D Models/Frame Extrusions/6in.SLDPRT
25.4 x 25.4 x 152.4 mm
