MatthiasOPage/Wavemaker/Wavemaker 3D Models/Frame Hardware/8020_Encaps.SLDPRT

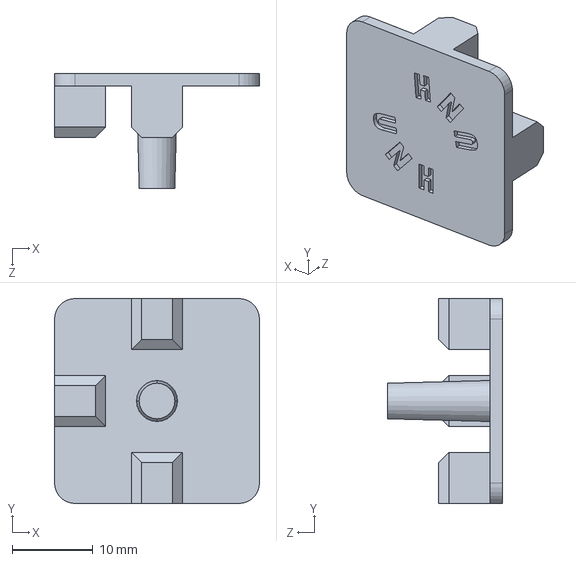
[picture p197: CAD file, 2020-11-19]
Wavemaker 3D Models/Frame Hardware/8020_Encaps.SLDPRT
25.4 x 25.4 x 14.3 mm
