MatthiasOPage/Wavemaker/Wavemaker 3D Models/Frame Hardware/Pulley Assmebly/Timing_Pulley.SLDPRT

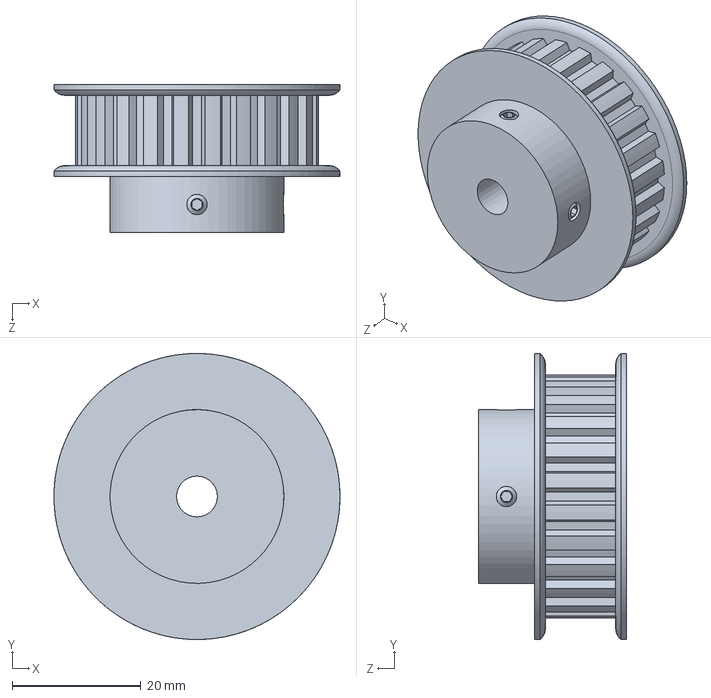
[picture p198: CAD file, 2020-11-19]
Wavemaker 3D Models/Frame Hardware/Pulley Assmebly/Timing_Pulley.SLDPRT
44.4 x 44.4 x 23.0 mm
