MatthiasOPage/Wavemaker/Wavemaker 3D Models/Tank Cart/CartBase.SLDPRT

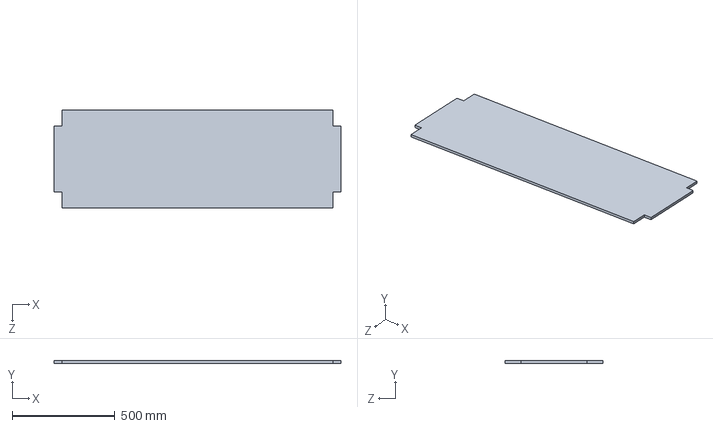
[picture p199: CAD file, 2020-11-25]
Wavemaker 3D Models/Tank Cart/CartBase.SLDPRT
1400.0 x 12.7 x 480.0 mm
