MatthiasOPage/Wavemaker/Wavemaker 3D Models/3D Printer Files/Pulley_Rotary_Encoder.STL

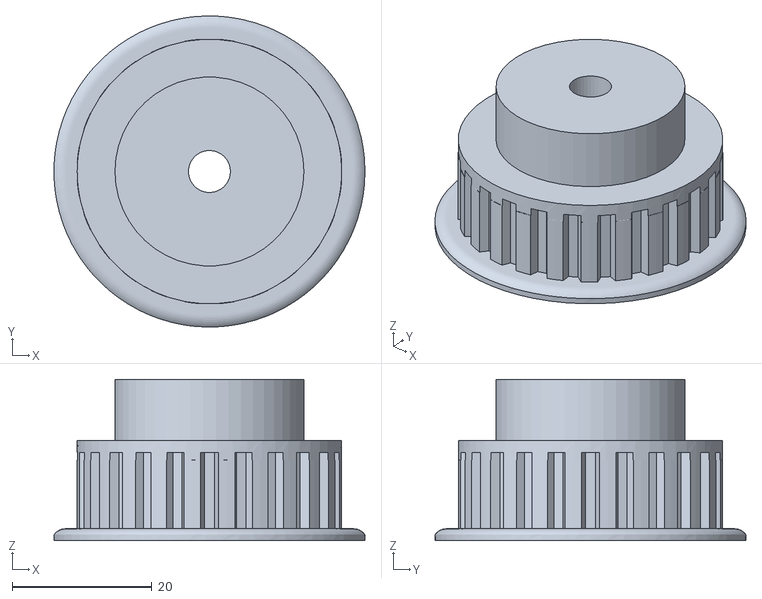
[picture p200: CAD file, 2020-11-19]
Wavemaker 3D Models/3D Printer Files/Pulley_Rotary_Encoder.STL
44.4 x 44.4 x 23.0
