MatthiasOPage/Wavemaker/Wavemaker 3D Models/Basic Models/Idler_Shafts_Basic.SLDPRT

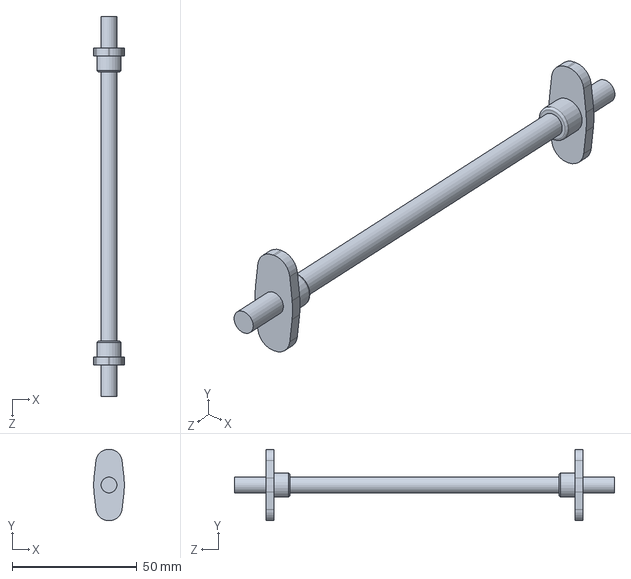
[picture p201: CAD file, 2020-11-19]
Wavemaker 3D Models/Basic Models/Idler_Shafts_Basic.SLDPRT
12.4 x 28.6 x 152.4 mm
