MatthiasOPage/Wavemaker/Wavemaker 3D Models/Camera Gimbal/Z-Rotation/Hardware_M5/10mmOD_Lock_Knob.SLDPRT

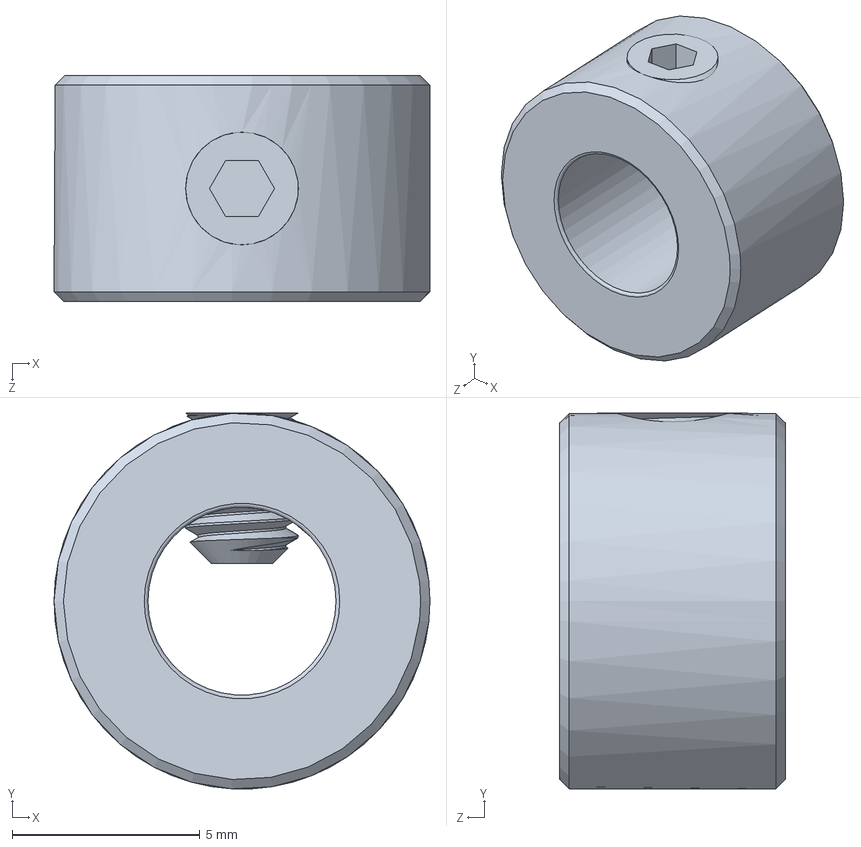
[picture p202: CAD file, 2021-02-03]
Wavemaker 3D Models/Camera Gimbal/Z-Rotation/Hardware_M5/10mmOD_Lock_Knob.SLDPRT
10.0 x 9.99 x 6.00 mm
