MatthiasOPage/Wavemaker/Wavemaker 3D Models/Camera Gimbal/Z-Rotation/Sled_Block_M5.SLDPRT

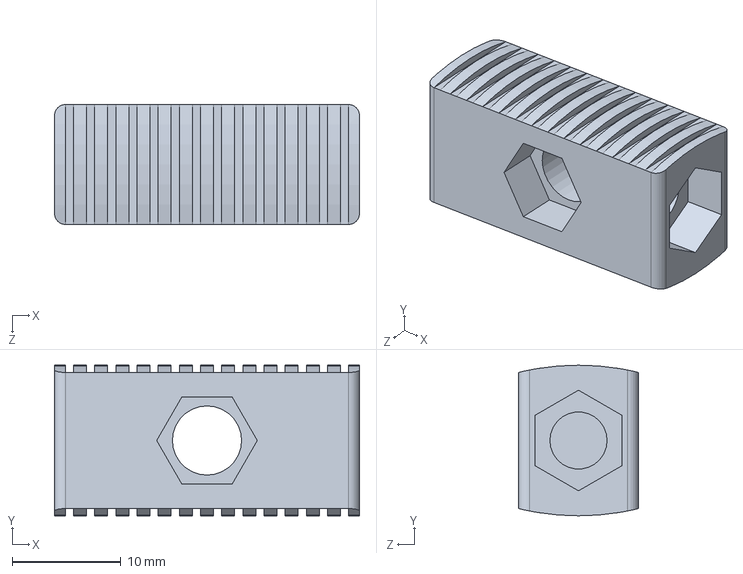
[picture p203: CAD file, 2021-02-03]
Wavemaker 3D Models/Camera Gimbal/Z-Rotation/Sled_Block_M5.SLDPRT
28.0 x 13.8 x 11.0 mm
