MatthiasOPage/Wavemaker/Wavemaker 3D Models/Electronics/Limits/Limit_Clip_Inner.SLDPRT

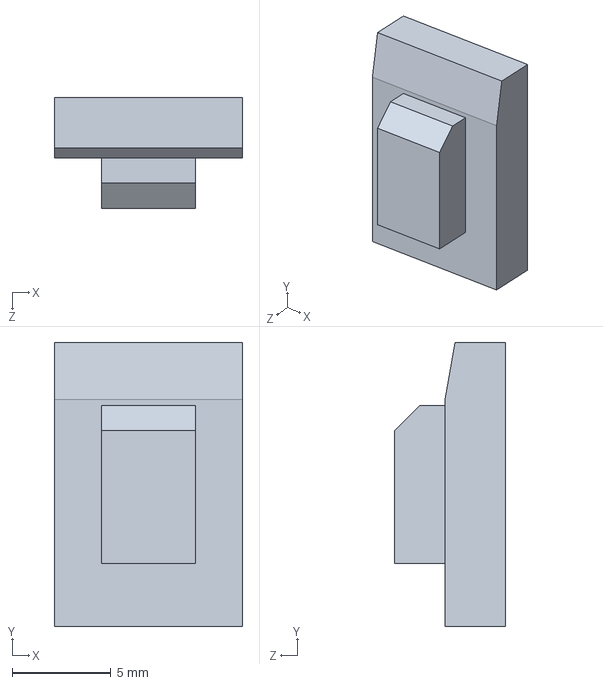
[picture p204: CAD file, 2020-11-19]
Wavemaker 3D Models/Electronics/Limits/Limit_Clip_Inner.SLDPRT
9.53 x 14.4 x 5.59 mm
