MatthiasOPage/Wavemaker/Wavemaker 3D Models/Frame Hardware/8020_Encaps_Flat.SLDPRT

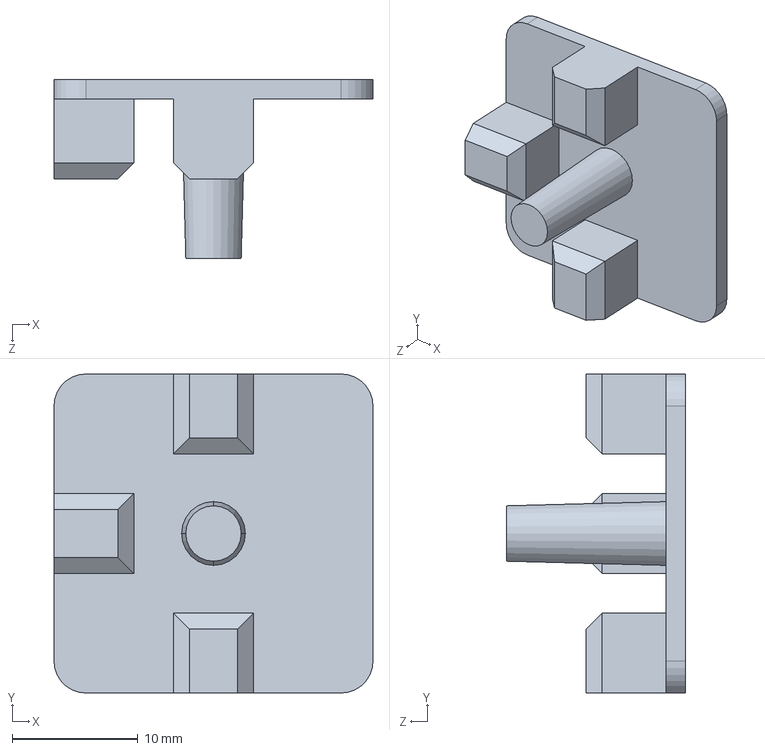
[picture p205: CAD file, 2020-11-19]
Wavemaker 3D Models/Frame Hardware/8020_Encaps_Flat.SLDPRT
25.4 x 25.4 x 14.3 mm
