MatthiasOPage/Wavemaker/Wavemaker 3D Models/Frame Hardware/Idlers/Back_Idler_Delrin.SLDPRT

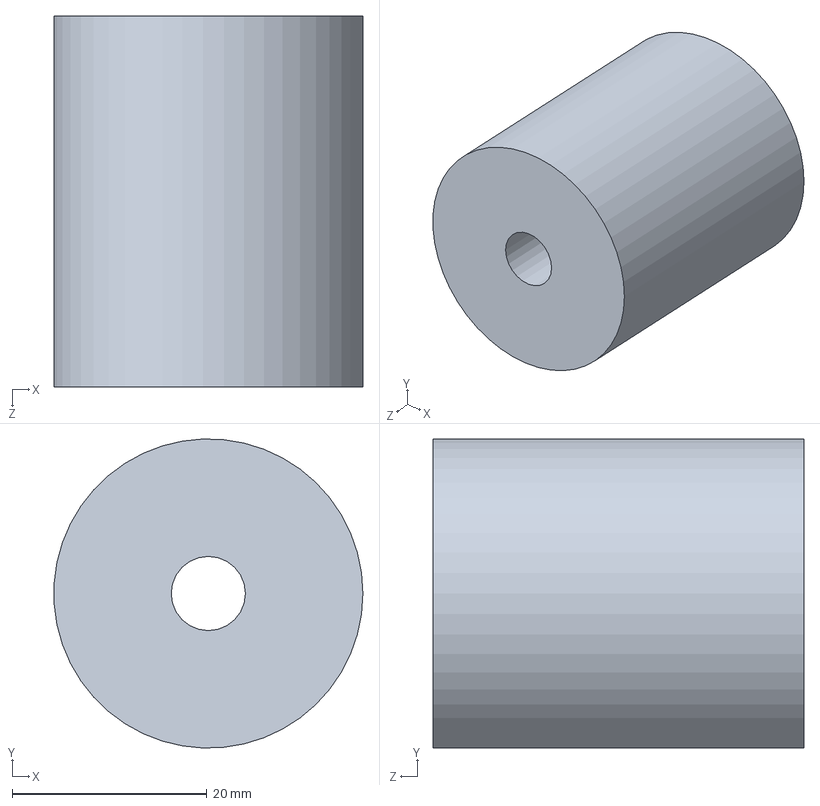
[picture p206: CAD file, 2020-11-19]
Wavemaker 3D Models/Frame Hardware/Idlers/Back_Idler_Delrin.SLDPRT
31.7 x 31.7 x 38.1 mm
