MatthiasOPage/Wavemaker/Wavemaker 3D Models/Mounting Plate/Mounting_Plate_Front.SLDPRT

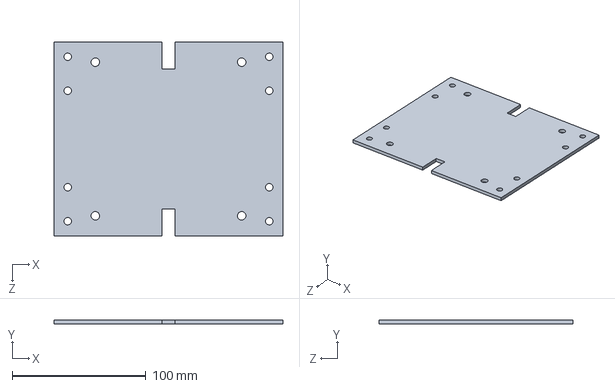
[picture p207: CAD file, 2020-11-19]
Wavemaker 3D Models/Mounting Plate/Mounting_Plate_Front.SLDPRT
171.4 x 3.17 x 145.0 mm
