MatthiasOPage/Wavemaker/Wavemaker 3D Models/Mounting Plate/Plate Hardware/O-ring.SLDPRT

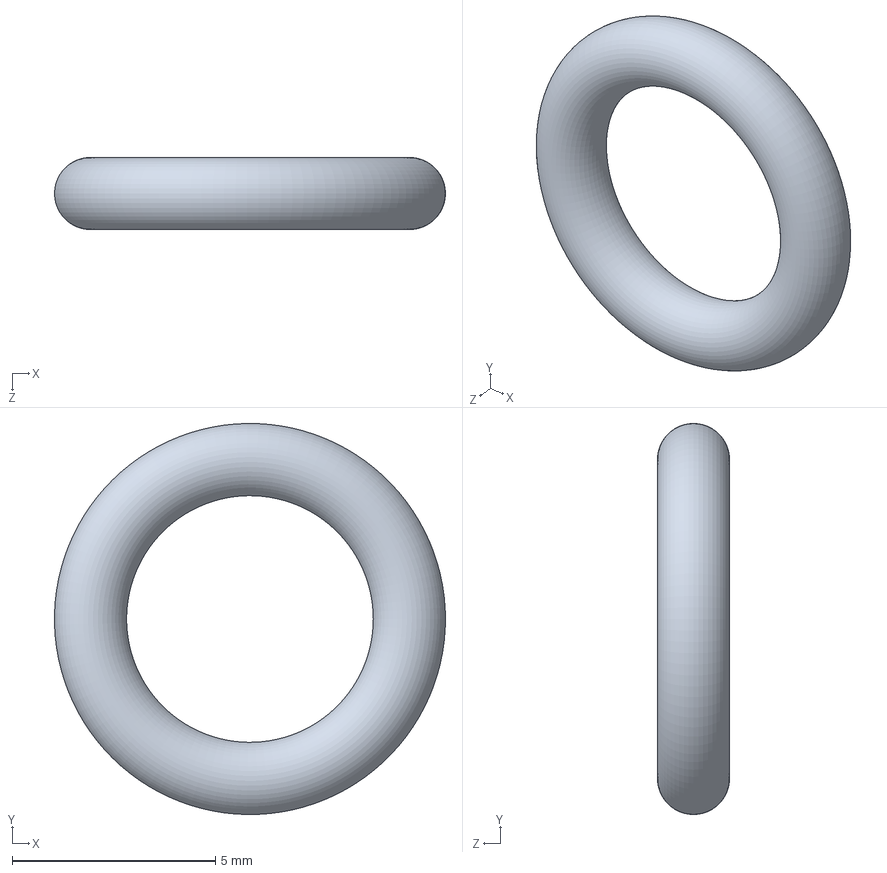
[picture p208: CAD file, 2020-11-19]
Wavemaker 3D Models/Mounting Plate/Plate Hardware/O-ring.SLDPRT
9.62 x 9.63 x 1.77 mm
