MatthiasOPage/Wavemaker/Wavemaker 3D Models/Wedge/Wedge_Back.SLDPRT

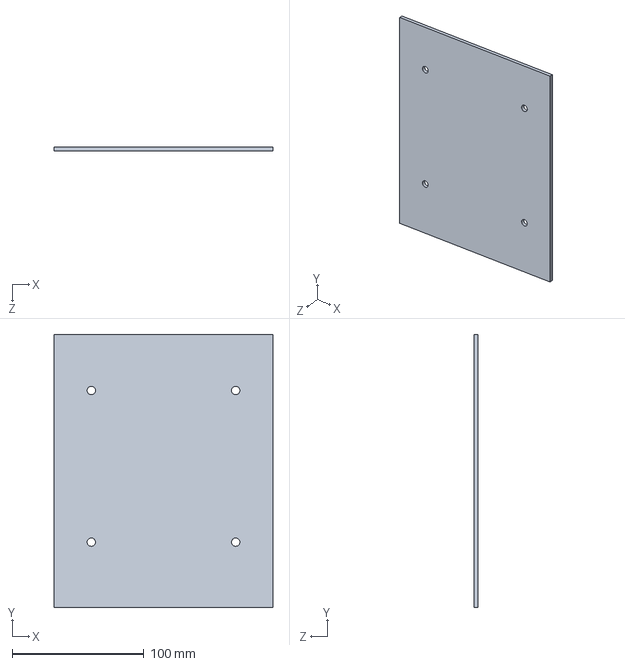
[picture p209: CAD file, 2020-11-19]
Wavemaker 3D Models/Wedge/Wedge_Back.SLDPRT
166.1 x 207.1 x 3.17 mm
