MatthiasOPage/Wavemaker/Wavemaker 3D Models/3D Printer Files/8020_Encaps_Limit_Side.STL

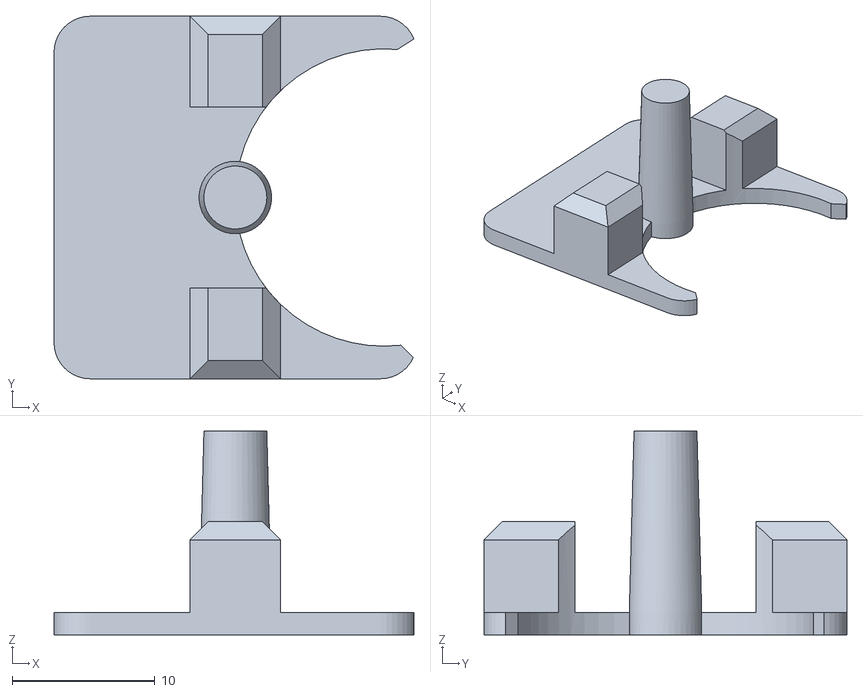
[picture p210: CAD file, 2020-11-19]
Wavemaker 3D Models/3D Printer Files/8020_Encaps_Limit_Side.STL
25.2 x 25.4 x 14.3
