MatthiasOPage/Wavemaker/Wavemaker 3D Models/Basic Models/Frame_Brace_Top.SLDPRT

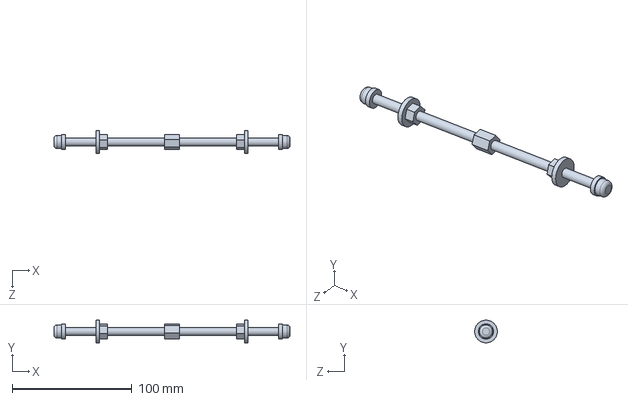
[picture p211: CAD file, 2020-11-19]
Wavemaker 3D Models/Basic Models/Frame_Brace_Top.SLDPRT
196.9 x 19.1 x 19.1 mm
