MatthiasOPage/Wavemaker/Wavemaker 3D Models/Camera Gimbal/Z-Carriage/Z-Carriage_Standoff_Bearing.SLDPRT

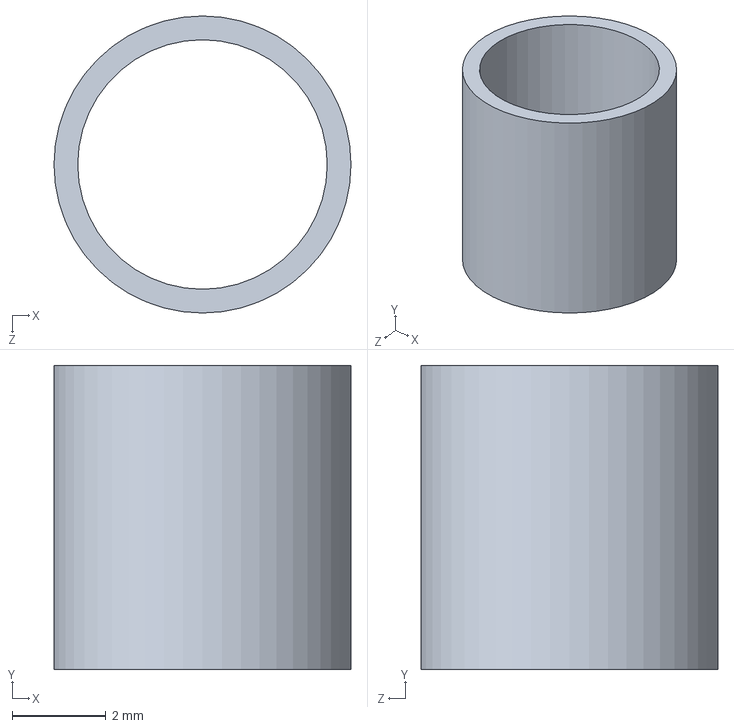
[picture p212: CAD file, 2021-02-03]
Wavemaker 3D Models/Camera Gimbal/Z-Carriage/Z-Carriage_Standoff_Bearing.SLDPRT
6.35 x 6.50 x 6.35 mm
