MatthiasOPage/Wavemaker/Wavemaker 3D Models/Camera Gimbal/Z-Rotation/Hardware_M5/5mm_Bushing.SLDPRT

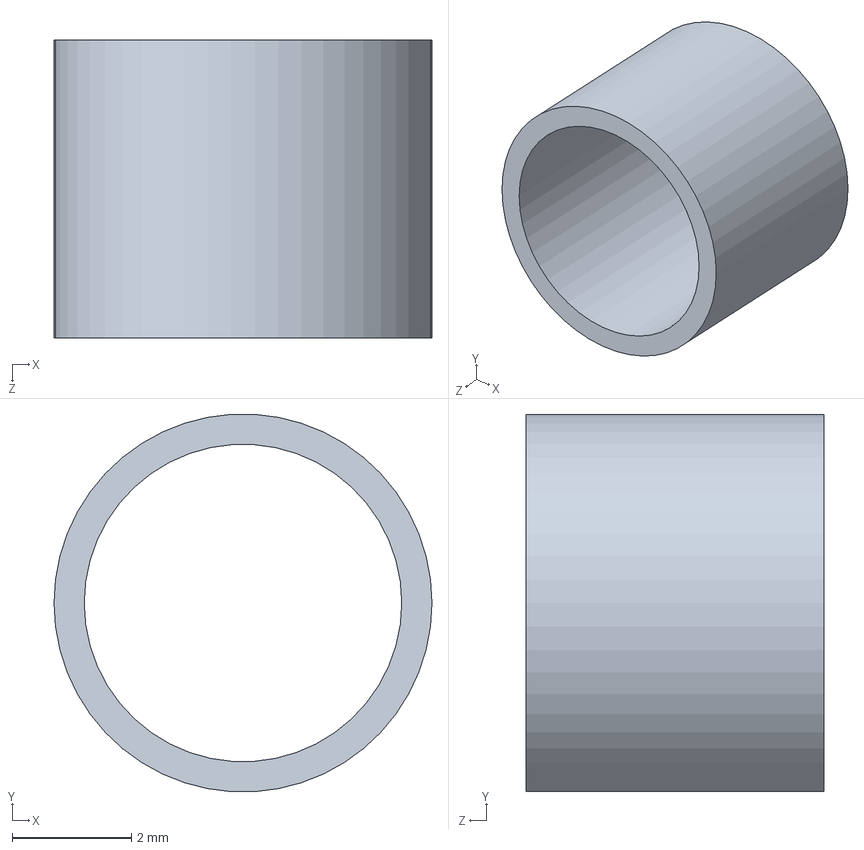
[picture p213: CAD file, 2021-02-03]
Wavemaker 3D Models/Camera Gimbal/Z-Rotation/Hardware_M5/5mm_Bushing.SLDPRT
6.35 x 6.34 x 5.00 mm
