MatthiasOPage/Wavemaker/Wavemaker 3D Models/Electronics/Boards/PCB_Basic.SLDPRT

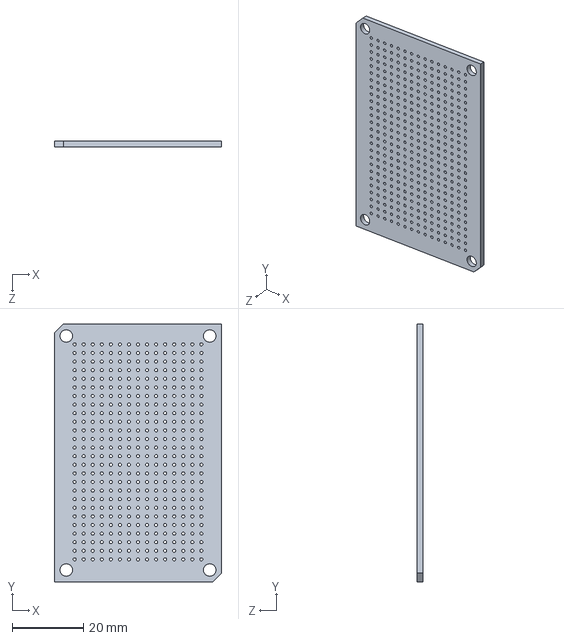
[picture p214: CAD file, 2020-11-19]
Wavemaker 3D Models/Electronics/Boards/PCB_Basic.SLDPRT
47.0 x 72.4 x 1.56 mm
