MatthiasOPage/Wavemaker/Wavemaker 3D Models/Electronics/Limits/Limit_Switch.SLDPRT

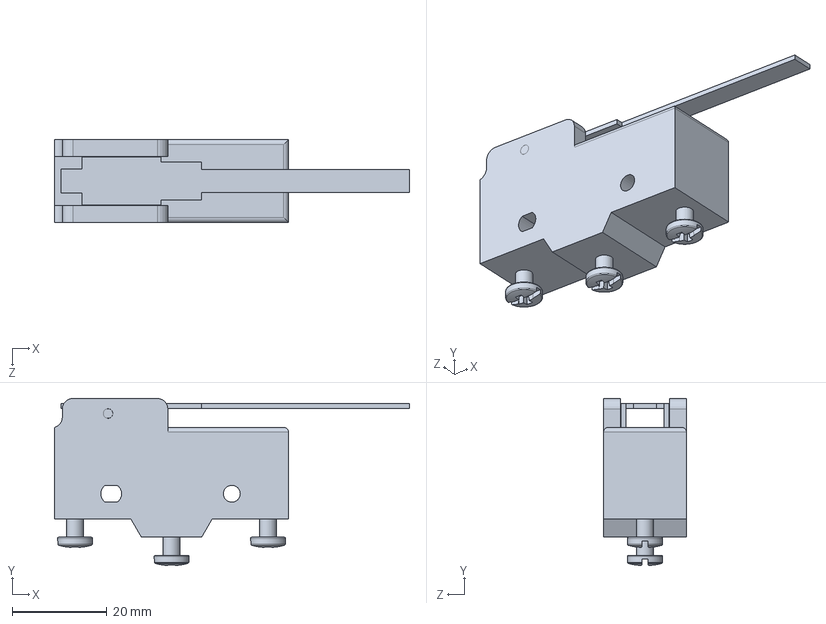
[picture p215: CAD file, 2020-11-19]
Wavemaker 3D Models/Electronics/Limits/Limit_Switch.SLDPRT
74.7 x 35.2 x 17.4 mm
