MatthiasOPage/Wavemaker/Wavemaker 3D Models/Electronics/Shelf Brackets/PSU_Mounting_Plate_Revised.SLDPRT

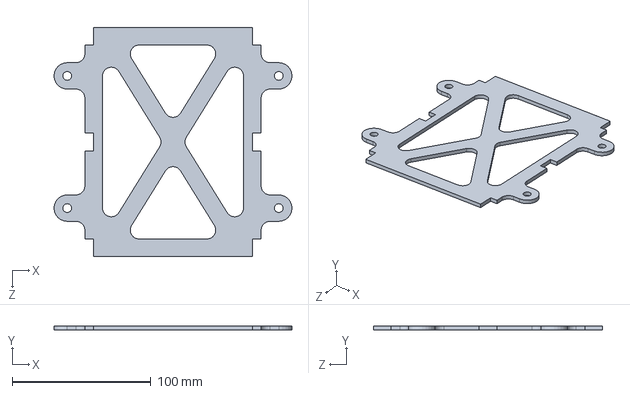
[picture p216: CAD file, 2020-11-19]
Wavemaker 3D Models/Electronics/Shelf Brackets/PSU_Mounting_Plate_Revised.SLDPRT
171.4 x 3.17 x 165.1 mm
