MatthiasOPage/Wavemaker/Wavemaker 3D Models/Frame Extrusions/Tread_8in.SLDPRT

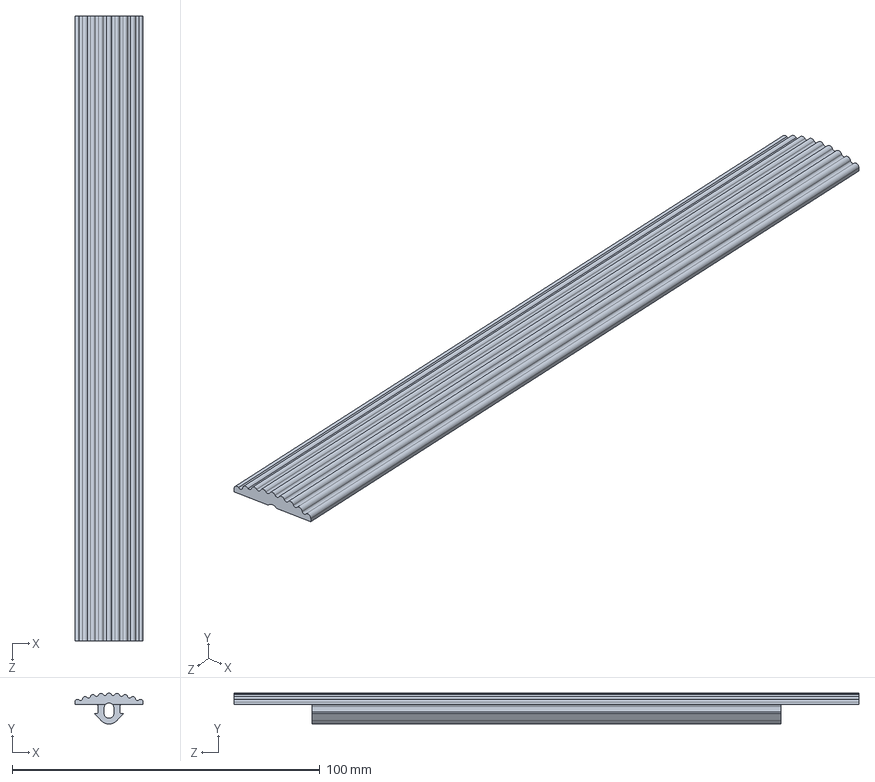
[picture p217: CAD file, 2020-11-19]
Wavemaker 3D Models/Frame Extrusions/Tread_8in.SLDPRT
22.2 x 10.1 x 203.2 mm
