MatthiasOPage/Wavemaker/Wavemaker 3D Models/Frame Hardware/Top_Brace_Rod.SLDPRT

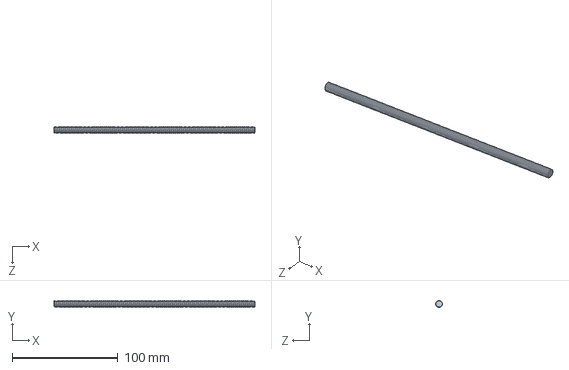
[picture p218: CAD file, 2020-11-19]
Wavemaker 3D Models/Frame Hardware/Top_Brace_Rod.SLDPRT
190.5 x 6.35 x 6.35 mm
