MatthiasOPage/Wavemaker/Wavemaker 3D Models/Tank Cart/SLDPRT_40_Series/40_Series/40-4012-BLACK-FB.sldprt

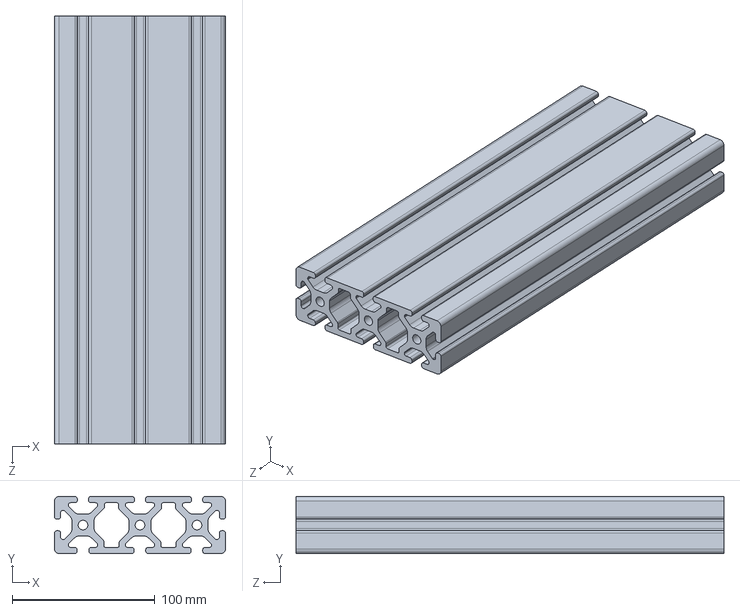
[picture p219: CAD file, 2020-11-25]
Wavemaker 3D Models/Tank Cart/SLDPRT_40_Series/40_Series/40-4012-BLACK-FB.sldprt
120.0 x 40.1 x 300.0 mm
