MatthiasOPage/Wavemaker/Wavemaker 3D Models/Wedge/Wedge_Front.SLDPRT

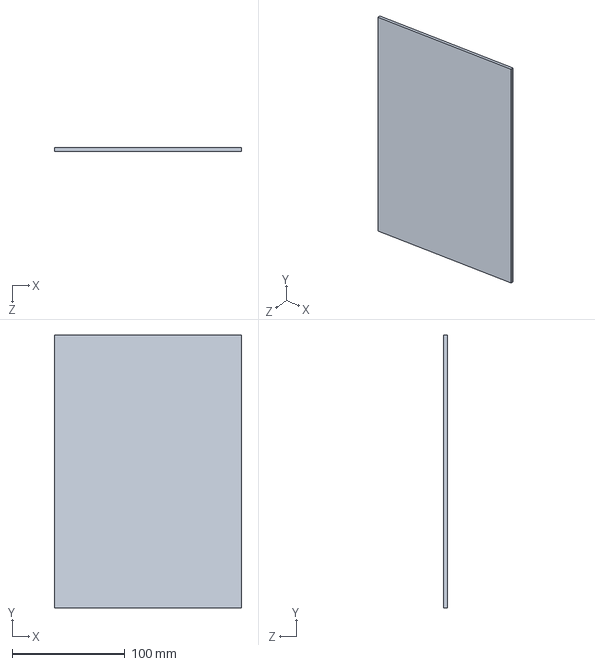
[picture p220: CAD file, 2020-11-19]
Wavemaker 3D Models/Wedge/Wedge_Front.SLDPRT
166.1 x 242.5 x 3.17 mm
