MatthiasOPage/Wavemaker/Wavemaker 3D Models/Camera Gimbal/X-Translation/Threaded_Rod_Nuts.SLDPRT

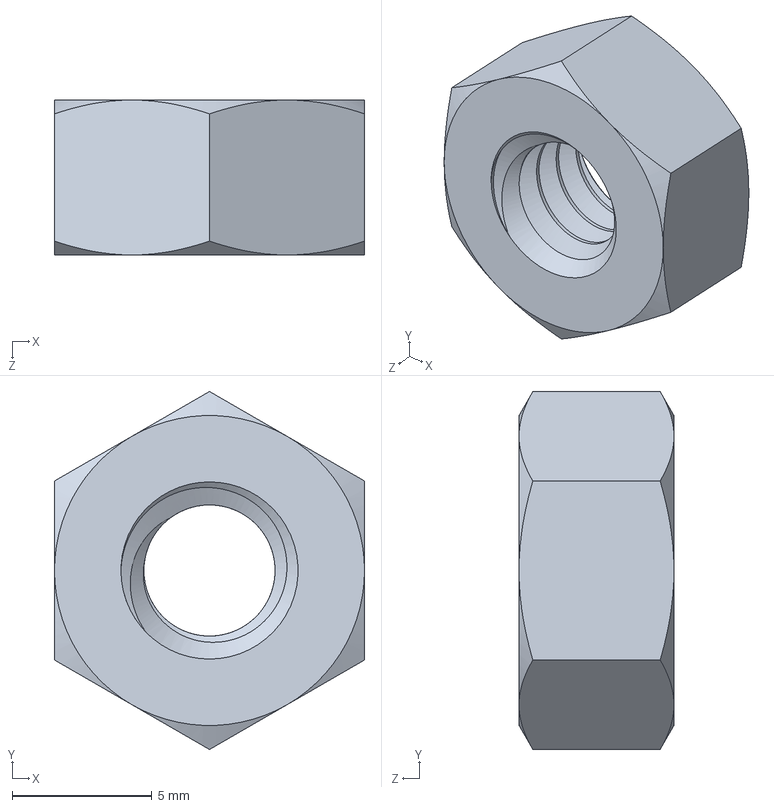
[picture p221: CAD file, 2021-02-03]
Wavemaker 3D Models/Camera Gimbal/X-Translation/Threaded_Rod_Nuts.SLDPRT
11.1 x 12.8 x 5.56 mm
