MatthiasOPage/Wavemaker/Wavemaker 3D Models/Camera Gimbal/Y-Rotation/Top_Disk.SLDPRT

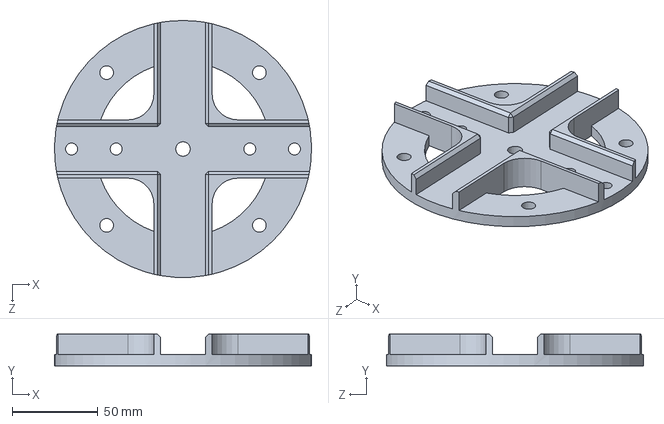
[picture p222: CAD file, 2021-02-03]
Wavemaker 3D Models/Camera Gimbal/Y-Rotation/Top_Disk.SLDPRT
149.9 x 18.5 x 150.0 mm
