MatthiasOPage/Wavemaker/Wavemaker 3D Models/Camera Gimbal/Z-Rotation/42-72mm_Linkage_bent_angle_M5.SLDPRT

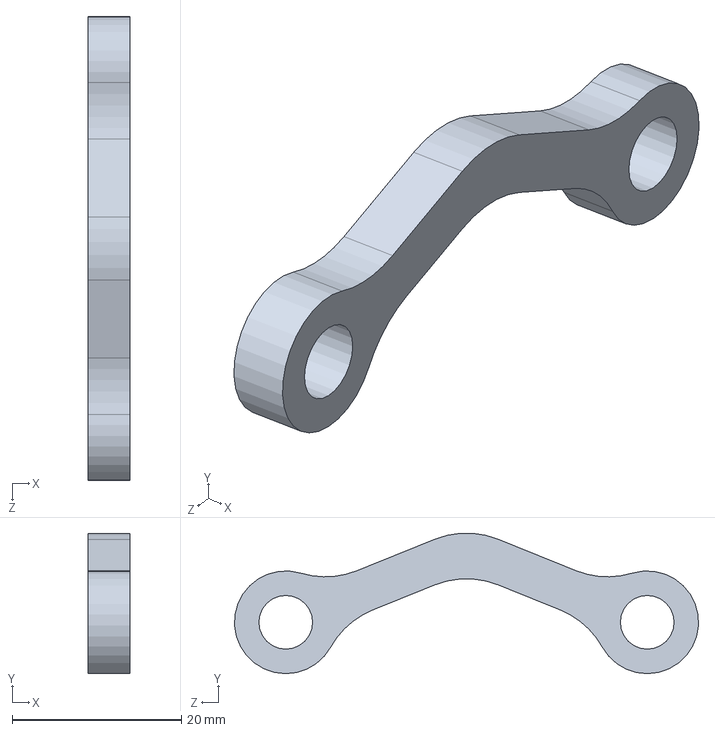
[picture p223: CAD file, 2021-02-03]
Wavemaker 3D Models/Camera Gimbal/Z-Rotation/42-72mm_Linkage_bent_angle_M5.SLDPRT
5.00 x 16.6 x 54.8 mm
