MatthiasOPage/Wavemaker/Wavemaker 3D Models/Electronics/Limits/Limit_Switch_Top.SLDPRT

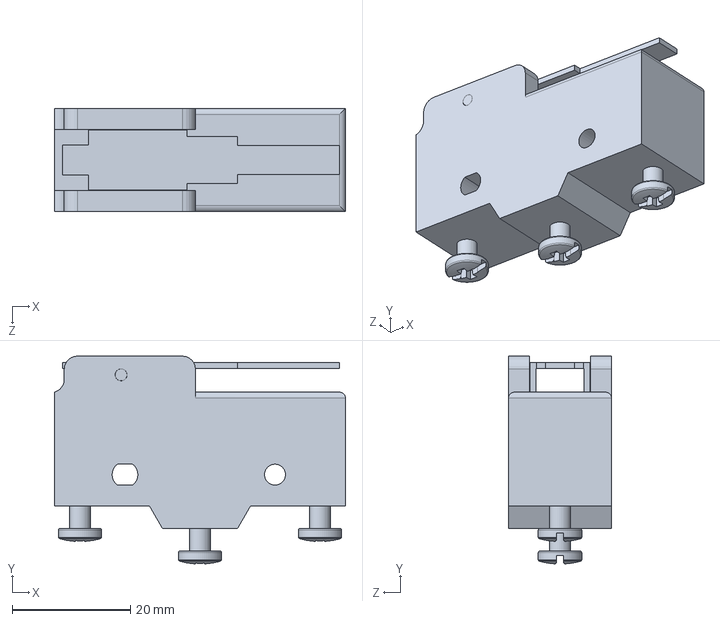
[picture p224: CAD file, 2020-11-19]
Wavemaker 3D Models/Electronics/Limits/Limit_Switch_Top.SLDPRT
49.3 x 35.2 x 17.4 mm
