MatthiasOPage/Wavemaker/Wavemaker 3D Models/Electronics/Shelf Brackets/PSU_Mounting_Plate.SLDPRT

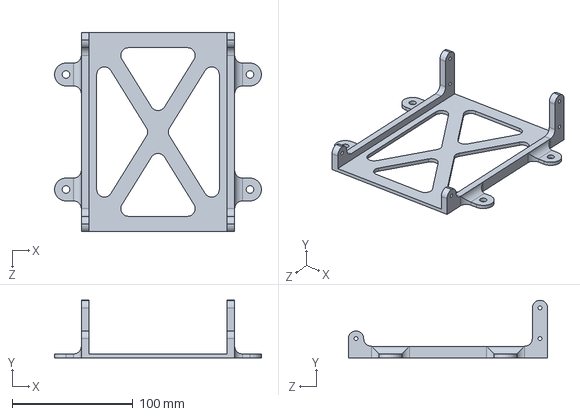
[picture p225: CAD file, 2020-11-19]
Wavemaker 3D Models/Electronics/Shelf Brackets/PSU_Mounting_Plate.SLDPRT
171.4 x 47.6 x 165.1 mm
