MatthiasOPage/Wavemaker/Wavemaker 3D Models/Frame Extrusions/20in.SLDPRT

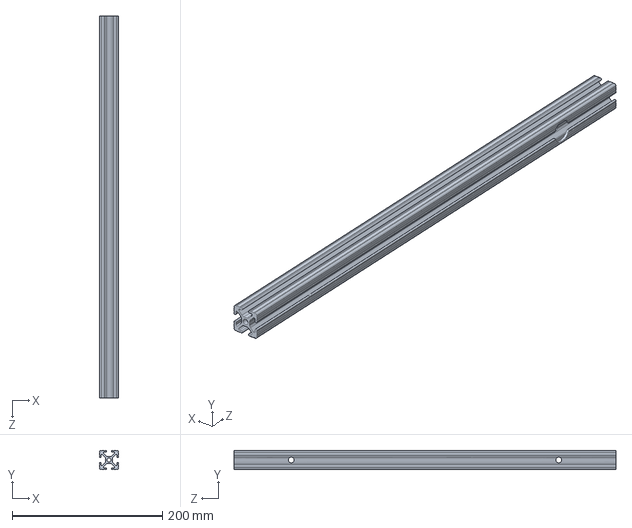
[picture p226: CAD file, 2020-11-19]
Wavemaker 3D Models/Frame Extrusions/20in.SLDPRT
25.4 x 25.4 x 508.0 mm
