MatthiasOPage/Wavemaker/Wavemaker 3D Models/Frame Hardware/Idlers/Idler_Threaded_Rod.SLDPRT

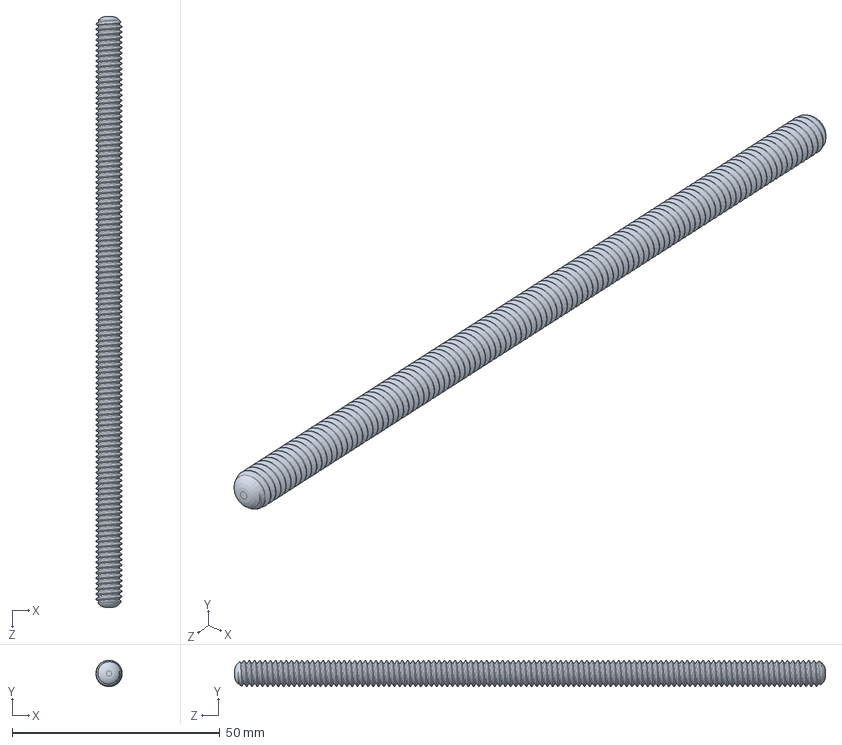
[picture p227: CAD file, 2020-11-19]
Wavemaker 3D Models/Frame Hardware/Idlers/Idler_Threaded_Rod.SLDPRT
6.35 x 6.34 x 142.2 mm
