MatthiasOPage/Wavemaker/Wavemaker 3D Models/Wedge/Wedge_Top.SLDPRT

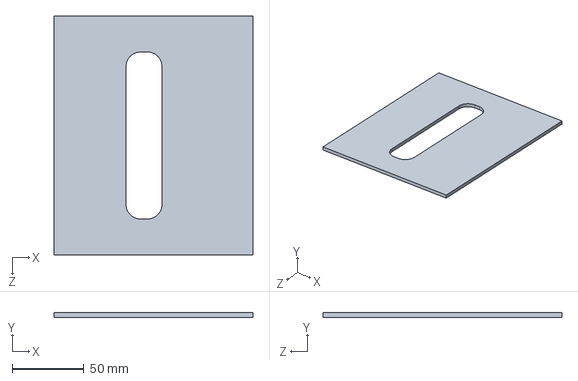
[picture p228: CAD file, 2020-11-19]
Wavemaker 3D Models/Wedge/Wedge_Top.SLDPRT
138.2 x 3.17 x 166.1 mm
