MatthiasOPage/Wavemaker/Wavemaker 3D Models/Basic Models/Frame_Brackets_Basic.SLDPRT

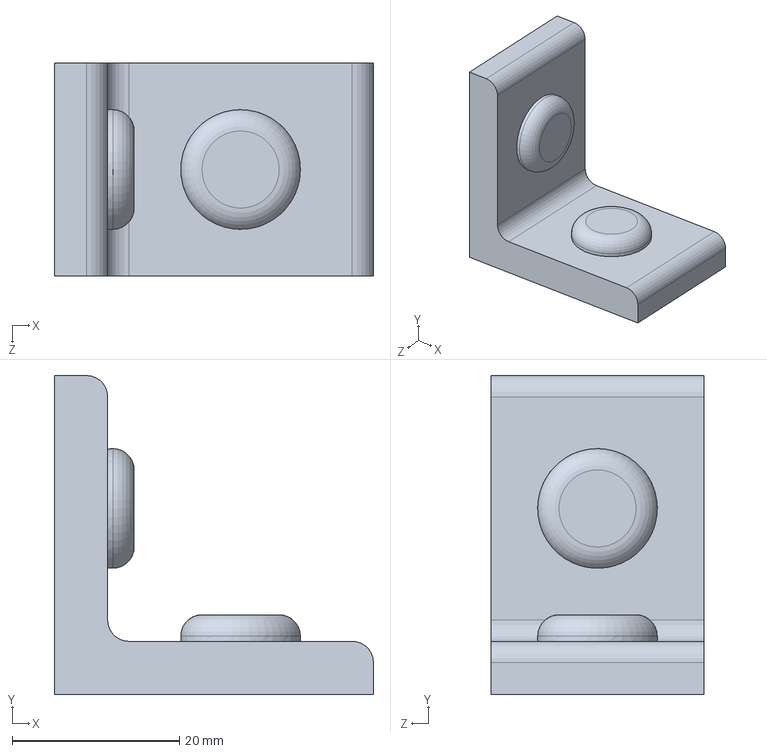
[picture p229: CAD file, 2020-11-19]
Wavemaker 3D Models/Basic Models/Frame_Brackets_Basic.SLDPRT
38.1 x 38.1 x 25.4 mm
