MatthiasOPage/Wavemaker/Wavemaker 3D Models/Camera Gimbal/Y-Rotation/M8_Knob.SLDPRT

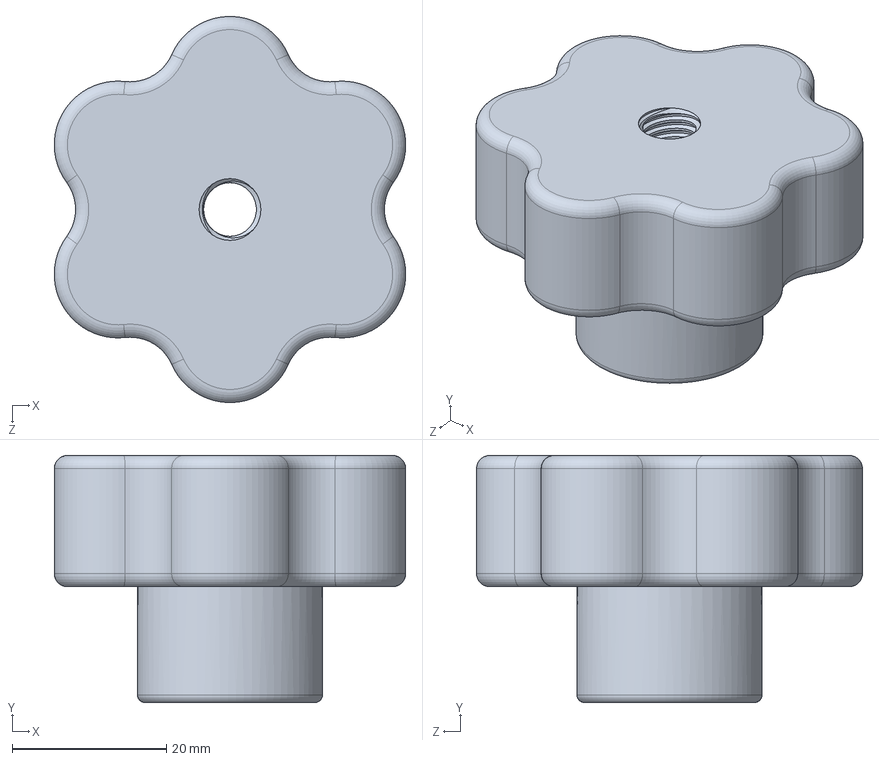
[picture p230: CAD file, 2021-02-03]
Wavemaker 3D Models/Camera Gimbal/Y-Rotation/M8_Knob.SLDPRT
45.5 x 32.0 x 50.0 mm
