MatthiasOPage/Wavemaker/Wavemaker 3D Models/Camera Gimbal/Z-Rotation/Hardware_M5/16mm_M5x0-8.SLDPRT

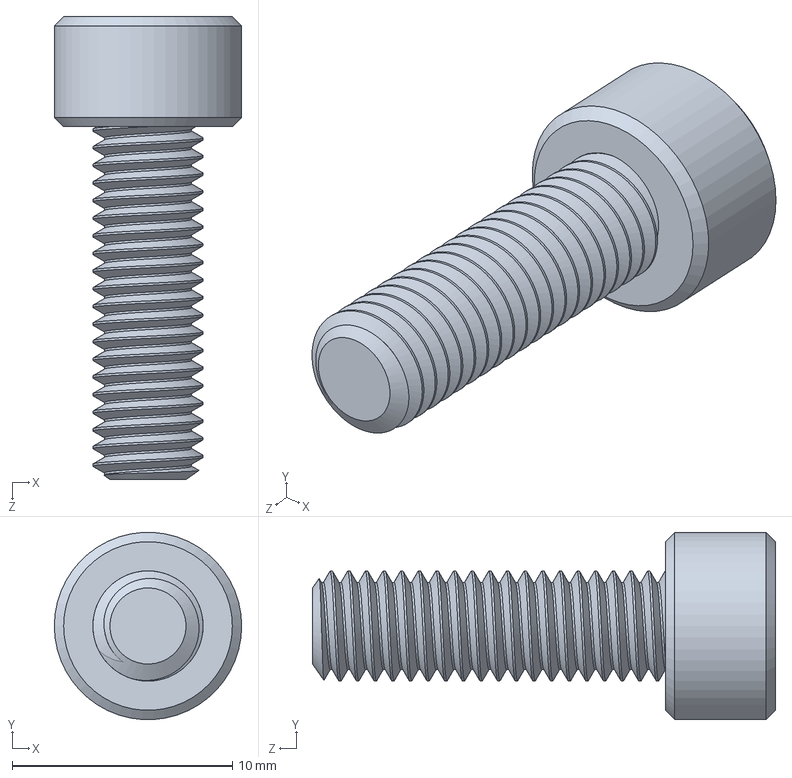
[picture p231: CAD file, 2021-02-03]
Wavemaker 3D Models/Camera Gimbal/Z-Rotation/Hardware_M5/16mm_M5x0-8.SLDPRT
8.50 x 8.48 x 21.0 mm
