MatthiasOPage/Wavemaker/(list of files, cad)

Other CAD files:
Wavemaker 3D Models/Tank Cart/8020_652714/SOLIDWORKS/65_2714.sldasm
Wavemaker 3D Models/Tank Cart/CartAssemblyWithSuper.SLDASM
Wavemaker 3D Models/Tank Cart/8020_402060/40_2060.sldprt
Wavemaker 3D Models/Tank Cart/8020_403368/40_3368.sldprt
Wavemaker 3D Models/Tank Cart/8020_404290/40_4290.sldprt
Wavemaker 3D Models/Tank Cart/8020_404352/40_4352.sldprt
Wavemaker 3D Models/Electronics Shelf/Shelf Frame/Electronics_Bracket_Side_Brackets_Left.SLDPRT
Wavemaker 3D Models/Tank Cart/8020_652714/SOLIDWORKS/_65_2714_plate_2.sldprt
Wavemaker 3D Models/Tank Cart/8020_652714/SOLIDWORKS/_65_2714_wheel_6.sldprt
Wavemaker 3D Models/Tank Cart/8020_652714/SOLIDWORKS/_65_2714_body_4.sldprt
Wavemaker 3D Models/Tank Cart/SLDPRT_40_Series/40_Series/40-4082-LITE-BLACK-FB.sldprt
Wavemaker 3D Models/Wedge/Wedge_Top_90.SLDPRT
Wavemaker 3D Models/Electronics Shelf/Shelf Hardware/Backpack_Rail_Nuts.SLDPRT
Wavemaker 3D Models/Electronics/Shelf Brackets/Electronics_Mounting_Bracket.SLDPRT
Wavemaker 3D Models/Frame Extrusions/1x1_8020_Profile.SLDPRT
Wavemaker 3D Models/Tank Cart/SLDPRT_40_Series/40_Series/40-4085-LITE.sldprt
Wavemaker 3D Models/Camera Gimbal/Z-Rotation/Pre-M5/Camera_Swing_Bracket.SLDPRT
Wavemaker 3D Models/Camera Gimbal/Z-Rotation/Tripod_Adapter_Layout_Appr..SLDPRT
Wavemaker 3D Models/Tank Cart/40S-48cm.SLDPRT
Wavemaker 3D Models/Tank Cart/40S-140cmSuper.SLDPRT
Wavemaker 3D Models/Tank Cart/SLDPRT_40_Series/40_Series/40-4002.sldprt
Wavemaker 3D Models/3D Printer Files/8020_Encaps.STL
Wavemaker 3D Models/3D Printer Files/3_Corner_Bracket.STL
Wavemaker 3D Models/3D Printer Files/8020_Encaps_Flat.STL
Wavemaker 3D Models/3D Printer Files/Bottom_Limit_8020_Nut.STL
Wavemaker 3D Models/3D Printer Files/Bottom_Limit_Bracket.STL
Wavemaker 3D Models/3D Printer Files/Button_Bracket.STL
Wavemaker 3D Models/3D Printer Files/Button_Bracket_Narrow.STL
Wavemaker 3D Models/3D Printer Files/Button_Spacer.STL
Wavemaker 3D Models/3D Printer Files/LimitBracketA.2.STL
Wavemaker 3D Models/3D Printer Files/LimitBracketA.3.STL
Wavemaker 3D Models/3D Printer Files/LimitBracketA.STL
Wavemaker 3D Models/3D Printer Files/Limit_Bracket_Basic.STL
Wavemaker 3D Models/3D Printer Files/Limit_Clip_Inner.STL
Wavemaker 3D Models/3D Printer Files/Limit_Clip_Outer.STL
Wavemaker 3D Models/3D Printer Files/Lock_Nut_A.STL
Wavemaker 3D Models/3D Printer Files/Lock_Pin_Knob_B.STL
Wavemaker 3D Models/3D Printer Files/Lock_Pin_Shaft_B.STL
Wavemaker 3D Models/3D Printer Files/PSU_Bracket_Sides.STL
Wavemaker 3D Models/3D Printer Files/PSU_Mounting_Plate_A.STL
Wavemaker 3D Models/3D Printer Files/PSU_Mounting_Plate_PRINT.STL
Wavemaker 3D Models/3D Printer Files/PSU_Mounting_Plate_Revised.STL
Wavemaker 3D Models/3D Printer Files/Twist_Pin.STL
Wavemaker 3D Models/Basic Models/Belt_Basic.SLDPRT
Wavemaker 3D Models/Basic Models/Belt_Pulley_Basic.SLDPRT
Wavemaker 3D Models/Basic Models/Idler_Basic.SLDPRT
Wavemaker 3D Models/Basic Models/Sled_Basic.SLDPRT
Wavemaker 3D Models/Camera Gimbal/Full Assembly Hardware/25mm_M5x0-8_Bolt.SLDPRT
Wavemaker 3D Models/Camera Gimbal/Full Assembly Hardware/60mmmm_M5x0-8_Bolt.SLDPRT
Wavemaker 3D Models/Camera Gimbal/Full Assembly Hardware/Squash_Plate_to_X_Rails_Bolts.SLDASM
Wavemaker 3D Models/Camera Gimbal/X-Translation/0.24-20_Washer.SLDPRT
Wavemaker 3D Models/Camera Gimbal/X-Translation/8mm_M5x0-8_Bolt.SLDPRT
Wavemaker 3D Models/Camera Gimbal/X-Translation/Endcap_Nut_Assem.SLDASM
Wavemaker 3D Models/Camera Gimbal/X-Translation/Nylock_0.25-20_Nut.SLDPRT
Wavemaker 3D Models/Camera Gimbal/Y-Rotation/2in_Washer.SLDPRT
Wavemaker 3D Models/Camera Gimbal/Y-Rotation/Bottom_Disk_Bolt_Sink.SLDPRT
Wavemaker 3D Models/Camera Gimbal/Y-Rotation/M8_Cap_Nut.SLDPRT
Wavemaker 3D Models/Camera Gimbal/Y-Rotation/M8_Pivot_Bolt.SLDPRT
Wavemaker 3D Models/Camera Gimbal/Y-Rotation/M8_Washer.SLDPRT
Wavemaker 3D Models/Camera Gimbal/Z-Carriage/10mm_M5x0-8_Bolt.SLDPRT
Wavemaker 3D Models/Camera Gimbal/Z-Carriage/12mm_M6_Bolt.SLDPRT
Wavemaker 3D Models/Camera Gimbal/Z-Carriage/16mm_M5x0-8_Bolt.SLDPRT
Wavemaker 3D Models/Camera Gimbal/Z-Carriage/18mm_M5x0-8_Setscrew.SLDPRT
Wavemaker 3D Models/Camera Gimbal/Z-Carriage/2525_340mm_SLDPRT.SLDPRT
Wavemaker 3D Models/Camera Gimbal/Z-Carriage/2525_500mm.sldprt
Wavemaker 3D Models/Camera Gimbal/Z-Carriage/2525_500mm_SLDPRT.SLDPRT
Wavemaker 3D Models/Camera Gimbal/Z-Carriage/25mm_M5_Bolt.SLDPRT
Wavemaker 3D Models/Camera Gimbal/Z-Carriage/40mm_M5x0-8_Bolt.SLDPRT
Wavemaker 3D Models/Camera Gimbal/Z-Carriage/40mm_M5x0-8_Cam_Lock_Bolt.SLDPRT
Wavemaker 3D Models/Camera Gimbal/Z-Carriage/40mm_M6_Bolt.SLDPRT
Wavemaker 3D Models/Camera Gimbal/Z-Carriage/40mm_M6x1_Cam_Lock_Bolt.SLDPRT
Wavemaker 3D Models/Camera Gimbal/Z-Carriage/45mm_M6_Bolt.SLDPRT
Wavemaker 3D Models/Camera Gimbal/Z-Carriage/50mm_M5x0-8_Bolt.SLDPRT
Wavemaker 3D Models/Camera Gimbal/Z-Carriage/50mm_M6_Bolt.SLDPRT
Wavemaker 3D Models/Camera Gimbal/Z-Carriage/8mm_M5x0-8_Nut.SLDPRT
Wavemaker 3D Models/Camera Gimbal/Z-Carriage/Cam_Lock.SLDPRT
Wavemaker 3D Models/Camera Gimbal/Z-Carriage/Cam_Lock_M5.SLDPRT
Wavemaker 3D Models/Camera Gimbal/Z-Carriage/Cam_Lock_Nut.SLDPRT
Wavemaker 3D Models/Camera Gimbal/Z-Carriage/Idler_Spring.SLDPRT
Wavemaker 3D Models/Camera Gimbal/Z-Carriage/M5_1mm_Washer.SLDPRT
Wavemaker 3D Models/Camera Gimbal/Z-Carriage/M6_1.5mmT_Washer.SLDPRT
Wavemaker 3D Models/Camera Gimbal/Z-Carriage/M6_1mmT_Washer.SLDPRT
Wavemaker 3D Models/Camera Gimbal/Z-Carriage/M6_Fender_Washer.SLDPRT
Wavemaker 3D Models/Camera Gimbal/Z-Carriage/M6_Top_Bearing_Setscrew.SLDPRT
Wavemaker 3D Models/Camera Gimbal/Z-Carriage/M8_Fender_Washer-24mmOD.SLDPRT
Wavemaker 3D Models/Camera Gimbal/Z-Carriage/Nut_M6.SLDPRT
Wavemaker 3D Models/Camera Gimbal/Z-Carriage/Outdated/Z_Carriage_Roller_Plate.SLDPRT
Wavemaker 3D Models/Camera Gimbal/Z-Carriage/Outdated/Z_Carriage_Roller_Plate_Bottom.SLDPRT
Wavemaker 3D Models/Camera Gimbal/Z-Carriage/Outdated/Z_Carriage_Roller_Plate_Bottom_B.SLDPRT
Wavemaker 3D Models/Camera Gimbal/Z-Carriage/Outdated/Z_Carriage_Roller_Plate_Bottom_B_Mirror.SLDPRT
Wavemaker 3D Models/Camera Gimbal/Z-Carriage/Outdated/Z_Carriage_Roller_Plate_Top_B.SLDPRT
Wavemaker 3D Models/Camera Gimbal/Z-Carriage/Outdated/Z_Carriage_Roller_Plate_Top_B_Mirror.SLDPRT
Wavemaker 3D Models/Camera Gimbal/Z-Carriage/Roller_Bearing_Actual.SLDPRT
Wavemaker 3D Models/Camera Gimbal/Z-Carriage/Roller_Bearing_Placeholder.SLDPRT
Wavemaker 3D Models/Camera Gimbal/Z-Carriage/Z-Carriage_Bolt_Standoff_Assembly.SLDASM
Wavemaker 3D Models/Camera Gimbal/Z-Carriage/Z-Carriage_Standoff.SLDPRT
Wavemaker 3D Models/Camera Gimbal/Z-Carriage/Z_Carriage_Roller_Plate_Bottom_5mm.SLDPRT
Wavemaker 3D Models/Camera Gimbal/Z-Carriage/Z_Carriage_Roller_Plate_Bottom_C.SLDPRT
Wavemaker 3D Models/Camera Gimbal/Z-Carriage/Z_Carriage_Roller_Plate_Top_5mmHoles.SLDPRT
Wavemaker 3D Models/Camera Gimbal/Z-Carriage/Z_Carriage_Roller_Plate_Top_C.SLDPRT
Wavemaker 3D Models/Camera Gimbal/Z-Rotation/Adapter_Appr.SLDPRT
Wavemaker 3D Models/Camera Gimbal/Z-Rotation/Hardware_M5/10mm_M5x0-8_Bolt.SLDPRT
Wavemaker 3D Models/Camera Gimbal/Z-Rotation/Hardware_M5/30mm_M5x0-8_Bolt.SLDPRT
Wavemaker 3D Models/Camera Gimbal/Z-Rotation/Hardware_M5/45mm_M5x0-8_Bolt.SLDPRT
Wavemaker 3D Models/Camera Gimbal/Z-Rotation/Hardware_M5/4mm_Bushing.SLDPRT
Wavemaker 3D Models/Camera Gimbal/Z-Rotation/Hardware_M5/5-3_IDx10mm_OD_Washer.SLDPRT
Wavemaker 3D Models/Camera Gimbal/Z-Rotation/Hardware_M5/6mm_Bushing.SLDPRT
Wavemaker 3D Models/Camera Gimbal/Z-Rotation/Hardware_M5/8mm_M5x0-8_Nut.SLDPRT
Wavemaker 3D Models/Camera Gimbal/Z-Rotation/Hardware_M5/Rotation_Lock.SLDPRT
Wavemaker 3D Models/Camera Gimbal/Z-Rotation/Hardware_M5/Slider_Bolt_Assembly_M5.SLDASM
Wavemaker 3D Models/Camera Gimbal/Z-Rotation/Knob.SLDPRT
Wavemaker 3D Models/Camera Gimbal/Z-Rotation/Mounting_Plate_M5.SLDPRT
Wavemaker 3D Models/Camera Gimbal/Z-Rotation/Outdated/42-72mm_Linkage.SLDPRT
Wavemaker 3D Models/Camera Gimbal/Z-Rotation/Outdated/42-72mm_Linkage_bent.SLDPRT
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
