MatthiasOPage/Wavemaker/Documents/Manual Raws/WavemakerGuideRev1.3.docx

Wavemaker Manual

by Matthias Page

University of New Hampshire

Chase 185

Table of Contents:

Daily Operation

- Mechanical………………………………………………………………………………………………………….…………3
  - Positioning the Wavemaker (Pg. 3)
  - Getting Ready to Run (Pg. 4)
- Software………………………………………………………………………………………………….…………………….4
  - Computer (Pg. 5)
  - Making Waves (Pg. 5-7)
  - Common Issues (Pg. 7)

Initial Setup

- Mechanical Setup.……………………………………………………………………………………………..………..…8
  - Belt (Pg. 8-9)
  - Wedge (Pg. 10-11)
  - Electronics Shelf (Pg. 11)
  - Electronic (Pg. 12-13)
  - Limit Calibration (Pg. 14)
- Software Setup.……………………………………………………………………………………..…………………….14
  - Arduino (Pg. 14-15)
  - Libraries (Pg. 15)
  - Firmware Integration (Pg. 15-16)

Maintenance

- Per-Operation Maintenance……………………………………………………………………………………..….17
  - Belt Tension (Pg. 17)
  - Rotary Encoder Engagement (Pg. 17)
  - Wiring Connections (Pg. 18-19)
  - Switch Triggering (Pg. 20)
  - Panic Button (Pg. 20)
- Weekly Maintenance……………………………………………………………………………………………….…..21
  - Recoating Wedge [TREAT WEDGE] (Pg. 21)
  - Cleaning Water [CLEAN WATER] (Pg. 21)
  - Lubricating Rails and Axels [LUBRICATE RAILS & AXLES] (Pg. 21-22)
  - Checking Wedge Seal [CHECK WEDGE SEAL] (Pg. 22-23)
- Monthly Maintenance…………………………………………………………………………………..……………..23
  - Check Fasteners [CHECK ALL FASTENERS] (Pg. 23)
  - Check Rail Parallel [CHECK RAIL PARALLEL] (Pg. 23-24)
  - Cleaning Belt and Idlers [CLEAN BELT & IDLERS] (Pg. 24)
  - Checking for Wear [CHECK PARTS FOR WEAR] (Pg. 25)
- Pre-Lab Shutdown Maintenance………………………………………………………………………………..…26
  - Remove Tension from Belt [SLACKEN BELT] (Pg. 26)
  - Dry and Store Wavemaker [DRY & STORE] (Pg. 26)

Future Features

- Time Series Rotary Encoder Data………………………………………………………………………………….27
- Improved Microcontroller…………………………………………………………………………………………….27
- Freeform Movement Input…………………………………………………………………………………………..27
- Upper Limit Overhaul……………………………………………………………………………………………………27

Daily Operation:

Guide on how to run the wavemaker’s systems for lab use

Mechanical:

Operating the mechanical side of the wavemaker

Initial setup:

1. Prior to operation, ensure Initial Setup: Mechanical and Per-Operation Maintenance have been completed in entirety. These procedures can be found by referencing this document (See Pages: 8, 14) and “Wave Maker Maintenance Guide” respectively.

Positioning the Wavemaker:

1. Pick up wavemaker and place frame slot over end wall of wave tank {Fig 1.a}
2. Ensure wavemaker is pushed as far forward into the tank as necessary to accommodate bottom limit trigger finger to move freely {Fig 1.b}
3. Adjust frame to ensure wedge is centered and straight down the wave tank {Fig 1.c}
4. Manually move wedge to its limits ensuring nothing is hitting unexpectedly

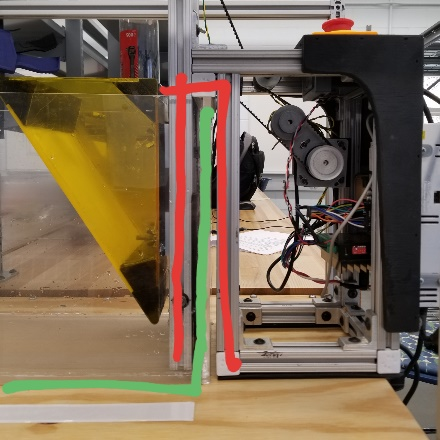
[picture p232: figure]
Fig 1.a
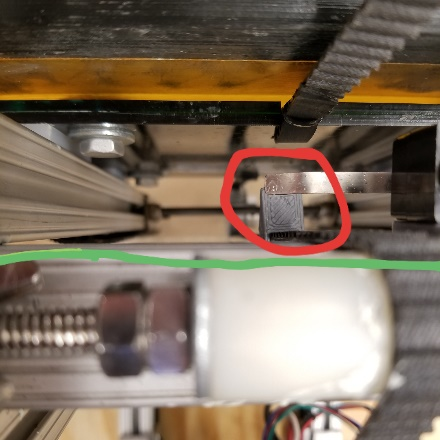
[picture p233: figure]
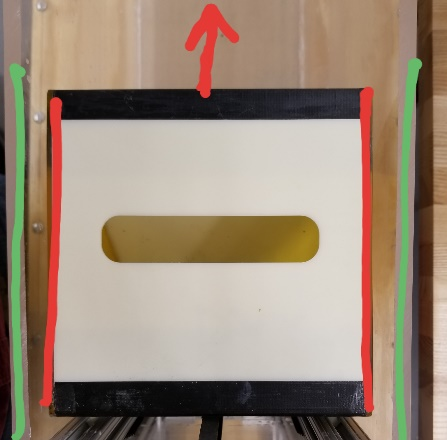
[picture p234: figure]

Fig 1.a | Fig 1.b | Fig 1.c

Getting Ready to Run:

1. Plug wavemaker into a GFCI protected outlet
2. Twist panic button to power on electronics {Fig 2.a}
3. If necessary, clamp wavemaker down to tank cart

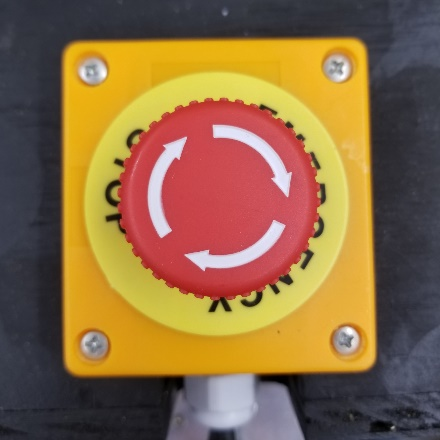
[picture p235: figure]

Fig 2.a

Software:

Guide on how to use the wavemaker code to produce waves

Initial Setup:

1. Prior to running Arduino code make sure to complete Initial Setup: Software. This procedure can be found by referencing the Initial Setup section in this document (See Page: 12)

Computer:

1. Check that toggle switch is OFF (unlit) {Fig 3.a}
2. Plug Arduino into computer via the USB A to B cable {Fig 3.b&c}
3. Open the most recent version of “WaveMaker” Arduino code
4. Check Arduino->tools->board to make sure the board is recognized {Fig 3.d}

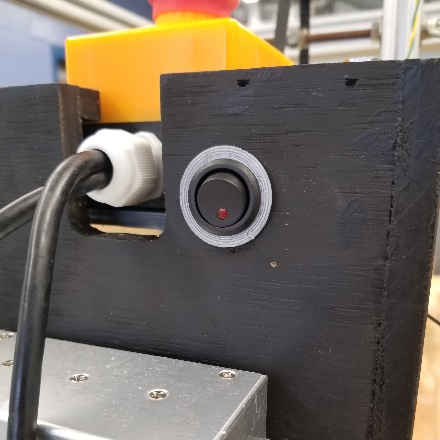
[picture p236: figure]
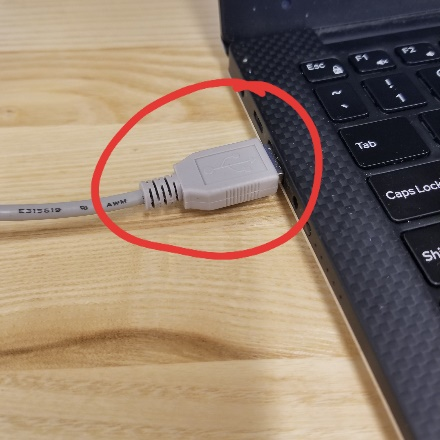
[picture p237: figure]
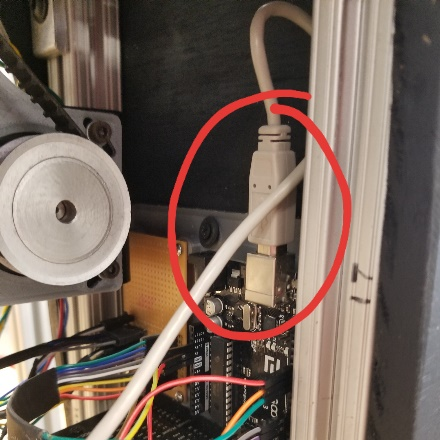
[picture p238: figure]

Fig 3.a | Fig 3.b | Fig 3.c

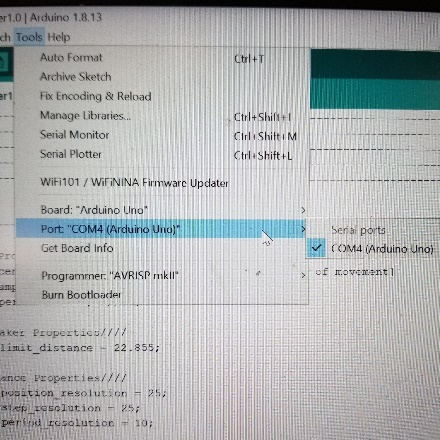
[picture p239: figure]

Fig 3.d

Making Waves:

1. Under “Wave Properties” input values {Fig 4.a}

Note: Ensure that Period ≥ 0.15×Amplitude to prevent calibration failure (Soon to be automatically done in code)

Note: Check that Center_cm+Amplitude ≤ 0.5×limit_distance to prevent mechanical crashing (Soon to be automatically done in code)

2. Verify code prior to uploading to Arduino
3. Upload code to Arduino
4. Open Serial Monitor
5. Wavemaker will begin homing sequence (Watch Serial Monitor for details) {Fig 4.b}
6. Software calibration will run to fine tune movement {Fig 4.c}
7. Once calibration is complete use toggle switch to run or pause movement {Fig 4.d}
8. Turn off toggle switch prior to unplugging Arduino from computer

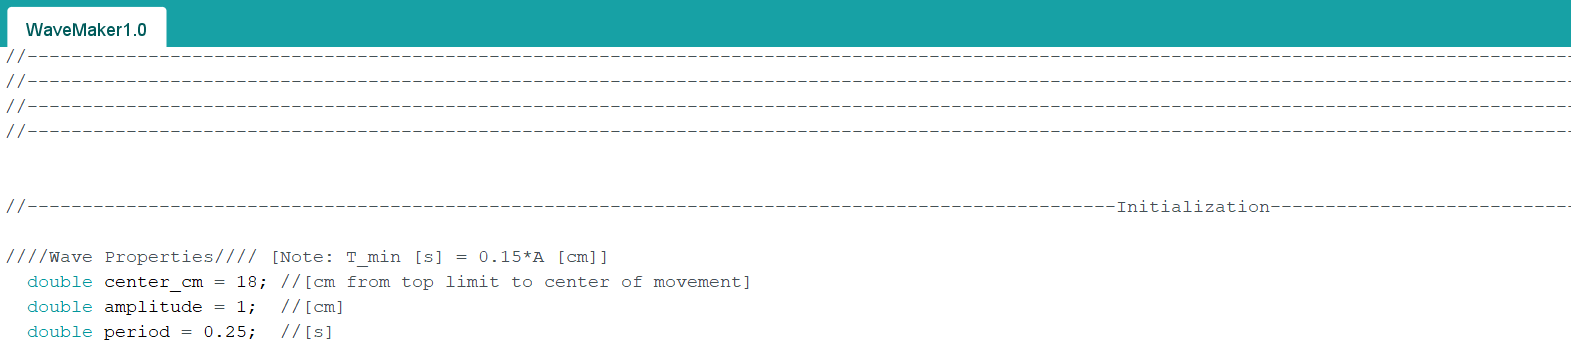
[picture p240: figure]

Fig 4.a

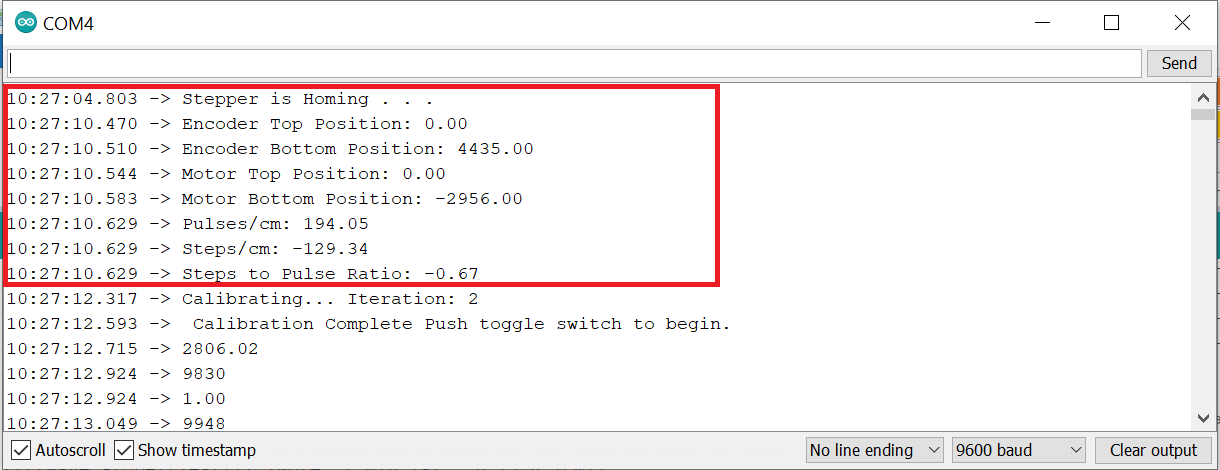
[picture p241: figure]
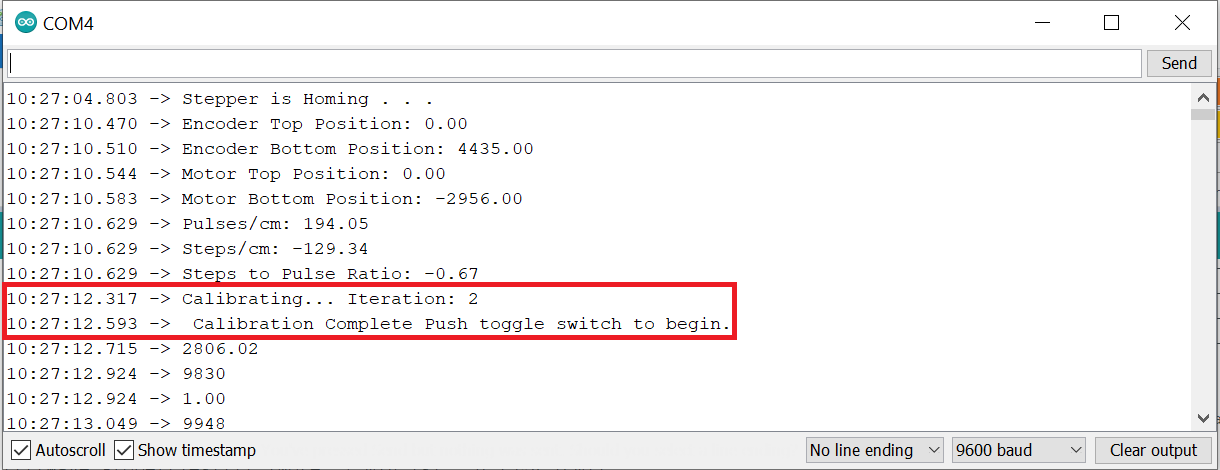
[picture p242: figure]

Fig 4.b | Fig 4.c

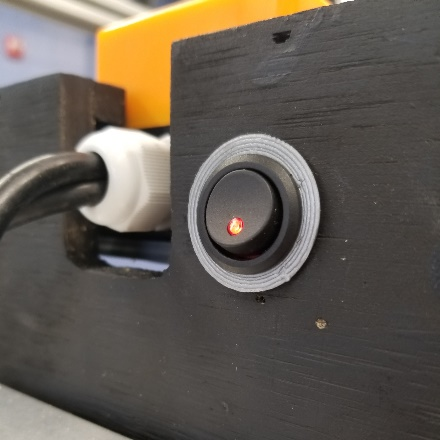
[picture p243: figure]

Fig 4.d

Common Issues:

1. Can’t upload code
  a. Check your Arduino is recognized on the correct port
  b. Check for typos from adjusting parameters
2. Wavemaker won’t move
  a. Check that toggle is in the ON (lit) position
  b. Ensure the panic button has not accidentally been triggered
  c. Check wiring to Arduino for loose wires

Initial Setup:

How to setup wavemaker for use after storage or transportation.

Note: wavemaker should not be in tank.

Mechanical Setup:

How to setup the mechanical constituent of the wavemaker

Initial Setup:

1. Ensure all components are present {Fig 5.a}
  a. Frame
  b. Wedge
  c. Belt and sled assembly (on frame)
  d. Electronics Shelf

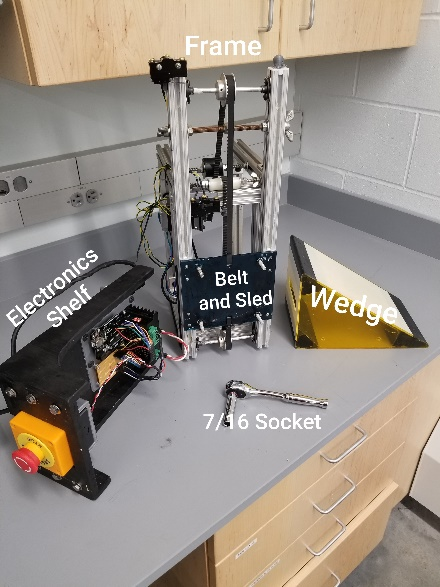
[picture p244: figure]

Fig 5.a

Belt:

1. Gently set sled at bottom position
2. Check that zip-ties holding belt ends are tight and in good condition {Fig 6.a}
3. Path belt around pulleys, motor, and rotary encoder {Fig 6.b}
  a. Around bottom
  b. Bottom part of belt straight up over white pulley
  c. Pull belt around motor pulley
  d. Over top of rotary pulley
  e. Under black pulley
  f. Around top pulley
4. Ensure the pulley is correctly pathed IF IT ISN’T STUFF CAN BREAK
5. Loosen wingnuts on black idler {Fig 6.c}
6. Slide black idler against pulley until belt is taught (roughly ½” of give when pressed)
7. Tighten wingnuts on black idler {Fig 6.d}
8. Check that the belt is riding on white idler {Fig 6.e}
  a. If idler isn’t engaged, loosen wingnuts and slide white idler forward until belt engages.
9. Check that the wedge can be easily moved up and down manually (gentle so as not to crash the limit switches)

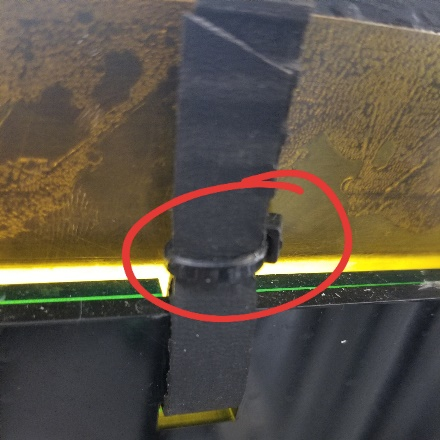
[picture p245: figure]
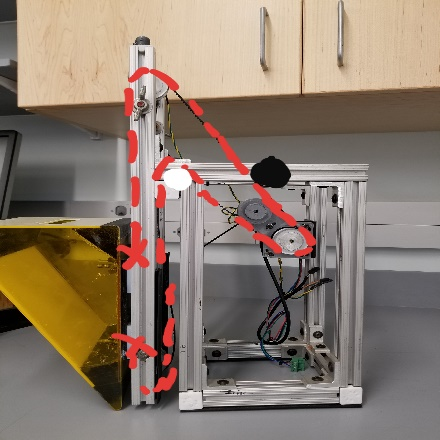
[picture p246: figure]
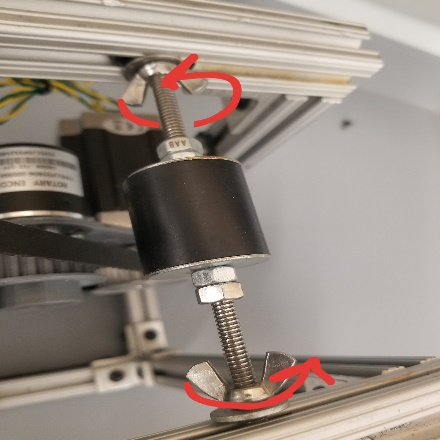
[picture p247: figure]

Fig 6.a | Fig 6.b | Fig 6.c

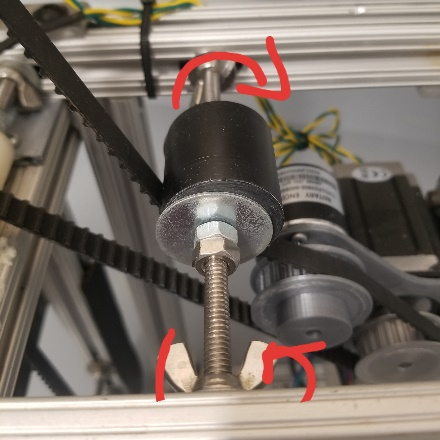
[picture p248: figure]
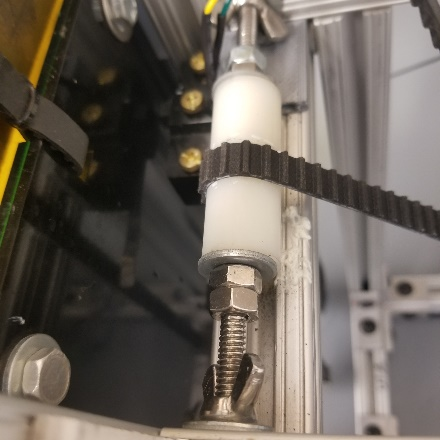
[picture p249: figure]

Fig 6.d | Fig 6.e

Wedge:

1. Check wedge for cracks or deep cuts
2. Bring sled to middle position
3. Ensure 4 mating bolts are completely flush with the back of the sled {Fig 7.a}
4. Place O-rings onto each bolt shanks {Fig 7.b&c}

Note: the O-ring should be squished between sled acrylic and back acrylic of wedge. Apply O-ring grease if necessary

5. Take off wedge lid
6. Slide wedge, pointing down, onto bolts {Fig 7.d}
7. Place washers inside wedge against back wall acrylic {Fig 7.e&f}
8. Gently start each wingnut onto the four bolts {Fig 7.g}

Note: These bolts are ALUMINUM and can strip very easily so take care

9. Finger tighten the wingnuts in a circular pattern until each nut is two-finger tight
10. Ensure all bolt head lay flush against the back plate of sled assembly
11. Replace wedge lid

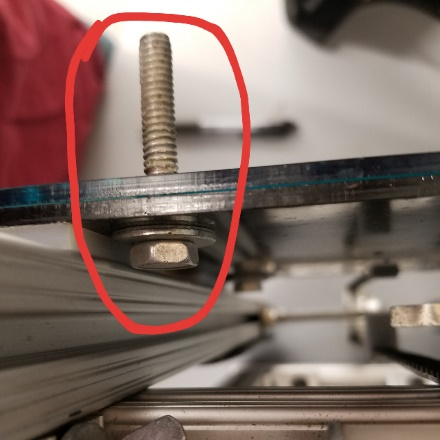
[picture p250: figure]
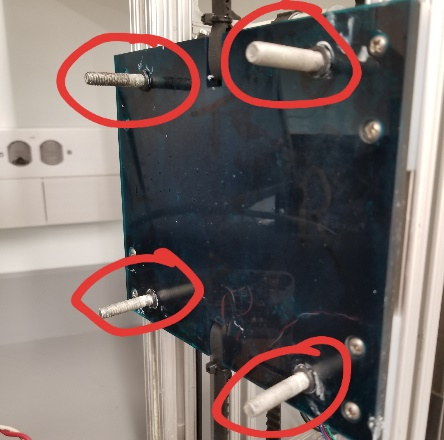
[picture p251: figure]
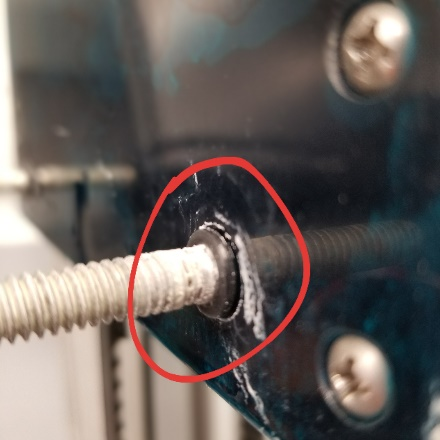
[picture p252: figure]

Fig 7.a | Fig 7.b | Fig 7.c

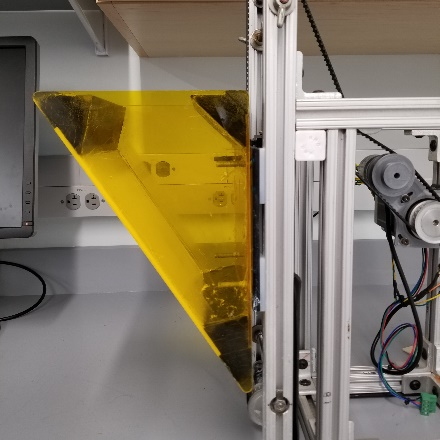
[picture p253: figure]
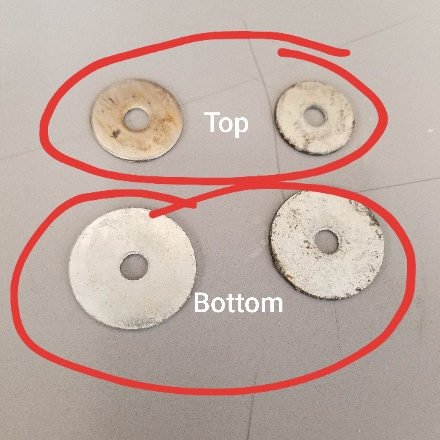
[picture p254: figure]
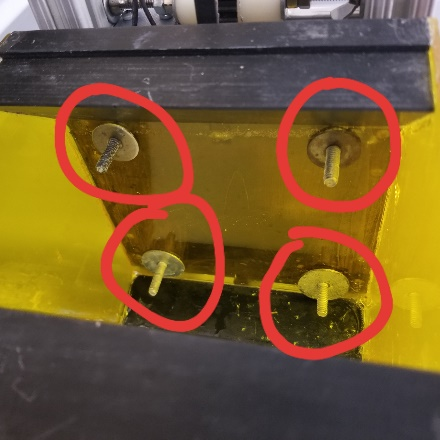
[picture p255: figure]

Fig 7.d | Fig 7.e | Fig 7.f

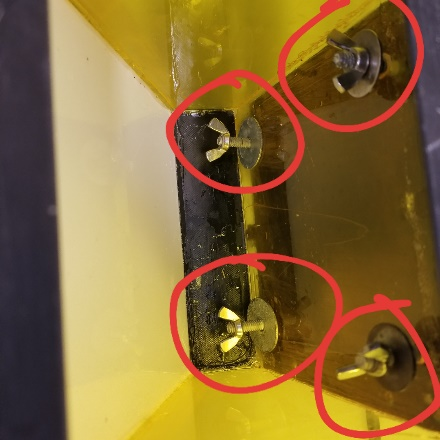
[picture p256: figure]

Fig 7.g

Electronics Shelf:

  1. Loosen all six bolts as far as possible {Fig 8.a}
  2. Ensure rails are loose
  3. Slide 80/20 rails into top of frame sliding shelf assembly as far back as possible

Note: The motor/encoder/limit wires like to get pinched between frame and shelf assembly so take care SHOULD ONLY REQUIRE LIGHT PRESSURE TO SLIDE {Fig 8.b&c}

  4. Firmly tighten down all six bolts

Note: To remove shelf do process in reverse.

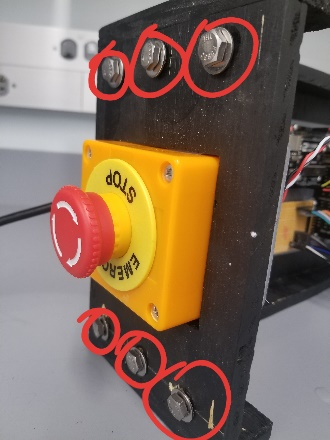
[picture p257: figure]
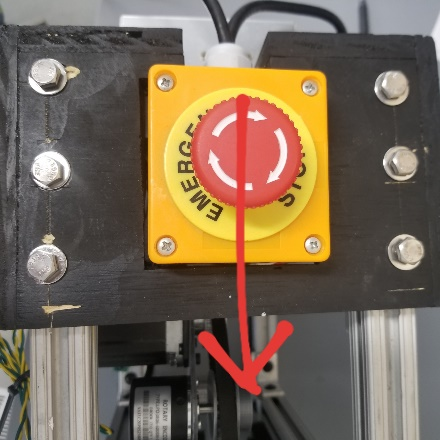
[picture p258: figure]
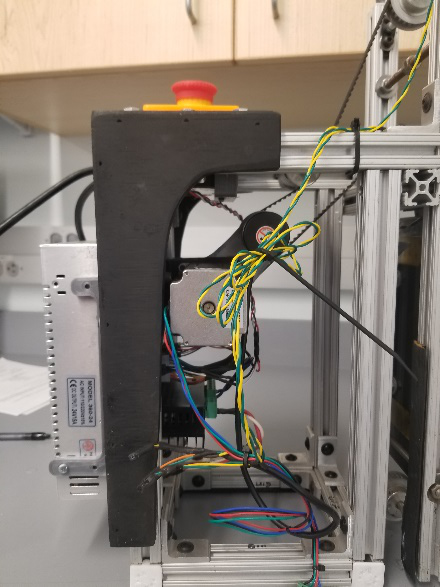
[picture p259: figure]

Fig 8.a | Fig 8.b | Fig 8.c

Electronics:

1. Plug in components {Fig 9.a&b}
    i. Motor
    ii. Upper limit
    iii. Bottom Limit
    iv. Rotary Encoder
    v. Toggle Switch
1. Check all Electrical connections {Fig 9.c,d,&e}

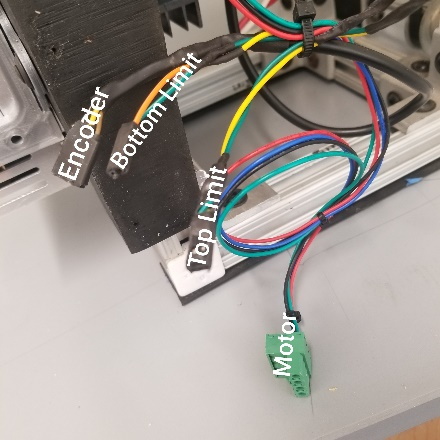
[picture p260: figure]
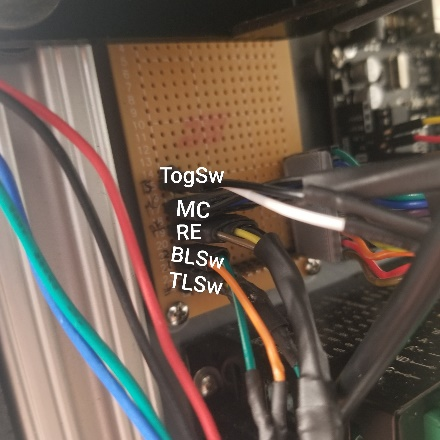
[picture p261: figure]
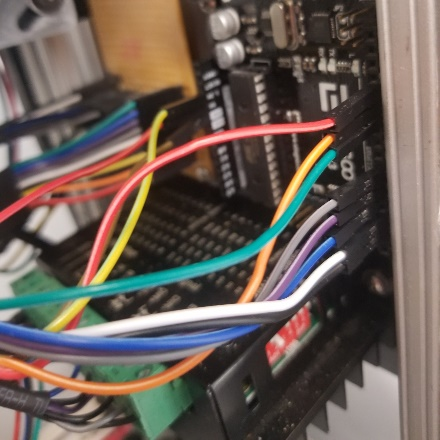
[picture p262: figure]

Fig 9.a | Fig 9.b | Fig 9.c

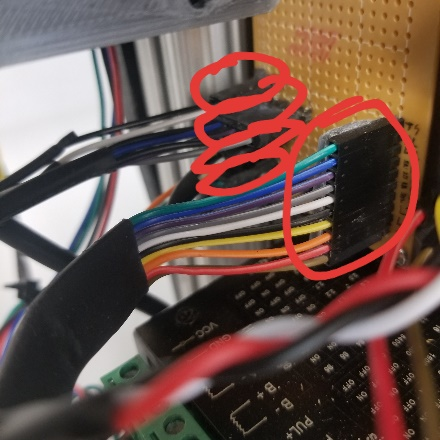
[picture p263: figure]

Fig 9.d

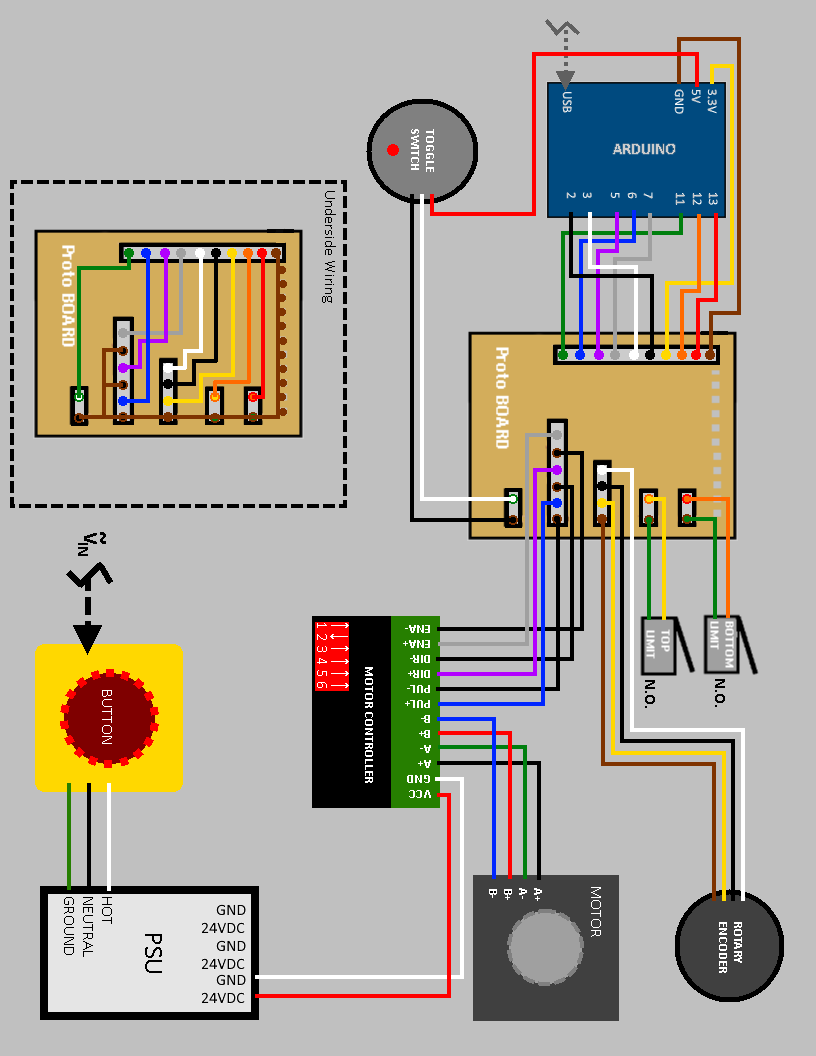
[picture p264: figure]

Fig 9.e
Limit Calibration:

  1. Ensure wavemaker is unpowered
  2. Hold wedge in middle of rails
  3. Move wedge slowly up towards upper limit switch, stopping when the switch clicks
  4. Mark on the rail the height of the top of the sled
  5. Slowly move the wedge downwards until the limit switch clicks
  6. Mark on the tail the height of the top of the sled
  7. Use calipers to measure the distance between the marks
  8. Input the measured distance to 5 significant figures

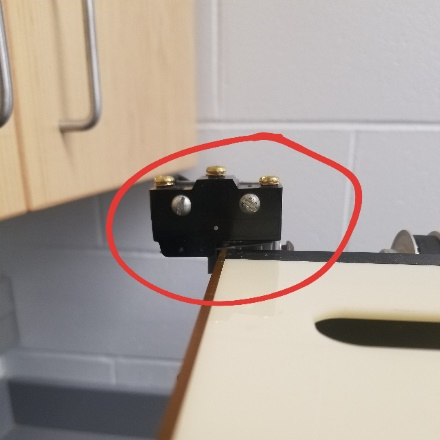
[picture p265: figure]
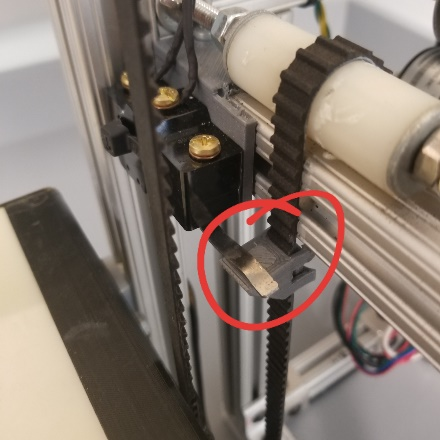
[picture p266: figure]

Fig 10.a | STEP 4 Fig 10.b | Fig 10.c

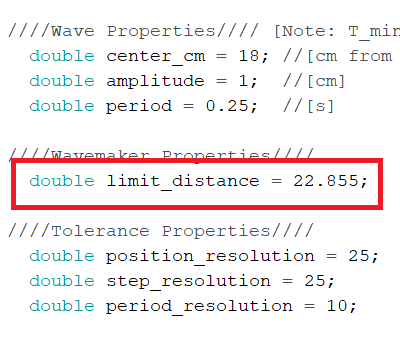
[picture p267: figure]

STEP 6 Fig 10.d | STEP 7 Fig 10.e | Fig 10.f

Software Setup:

How to get a new computer ready to run the wavemaker

Arduino:

  9. Install Arduino IDE on local system

https://www.arduino.cc/en/software

  10. Run Arduino IDE

Libraries:

1. Open Arduino IDE
2. Click Tools->Manage Libraries
3. Install libraries
  a. “AccelStepper”
  b. “Encoder”

Note: These libraries can also be found on project repository

Firmware Integration:

  1. Ensure toggle switch is off {Fig 11.a}
  2. Plug Arduino into computer {Fig 11.b&c}
  3. Click Tools and check that the board is recognized {Fig 11.d}

Fig 11.a | Fig 11.b | Fig 11.c
Fig 11.d

Maintenance

How to keep the wavemaker in tip-top shape.

Per-Operation Maintenance:

Perform prior to plugging in wavemaker

1. Belt Tension
a. Check belt is sufficiently taught (should deflect a maximum of ½” when pressed)
b. Ensure black idler is tight {Fig 12.a}
c. Ensure White idler is tight {Fig 12.b}

Fig 12.a | Fig 12.b

2. Rotary Encoder Engagement {Fig 13.a}
  a. Check that rotary encoder pulley is contacting the belt
  b. Manually move wedge up and down to check that the pulley tracks without skipping

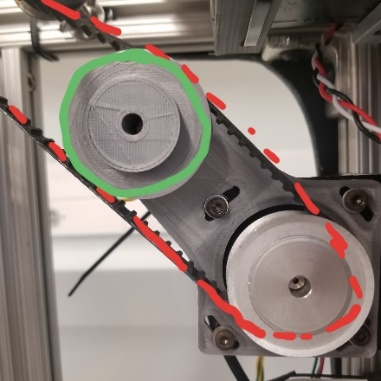
[picture p268: figure]

Fig 13.a

3. Wiring Connections {Fig 14.a,b,c,&d}
  a. Ensure no jumper wires have detached from Arduino
  b. Check that all ribbon cables are firmly attached to breakout board
  c. Check limit switch wiring

Fig 14.a | Fig 14.b | Fig 14.c

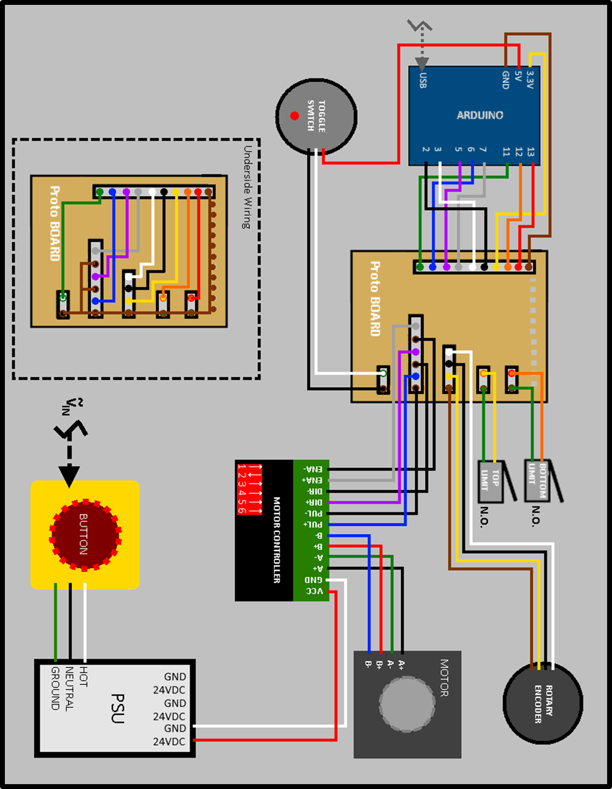
[picture p269: figure]

Fig 14.d

4. Switch Triggering
  a. Manually move wedge to top limit {Fig 15.a}
  b. Listen for top switch to click crisply
  c. Manually move wedge to bottom limit {Fig 15.b}
  d. Listen for bottom switch to click crisply

Fig 15.a | Fig 15.b

5. Panic Button
  a. Plug in wavemaker
  b. Twist panic button {Fig 16.a}
  c. Check that the wedge cannot be easily moved manually
  d. Press panic button firmly {Fig 16.a}
  e. After brief delay ensure wedge can now move freely
  f. If wedge remains firmly in place after panic switch is pressed do not operate wavemaker

Fig 16.a

Weekly Maintenance

Remove wavemaker from tank prior to maintenance

1. Recoating Wedge [TREAT WEDGE]:
  a. Spray light coat of white lithium grease onto a paper towel {Fig 17.a}
  b. Wipe paper towel over wedge surface
  c. Buff wedge surface with paper towel until grease splotches are no longer visible

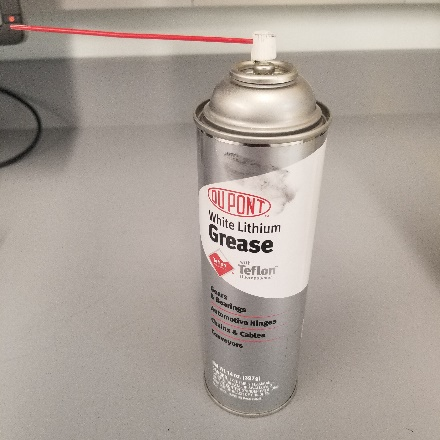
[picture p270: figure]

Fig 17.a

2. Cleaning Water [CLEAN WATER]:

Note: Only compete as needed

  a. Drain old water from tank
  b. Refill with new water
  c. Add treatment media
3. Lubricating Rails and Axels [LUBRICATE RAILS & AXLES]
  a. Ensure wavemaker is powered off
  b. Move wedge to bottom limit
  c. Spray light coat of white lithium grease into rails above wedge
  d. Move wedge to top limit
  e. Spray light coat of white lithium grease into rails below wedge
  f. Use excess to gently lubricate top and bottom axle bearing points

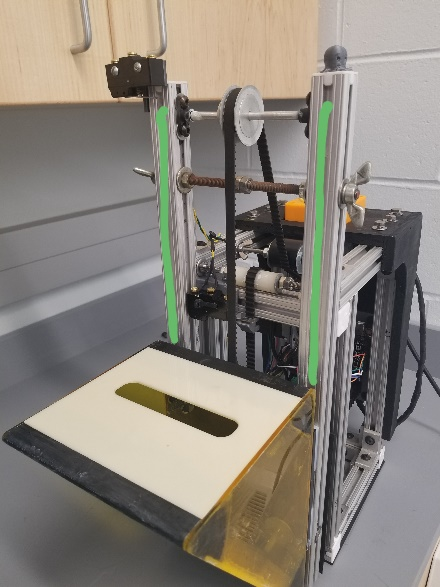
[picture p271: figure]
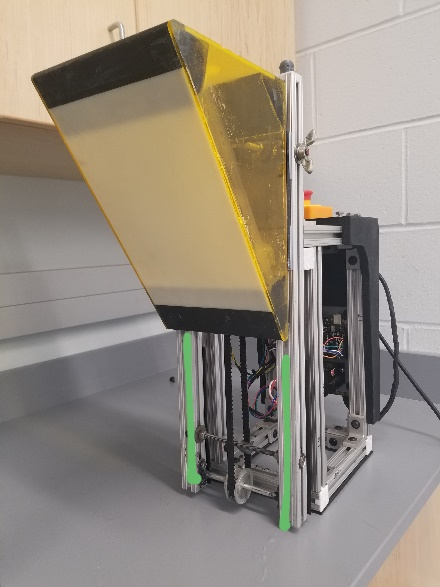
[picture p272: figure]
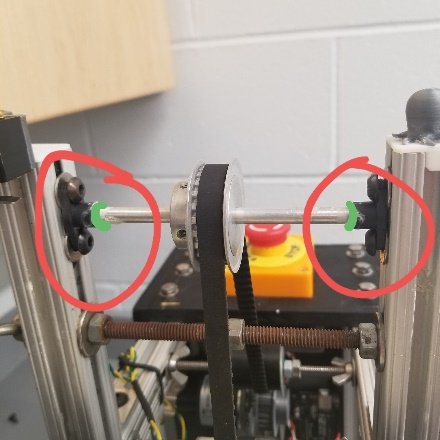
[picture p273: figure]

Fig 18.a | Fig 18.b | Fig 18.c

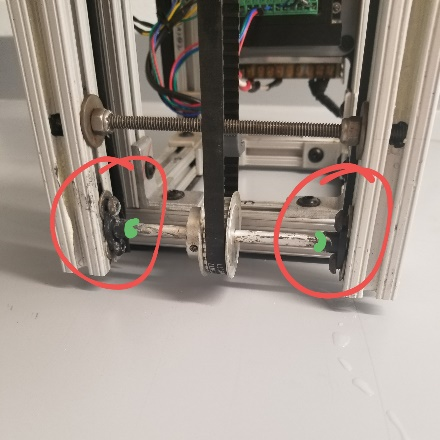
[picture p274: figure]

Fig 18.d

4. Checking Wedge Seal [CHECK WEDGE SEAL]
  a. Check that wingnuts inside wedge are finger-tight
  b. Ensure O-rings are properly squished
  c. Check for any cracks in wedge acrylic
    i. If cracked, flood crack with solvent weld and allow to dry for 12 hours. If crack still leaks, coat crack with gel based super glue and allow to cure.

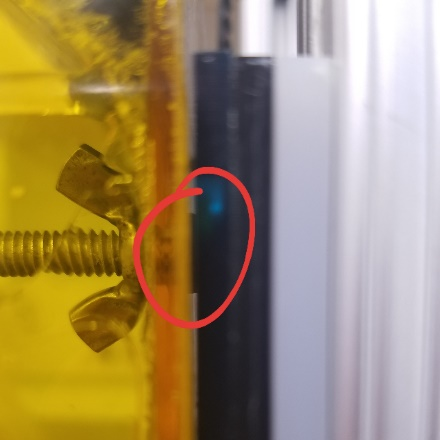
[picture p275: figure]

Fig 19.a | Fig19.b

Monthly Maintenance:

Remove wavemaker from tank prior to maintenance

1. Check Fasteners are Tight [CHECK ALL FASTENERS]
  a. Use 5/32 Allen to ensure all frame brackets are tight
  b. Use 5/32 Allen to ensure axle bearings are right
  c. Use fingers to gently ensure wedge fasteners are all tight
  d. Use 7/16 socket to ensure electronics sled is tight
  e. Use 3mm Allen to ensure motor bracket is tight
  f. Use Philips screwdriver to ensure limit brackets are tight
2. Check Rail Parallel [CHECK RAIL PARALLEL]
  a. Use calipers to measure top rail spacing {Fig20.a}
  b. Use calipers to measure bottom rail spacing {Fig 20.a}
  c. If necessary, loosen frame brace wingnuts and adjust top/bottom spacing

{Fig 20.b&c}

  d. Repeat until rails are parallel

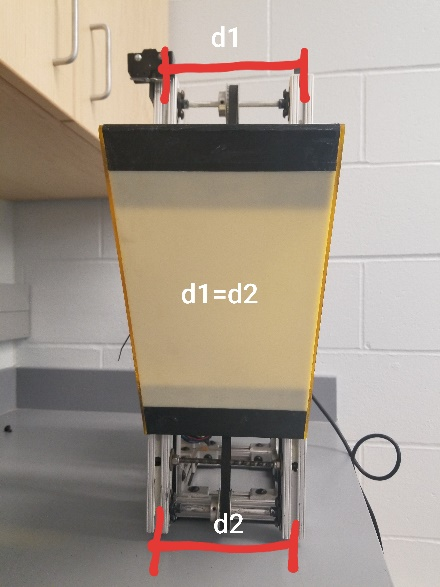
[picture p276: figure]
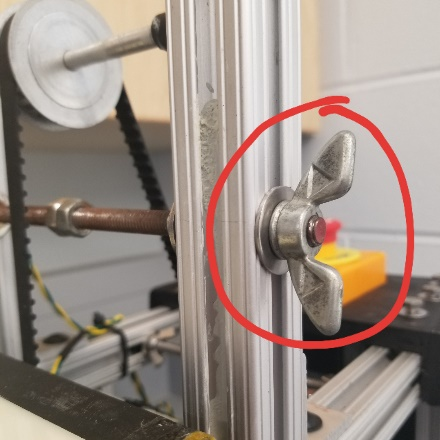
[picture p277: figure]
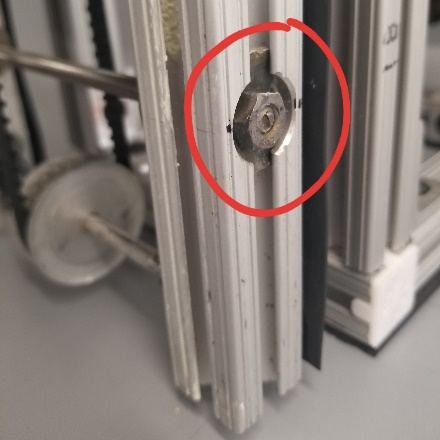
[picture p278: figure]

Fig 20.a | Fig 20.b | Fig 20.c

`

3. Cleaning Belt and Idlers [CLEAN BELT & IDLERS]
  a. Loosen black idler
  b. Disengage belt from pulleys
  c. Use damp towelette to wipe down pulley
  d. Wipe down pulleys and idlers {Fig 20.a}
  e. Reengage belt
  f. Tension Belt

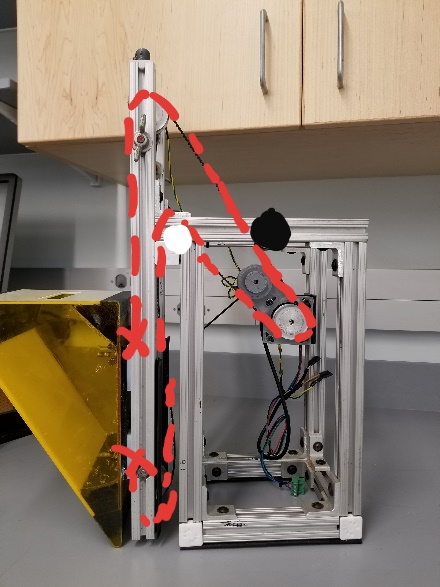
[picture p279: figure]

Fig 21.a

4. Check for Wear [CHECK PARTS FOR WEAR] {Fig 22.a,b,c,&d}
  a. Check linear slides, lower limit trigger, idlers, and encoder pulley

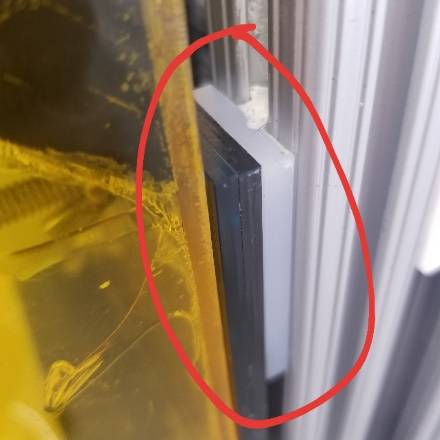
[picture p280: figure]
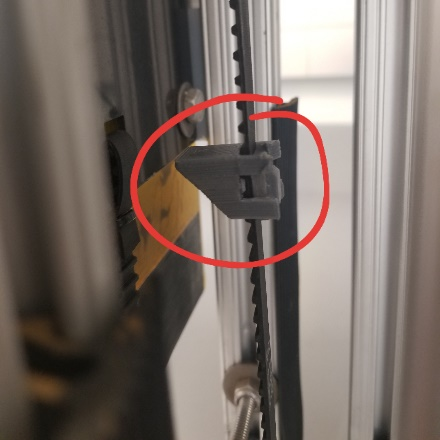
[picture p281: figure]
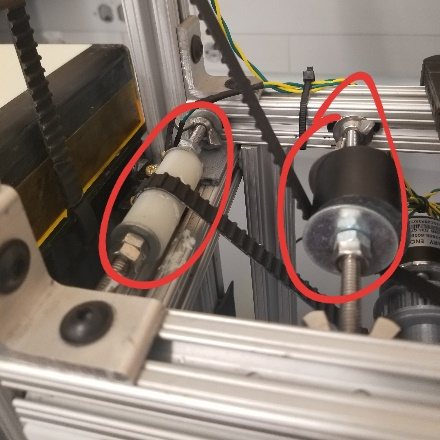
[picture p282: figure]

Fig 22.a | Fig 22.b | Fig 22.c

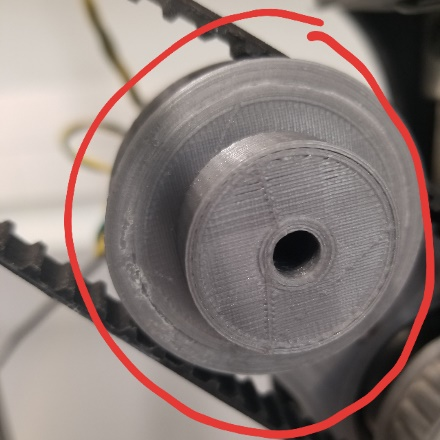
[picture p283: figure]

Fig 22.d

Pre-Lab Shutdown Maintenance:

1. Remove Tension from Belt [SLACKEN BELT]
  a. Loosen black idler {Fig 23.a}
  b. Ensure belt is loose

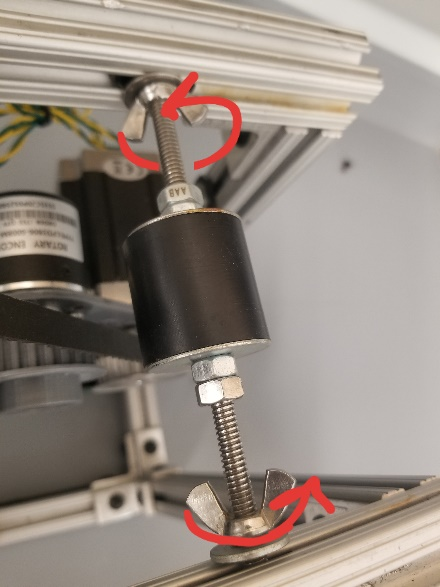
[picture p284: figure]

Fig 22.a

2. Dry and Store Wavemaker [DRY & STORE]
  a. Use paper towels to wide standing water from wavemaker surface
  b. If available use pressurized air to dry thoroughly
  c. Depress panic button
  d. If necessary, remove wedge
    i. Loosen wingnuts inside wedge completely
    ii. Pull wedge from sled
    iii. Place all loose hardware inside a zip-lock inside the wedge
    iv. Ensure no O-rings have been misplaced
  e. Coil cord loosely around frame
  f. Store in upright position do not store resting on wedge or power supply unit

Future Features:

A place to track future feature ideas and needs

Time Series Rotary Encoder Data

The ability to output the rotary encoder time series date to an array would be beneficial for experiment precision. This could be achieved through an interrupt handler(?). Or more directly by creating a master slave setup between the Arduino UNO and a Raspberry PI.

Improved Microcontroller

A faster microcontroller would allow for a broader spectrum of movement speeds. Currently the minimum period is directly proportional to the amplitude of movement. With a faster microcontroller the max step speed wouldn’t be hindered on a firmware side. An Arduino DUE would be optimal, however, with enough pain and suffering, the same thing could be done with a Raspberry Pi.

Freeform Movement Input

Consider only after upgrading the microcontroller. It may be possible to take a signal generator input in as an analog input and interpret that waveform as a position vs time function. Using that interpreted signal software could mimic the movement. This upgrade to the hardware and code would essentially allow for much more complicated waveforms than just sinusoids.

Upper Limit Overhaul

Would be a good idea to slightly modify the upper limit so it triggers off the sled, not the wedge. This would allow different wedges to be hot swapped without need to redo the limit calibration every time.
