MatthiasOPage/Wavemaker/Documents/WaveMakerWiringDiagramV2.png

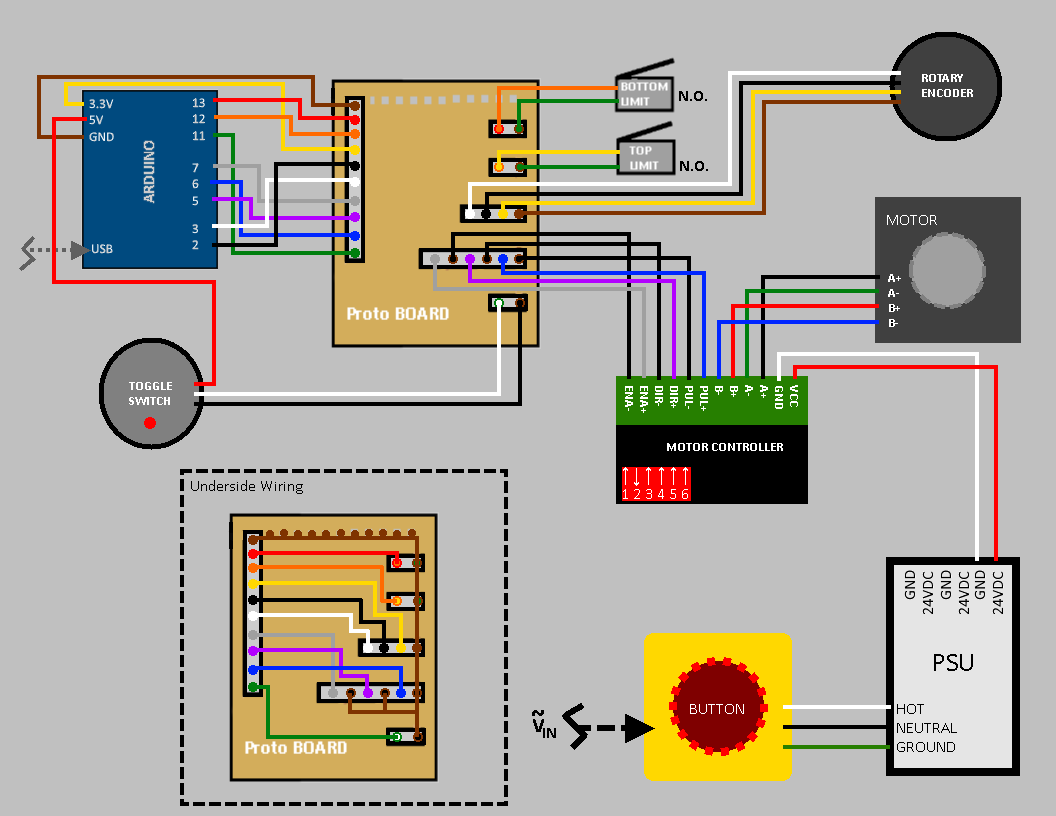
Documents/WaveMakerWiringDiagramV2.png
