MatthiasOPage/Wavemaker/Media/Manual Media/20201031_104513.jpg

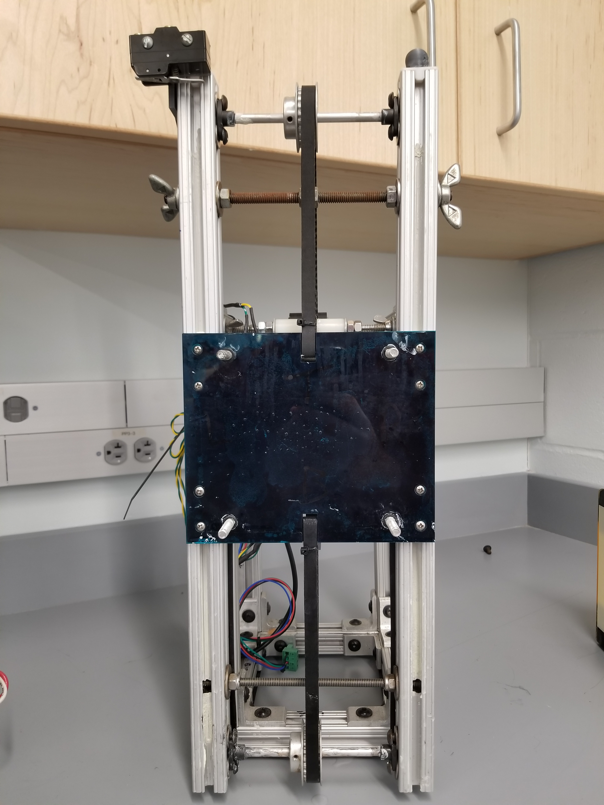
Media/Manual Media/20201031_104513.jpg
