MatthiasOPage/Wavemaker/Media/Manual Media/20201031_105435.jpg

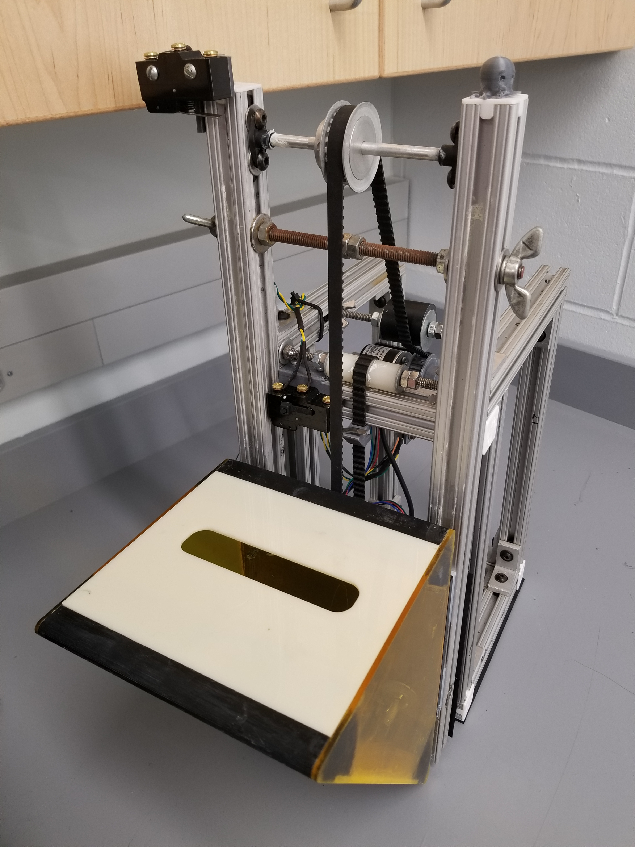
Media/Manual Media/20201031_105435.jpg
