MatthiasOPage/Wavemaker/Media/Manual Media/20201031_114300.jpg

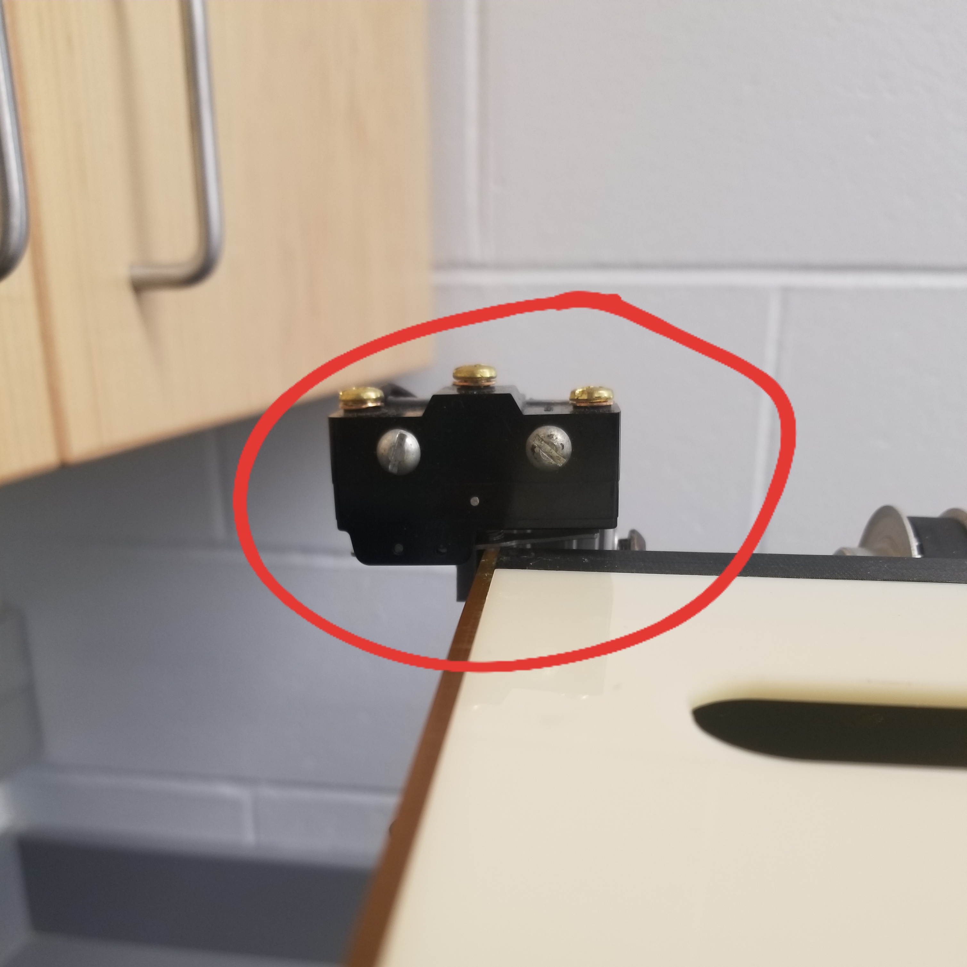
Media/Manual Media/20201031_114300.jpg
