MatthiasOPage/Wavemaker/Documents/Manual Raws/MaintenanceChecklistV2.docx

Weekly

Date: | Treat Wedge | Clean Water | Lubricate Rails & Axles | Check Wedge Seal

Monthly

Month: | Check All Fastenerns | Check Rail Parallel | Clean Belt & Idlers | Check parts for Wear

Pre-Lab Shutdown

Start date: | End date: | Slacken Belt | Dry & Store

Maintenance Notes

Date Reported: | Date Resolved: | Notes:

Wavemaker Manual:

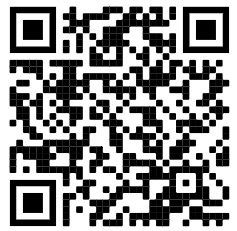
[picture p343: figure]

In case of critical failure contact: Matthiasopage@gmail.com

Wavemaker Maintenance Schedule Checklist Start Date: [ / / /]
