MatthiasOPage/Wavemaker/Documents/MaintenanceChecklistV2.pdf

## Wavemaker Maintenance Schedule Checklist Start Date: [ / / /]

## Weekly

DATE: | TREAT WEDGE | CLEAN WATER | LUBRICATE RAILS & AXLES

CHECK WEDGE
SEAL

## Monthly

MONTH: | CHECK ALL FASTENERNS

CHECK RAIL
PARALLEL

CLEAN BELT
& IDLERS

CHECK PARTS FOR
WEAR

## Pre-Lab Shutdown

START DATE: | END DATE: | SLACKEN BELT | DRY & STORE

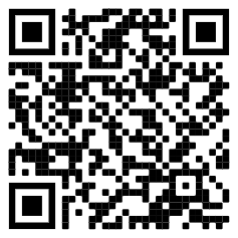
[picture p344: figure]

## In case of critical failure contact: Matthiasopage@gmail.com

## Maintenance Notes

DATE
REPORTED:

DATE
RESOLVED: | NOTES:

## Wavemaker Manual:
