MatthiasOPage/Wavemaker/(commit log)

2020-11-19 Integrated 3D model Files
    [.75in_Washer.SLDPRT, 1.25in_Washer.SLDPRT, 1010_1_CL.sldprt, 12in.SLDPRT, 12in_Drilled.SLDPRT, 1_4-20T_Nut.sldprt, 1_4-20T_Nut_Truncated.SLDPRT, 1_4-20x.5_Flange.sldprt]
2020-11-25 3D Models!
    [14173.sldprt, 40-4001-BLACK-FB.sldprt, 40-4001.sldprt, 40-4002-BLACK-FB.sldprt, 40-4002.sldprt, 40-4003-BLACK-FB.sldprt, 40-4003.sldprt, 40-4004-BLACK-FB.sldprt]
2021-02-03 updated 3D models
    [0.24-20_Washer.SLDPRT, 10mmOD_Lock_Knob.SLDPRT, 10mm_M5x0-8_Bolt.SLDPRT, 12mm_M6_Bolt.SLDPRT, 16mm_M5x0-8.SLDPRT, 16mm_M5x0-8_Bolt.SLDPRT, 18mm_M5x0-8_Setscrew.SLDPRT, 20mm_M5x0-8.SLDPRT]
