MatthiasOPage/Wavemaker/Media/Development/20200703_150240.jpg

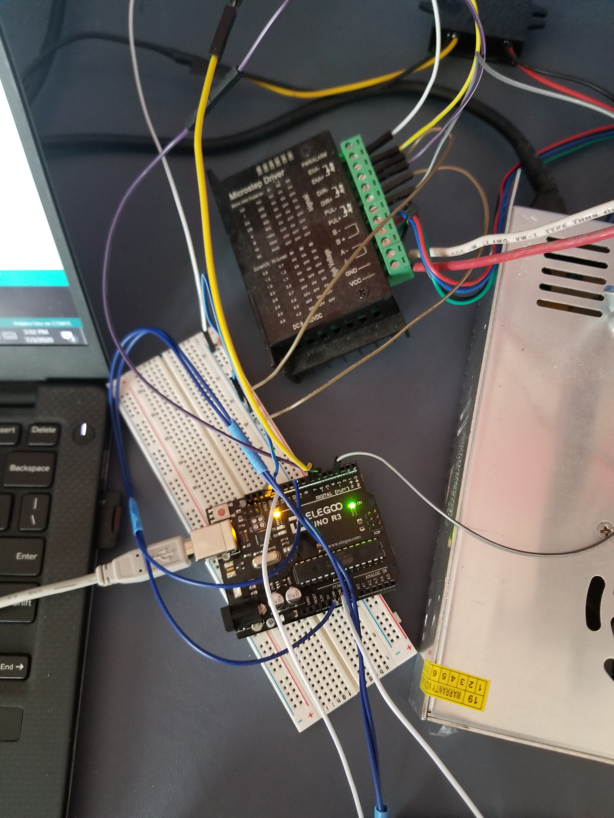
Media/Development/20200703_150240.jpg
