MatthiasOPage/Wavemaker/Media/Development/20200703_150243.jpg

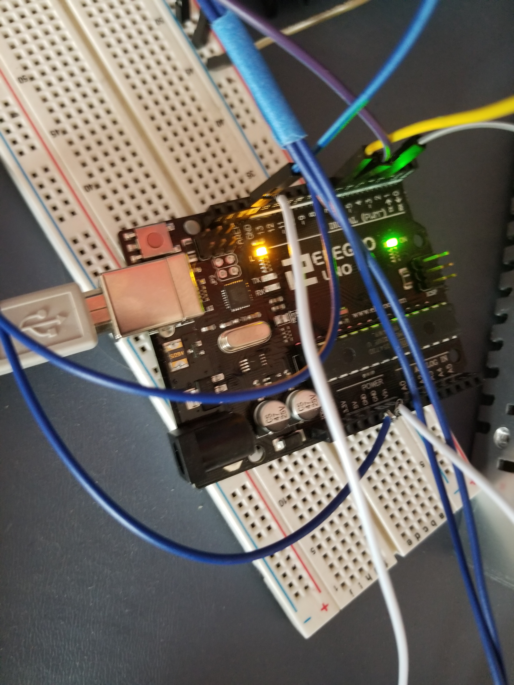
Media/Development/20200703_150243.jpg
