MatthiasOPage/Wavemaker/Media/Development/20200723_104122.jpg

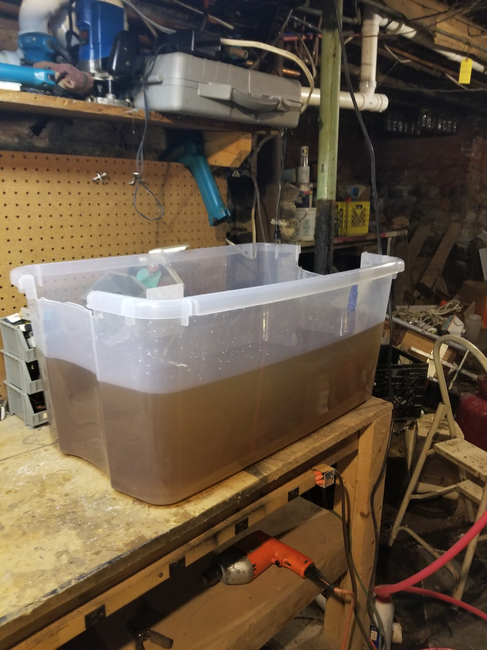
Media/Development/20200723_104122.jpg
