MatthiasOPage/Wavemaker/Media/Development/20200807_123048.jpg

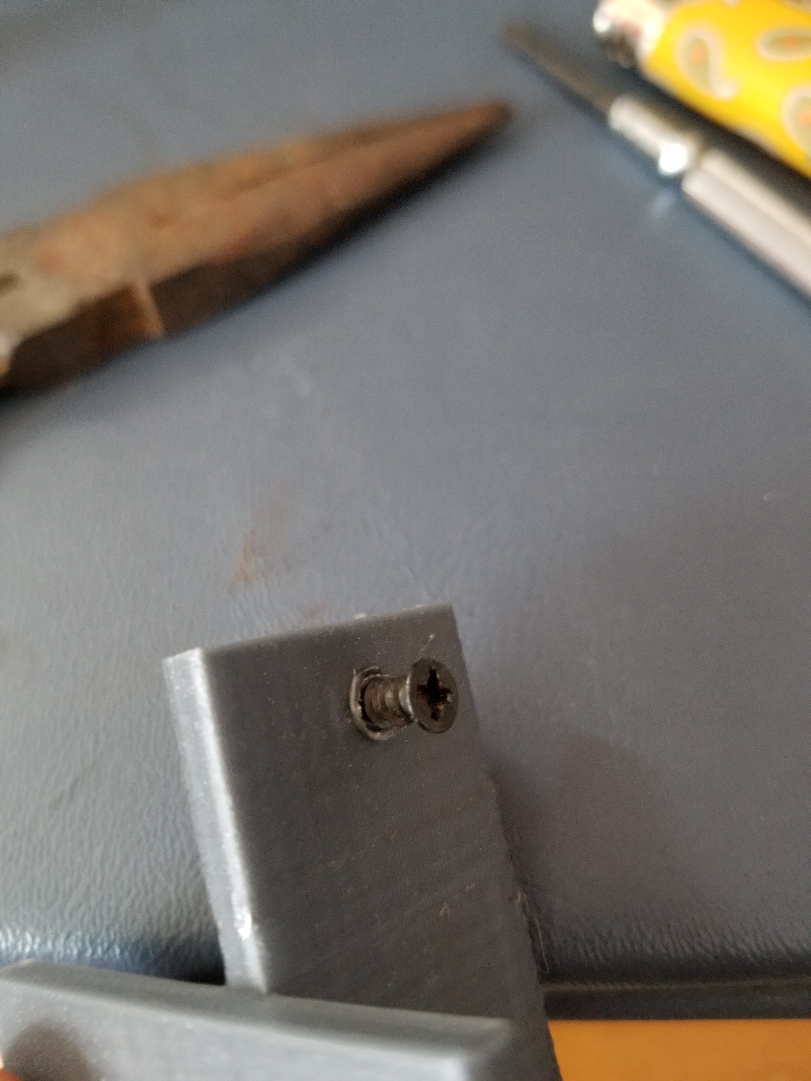
Media/Development/20200807_123048.jpg
