MatthiasOPage/Wavemaker/Media/Development/20200807_123055.jpg

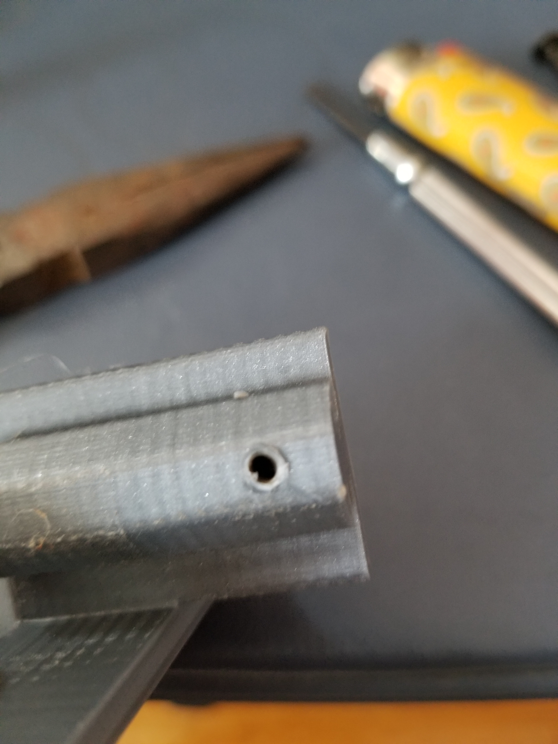
Media/Development/20200807_123055.jpg
