MatthiasOPage/Wavemaker/Media/Development/20200817_112829.jpg

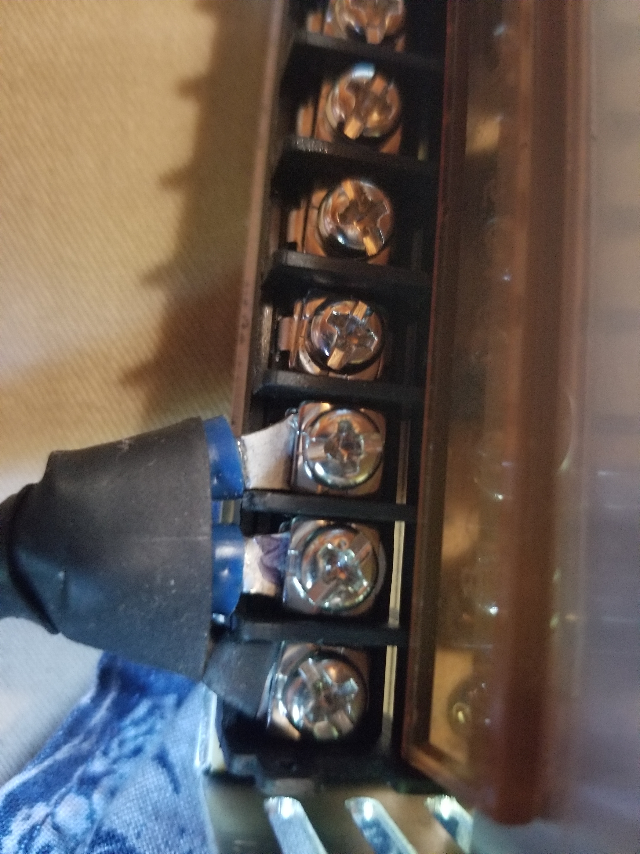
Media/Development/20200817_112829.jpg
