MatthiasOPage/Wavemaker/Media/Development/20200817_114300.jpg

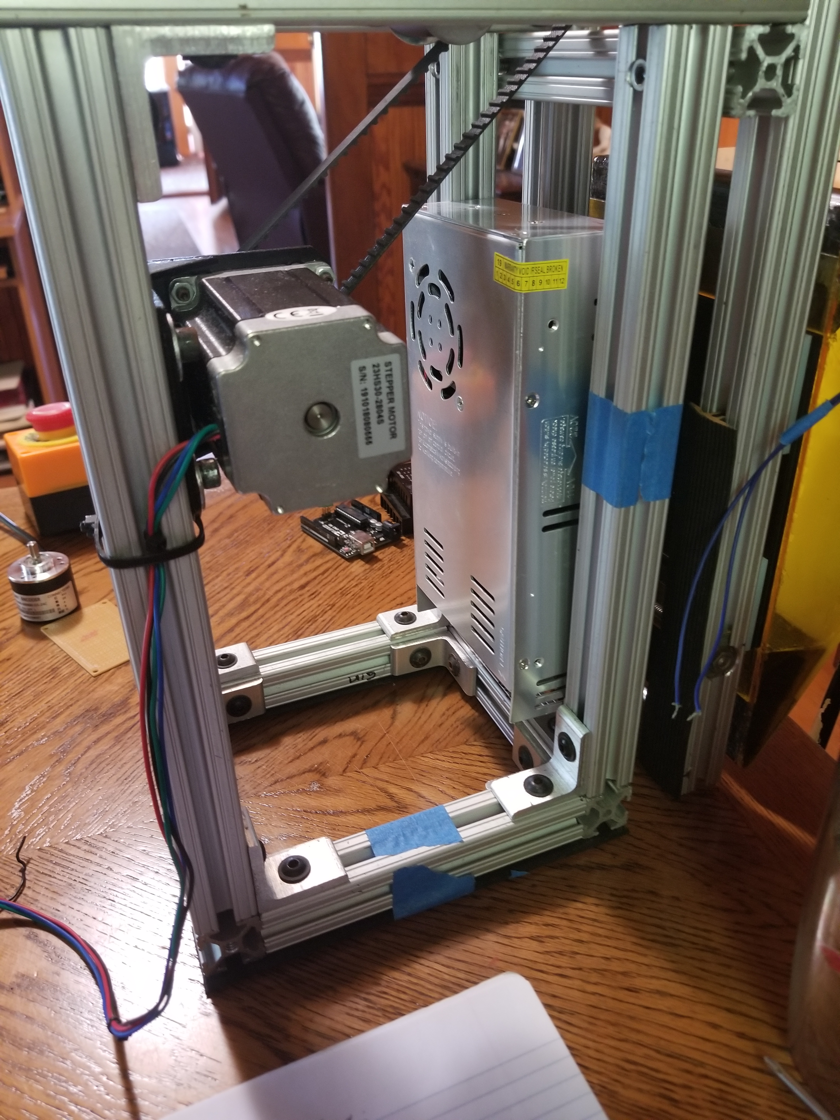
Media/Development/20200817_114300.jpg
