MatthiasOPage/Wavemaker/Media/Development/20200817_120500.jpg

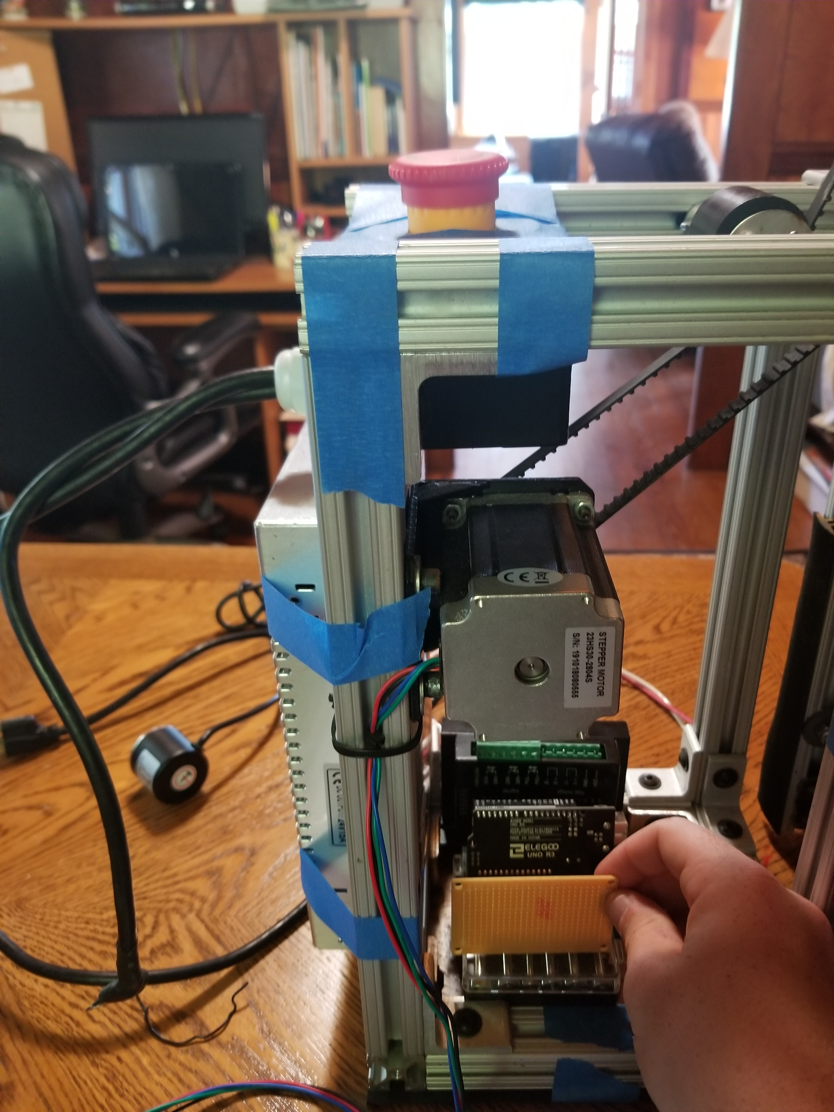
Media/Development/20200817_120500.jpg
