MatthiasOPage/Wavemaker/Media/Development/20200817_120503.jpg

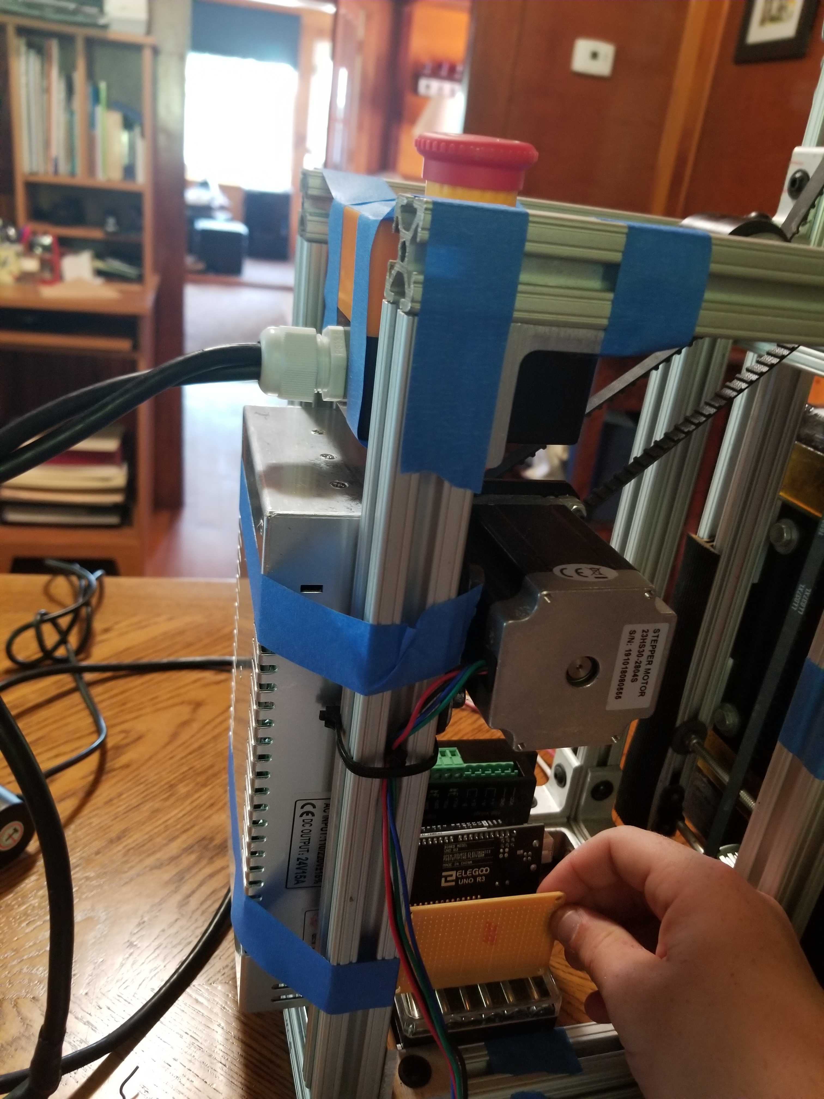
Media/Development/20200817_120503.jpg
