MatthiasOPage/Wavemaker/Media/Development/20200817_120505.jpg

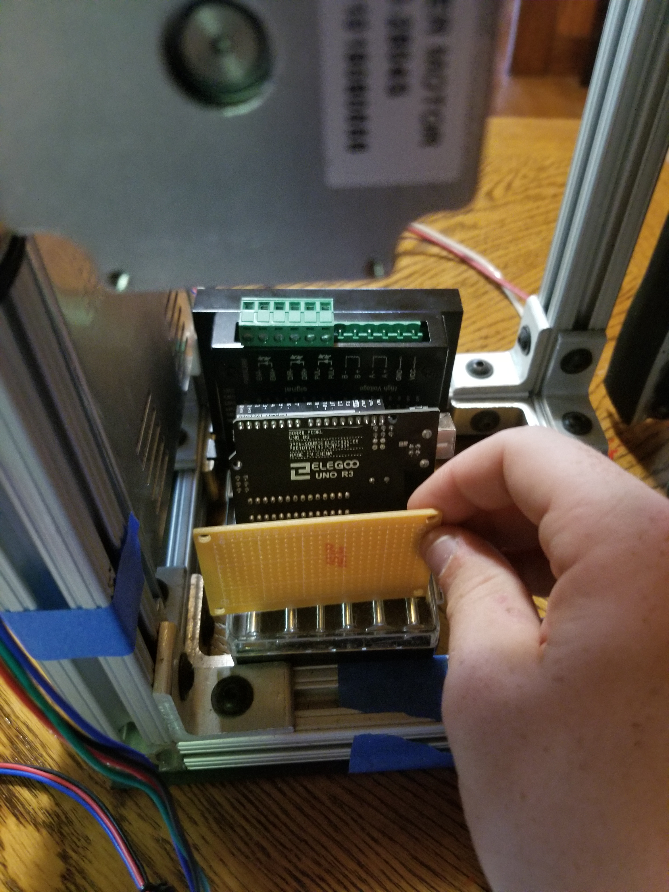
Media/Development/20200817_120505.jpg
