MatthiasOPage/Wavemaker/Media/Development/20200817_120513.jpg

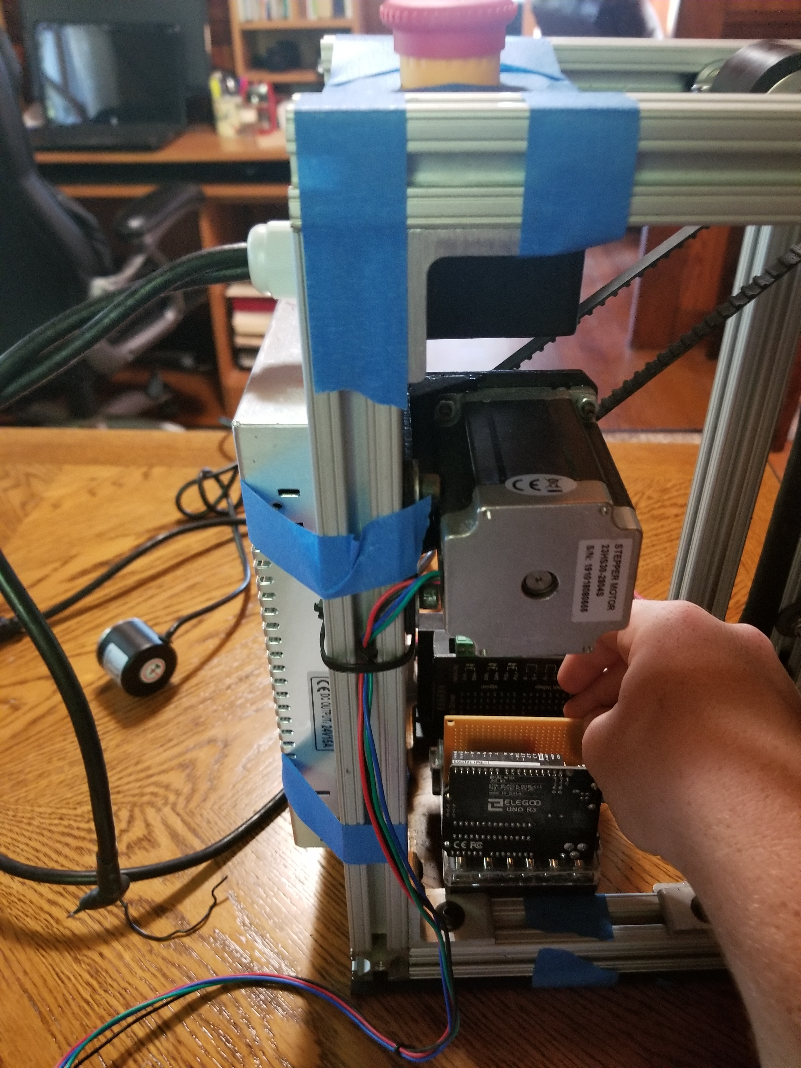
Media/Development/20200817_120513.jpg
