MatthiasOPage/Wavemaker/Media/Development/20200818_100411.jpg

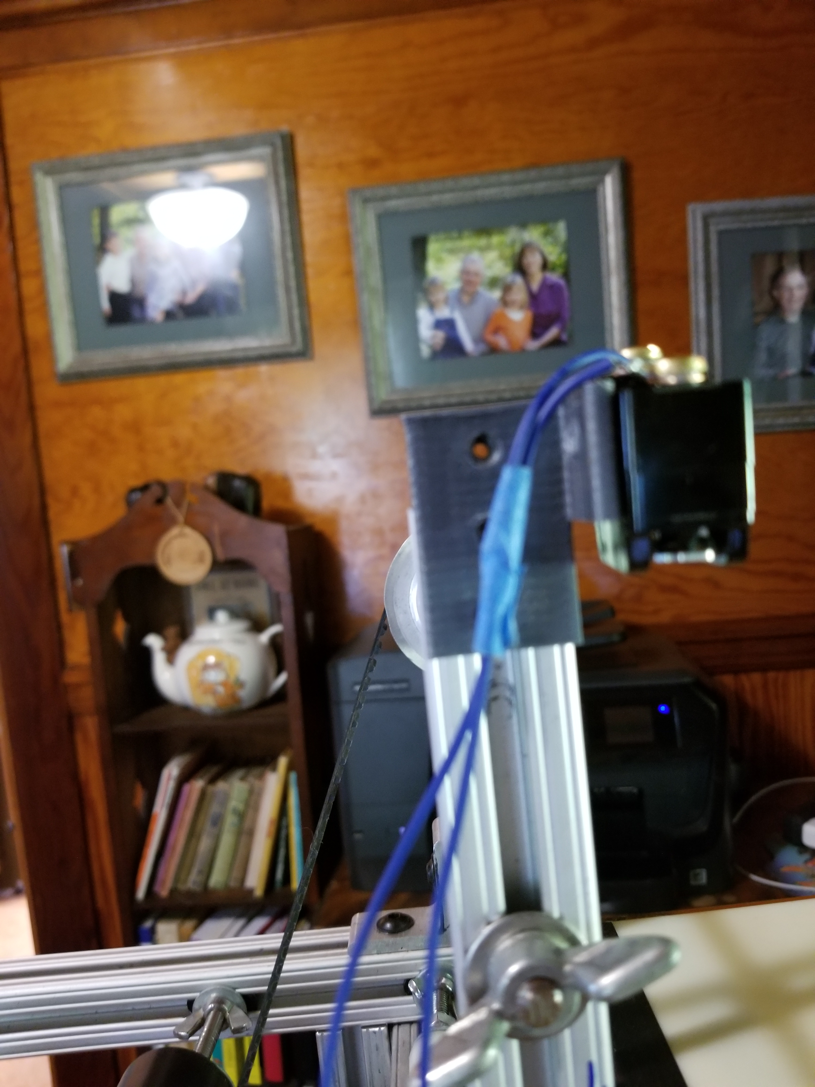
Media/Development/20200818_100411.jpg
