MatthiasOPage/Wavemaker/Media/Development/20200818_100414.jpg

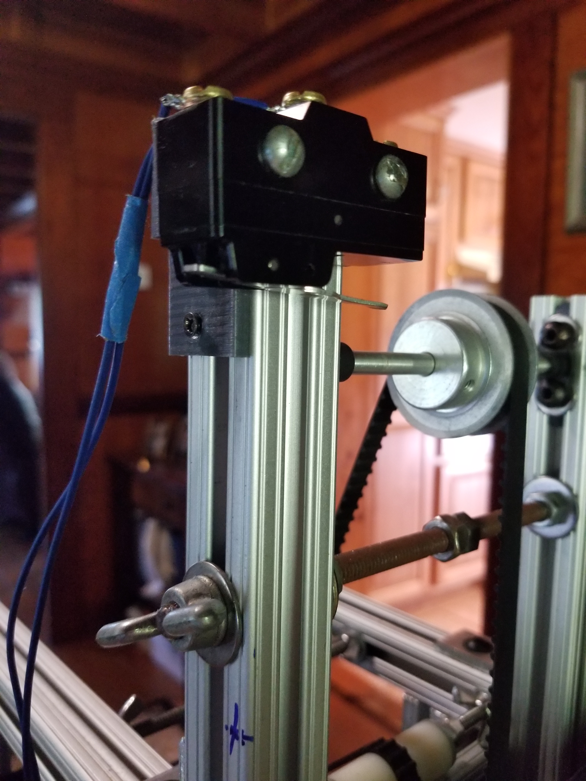
Media/Development/20200818_100414.jpg
