MatthiasOPage/Wavemaker/Media/Development/20200819_213643.jpg

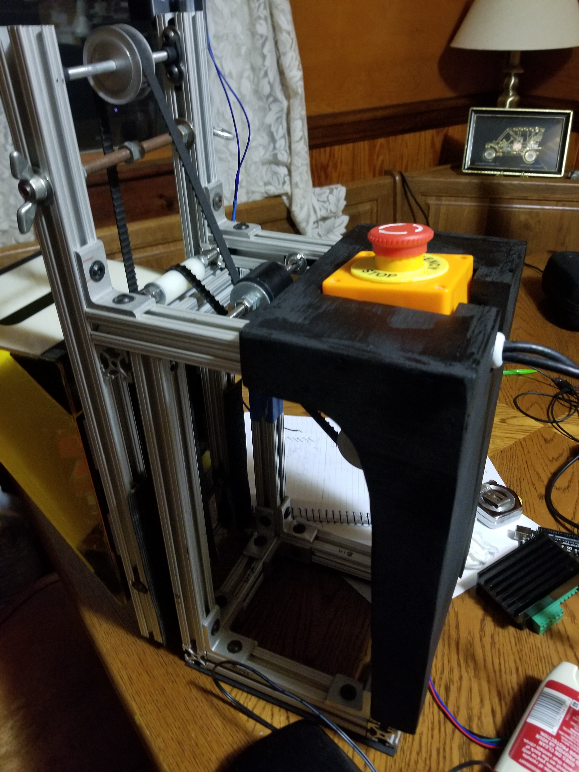
Media/Development/20200819_213643.jpg
