MatthiasOPage/Wavemaker/Media/Development/20200905_170356.jpg

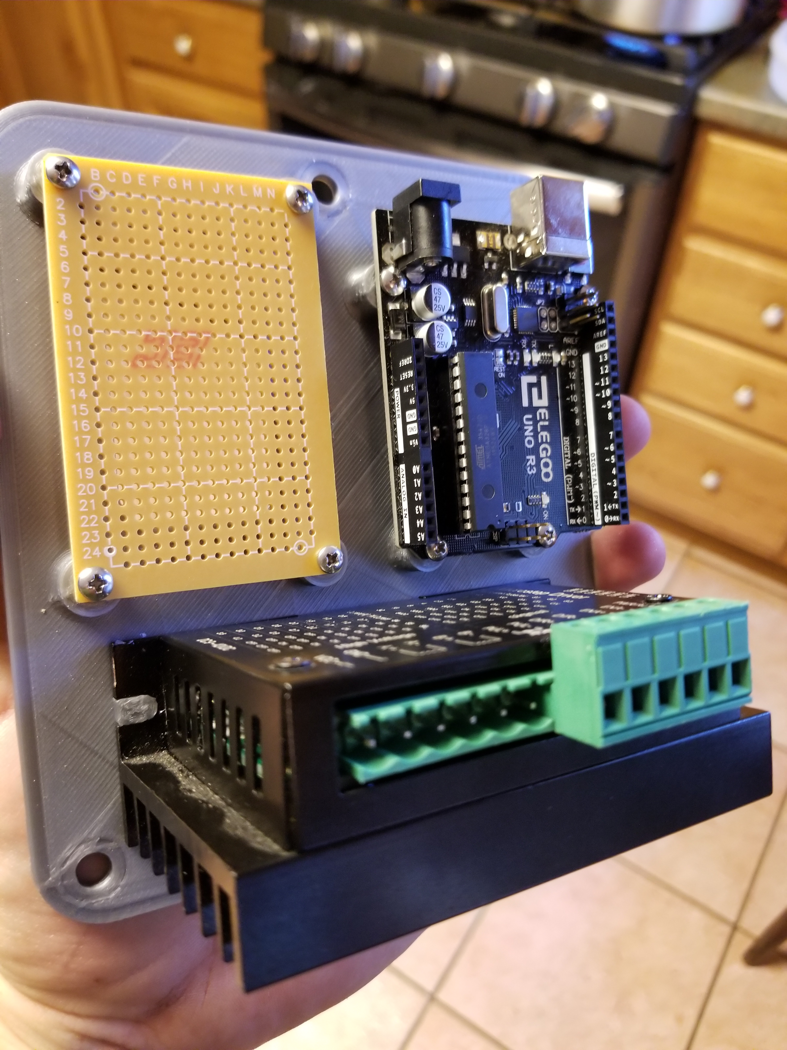
Media/Development/20200905_170356.jpg
