MatthiasOPage/Wavemaker/Media/Development/20200905_182630.jpg

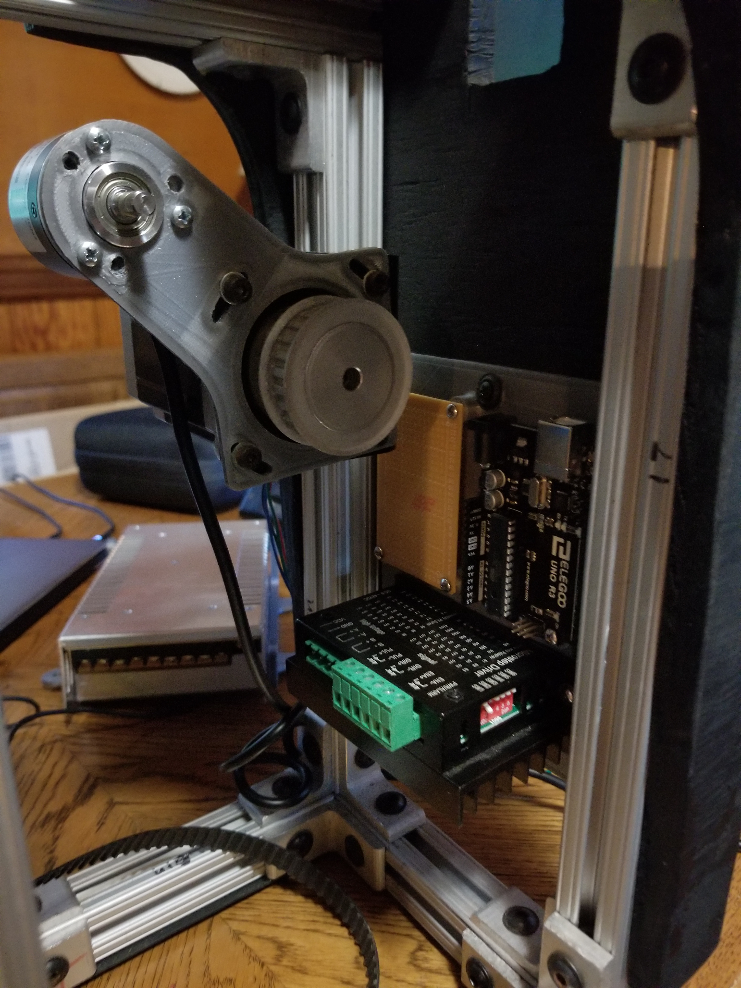
Media/Development/20200905_182630.jpg
