MatthiasOPage/Wavemaker/Media/Development/20200905_182634.jpg

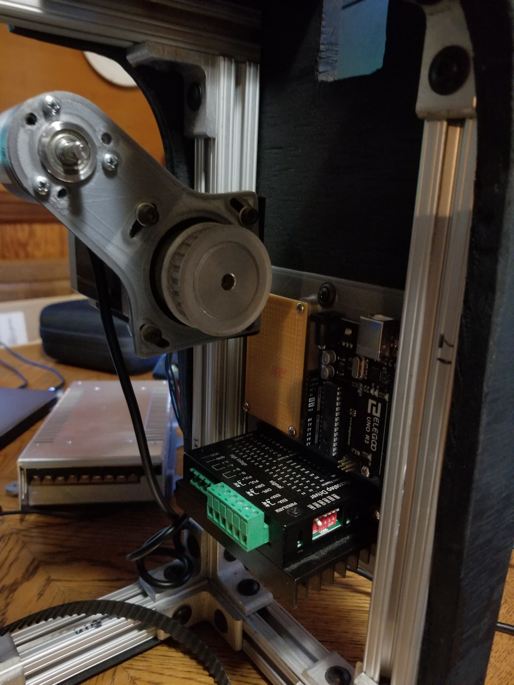
Media/Development/20200905_182634.jpg
