MatthiasOPage/Wavemaker/Media/Development/20200918_161511.jpg

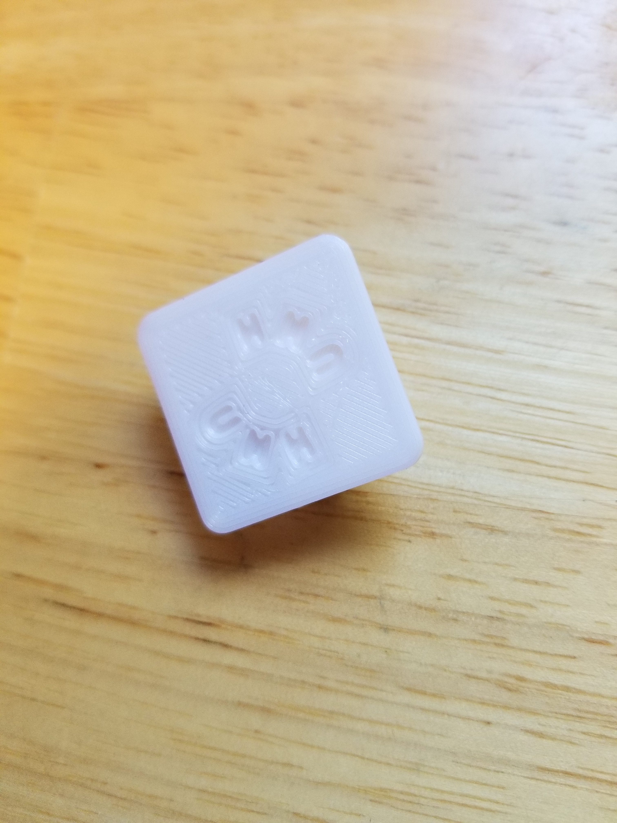
Media/Development/20200918_161511.jpg
