MatthiasOPage/Wavemaker/Media/Development/20201006_203104.jpg

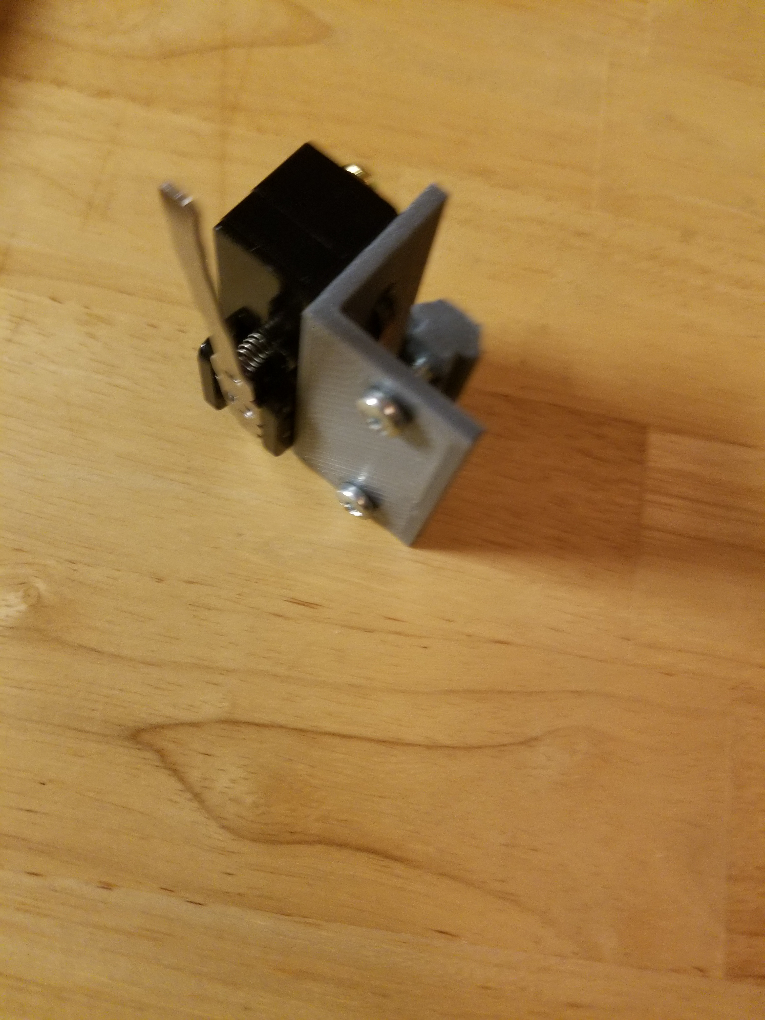
Media/Development/20201006_203104.jpg
